Takazudo/zudo-led-block/README.md

# Zudo LED Block

A narrow Eurorack art light that sits beside Kumiko blank panels: a clear cast-PMMA front with engraved, light-carrying letters and replaceable translucent PETG sides lit by eight individually addressable RGB LEDs. This repository holds the **Light Block A5** engineering checkpoint and its documentation site.

Documentation (Japanese): https://zudo-led-block.zudolab.dev/ — **not live yet**; production hosting is configured but disabled until activated (see [hosting](doc/src/content/docs/project/hosting.mdx)).

> [!IMPORTANT]
> **A5 is not released for manufacture.** The controller PCB is placed but **unrouted** (130 unconnected items, courtyard overlaps J3-H1 and J3-C7). Harness routing and installed fit are unresolved, and no physical electrical, optical, thermal, print or load qualification has happened. Passing CI is not an electronics or manufacturing approval.

**Status:** A5 design and BOM imported; all 30 fitted identities are migrated into the component-evidence catalog (`/docs/components/`), with explicit open gaps. The complete 30-type / 81-piece BOM is published on the site's [BOM page](doc/src/content/docs/architecture/bom.mdx) (generated from the A5 ledger and native netlists) and links each row to its catalog record. The reconciliation (30 identities / 71 placements / 81 pieces) is `provenance/a5-catalog/reconciliation.json`, built and checked by `scripts/a5_catalog.py`.

## Repository map

| Path | What it is |
| --- | --- |
| `engineering/a5/` | **Immutable** byte-for-byte import of the A5 checkpoint (786 files): native KiCad 10 projects, firmware + pinned STM32CubeG0 SDK and licenses, CadQuery generators, STEP/STL/3MF, front artwork, procurement ledger and evidence, historical verification records. Start with `engineering/a5/README_JA.md`, `continue-here.md`, `REPRODUCE.md`. |
| `provenance/` | Seed manifest (size + SHA-256 per file), original-archive recovery receipt, handoff evidence, and the five deliberately omitted paths ([provenance/README.md](provenance/README.md)). |
| `scripts/` | New tooling outside the checkpoint: seed verifier, A5 record checks, deterministic site-data generator, public-asset selection, browser checks, Cloudflare output check. |
| `doc/` | Documentation site (zudo-circuit-doc 0.3.0 on zudo-doc 9.1.3 / ZFB 5.2.2), Japanese-first. `doc/cloudflare.config.ts` + `doc/wrangler.config.ts` describe the (disabled) Workers Static Assets deployment. |
| `circuit/`, `circuit.config.ts`, `.claude/skills/` | zudo-circuit-doc project files; `circuit/WORKFLOW.md` is the canonical framework workflow. |
| `.github/workflows/` | Credential-free CI and the default-off production deploy gate. |

Agent instructions: [AGENTS.md](AGENTS.md) / [CLAUDE.md](CLAUDE.md).

## Setup and commands

Requirements: Node.js 24, pnpm 11.5.2 (`corepack enable`), Python ≥ 3.11 (standard library for the checks), GNU Make and a C11 compiler for firmware host tests, `arm-none-eabi-gcc` 13.2.1 for the ARM build.

```sh
pnpm install --frozen-lockfile

# A5 checkpoint integrity and data checks (no network, writes nothing in engineering/a5/)
pnpm a5:check                       # seed identity + record checks + generated-page drift
python3 engineering/a5/build_procurement_rows.py --check

# Firmware
make -C engineering/a5/firmware test test-sanitize timing
make -C engineering/a5/firmware arm  # needs arm-none-eabi-gcc on PATH

# Documentation
pnpm circuit:doctor
pnpm dev                            # local preview
pnpm build && pnpm check && pnpm check:site
pnpm test:browser                   # Playwright, desktop + mobile

# Cloudflare packaging (credential-free)
pnpm cf:build && pnpm cf:check-output && pnpm cf:dry-run
```

After an intentional change to the A5 inputs that feed the site (only by a new checkpoint import), run `pnpm a5:generate` and commit the regenerated pages.

## Reproduction paths beyond CI

| Area | Tooling | Notes |
| --- | --- | --- |
| Native electronics | KiCad 10.0.8 (`kicad-cli`, pcbnew Python) | CI runs the digest-pinned native gate, fresh schematic checks, the actual A7 controller candidate, negative controls and router reproduction. Imported A5 records remain historical. The framework's KiCad 9.0.9 preview renderer does not replace these native checks. |
| CAD | CadQuery 2.7.0, Python ≥ 3.11 (`engineering/a5/requirements.txt`) | `mechanical/build_mechanical.py --variant all` regenerates the four omitted tessellation JSONs before `render_previews.py`. |
| Workbook | `@oai/artifact-tool` + specialized runtime variables | Preserved as source; not a CI dependency. The PDF/XLSX in `engineering/a5/deliverables/` were **not** regenerated by this repository. |
| Full archive rebuild | `engineering/a5/build_package.py` | Requires restoring the five omitted files first. |

## License notes

Third-party material inside `engineering/a5/` keeps its own notices: STM32CubeG0 components (`engineering/a5/firmware/vendor/`, `firmware/dist/licenses/`), GCC runtime exception provenance, and upstream footprint licenses (`engineering/a5/electronics/footprints/upstream/LICENSE.md`).
