Takazudo/zudo-led-block/engineering/a7/README.md

# engineering/a7 — A7 structural redesign (study in progress)

A7 is the structural redesign tracked in [#15](https://github.com/Takazudo/zudo-led-block/issues/15):
right-angle threaded CV jacks with a controller PCB perpendicular to the front, a PCB-side ON / PGM / CV
setting switch instead of the front toggle, and a feasibility study of transparent PET FPC for the LED leaves.

**Status: design study. Not released for manufacture.** Nothing here is part approval, fit approval or an
electrical result. `engineering/a5/` stays the immutable A5 checkpoint; A7 never edits it.

Start with [`docs/continuation/continue-here.md`](docs/continuation/continue-here.md) for the current state,
next actions and blockers, and [`docs/continuation/evidence-index.md`](docs/continuation/evidence-index.md) for every evidence set.

## Ownership

| Path | Owner | Notes |
|---|---|---|
| `evidence/sources.json` | R1 ([#16](https://github.com/Takazudo/zudo-led-block/issues/16)) | every source R1 inspected, with hashes (bundle, study and candidate sources) |
| `.claude/skills/component-a7-pj-324m/`, `component-a7-hx-msk13c02/` (current SW1, #77), `component-a7-pcm13smtr/` (superseded SW1, history) | R1, #77 | owner bundles, registered as `line-a7-*` in the shared catalog outside the A5 reconciliation |
| `study/` | R1 | `parameters.json` (hand-authored inputs); `results.json` and `report.md` are generated by `scripts/a7_dimension_study.py` |
| `pet-fpc.md`, `open-questions.md` | R1 | capability capture and the external evidence still needed |
| `verification/` | R3 ([#18](https://github.com/Takazudo/zudo-led-block/issues/18)) | native verification foundation; R1 does not write there |
| `mechanical/`, `front_panel/` | R2 ([#17](https://github.com/Takazudo/zudo-led-block/issues/17)) | digital mechanical model and front artwork; see `mechanical/README.md` |
| `electronics/`, `verification/schematic/` | R4 ([#19](https://github.com/Takazudo/zudo-led-block/issues/19)) | authoritative routed controller PCB; derived schematic/footprints/exports and verification records; see `verification/source_authority.json` |
| `docs/continuation/` | R5 ([#20](https://github.com/Takazudo/zudo-led-block/issues/20)) | `continue-here.md` (hand-off, next actions, blockers) and `evidence-index.md` (A5 historical / A6 held / A7 digital / physical, kept apart) |

The three A7 lines (PCM13SMTR superseded) sit in the shared catalog beside the 30 A5 identities. `python3 scripts/a5_catalog.py check`
accepts them as later-revision lines and keeps them out of the A5 counts; `pnpm circuit:check` validates
their bundles against the evidence contract.

## Commands

```sh
python3 scripts/a7_dimension_study.py          # regenerate study/results.json and study/report.md
python3 scripts/a7_dimension_study.py --check  # fail if the committed outputs are stale
python3 scripts/a5_catalog.py check            # catalog consistency, including the A7 lines
pnpm circuit:check                             # evidence contract for every bundle
python3 -m unittest scripts/tests/test_a7_r1_study.py
```

## 2026-11-09 の準備作業（未リリース）

E1 は基板→canonical placement→機構コピーの結合を強化。E2 は PCM/ST/TDK/Molex の一次資料を回収し、PJ-324M supplier symbol の端子4/5の不一致を記録しました。回路・銅箔は変更していません。`procurement/` は現行実装台帳、`qualification/` は未実施の評価手順と BLOCKED readiness、`fixture/` は当時は未完成のキャリア検討でした（2026-11-13 現在は 4 枚プレートの設計がデジタル基準 1–4 を満たし、金物はオーナー承認済み、加工業者は未選定、物理の基準 5 は未実施）。発注適格性は未成立です。現在の発注前の段階は `docs/continuation/continue-here.md` の冒頭、部品ごとの日付付きの観測は `procurement/sourcing-projection.json`、日付付きの注文ファイルは `jlc-package/order/2026-11-13/` にあります。詳細は `docs/continuation/order-preparation-checkpoint.md`。

## R1 findings (historical, 2026-11-08)

### Parts

- **All manufacturer documents for both parts are LCSC-hosted mirrors.** The SOFNG drawing and the C&K datasheet
  were obtained only from datasheet.lcsc.com, so they are classed MANUFACTURER_MIRROR. The maker-hosted copies
  were SOURCE UNAVAILABLE on 2026-11-08 (sofng.com: paged lists reset, later HTTP 502; C&K's PDF link redirects
  to Littelfuse, which answered HTTP 403). Every value read from them is kept as UNVERIFIED / UNSOURCED with the
  value retained, and the study labels those inputs MIRROR. Nothing below is primary-source confirmed.
- **Jack: SOFNG PJ-324M, JLCPCB/LCSC C22355739** (`.claude/skills/component-a7-pj-324m/`). The SOFNG drawing (mirror) prints
  M6x0.5, body height 6.0 (headline 6.3), width 11.5 with the axis 5.4 from one edge (so 6.1 from the other, calculated),
  body 14.2 behind a 3.5 barrel, 3.2 untrimmed terminals from the seating plane, and the terminal positions.
  It does **not** dimension the axis height (carried as INFERRED ≈3.0, band 2.6–3.4), give hole sizes, label
  pin functions, or fill in the operating temperature. JLC lists it as a wave-soldered plug-in part; stock 6209
  on 2026-11-08.
- **Pin functions are inferred, not sourced.** Pin 1 = sleeve, 2 = ring, 4 = tip, 3/5 = normals is the
  proposal (symbol convention plus terminal depth). A tip/ring swap would put CV_THRU on the contact that
  touches a TS plug's sleeve, so an incoming-part continuity test with TS and TRS plugs is required.
- **Nut:** no nut is shown or listed with C22355739. Same Sky `3.5mm-nut-e` (Ø8.0 × 1.5) and `MJ-3502-nut`
  (Ø8.0 × 1.8) are M6x0.5 dimension references only. Their fit on the SOFNG barrel is unverified.
- **Side switch: C&K PCM13SMTR, LCSC C221842** (`.claude/skills/component-a7-pcm13smtr/`). The manufacturer table (mirror)
  gives POS.1 = 1-3, POS.2 = 2-3, POS.3 = 3-4 with terminal 3 common. With 3 = GND, 1 = MODE_A, 4 = MODE_B and
  2 open, the positions give ON (0,1), PROGRAM (1,1, physical centre) and CV (1,0), as the A5 firmware expects.
  It is side-actuated (actuator projects 1.5 mm past the body edge, 1.5 mm travel), 1.4 mm high, two Ø0.8 pegs.
  **Sourcing is open:** JLC stock was 0 on 2026-11-08 (checked twice). An alternate search found in-stock
  side-actuated SP3T parts: Alps Alpine SSSS812201 (C160878, stock 1308; same 9.7 × 2.6 × 1.4 envelope; the
  catalogue is manufacturer-hosted), SHOU HAN MSK13C02 (C2681567, stock 28994), Hroparts K3-1310S-E1 (C145851)
  and Nidec CSS-1310TB (C2921714). None prints a per-position terminal table; each shows a one-state slider
  sketch. Under the "printed contact table" rule none is selected, and PCM13SMTR stays the documented choice
  with its zero-stock risk. SSSS812201 is the strongest fallback if that rule is relaxed or a bench continuity
  check is accepted (Q10).
- **Side switch, fitted from 2026-11-12: hanxia HX MSK13C02, LCSC C5149819**
  (`.claude/skills/component-a7-hx-msk13c02/`). The owner directed a switch that works, low price and in stock
  ("this is backside switch, so nothing special is required for this. good if it works.";
  `engineering/a7/procurement/owner-decisions.json`, switch-supply). JLC stock 4561 (Extended) on 2026-11-12.
  The Hanxia drawing served by JLC (mirror, Part No. blank) prints the contact schematic A = 1-3, B = 2-3,
  C = 3-4 with terminal 3 common, so the PCM13SMTR net mapping and mode codes are unchanged. It sits on the
  routed PCM13SMTR land; `scripts/a7_switch_fit.py` compares that land with the Hanxia recommended land on
  nominal values (`engineering/a7/electronics/switch-land-fit.json`). Lower ratings: DC 12 V 0.1 A,
  -25..+70 C (the lowest limit among the parts with a temperature fact), 10,000 cycles. The 2.7 mm body is 0.1 mm deeper, so the
  actuator tip ends 0.05 mm past the board edge (accepted in `mechanical/design-inputs.json`). The contact
  table and land fit stay physical checks (switch-fit).
- **MJ-3502 stays rejected** for 2HP: Same Sky's drawing gives body height 11.30 ± 0.2 and axis 6.90 ± 0.15.

### Dimensions (`study/report.md`)

- **3HP (14.9 mm) is feasible on paper across the width**, checked on its own: every transverse (X) margin stays
  positive at the worst corner with a standard 1.6 mm board and even untrimmed terminals. Thread engagement is a
  separate axial check that does not depend on width; it applies to 3HP exactly as to 2HP (below).
- **2HP (9.8 mm) is unresolved, not infeasible.** At nominal inputs, a jack offset 0.3–0.6 mm toward the body
  side with a ≤ 1.0 mm FR-4 controller and trimmed terminals clears everything. At the worst corner the
  terminal side goes negative. The drivers are the INFERRED axis height, the ASSUMED trim length (Q6) and the
  hole position/float (Q7). Even if the axis height were confirmed at 3.0 ± 0.1, the other assumed tolerances
  keep 2HP unresolved. With trimmed terminals no 2HP row fails at the best corner, so none is infeasible within
  the stated ranges; with untrimmed terminals every 2HP row except the 0.9 mm offset fails even at the best
  corner. A 0.9 mm offset puts the Ø8 nut on the panel edge at nominal.
- **Thread engagement:** a plain mount leaves 1.5 mm nominal and 1.1 mm worst-case exposed thread. That is
  0.85 mm engaged after the lead-in, below the 1.0 mm study criterion, so it is unresolved. Keeping the A5
  0.6 mm collar leaves 0.9 mm nominal; drop it. A front washer makes it worse. A 0.5 mm concealed rear pocket
  in the PMMA at each jack gives ≥ 1.25 mm engaged at the worst corner, so it is the option R2 should evaluate.
  It depends on Q8 and Q9.
- **Depth:** the jack body ends at Z ≤ 14.4 (14.0 in a pocket at its shallowest). That is 3.0 mm in front of the A5 optical skin
  (Z 17.4) and 5.0 mm in front of the A5 leaves (Z 19.4). A frontward controller volume and a separate rear
  optical volume are geometrically compatible at the jack positions; R2 derives the real boundary.
- **Y layout at the A5 jack positions (90 / 104), worst case** (body-edge tolerances, including the 6.1 mm far
  edge, which is calculated rather than printed, plus hole position and float): 1.5 mm between bodies, 5.5 mm
  between nuts, lower body edge at Y 110.7 against the 111.4 rail-body limit (0.7 mm margin).

### Transparent LED board

See `pet-fpc.md`. JLC's PET FPC (0.14 / 0.24 mm, up to 85%, "up to 200 °C", SMT) is captured with hashes.
The open process questions are written there. Rigid-flex is not offered, so the controller-to-film joint is a
connector. The FR-4 leaf stays the reference and fallback.

### Open items

`open-questions.md` lists every missing input (Q0–Q12) and what it decides.
