Takazudo/zudo-led-block/engineering/a7/mechanical/README.md

# engineering/a7/mechanical — A7 R2 digital mechanical model

**Status: provisional digital study.** Nothing here is a measured fit, a part approval or a manufacturing
release. The PJ-324M jack-axis height is INFERRED (≈3.0, band 2.6–3.4); tolerances marked ASSUMED are
unsourced. Tracked in [#17](https://github.com/Takazudo/zudo-led-block/issues/17) (epic #15).

## Files

| File | What it is |
|---|---|
| `design-inputs.json` | R2's own choices (each with a confidence label). Jack, nut, panel, PCB and tolerance inputs come only from `../study/parameters.json` (R1); switch and jack facts from the R1 owner bundles `.claude/skills/component-a7-{pcm13smtr,pj-324m}/facts.json`. |
| `layout.json`, `layout.md` | Generated by `scripts/a7_mechanical_layout.py` (pure Python): width decision, candidate sweep and selection, break-even values, Z/Y stack, per-width X placement, controller outline and keep-outs, load path, cable routes, unresolved inputs. |
| `placement-envelopes.json` | Generated with the layout for R4 routing (#19): controller outline, keep-outs, jack bodies and pin positions, switch body/actuator/pegs and header housings, each in the assembly frame and in a KiCad board frame seen from the component face. No hole or pad sizes. |
| `inputs/r4-board-placement-routed.json`, `r4-placement-check.json` | R4's **routed-board revision 2** export (PR #37 head eb5d833, merged at edf98c2, `authority.py export-placement`, board SHA-256 4453f818…, copied unchanged and byte-identical to main's export. Revision 1 was PR #30, merged at eb8adeb with board ec810aec and checked in #33) and the generated comparison with the envelopes: outline, fixed parts (J1/J2 axis and all five pin pads, J3, J5, SW1) by position, every other part's origin and pad centres against foreign keep-outs, solder-face parts. Courtyards, pad extents, heights and copper are R4's DRC, not checked here. The export is a 1.6 mm board, i.e. the 3HP working candidate; 2HP would need the 0.8 mm board. |
| `build_a7_mechanical.py` | CadQuery 2.7.0 assembly from `layout.json`. |
| `exports/<width>/zudo_led_block_A7_<width>_assembled.step` / `.glb` | Inspectable assembly (STEP for CAD, GLB for a browser viewer). |
| `exports/<width>/view_A7_<width>_{front,transverse,side}.png` | Dimensioned views generated from the solids. |
| `exports/<width>/verification.json` | Pairwise rigid intersections (expected contacts carry a volume limit), cable centreline clearances, envelope checks, optical-obstruction check by origin (A5 / A7), switch tool access, STEP round trip, and the hashes of its inputs. |

## Commands

```sh
python3 scripts/a7_mechanical_layout.py            # regenerate layout.json / layout.md / placement-envelopes.json
python3 scripts/a7_mechanical_layout.py --check    # fail if stale
python3 engineering/a7/front_panel/build_a7_front.py       # artwork (needs CadQuery 2.7.0, ezdxf, matplotlib)
python3 engineering/a7/mechanical/build_a7_mechanical.py   # assembly, views, verification (same)
python3 -m unittest scripts/tests/test_a7_r2_mechanical.py # geometry tests; fails if the CAD export is stale (CI job "A7 mechanical")
```

Run the front build before the mechanical build (the assembly imports the panel). Both read
`engineering/a5` only through imports and JSON reads; they never write there.

## Result: 3HP is the working candidate, 2HP stays open

- **3HP working candidate (default):** centred, 1.6 mm FR-4, untrimmed leads. **FEASIBLE ON PAPER** at the
  worst corner. The front artwork, supports, CAD build and placement envelopes all treat it as the default
  variant; every output is still generated for both widths.
- **Why (project decision, 2026-11-08):** the 2HP worst corner is −0.33 / −0.15 mm, the jack-axis height is
  INFERRED and the lead trim is unconfirmed. 2HP reopens when manufacturer axis-height evidence or confirmed
  trim data makes its worst-case margins positive (see the break-even values below and `layout.md`).
- **2HP open candidate:** jack offset 0.6 mm toward the body side, 0.8 mm FR-4, trimmed leads. Chosen by a
  stated rule over R1's own margin calculation swept at 0.05 mm steps. Every nominal margin is positive
  (lead side +0.70, body side +0.70, nut edge +0.30). At the worst corner it is **UNRESOLVED**, not infeasible:
  lead side −0.33, body side −0.15. No 2HP offset/thickness passes the worst corner.
- **What closes 2HP** (one input at a time, `layout.md`): axis height ≤ 3.07 on the lead side and ≥ 2.75 on the
  body side (R1 Q1), or guaranteed trimmed protrusion ≤ 0.67 (Q6) together with an overall-height tolerance
  ≤ 0.05. The hole position tolerance alone cannot close either margin.
- **The controller outline is common to both widths** (Y 48.5–111.4 × Z 0.2–16.4, 1019 mm² against the
  A5 board's 554 mm²). Only its X position and thickness change, so R4 can start before the width is frozen.

## Architecture

- **Frontward controller volume / rear optical volume.** The A5 optical stack is kept: cap 1.4 + leaf 9.0 +
  skin-to-leaf 2.0 = 12.4 mm, so the optical volume is Z 17.4–29.8 within the 30 mm target. The controller ends
  at Z 16.4, 1.0 mm in front of it. The jacks need Z ≥ 14.0, leaving 2.4 mm slack. No A7 controller or support
  part (including the bottom-cap fork and the M2 hardware) enters either leaf emission corridor. The A7 LED
  harness does, but only at the leaf SH4 plug mouth: it steps down there (R 2.5) into the gap behind the
  adapter and is 2.8 mm from LED D2. A ray-sampled estimate (`optical_shading_estimate` in
  `verification.json`) puts the share of D2's rays meeting the harness at about 2 % (3HP 0.019, 2HP 0.016).
  It is an estimate (no reflection, diffuser scattering or LED angular data), not an optical result. The other corridor items are
  A5 carry-overs (leaf connectors and capacitors, caps, hardware, the leaf link).
- **Jacks:** SOFNG PJ-324M, IN at Y 84.3 and THRU at Y 99.3, 15.0 mm pitch. Every Y clearance uses the body
  tolerance envelope about the axis (near 5.4 ± 0.2 MIRROR, far 6.1 ± 0.4 DERIVED-MIRROR). The A5 pitch was
  14.0; it grows so each label sits between the jack envelopes, because a label printed in front of an opaque
  body or a pocket would not light up. Pin 2 and the 6.1 mm edge face the switch (the 5.4 mm edge is the pin-4/5 side,
  per the #24 review reading); the drawing view's sign is still to be re-checked (R1 fact note), and the pin
  functions are INFERRED (Q2). Both jacks seat in 0.5 mm rear pockets, the only R1 option meeting the 1.0 mm
  thread-engagement criterion (1.25 worst case). The rectangular pocket also keys the body against nut
  torque. The pockets are sized across X for the whole INFERRED axis band and the overall-height tolerance
  (2HP X 1.9–9.6, a 0.2 mm wall to the panel edge). Same Sky 3.5mm-nut-e is the dimension reference, and its
  fit is UNVERIFIED.
- **Load path:** insertion goes through the nut to the PMMA front, withdrawal through the body to the pocket
  floor, and torque into the pocket walls. The controller hangs on the two clamped jacks and a printed spine
  slot (Y 50–72). The solder joints carry no primary load.
- **Setting switch:** hanxia HX MSK13C02 (C5149819; replaced C&K PCM13SMTR on 2026-11-12 by owner direction) at
  the bottom PCB edge, on the routed PCM13SMTR pegs. Its 2.7 mm body is 0.1 mm deeper than the 2.6 mm PCM13SMTR,
  so with the pegs fixed the actuator reaches Y 111.45, 0.05 mm past the board edge (recorded and accepted in
  `design-inputs.json`), and the body clears the lower jack by 1.45 mm worst case. The actuator slides along Z.
  The figures in the next lines are from the PCM13SMTR model and are kept for history:
  It is reached from below with the module out of the rack. The tool corridor (actuator root to the board
  edge and below) is clear of every modelled part in both widths; rails, case and neighbours are not modelled.
  The switch body clears the lower jack envelope by 1.5 mm worst case (1.9 nominal); with the corrected R4
  footprint (signal pads 2.5 from the peg line, retention pads Z 1.35–12.65) the pads clear it by 0.3.
- **Solder-face low-profile zone:** parts up to 0.6 mm (0603 resistors, R4) may sit on the −X face outside the
  spine-slot (Y 48.5–72, the full slot engagement), optical-fork, jack-lead and PicoBlade-tail keep-outs. At that height they never reach past the
  trimmed jack lead tips, so the binding 2HP lead-side margin is unchanged; the zone itself clears the side
  plane by +0.07 (2HP) and +1.14 (3HP) at the worst corner. The CAD build carries it as an envelope solid.
  ON / PGM / CV goes on the controller silkscreen (R4).
- **Power:** the A5 separate power adapter (keyed IDC10) is kept unchanged. A vertical IDC10 header needs 8.9 mm
  of X, but the 2HP component face offers 7.0 mm. A PicoBlade harness runs to a header on the controller
  component face. **The adapter sits 2.0 mm further forward than in A5** (front Z 15.4, rear 17.0), which
  opens a 2.4 mm gap to the leaf front edge for the SH4 harness (R2-C6). A printed 2.0 mm boss (R 2.75) on the top cap
  fills the gap at the Y 20.5 screw, and the post nut sits 2.0 mm lower, so the top-cap screw grows from the A5 M2x16
  to M2x18 to keep the A5 2.2 mm of thread past the nut. Clamp load and boss strength are not analysed. The whole
  adapter group (PCB, C5665 header, reference socket, ribbon scenario, nut, screw) counts as A7 in the checks, with
  the A5 reference-envelope overlaps bounded explicitly. The 30 mm datum is unchanged (the adapter stays in front of the leaf). The A5 IDC ribbon side-exit scenario still extends past the 2HP outline (carried over).
- **Harness routes (bundle model):** the controller-to-leaf SH4 route uses exactly the 50 mm finished length
  with R ≥ 2.5. It runs in the adapter/leaf gap, folds once at Y ≈ 75 and returns to J3, now at Z 12.8 (R4). The
  controller PicoBlade (J5) sits at Z centre 8.69 (R4's routed position) so the fold clears its housing.
  The stowage takes 38–120 mm. **A7 power cable (R2-C5, for #8):** the S-fold stowage takes 51.0–78.1 mm
  across both widths. The digital requirement is a 57 ± 3 mm free span (the ±3 is ASSUMED), so 54–60 mm,
  with 2 mm kept off the shortest fold. These figures are copied from `layout.json` →
  `power_cable_requirement` (a test fails if they drift); the value moves with the J5 position. The A5 50 ± 6 cable does not fit. The cable has not been routed or
  measured. In 2HP the last bend is 0.9 mm
  (below the preferred 2.0), the PicoBlade wires have only 0.9 mm of bend room above the mated plug, and the
  2.3 mm tails must be cut like the jack leads (R2-C1).

## LED leaf: FR-4 stays the default; clear PET is feasible only on a clear carrier

`layout.md` → *LED leaf* and `layout.json` → `leaf_comparison` compare the A5 FR-4 leaf with a clear PET FPC
leaf. `exports/3hp_pet/` is the 3HP assembly built with the PET leaf (`--leaf pet`). FR-4 is not replaced.

- **Stack:** the JLC 1-layer transparent FPC is 0.14 mm (MANUFACTURER_PRIMARY, R1 `pet-fpc.md`). Two films sit on an
  optically clear adhesive (0.1 mm, INFERRED) either side of a clear 0.8 mm PC carrier (INFERRED). The total is
  1.28 mm against FR-4's 1.30, so the stack fits the A5 cap slots. LEDs, connectors, the emission corridors and the
  harness start move only 0.01 mm.
- **Stiffness:** the PET stack is 8–37× less stiff than FR-4. The range runs from fully bonded films to films
  carried by the carrier alone, with typical moduli (INFERRED). Its worst-case buckling load under the SH
  mating push is about 8 N, against about 300 N for FR-4. The film alone buckles at about 0.07 N, so it cannot
  stand without the carrier. The SH mating force itself is UNSOURCED.
- **Re-checks (3HP):** no unexpected intersections, no A7 part in either corridor, and the harness stays 2.8 mm
  from D2. The ray-sampled D2 estimate is 2.0 % (FR-4 1.9 %), and the STEP round trip is clean. The leaf Z range is
  unchanged, so the 0.5 mm jack pockets and the 30 mm depth budget are unaffected. The estimate does not model
  light passing through a clear leaf.
- **Recommendation:** keep FR-4 as the default and fallback. Pursue PET only after three things:
  - JLC answers on reflow/paste, PET-compatible stiffeners and OCA clarity (Q11);
  - a physical SH mating-force and lit-appearance test (#10);
  - R4's electrical PET leaf profile.
- **Open items from the evidence review:**
  - *Unmating pull:* buckling covers only the mating push. Pulling the SH plug loads the pad-to-film bond and the
    film-to-OCA peel, which the carrier does not help. That force is UNSOURCED and joins the physical test in #10.
  - *Carrier lamination:* no supplier or process is identified for laminating the PC carrier with OCA after reflow,
    as factory assembly needs. It is listed beside Q11.
  - *2HP:* the PET variant is built only for 3HP. The X stack differs from FR-4 by 0.02 mm (faces move 0.01 mm),
    the same margin the 3HP checks cleared, so the 2HP picture carries over; 2HP stays parked.

## Not modelled / still physical

PET reflow, adhesive and lit appearance (comparison above), actual cable insulation, bend ratings and labels, nut
torque and PMMA clamp load, pocket appearance and strength, switch actuation force, printed-part shrinkage. See
`layout.md` → *Unresolved inputs* and `../open-questions.md`.
