Takazudo/zudo-led-block/engineering/a7/fixture/README.md

# A7 SWD 治具 — デジタル設計（基準 1–4 をデジタルで充足・加工業者は未選定・未試作）

**BLOCKED / 加工・購入・使用の承認ではありません。** 4 枚の FR-4 プレート、金物の要求仕様、基板・プローブを含む組立 STEP と干渉検査までをデジタルで設計した段階です。STEP と干渉検査が通っても、実物の嵌合・接触・荷重・位置決めを検証したことにはなりません。

**現在の状態（2026-11-13）:** デジタル基準 1–4 と native の新規検証は充足（`digital_criteria_1_to_4_met`・`fresh_native_verified` が true）。提案した金物は 2026-11-12 にオーナーが推奨一式として承認しました（`engineering/a7/procurement/owner-decisions.json` の `accept-all-recommendations`、`assembly:fixture-materials` = approve）。残るオーナーの作業は 4 枚の FR-4 プレートの加工業者の選定で、物理の基準 5（接触・荷重）は治具と基板ができてからです。`manifest.json` の各行に残る `PROPOSED_AWAITING_OWNER_APPROVAL` はオーナー承認より前に生成した値です。このマニフェストは試作ルート承認の識別に含まれるので、文言のためだけには再生成していません。

- `sources.json`: INGUN 一次資料の実取得バイトの SHA-256、11/26_GB、ページ位置。原本は記載のローカルキャッシュ。再取得時はハッシュを比較する。
- `materials.json`: 治具1台分のプレートと金物の要求仕様。モジュール1台分の BOM と別。未選定材料・価格を埋めない。
- `candidate-references.json`: 加工業者の公開指針（JLCCNC、**未選定の参考**）。製造性の物差しとしてのみ使う。
- `manifest.json`: 現行 revision 2 の PCB/placement/geometry identity、全プレートの設計値、計算、完成基準と未解決事項。
- `fixture-assembly.step`: 治具全体（4 プレート、金物の外形、5 組のレセプタクルとプローブ、基板と部品箱）の組立 STEP。
- `assembly-interference.json`: 組立 STEP の干渉検査記録。`manifest.json` が設計ハッシュと STEP のバイトで束縛する。
- `fixture-drawing.svg`: プレートの平面図（寸法要約付き）。加工図面ではない。

## 再生成と検査

```sh
/path/to/cadquery-2.7.0/python scripts/a7_fixture.py --cad
python3 scripts/a7_fixture.py --check
/path/to/cadquery-2.7.0/python scripts/a7_fixture.py --check --cad-check
python3 -m unittest scripts/tests/test_a7_fixture.py scripts/tests/test_a7_fixture_relief.py
```

`--cad` は CadQuery **2.7.0** で全部品を作り、組立 STEP を書き出し、全ソリッド対の共通体積（しきい値 0.001 mm³）、重要な隙間（BRep の厳密距離）、設計上の接触（基板とキャリア、ナイロン接点、プローブ先端、基準ピン）を `assembly-interference.json` に記録する。ねじは呼び径、圧入は線対線でモデル化するため、設計上の接合は接触するが重ならない。`--cad-check` は再構築したモデルと STEP のソリッド数・総体積を照合する。CI は CadQuery なしで `--check` を実行し、記録の入力ハッシュ（設計値、組立モデルのコード、native 記録、CadQuery 版）と STEP バイトが現在のものに一致するかを検査する。どれかが変わると記録が古くなり、基準 4 は未達に戻る。PCB または canonical placement が変わると明示的 identity lock により失敗する。

## Native CI の証拠範囲

2026-11-09 に E1 の pinned native CI [run 42594178172](https://github.com/Takazudo/zudo-led-block/actions/runs/42594178172) が head `4894a6f6f21b30419d039bd6427e89553f8dee55`、同一PCB SHA-256 `4453f818ede1e6d6c56e45ef43aa6faecb90990f3755f82c6d752258cd4d628e` で PASS と確認された。この結果はその E1 head の証拠であり、未コミットの統合変更や治具形状を検証したものではない。artifact download は escalation 後も Forbidden で、raw native facts は未取得。治具が新しい外形データを消費・検査していないため、`fresh_native_verified` は **false** のままとする。

2026-11-11 更新: PR #44 の準備 head `f0b1d8aa37f3967ccc8c9a6bd6ca0e7b7fc7b3a0`（base `af523f9`）の CI [run 42596523199](https://github.com/Takazudo/zudo-led-block/actions/runs/42596523199) も同一PCBで native gate PASS。同 run の `native-infrastructure-evidence` artifact（ID 13663737750、ZIP SHA-256 `33f3d9121164f364b0325540b161e9546ddf73c8b723c9166fdcd8a19867cf0e`）は今回ダウンロードできたが、A7 候補については `a7-gate/summary.json` しか保存されておらず、`board_facts.json` / `board_geometry.json` は含まれない。上の 2026-11-09 の Forbidden は当時の観測として残す。現在の不足はアクセス拒否ではなく artifact の保存範囲であり、`fresh_native_verified` は引き続き **false**。

2026-11-11 追記（PR #46）: native gate が同一PCBから治具用の `fixture_geometry.json`（pad の形状・寸法・銅箔 bbox・回転・有効層・net、footprint の原点・面・courtyard/外形 bbox）を出力し、CI artifact に保存するようになった。[run 43077448786](https://github.com/Takazudo/zudo-led-block/actions/runs/43077448786)（head `01bc3812202c6e72f772d2568148ae5df4915be7`、artifact ZIP SHA-256 `db6d6fe101641a4176d0fad83a7fd453ee4ae09173e7fb36d26dd444284b74c4`）の artifact は VALID_PASS と分類され、`scripts/a7_fixture_geometry.py --from-zip` が `native-geometry.json` に記録した（64 footprints、変換・面・net・位置を canonical placement と照合、未知 extents 0）。`manifest.json` の `native_geometry` はこの記録で TP1–TP5 の5パッド（B面、丸 1 mm、B.Cu/B.Mask、位置、net）を照合した結果である。部品本体高さ・はんだ包絡は native facts に含まれず、キャリア検討は courtyard/外形 bbox をまだ支持・逃げ設計に使っていないため、`fresh_native_verified` と `digital_fixture_complete` は **false** のまま。記録は `python3 scripts/a7_fixture_geometry.py --check`（CI でも実行）で PCB/placement の陳腐化、pad 数、内部不整合を検査する。member hash まで再計算した改変の出所は `--check` では判定できず、`--from-zip` による作成時の検証と差分レビューで担保する。

## 治具のデジタル設計（2026-11-11、W8 で構成変更）

W5 のキャリアは 0.27 mm の壁と幅 0.025–0.25 mm のブリッジを持ち、一般の加工業者では作れなかった。W8 では基板・プローブを変えずに治具の構成を変えた。`scripts/a7_fixture_relief.py` が設計値を、`scripts/a7_fixture_assembly.py` が組立モデルと干渉検査を作る。

- **製造性の物差し**: `candidate-references.json` の JLCCNC 公開指針（未選定）。樹脂の絶対最小壁 1.0 mm、内角 R = H/10 + 0.5 mm、工具径 H/5。全プレートの削り壁・穴まわりの肉・内角をこれで判定する（`candidate_reference_checks`）。
- **構成（下から）**: ベース板 3 mm → M3 雌雌六角スタンドオフ 35 mm → プローブ板 6 mm → M3 雌雌スペーサ 6 mm → 支持キャリア 5 mm → 基板 → 押さえ板 6 mm（剛体、ハードストップ上にねじ止め）。プレートはすべて FR-4、36.6 × 54 mm（押さえ板は 37.2 × 16 mm）。プローブ板と支持キャリアは Ø2 ダウエル 2 本で位置合わせし、M3 ねじは締結のみ。キャリア上面とベース下面の M3 は皿ねじで面一（J1/J2 のジャック本体が基板端から張り出すため）。
- **プローブ板**: レセプタクルを INGUN 資料の穴径 Ø0.99（仕上げ 0.98–1.00）で無垢の FR-4 に保持し、部品逃げはない。穴は J5 リードの窓（R1.1）だけ。プローブ穴間の肉は基板テストパッドのピッチ 1.4 mm で決まり 0.40 mm（ドリル穴）。INGUN グリッド（0.27 mm）は満たすが、削り壁の指針 1.0 mm は満たさないため、加工業者に穴あけ可否の確認が必要（owner の選定事項）。
- **支持キャリア**: 基板 B 面を実体の上に載せ、基準ピン 3 本（X1・X2 が x = 16.2 辺、Y1 が y = 62.9 辺）で位置決めする。プローブ領域と B 面の全部品・全リードの上は個別ポケットではなく貫通窓（7 窓、72 個の矩形の和、うち 28 個は 1.0 mm 未満の壁を取り除くブリッジ、4 個は隣の丸め角に接する直角の角を埋める補助矩形）。露出した角はすべて R1.0。最小の壁と肉はちょうど 1.0 mm。独立検査として、テストが窓の周囲を 0.05 mm 格子で走査し、壁厚 1.0 mm 相当の円または正方形に入らない材料点がないことを確認する（ブリッジや角の補助矩形を外すと薄肉・薄片が検出されることも確認。開口の縁の格子点も検査するため 0.1 mm 程度の薄片も見える）。
- **押さえ（基準 3、2026-11-12 再設計）**: ばねの釣り合いに頼らない変位制御にした。厚さ 6 mm の剛体 FR-4 押さえ板を、キャリア上面の M3 雌雌六角スタンドオフ 6 mm 2 本（ハードストップ、G1 (−5.5, 23.3)、G2 (21.7, 23.3)）に M3 × 8 キャップボルトで 0.3 N·m（PROJECT-CHOICE）まで締める。ストップの y = 23.3 は F1/F2 の皿穴（y ≥ 23.2）を避ける位置。押さえ板に M4 のスプリングプランジャ 2 本（候補 KIPP K0318.04、POM 製スラストピン Ø1.5、ストローク 1.5 mm、L 15、カタログ値 F1 約 5 N・F2 約 16 N）をねじ込む。M4 のねじ穴まわりの肉はドリル径ではなくねじ外径 4.0 mm で 1.0 mm 以上とし、そのため 2 本の間隔を 5.2 mm とり、押さえ板を y 13.5 まで広げた。各プランジャの押し込み量はストップ高さ・基板厚・プランジャの設定で決まり、他方のプランジャの力に依存しない。押し込み量は公称 0.99 mm、積み上げ ±0.31 mm（基板厚 ±0.16 = 1.44–1.76 mm、ストップ長 ±0.05、設定 ±0.1）。最小側からは押さえ板のたわみ 0.009 mm と、プランジャの荷重で最も薄い基板が沈む量 0.046 mm も引き、範囲 0.625–1.30 mm（ストローク端から 0.2 mm 残す）。カタログ値に公差がないため力は直線補間に ±20 % の受入帯（PROJECT-CHOICE）をかけ、1 本 7.67–17.44 N、合計 15.33–34.88 N。必要力は最大ストローク時のプローブ力 5 × 1.27 = 6.35 N の 2 倍の 12.7 N で、すべての最悪値で満たす。受入では 1 本ごとに押し込み 0.625 mm と 1.30 mm の 2 点で力を測り（1 点ではばね定数が決まらない）、ピンの突出 1.5 mm も測る。ピン先端は押さえ板下面から 5.39 ± 0.1 mm にゲージで合わせる。プランジャにはねじ緩み止めがないため、使用ごとに設定を確認する。スリーブ端は F 面から最小 0.2 mm 上に残る。
- **接点と荷重経路**: 2 本の POM ピンが F 面の空き領域（プランジャ本体 Ø4 が F courtyard から 0.3 mm 以上離れる）を押す。基板座標 (14.1, 21.7)（窓の上）と (14.2, 16.5)（キャリア実体の上）。正味荷重（プランジャ合計 − プローブ合計）の作用点は、各プランジャが 7.67 N と 17.44 N のどちらでも、プローブ合計が 4.0 mm 受入ストロークでの最小 4.80 N でも最大 6.35 N でも、全 8 通りでキャリア実体の凸包の 1.22 mm 以上内側（要求 0.5 mm、`statics_cases`）。基板のたわみは、各荷重点を通る支持のない軸平行の弦（キャリア実体のない区間）を幅 5 mm の単純支持帯として、最小厚 1.44 mm（1.6 ± 10 %、PROJECT-CHOICE の発注要求で出典なし）と **ASSUMED** の曲げ弾性率 18 GPa（基板の積層材は未出典）で見積もる。弦が基板端で切れる場合は片持ちとして長さの 16^(1/3) 倍のスパンに換算する（現在の荷重点はすべて両端がキャリア実体）。窓の上のプランジャはスパン 11.24 mm、17.44 N を全く釣り合わない集中荷重として 0.023 mm、プローブの下はスパン最大 17.32 mm、6.35 N で 0.031 mm。上限 0.1 mm（PROJECT-CHOICE）以内。出典のある FR-4 系の値（Isola FR406 21.5 GPa、Vetronite EGS 619 23.0 GPa）は比較用で、基板の積層材を保証しない。B 面の支持は増やせない（窓は B 面部品の逃げの和）ため、スパンは実際の弦で評価した。基板の反り・曲がりは見積もりに含まない。プランジャは 2 本ともストップ線の片側にあるため、押さえ板を浮かせないにはストップ面の端まわりのモーメントから 2 本のねじに合計 88 N の張力が要る。0.3 N·m の締付け（ナット係数 0.2 は ASSUMED）で合計約 1000 N の予張力となり、2 倍の余裕を満たす（`stop_joint`）。押さえ板側のねじのかかりは 2 mm で、板が公称より厚いと短くなる（押し込み量は板の下面から決まるため変わらない）。
- **ストロークと停止**: 基板 B 面がキャリア実体に着座することが機械ストッパで、圧入深さの調整と独立。カタログの KS 組合せ取付高さ 16.0 mm（販売店掲載の INGUN カタログ、MANUFACTURER_MIRROR）から、圧入リングをプローブ板に 0.7 mm 押し込むと自由先端がキャリア上面から 4.3 mm に立つ。受入要求はボード無しで 4.3 ± 0.3 mm。プローブ板の厚さで取付高さ 15.3–21.3 mm まで対応できる。
- **絶縁・配線**: プレートはすべて FR-4、基板に触れる接点は POM のプランジャピン（鋼のスリーブは F 面から 0.2 mm 以上離れ、F courtyard から外れる）、基準ピンは基板端（銅箔から 0.3 mm 以上）にだけ触れる。基板下・横の金属金物とプローブ・レセプタクルの平面上の最小距離 4.22 mm（G2–TP4、設計値）。プランジャのスリーブは基板の反対側（F 面側）にあり、組立モデルでのプローブとの最小距離は 2.11 mm（基板を挟んで縦方向に最小 1.64 mm）。レセプタクル下端からベース板まで 7.6 mm（必要 5.5 mm = 線外径 0.55 mm の 10 倍）。5 本の配線は両端に TP1–TP5 のラベルを付け、ベース板のスロットに結束バンドで固定する。レセプタクルにははんだ付けしない。
- **組立 STEP と干渉検査（基準 4）**: 129 ソリッド（4 プレート、金物 45、レセプタクル・プローブ各 5、基板と F 面部品箱、B 面部品・リード）。スルーホールのリードは座面から下の出典長さ全体（J5 2.8 mm、J1/J2 3.4 mm）で置く。干渉 0、接触または体積 0 の対 156。プレート積層の M3 × 12 止めねじ（スタッド）はベーススタンドオフに 4 mm、スペーサーに 2 mm 入れ、上の M3 × 8 皿ねじの先端と 1 mm 空ける。キャップボルト頭は TR の最大 5.68 mm で置く。プランジャはピン（基板上面から）とスリーブ（L 15）を公称の押し込み量で置く。重要隙間: B 面部品とキャリア 0.31、J5 リード（2.8 mm 上限）とキャリア 0.43、プローブ・レセプタクルとキャリア 0.77、F 面部品と押さえ板 0.50（J5 の切欠きは加工 R1.1 の角でも 0.5 mm 残すよう広げた）、F 面部品とプランジャのピン・スリーブ 0.58、基板とストップ 2.29 mm。部品箱は courtyard × 記録高さの外形で、実形状の嵌合ではない。
- **逆挿し防止・位置決め**: W5 と同じ考え方。面内 180° 回転では B 面の 29 か所が窓ではなく実体の上に来て着座しない。半径予算 0.25 mm の配分（最悪余裕 0.03 mm）は受入測定要求で閉じる。基準ピンへの押し当ては手で行い、0.02 mm のすきまゲージが入らないことを受入確認とする。
- **J5 テール長（2026-11-12）**: `fact-530470310-tail-length`（Molex 530470000-SD rev B、SECTION X-X、ハウジング座面からテール先端まで 2.3 ± 0.5 mm、PRIMARY-SPEC）を使う。B 面からの突出は 1.6 mm 基板・ハウジング密着の計算で 0.7 mm（0.2–1.2 mm）。基板厚の公差は出典がないため、隙間検査は基板厚 0（どの基板厚でも、密着または浮きなら超えない）の上限 2.8 mm で行う。J5 リードは 5 mm キャリアの窓の中で終わり、キャリア下面まで 2.2 mm、プローブ板上面まで 8.2 mm（最悪値 1.2 mm ならそれぞれ 3.8・9.8 mm）。J1/J2（PJ-324M）も同じ扱いで 3.4 mm 上限、キャリア下面まで 1.6 mm（`lead_tails`）。
- **金物の提案（2026-11-12）**: `manifest.json` の `hardware_proposal` に materials.json の全行について出典付き候補を 1 つずつ記録した（プレート材 Vetronite EGS 619 の 3/5/6 mm 板、ETTINGER スタンドオフ 05.03.061/351、TR Fastenings の皿ねじ・キャップボルト・止めねじ、GANTER DIN 6325 ダウエル 2×6/2×16、KIPP K0318.04 スプリングプランジャ、HellermannTyton T18R と FlagTag）。資料は `sources.json` に SHA-256 付きで記録（KIPP は販売店 Marek 掲載のメーカー資料）。押さえの再設計でばね・ガイド・座金・ナイロンねじ/ナットの候補（Lee Spring、Essentra、TR ナイロンナット）は不要になり、資料一覧から外した。記録した時点ではすべて **owner 承認待ちの提案（PROPOSED_AWAITING_OWNER_APPROVAL）** で、その後 2026-11-12 にオーナーが推奨一式として承認した（上の「現在の状態」）。発注ではない。価格・在庫・納期は未取得。`hardware_proposal_complete` は全行が覆われ、資料があり、プランジャ候補が押し込み量・合計力・スリーブ端の検査を満たすときだけ true。

押さえの再設計で、すべての最悪値（プランジャ力の両端、基板厚 1.44/1.76 mm、ストップ・設定の公差、押さえ板と基板のたわみ、ストップねじの予張力）で基準 1 と 3 を満たし、`fresh_native_verified` は **true**、デジタル基準 1–4 の進捗表示 `digital_criteria_1_to_4_met` も **true**（完成フラグでも発注可否でもない）。`digital_fixture_complete` は従来どおり物理の基準 5 を含めて判定し、**false**（試作・実測なし）。プランジャ力の受入測定と使用ごとの設定確認は物理項目（`physical_items`）。業者の選定、プローブ穴間 0.40 mm の加工確認、0.05 mm の位置公差を示す注記付き 2D 図面は owner/調達側の事項（`owner_and_supplier_items`。そこに残る金物の承認はオーナーが済ませた）。

## 現時点の数値と限界

GKS-050 214 050 A 1000 は先端 Ø0.5 mm、推奨ストローク4.3 mmで公称1 N、最大6.35 mm、初期荷重0.44 N。5本では公称5 N、初期2.2 N。公差は資料にないため最大荷重とは呼ばない。実PCBの露出B面丸パッド Ø1 mmとの差から、**公称**半径予算は0.25 mm。基板端→パッド、位置決め、穴位置、接触子の横遊び・同心度の最悪値は資料にないため、上記の配分（最悪余裕 0.03 mm）を受入測定要求として課す。測定前に合格とはしない。

KS-050 E08 V-30 の一次資料は FR-4/CEM1穴 Ø0.98–1.00 mm。検討穴 Ø0.99 mm は加工要求であり、製造実績ではない。樹脂印刷穴へ転用しない。外径は図0.96 mmと表0.95 mmが不一致。資料の互換シリーズはKS-050だが、寸法差・圧入高さ・実ストロークを解決してから選定する。

現行最小ピッチ1.4 mm、メーカー公称グリッド1.27 mm、カラー外径1.04 mmから公称カラー間隔0.36 mm。隣接部品の高さ・工具アクセス・圧入荷重の承認ではない。Z は基板 B 面を 0 とする組立座標で、接触高さは上の「ストロークと停止」で規定する（受入測定要求）。

## SWD 配線の検討（未実施）

| Pad | 信号 | 接続意図 |
|---|---|---|
| TP1 | +3V3 | programmer の VTref **入力**。ターゲット給電出力に接続しない |
| TP2 | GND | 共通GND |
| TP3 | SWDIO | SWDIO |
| TP4 | SWCLK | SWCLK |
| TP5 | NRST | reset |

全レセプタクルは緑線なので両端にTP識別を付ける必要がある。programmer型式・コネクタpin番号・電圧仕様は未選定。外部電源は既存の正規入力経路、極性、電流制限、rail/back-power手順を別途確定する。TP1による逆給電やprogrammerとの二重給電を承認しない。

最終モジュール組立前のコントローラ単体を対象とする案。電源OFFで方向/identity/配線を照合し、支持部へ設置、ストッパまで押し込み、接触確認後に規定の電源投入、認識/書込/照合、電源OFF、解除という手順を**設計してから**実施する。現時点で実施可能な手順ではない。

## 完成に必要な証拠

1. 同一PCBのfresh-native F/B pad・component外形、高さ、はんだ包絡から、局所支持と全逃げを決定。PMMAやジャックはんだ部へ荷重を逃がさない。
2. 非対称な実形状で逆挿しを阻止する位置決めと支持経路を設計し、上記0.25 mm予算内の最悪公差を出典または明示した受入測定要求で閉じる。基板の矩形外形だけでは逆向きを防げない。
3. 実装高さ・ストローク・最大荷重を解決し、調整法と独立した機械ストッパ、ガイド、固定具、絶縁と配線保持を設計。（W8 でデジタルに充足）
4. 完成組立STEP/寸法図を再生成・干渉検査。現ファイルを完成品として流用しない。（W8 でデジタルに充足、物理の嵌合は未検証）
5. owner承認の試作ルートにより、治具/基板unit ID、測定器、raw画像・測定値付きで接触、実荷重、位置決め、ストローク、損傷を試験。観測はすべて NOT_MEASURED。

関連の #8 / #10 の物理受入は未完了（#19 はデジタルの範囲を終えて閉じた）。部品への発注・質問送信は行っていない。
