Takazudo/zudo-led-block/scripts/requirements-router.txt

# scripts/a7_route.py only (CI router reproducibility check). Pinned with the wheel hash: the recorded
# seed-0 route is compared byte for byte, so the numeric library must not drift.
numpy==2.5.3 --hash=sha256:b7e18c623bb5c95acb3b3328861272816ba199fb531921c5d6d0b675f1fde9e3
