Takazudo/zudo-led-block/engineering/a7/mechanical/layout.md

# A7 R2 mechanical layout (generated)

Generated by `scripts/a7_mechanical_layout.py`. Do not edit by hand.

Provisional digital study. Jack-axis height INFERRED; tolerances marked ASSUMED are unsourced. Not a fit approval, part approval or manufacturing release.

## Width decision: 3HP is the working candidate, 2HP stays open

- Working candidate (default variant): **3hp centred, 1.6 mm FR-4, untrimmed leads**, verdict **FEASIBLE ON PAPER**.
- Open candidate: **2hp offset 0.6 mm toward the body side, 0.8 mm FR-4, trimmed leads**, verdict **UNRESOLVED** (worst corner: lead_side -0.33, body_side -0.15, nut_front +0.00).
- Decision (PROJECT-DECISION): Width decision relayed by the project coordinator on 2026-11-08 after the R2 layout (PR #25, issue #17). Not a fit approval. Reasons: selected 2HP arrangement has negative worst-corner lead-side and body-side margins; PJ-324M jack-axis height is INFERRED, not manufacturer-confirmed (R1 Q1); guaranteed trimmed lead protrusion is ASSUMED, not confirmed (R1 Q6).
- 2HP reopens when: manufacturer axis-height evidence (drawing, 3D model or measured part) puts the axis inside the break-even band in layout.md; confirmed lead-trim data meets the break-even protrusion in layout.md; either makes every worst-corner hard margin of a 2HP row >= 0.
- No 2HP row in the sweep passes the worst corner (best worst-corner minimum -0.25 at offset 0.7, 0.8 mm).

3HP is the working candidate and the default for the generated artwork, supports and CAD. 2HP is not declared infeasible: the selected 2HP arrangement clears every nominal transverse margin, but its worst-corner margins stay negative, driven by the INFERRED jack-axis height and the ASSUMED lead trim and hole tolerances. It stays a fully parameterized open candidate and reopens on the evidence in the break-even table. The controller outline in Y-Z is common to both widths.

## What would close 2HP (one input at a time, sensitivity only)

| Margin | Input | Worst margin now | Break-even value |
|---|---|---|---|
| lead_side | jack_axis_height.max (INFERRED, R1 Q1) | -0.33 | 3.07 |
| lead_side | lead_protrusion_trimmed.max (ASSUMED, R1 Q6) | -0.33 | 0.67 |
| lead_side | panel_hole_position_tol (ASSUMED, R1 Q7) | -0.33 | does not close alone |
| body_side | jack_axis_height.min (INFERRED, R1 Q1) | -0.15 | 2.75 |
| body_side | jack_overall_height.tol (ASSUMED tol band) | -0.15 | 0.05 |
| body_side | panel_hole_position_tol (ASSUMED, R1 Q7) | -0.15 | does not close alone |

## Selected rows

| Variant | Offset | PCB | Leads | Lead side (worst / nominal) | Body side (worst / nominal) | Nut edge (worst / nominal) | Verdict |
|---|---|---|---|---|---|---|---|
| 2hp | 0.6 | 0.8 | trimmed | -0.33 / +0.70 | -0.15 / +0.70 | +0.00 / +0.30 | UNRESOLVED |
| 3hp | 0.0 | 1.6 | untrimmed | +0.10 / +0.95 | +3.00 / +3.85 | +3.15 / +3.45 | FEASIBLE ON PAPER |

## 2HP offset sweep (trimmed leads, worst-corner minimum hard margin)

| Offset | 0.8 mm | 1.0 mm | 1.2 mm | 1.6 mm |
|---|---|---|---|---|
| 0.0 | -0.93 | -1.15 | -1.37 | -1.81 |
| 0.05 | -0.88 | -1.10 | -1.32 | -1.76 |
| 0.1 | -0.83 | -1.05 | -1.27 | -1.71 |
| 0.15 | -0.78 | -1.00 | -1.22 | -1.66 |
| 0.2 | -0.73 | -0.95 | -1.17 | -1.61 |
| 0.25 | -0.68 | -0.90 | -1.12 | -1.56 |
| 0.3 | -0.63 | -0.85 | -1.07 | -1.51 |
| 0.35 | -0.58 | -0.80 | -1.02 | -1.46 |
| 0.4 | -0.53 | -0.75 | -0.97 | -1.41 |
| 0.45 | -0.48 | -0.70 | -0.92 | -1.36 |
| 0.5 | -0.43 | -0.65 | -0.87 | -1.31 |
| 0.55 | -0.38 | -0.60 | -0.82 | -1.26 |
| 0.6 | -0.33 | -0.55 | -0.77 | -1.21 |
| 0.65 | -0.28 | -0.50 | -0.72 | -1.16 |
| 0.7 | -0.25 | -0.45 | -0.67 | -1.11 |
| 0.75 | -0.30 | -0.40 | -0.62 | -1.06 |
| 0.8 | -0.35 | -0.35 | -0.57 | -1.01 |
| 0.85 | -0.40 | -0.40 | -0.52 | -0.96 |
| 0.9 | -0.45 | -0.45 | -0.47 | -0.91 |
| 0.95 | -0.50 | -0.50 | -0.50 | -0.86 |
| 1.0 | -0.55 | -0.55 | -0.55 | -0.81 |
| 1.05 | -0.60 | -0.60 | -0.60 | -0.76 |
| 1.1 | -0.65 | -0.65 | -0.65 | -0.71 |
| 1.15 | -0.70 | -0.70 | -0.70 | -0.70 |
| 1.2 | -0.75 | -0.75 | -0.75 | -0.75 |

## Depth stack (Z, from the PMMA rear)

- Axial option **rear-pocket**: jack body Z -0.5..13.7 (max 13.9); thread engagement FEASIBLE ON PAPER (1.25 worst / 1.5 nominal). Alternate plain: UNRESOLVED (0.85 worst).
- Optical stack (A5 retained): cap behind leaf 1.4 + leaf 9.0 + skin-to-leaf 2.0 = **12.4 mm**, so the rear optical volume is Z 17.4..29.8 against the 30.0 mm target.
- Frontward controller volume Z 0..16.4: PCB Z 0.2..16.4, 1.0 mm in front of the optical volume. The jacks need the rear edge at Z >= 14.0 (slack 2.4).
- Front jack terminal (pin 1) is 0.9 mm from the PCB front edge (centre to edge; hole size not sourced, R1 Q3).

## Y layout

- Jacks IN / THRU at Y 84.3 / 99.3 (A5: 90.0 / 104.0), pitch 15.0; body gap 2.9, nut gap 7.0.
- Labels: IN at Y 77.3, THRU at Y 92.3. MODE and ON/PGM/CV are removed from the front.
- Setting switch body Y 107.25..109.95, Z 2.15..11.85; actuator tip Y 111.45, 0.05 mm past the controller bottom edge (accepted overhang 0.05; body centred on the routed peg line), reached from below with the module out of the rack. Gap to the lower jack body 1.45.

## Controller (Y-Z board, common to both widths)

- Outline Y 48.5..111.4 x Z 0.2..16.4 = 1018.98 mm2 (A5 board 553.52 mm2; A5 small-part body area 144.182 mm2). Free component-face area after keep-outs about 401.189 mm2.
- a vertical keyed IDC10 header body is 8.9 mm tall (A5 C5665 maximum envelope); on the perpendicular board it would need 8.9 mm of X but the 2HP component face offers 7.0 mm.

| Keep-out | Faces | Y | Z | Reason |
|---|---|---|---|---|
| spine-slot | +X, -X | 48.5..72.0 | 0.2..4.0 | printed spine slot captures the PCB front edge |
| optical-fork | +X, -X | 104.0..107.0 | 14.6..16.4 | bottom optical cap tongue straddles the rear edge |
| setting-switch | +X | 106.1..111.4 | 1.35..12.65 | setting-switch (HX MSK13C02) body, actuator and its signal/retention pads at the bottom edge |
| switch-access | +X | 109.95..111.4 | 4.35..9.65 | actuator travel plus tool clearance; nothing taller than the switch between actuator and board edge |
| sh4-header | +X | 57.425..63.675 | 9.3..16.4 | SH4 side-entry housing and its mated plug handle |
| picoblade-header | +X | 73.95..77.15 | 5.94..11.44 | PicoBlade vertical header and mated plug |
| picoblade-tails | -X | 73.95..77.15 | 5.94..11.44 | PicoBlade THT tails and fillets on the solder face (cut to the jack trim rule in 2HP) |
| led-cable-lane | +X | 57.425..78.193 | 11.6..16.4 | SH4 header and the returning LED harness lie over the component face |
| jack-in | +X | 78.7..90.8 | 0.2..13.9 | PJ-324M body footprint |
| jack-in-leads | -X | 78.8..90.5 | 0.2..13.5 | terminal fillets only on the solder face (2HP lead-side margin) |
| jack-thru | +X | 93.7..105.8 | 0.2..13.9 | PJ-324M body footprint |
| jack-thru-leads | -X | 93.8..105.5 | 0.2..13.5 | terminal fillets only on the solder face (2HP lead-side margin) |

## Per-variant X placement (nominal)

| Check | 2HP | 3HP |
|---|---|---|
| lead_tip_x_nominal | +1.00 | +1.25 |
| lead_side_nominal_margin | +0.70 | +0.95 |
| body_top_x_nominal | +8.80 | +10.75 |
| body_side_nominal_margin | +0.70 | +3.85 |
| component_face_height_budget | +7.00 | +10.15 |
| component_reserve_height | +2.30 | +2.30 |
| component_reserve_fits | True | True |
| sh4_mated_height | +2.95 | +2.95 |
| sh4_fits | True | True |
| picoblade_mated_height | +5.20 | +5.20 |
| picoblade_wire_bend_room | +1.80 | +4.95 |
| picoblade_untrimmed_tail_margin | -0.10 | +1.85 |
| picoblade_tail_needs_trim | True | False |
| spine_screw_nut_clear_of_pcb | +1.17 | +2.74 |
| spine_screw_nut_clear_of_side | +1.17 | +2.74 |
| solder_side_room_for_fork_wall | +1.35 | +2.50 |
| fork_wall_fits_solder_side | True | True |
| nut_edge_nominal | +0.30 | +3.45 |
| pcb_x_within_inner | True | True |
| solder_face_zone_height | +0.60 | +0.60 |
| solder_face_zone_margin_worst | +0.07 | +1.14 |
| solder_face_zone_margin_nominal | +0.80 | +1.95 |
| solder_face_zone_below_lead_tips | True | True |
| power_route_end_bend_room | +0.90 | +2.00 |
| power_route_min_radius | +0.90 | +2.00 |
| power_route_bend_at_least_preferred | False | True |
| power_route_a5_cable_nominal_reaches | False | False |
| led_route_min_radius | +2.50 | +2.50 |
| rear_pocket_wall_to_panel_edge | +0.20 | +3.35 |
| x_axis | 5.5 | 7.45 |
| jack_seat_x | 2.5 | 4.45 |
| controller_pcb_x | [1.7, 2.5] | [2.85, 4.45] |
| front_screw_x | {'20.5': 4.9, '60.8': 6.025} | {'20.5': 7.45, '60.8': 9.55} |

## Load path

- Plug insertion (+Z, R1 5-10 N): barrel -> front nut -> PMMA front face -> rack screws.
- Plug withdrawal (-Z): body front face -> PMMA pocket floor (rear-pocket) or PMMA rear (plain).
- Nut torque: rectangular body in the rear pocket keys rotation (plain alternate: PCB + spine slot, i.e. through the solder joints).
- Lateral plug load: barrel in the 6.2 mm hole, clamped by the nut; PCB solder joints only see the residual.
- Controller PCB: held by the two clamped jacks at the bottom and the spine slot (Y50-72) at the front edge; Z retention by the jacks.
- Setting switch: actuation force along Z into the SMD body and its two pegs -> PCB; force not sourced.
- Optical stack: top cap -> M2 into the spine post at Y20.5 (A5 topology); bottom cap located by its fork on the controller rear edge; no jack load enters the optics.

## LED leaf: FR-4 (default) versus clear PET FPC on a clear carrier

Digital comparison only; FR-4 stays the default leaf. Values marked INFERRED are typical material figures, not supplier data.

| | FR-4 (A5) | PET film + OCA + PC carrier |
|---|---|---|
| Stack thickness (mm) | 1.3 | 1.28 |
| Outer face from centre (mm) | 0.65 | 0.64 |
| Flexural rigidity per mm, bonded / lower bound (N mm) | 3660 | 463.851 / 99.963 |
| Buckling under the SH push, fixed-free, lower bound (N) | 298.535 | 8.154 |
| Cap slot clearance per side (mm) | 0.15 | 0.16 |

- PET film alone buckles at 0.075 N; minimum static bend radius 0.84 mm (JLC 6x rule).
- LED, connector and harness start move 0.01 mm toward the centre; leaf Z [19.4, 28.4] unchanged; rear pocket: none: the leaf variant changes only the X stack, not the leaf Z range, so the 0.5 mm jack pockets and the 30 mm depth budget are unchanged.

**Recommendation.** Keep FR-4 as the default and fallback. A clear PET leaf is mechanically feasible only as film laminated to a clear carrier: the film alone buckles at about 0.07 N under the SH mating push, so it cannot stand on its own. With a 0.8 mm PC carrier the stack is 1.28 mm (FR-4 1.30 mm), fits the A5 cap slots and keeps every LED, connector, corridor and harness position within 0.01 mm, but it is 8-37x less stiff: its worst-case buckling load under the SH push is about 8 N (FR-4 299 N), and the SH mating force is unsourced. Pursue PET only after JLC answers reflow/paste, PET-compatible stiffeners and OCA clarity (Q11), and after a physical mating-force and lit-appearance test (#10).

## Unresolved inputs

| ID | Item | Decides |
|---|---|---|
| Q1 | PJ-324M axis height (INFERRED 3.0, band 2.6-3.4) | 2HP lead/body margins |
| Q6 | guaranteed trimmed lead protrusion (ASSUMED 0.7/1.0) | 2HP lead margin |
| Q7 | PMMA thickness and hole position tolerance (ASSUMED) | 2HP margins, thread engagement |
| Q3 | PJ-324M hole/slot sizes | pin-1 to PCB front edge distance (0.9 mm centre-to-edge with the rear pocket) |
| Q4 | nut fit on the SOFNG barrel | front retention |
| Q8 | rear pocket depth tolerance, appearance and strength | selected axial option |
| Q9 | PMMA clamp load / nut torque | jack load path |
| Q10 | setting-switch sourcing (PCM13SMTR stock 0; HX MSK13C02 fitted 2026-11-12, JLC stock 4561) | setting switch part |
| R2-C1 | PicoBlade on the perpendicular board in 2HP: wires leave the mated plug along +X with only the end-bend room shown per variant, and the 2.3 mm tails must be cut like the jack leads | power connector choice (R4) and 2HP power route |
| R2-C5 | A7 power cable: digital requirement 57.0 +/- 3.0 mm free span (tolerance ASSUMED) for the S-fold stowage (51.037-78.053 mm across both widths); the A5 50 +/- 6 cable does not fit. No cable has been routed or measured | power harness part and its length (#8) |
| R2-C6 | controller-to-leaf SH4 harness: route B moves the unchanged A5 adapter -2.0 mm in Z so the harness S-steps at the leaf plug mouth into a 2.4 mm gap behind the adapter; ray-sampled shading per LED is in verification.json (optical_shading_estimate). Real bend radius, insulation diameter and the lit appearance are not checked | harness and adapter mounting (#8), optics |
| R2-C2 | finished SH/PicoBlade cable bend radius, insulation, slack storage and label | harness route scenarios (#8) |
| R2-C3 | IDC ribbon side exit beyond the 2HP outline (carried over from A5) | 2HP neighbour clearance |
| R2-C4 | switch actuation force and tool access with real parts | setting switch support |
