Takazudo/zudo-led-block/engineering/a7/study/report.md

# A7 R1 dimension study (generated)

Generated by `scripts/a7_dimension_study.py` from `parameters.json`. Do not edit by hand.

Paper study. Jack-axis height is INFERRED; jack dimensions marked MIRROR come from the LCSC-hosted copy of the SOFNG drawing and are not primary-source confirmed; tolerances marked ASSUMED are unsourced. Not a fit approval or part approval.

Datum: X across the panel (0 = left edge), Z into the rack from the PMMA rear. PCB on the -X side of the jack body; terminals point to -X.

Verdicts: FEASIBLE ON PAPER = every hard margin is non-negative at the worst corner of the stated input ranges; UNRESOLVED = passes at the best corner, fails at the worst; needs stronger evidence for the named inputs; INFEASIBLE WITHIN STATED RANGES = fails even at the best corner of the stated input ranges.

## Transverse (X) summary

| Arrangement | Verdict | Variants that pass at the worst corner | Variants that need evidence | Nut 0.3 mm preferred margin |
|---|---|---|---|---|
| 2hp-centred | UNRESOLVED | - | 0.8 mm trimmed, 1.0 mm trimmed, 1.2 mm trimmed, 1.6 mm trimmed | yes |
| 2hp-offset-0.3 | UNRESOLVED | - | 0.8 mm trimmed, 1.0 mm trimmed, 1.2 mm trimmed, 1.6 mm trimmed | yes |
| 2hp-offset-0.6 | UNRESOLVED | - | 0.8 mm trimmed, 1.0 mm trimmed, 1.2 mm trimmed, 1.6 mm trimmed | no |
| 2hp-offset-0.9 | UNRESOLVED | - | 0.8 mm untrimmed, 0.8 mm trimmed, 1.0 mm untrimmed, 1.0 mm trimmed, 1.2 mm untrimmed, 1.2 mm trimmed, 1.6 mm untrimmed, 1.6 mm trimmed | no |
| 3hp-centred | FEASIBLE ON PAPER | 0.8 mm untrimmed, 0.8 mm trimmed, 1.0 mm untrimmed, 1.0 mm trimmed, 1.2 mm untrimmed, 1.2 mm trimmed, 1.6 mm untrimmed, 1.6 mm trimmed | - | yes |
| 3hp-offset-1.5 | FEASIBLE ON PAPER | 0.8 mm untrimmed, 0.8 mm trimmed, 1.0 mm untrimmed, 1.0 mm trimmed, 1.2 mm untrimmed, 1.2 mm trimmed, 1.6 mm untrimmed, 1.6 mm trimmed | - | yes |

## Transverse (X) detail, worst corner

Margins in mm after the 0.3 mm side clearance (negative = interference). Worst corner takes the adverse end of every range, the best corner the favourable end: axis height 3.4 on the lead side and 2.6 on the body side, PCB +/-10%, terminal +/-0.2, trim protrusion 1.0 / 0.5, hole position + float 0.2, panel width tolerance halved per edge (worst / best). The hole web is the PMMA between the panel hole and the panel edge.

| Arrangement | PCB | Leads | Lead side | Body side | Nut edge | Hole web | Best-corner lead side | Verdict |
|---|---|---|---|---|---|---|---|---|
| 2hp-centred | 0.8 | untrimmed | -2.45 | +0.45 | +0.60 | +1.65 | -0.75 | INFEASIBLE WITHIN STATED RANGES |
| 2hp-centred | 0.8 | trimmed | -0.93 | +0.45 | +0.60 | +1.65 | +1.03 | UNRESOLVED |
| 2hp-centred | 1.0 | untrimmed | -2.45 | +0.45 | +0.60 | +1.65 | -0.75 | INFEASIBLE WITHIN STATED RANGES |
| 2hp-centred | 1.0 | trimmed | -1.15 | +0.45 | +0.60 | +1.65 | +0.85 | UNRESOLVED |
| 2hp-centred | 1.2 | untrimmed | -2.45 | +0.45 | +0.60 | +1.65 | -0.75 | INFEASIBLE WITHIN STATED RANGES |
| 2hp-centred | 1.2 | trimmed | -1.37 | +0.45 | +0.60 | +1.65 | +0.67 | UNRESOLVED |
| 2hp-centred | 1.6 | untrimmed | -2.45 | +0.45 | +0.60 | +1.65 | -0.75 | INFEASIBLE WITHIN STATED RANGES |
| 2hp-centred | 1.6 | trimmed | -1.81 | +0.45 | +0.60 | +1.65 | +0.31 | UNRESOLVED |
| 2hp-offset-0.3 | 0.8 | untrimmed | -2.15 | +0.15 | +0.30 | +1.35 | -0.45 | INFEASIBLE WITHIN STATED RANGES |
| 2hp-offset-0.3 | 0.8 | trimmed | -0.63 | +0.15 | +0.30 | +1.35 | +1.33 | UNRESOLVED |
| 2hp-offset-0.3 | 1.0 | untrimmed | -2.15 | +0.15 | +0.30 | +1.35 | -0.45 | INFEASIBLE WITHIN STATED RANGES |
| 2hp-offset-0.3 | 1.0 | trimmed | -0.85 | +0.15 | +0.30 | +1.35 | +1.15 | UNRESOLVED |
| 2hp-offset-0.3 | 1.2 | untrimmed | -2.15 | +0.15 | +0.30 | +1.35 | -0.45 | INFEASIBLE WITHIN STATED RANGES |
| 2hp-offset-0.3 | 1.2 | trimmed | -1.07 | +0.15 | +0.30 | +1.35 | +0.97 | UNRESOLVED |
| 2hp-offset-0.3 | 1.6 | untrimmed | -2.15 | +0.15 | +0.30 | +1.35 | -0.45 | INFEASIBLE WITHIN STATED RANGES |
| 2hp-offset-0.3 | 1.6 | trimmed | -1.51 | +0.15 | +0.30 | +1.35 | +0.61 | UNRESOLVED |
| 2hp-offset-0.6 | 0.8 | untrimmed | -1.85 | -0.15 | +0.00 | +1.05 | -0.15 | INFEASIBLE WITHIN STATED RANGES |
| 2hp-offset-0.6 | 0.8 | trimmed | -0.33 | -0.15 | +0.00 | +1.05 | +1.63 | UNRESOLVED |
| 2hp-offset-0.6 | 1.0 | untrimmed | -1.85 | -0.15 | +0.00 | +1.05 | -0.15 | INFEASIBLE WITHIN STATED RANGES |
| 2hp-offset-0.6 | 1.0 | trimmed | -0.55 | -0.15 | +0.00 | +1.05 | +1.45 | UNRESOLVED |
| 2hp-offset-0.6 | 1.2 | untrimmed | -1.85 | -0.15 | +0.00 | +1.05 | -0.15 | INFEASIBLE WITHIN STATED RANGES |
| 2hp-offset-0.6 | 1.2 | trimmed | -0.77 | -0.15 | +0.00 | +1.05 | +1.27 | UNRESOLVED |
| 2hp-offset-0.6 | 1.6 | untrimmed | -1.85 | -0.15 | +0.00 | +1.05 | -0.15 | INFEASIBLE WITHIN STATED RANGES |
| 2hp-offset-0.6 | 1.6 | trimmed | -1.21 | -0.15 | +0.00 | +1.05 | +0.91 | UNRESOLVED |
| 2hp-offset-0.9 | 0.8 | untrimmed | -1.55 | -0.45 | -0.30 | +0.75 | +0.15 | UNRESOLVED |
| 2hp-offset-0.9 | 0.8 | trimmed | -0.03 | -0.45 | -0.30 | +0.75 | +1.93 | UNRESOLVED |
| 2hp-offset-0.9 | 1.0 | untrimmed | -1.55 | -0.45 | -0.30 | +0.75 | +0.15 | UNRESOLVED |
| 2hp-offset-0.9 | 1.0 | trimmed | -0.25 | -0.45 | -0.30 | +0.75 | +1.75 | UNRESOLVED |
| 2hp-offset-0.9 | 1.2 | untrimmed | -1.55 | -0.45 | -0.30 | +0.75 | +0.15 | UNRESOLVED |
| 2hp-offset-0.9 | 1.2 | trimmed | -0.47 | -0.45 | -0.30 | +0.75 | +1.57 | UNRESOLVED |
| 2hp-offset-0.9 | 1.6 | untrimmed | -1.55 | -0.45 | -0.30 | +0.75 | +0.15 | UNRESOLVED |
| 2hp-offset-0.9 | 1.6 | trimmed | -0.91 | -0.45 | -0.30 | +0.75 | +1.21 | UNRESOLVED |
| 3hp-centred | 0.8 | untrimmed | +0.10 | +3.00 | +3.15 | +4.20 | +1.80 | FEASIBLE ON PAPER |
| 3hp-centred | 0.8 | trimmed | +1.62 | +3.00 | +3.15 | +4.20 | +3.58 | FEASIBLE ON PAPER |
| 3hp-centred | 1.0 | untrimmed | +0.10 | +3.00 | +3.15 | +4.20 | +1.80 | FEASIBLE ON PAPER |
| 3hp-centred | 1.0 | trimmed | +1.40 | +3.00 | +3.15 | +4.20 | +3.40 | FEASIBLE ON PAPER |
| 3hp-centred | 1.2 | untrimmed | +0.10 | +3.00 | +3.15 | +4.20 | +1.80 | FEASIBLE ON PAPER |
| 3hp-centred | 1.2 | trimmed | +1.18 | +3.00 | +3.15 | +4.20 | +3.22 | FEASIBLE ON PAPER |
| 3hp-centred | 1.6 | untrimmed | +0.10 | +3.00 | +3.15 | +4.20 | +1.80 | FEASIBLE ON PAPER |
| 3hp-centred | 1.6 | trimmed | +0.74 | +3.00 | +3.15 | +4.20 | +2.86 | FEASIBLE ON PAPER |
| 3hp-offset-1.5 | 0.8 | untrimmed | +1.60 | +1.50 | +1.65 | +2.70 | +3.30 | FEASIBLE ON PAPER |
| 3hp-offset-1.5 | 0.8 | trimmed | +3.12 | +1.50 | +1.65 | +2.70 | +5.08 | FEASIBLE ON PAPER |
| 3hp-offset-1.5 | 1.0 | untrimmed | +1.60 | +1.50 | +1.65 | +2.70 | +3.30 | FEASIBLE ON PAPER |
| 3hp-offset-1.5 | 1.0 | trimmed | +2.90 | +1.50 | +1.65 | +2.70 | +4.90 | FEASIBLE ON PAPER |
| 3hp-offset-1.5 | 1.2 | untrimmed | +1.60 | +1.50 | +1.65 | +2.70 | +3.30 | FEASIBLE ON PAPER |
| 3hp-offset-1.5 | 1.2 | trimmed | +2.68 | +1.50 | +1.65 | +2.70 | +4.72 | FEASIBLE ON PAPER |
| 3hp-offset-1.5 | 1.6 | untrimmed | +1.60 | +1.50 | +1.65 | +2.70 | +3.30 | FEASIBLE ON PAPER |
| 3hp-offset-1.5 | 1.6 | trimmed | +2.24 | +1.50 | +1.65 | +2.70 | +4.36 | FEASIBLE ON PAPER |

## Transverse (X) nominal corner, trimmed leads

Nominal inputs (axis height 3.0 INFERRED, no tolerances). A positive row is plausible, not proven.

| Arrangement | PCB | Lead side | Body side | Nut edge |
|---|---|---|---|---|
| 2hp-centred | 0.8 | +0.10 | +1.30 | +0.90 |
| 2hp-centred | 1.0 | -0.10 | +1.30 | +0.90 |
| 2hp-centred | 1.2 | -0.30 | +1.30 | +0.90 |
| 2hp-centred | 1.6 | -0.70 | +1.30 | +0.90 |
| 2hp-offset-0.3 | 0.8 | +0.40 | +1.00 | +0.60 |
| 2hp-offset-0.3 | 1.0 | +0.20 | +1.00 | +0.60 |
| 2hp-offset-0.3 | 1.2 | +0.00 | +1.00 | +0.60 |
| 2hp-offset-0.3 | 1.6 | -0.40 | +1.00 | +0.60 |
| 2hp-offset-0.6 | 0.8 | +0.70 | +0.70 | +0.30 |
| 2hp-offset-0.6 | 1.0 | +0.50 | +0.70 | +0.30 |
| 2hp-offset-0.6 | 1.2 | +0.30 | +0.70 | +0.30 |
| 2hp-offset-0.6 | 1.6 | -0.10 | +0.70 | +0.30 |
| 2hp-offset-0.9 | 0.8 | +1.00 | +0.40 | +0.00 |
| 2hp-offset-0.9 | 1.0 | +0.80 | +0.40 | +0.00 |
| 2hp-offset-0.9 | 1.2 | +0.60 | +0.40 | +0.00 |
| 2hp-offset-0.9 | 1.6 | +0.20 | +0.40 | +0.00 |
| 3hp-centred | 0.8 | +2.65 | +3.85 | +3.45 |
| 3hp-centred | 1.0 | +2.45 | +3.85 | +3.45 |
| 3hp-centred | 1.2 | +2.25 | +3.85 | +3.45 |
| 3hp-centred | 1.6 | +1.85 | +3.85 | +3.45 |
| 3hp-offset-1.5 | 0.8 | +4.15 | +2.35 | +1.95 |
| 3hp-offset-1.5 | 1.0 | +3.95 | +2.35 | +1.95 |
| 3hp-offset-1.5 | 1.2 | +3.75 | +2.35 | +1.95 |
| 3hp-offset-1.5 | 1.6 | +3.35 | +2.35 | +1.95 |

## What the missing axis-height dimension decides (sensitivity, not a result)

2HP rows with trimmed leads, re-run as if the axis height were confirmed at 3.0 +/- 0.1 mm. All other tolerances unchanged.

| Arrangement | PCB | Lead side | Body side | Nut edge | Verdict under that assumption |
|---|---|---|---|---|---|
| 2hp-centred | 0.8 | -0.63 | +0.75 | +0.60 | UNRESOLVED |
| 2hp-centred | 1.0 | -0.85 | +0.75 | +0.60 | UNRESOLVED |
| 2hp-centred | 1.2 | -1.07 | +0.75 | +0.60 | UNRESOLVED |
| 2hp-centred | 1.6 | -1.51 | +0.75 | +0.60 | UNRESOLVED |
| 2hp-offset-0.3 | 0.8 | -0.33 | +0.45 | +0.30 | UNRESOLVED |
| 2hp-offset-0.3 | 1.0 | -0.55 | +0.45 | +0.30 | UNRESOLVED |
| 2hp-offset-0.3 | 1.2 | -0.77 | +0.45 | +0.30 | UNRESOLVED |
| 2hp-offset-0.3 | 1.6 | -1.21 | +0.45 | +0.30 | UNRESOLVED |
| 2hp-offset-0.6 | 0.8 | -0.03 | +0.15 | +0.00 | UNRESOLVED |
| 2hp-offset-0.6 | 1.0 | -0.25 | +0.15 | +0.00 | UNRESOLVED |
| 2hp-offset-0.6 | 1.2 | -0.47 | +0.15 | +0.00 | UNRESOLVED |
| 2hp-offset-0.6 | 1.6 | -0.91 | +0.15 | +0.00 | UNRESOLVED |
| 2hp-offset-0.9 | 0.8 | +0.27 | -0.15 | -0.30 | UNRESOLVED |
| 2hp-offset-0.9 | 1.0 | +0.05 | -0.15 | -0.30 | UNRESOLVED |
| 2hp-offset-0.9 | 1.2 | -0.17 | -0.15 | -0.30 | UNRESOLVED |
| 2hp-offset-0.9 | 1.6 | -0.61 | -0.15 | -0.30 | UNRESOLVED |

## Axial (Z) thread engagement

Usable thread = barrel projection - clamped PMMA - spacer - washer - 0.25 lead-in; engaged = min(usable thread, nut thickness). Requirement: at least 1.0 mm engaged at the worst corner (short barrel, thick PMMA, shallow pocket, thin nut). This check does not depend on the panel width, so it applies to 2HP and 3HP alike.

| Option | Nut | Worst exposed | Worst engaged | Nominal engaged | Full nut at worst | Verdict |
|---|---|---|---|---|---|---|
| plain | same-sky-3.5mm-nut-e | +1.10 | +0.85 | +1.25 | no | UNRESOLVED |
| plain | same-sky-mj-3502-nut | +1.10 | +0.85 | +1.25 | no | UNRESOLVED |
| front-washer | same-sky-3.5mm-nut-e | +0.80 | +0.55 | +0.95 | no | UNRESOLVED |
| front-washer | same-sky-mj-3502-nut | +0.80 | +0.55 | +0.95 | no | UNRESOLVED |
| a5-collar | same-sky-3.5mm-nut-e | +0.50 | +0.25 | +0.65 | no | UNRESOLVED |
| a5-collar | same-sky-mj-3502-nut | +0.50 | +0.25 | +0.65 | no | UNRESOLVED |
| rear-pocket | same-sky-3.5mm-nut-e | +1.50 | +1.25 | +1.50 | no | FEASIBLE ON PAPER |
| rear-pocket | same-sky-mj-3502-nut | +1.50 | +1.25 | +1.75 | no | FEASIBLE ON PAPER |
| rear-pocket-washer | same-sky-3.5mm-nut-e | +1.20 | +0.95 | +1.45 | no | UNRESOLVED |
| rear-pocket-washer | same-sky-mj-3502-nut | +1.20 | +0.95 | +1.45 | no | UNRESOLVED |

## Depth and Y layout

| Jack seating | Body rear Z (max) | Margin to A5 optical skin front (17.4) | Margin to A5 leaf front (19.4) |
|---|---|---|---|
| seated-on-pmma-rear | +14.40 | +3.00 | +5.00 |
| seated-in-rear-pocket | +14.00 | +3.40 | +5.40 |
| on-a5-collar | +15.00 | +2.40 | +4.40 |

At the A5 jack positions (Y 90.0 / 104.0), worst case with body-edge tolerances and hole position + float: body gap 1.5 mm, nut gap 5.5 mm, lower body edge Y 110.7 (rail-body limit 111.4, margin 0.7).

## Inputs

| Parameter | Nominal | Range or tol | Confidence | Source |
|---|---|---|---|---|
| panel_width_2hp | 9.8 | +/-0.1 (ASSUMED) | SOURCED | src-a7-a5-front-panel-geometry variants.2hp.width; laser-cut width tolerance not sourced |
| panel_width_3hp | 14.9 | +/-0.1 (ASSUMED) | SOURCED | src-a7-a5-front-panel-geometry variants.3hp.width; tolerance not sourced |
| panel_thickness | 2.0 | +/-0.2 (ASSUMED) | SOURCED | src-a7-a5-front-panel-geometry panel.thickness 2.0; cast-PMMA sheet tolerance not sourced ('confirm with fabricator') |
| panel_hole_radial_float | 0.1 | - | PROJECT-CHOICE | radial clearance of the panel hole around the thread major diameter: 6.2 mm hole for a 6.0 mm thread major diameter, as A5 used for its 6.0 mm barrel |
| panel_hole_position_tol | 0.1 | - | ASSUMED | laser-cut hole position; not sourced |
| jack_axis_height | 3.0 | 2.6..3.4 | INFERRED | fact-a7-pj-324m-axis-height: scaled 2.9-3.0 from the SOFNG front view; not dimensioned. Band +/-0.4 covers scaling error. Not a confirmed dimension. |
| jack_overall_height | 6.3 | +/-0.2 (ASSUMED) | MIRROR | fact-a7-pj-324m-overall-height (title H6.30); tolerance taken from the .X +/-0.20 block |
| jack_body_height | 6.0 | +/-0.2 (ASSUMED) | MIRROR | fact-a7-pj-324m-body-height |
| jack_terminal_projection | 3.2 | +/-0.2 (MIRROR) | MIRROR | fact-a7-pj-324m-terminal-projection; measured from the body seating plane, not added to the PCB thickness |
| jack_barrel_projection | 3.5 | +/-0.2 (MIRROR) | MIRROR | fact-a7-pj-324m-barrel-projection; .X +/-0.20 |
| jack_body_depth | 14.2 | +/-0.2 (MIRROR) | MIRROR | fact-a7-pj-324m-body-depth; .X +/-0.20 |
| jack_rear_terminal_from_front | 13.0 | - | MIRROR | fact-a7-pj-324m-footprint-positions pin_4_along |
| jack_body_width | 11.5 | - | MIRROR | fact-a7-pj-324m-body-width |
| jack_axis_to_edge_near | 5.4 | +/-0.2 (MIRROR) | MIRROR | fact-a7-pj-324m-axis-to-edge; .X +/-0.20 |
| jack_axis_to_edge_far | 6.1 | +/-0.4 (DERIVED-MIRROR) | DERIVED-MIRROR | fact-a7-pj-324m-axis-to-far-edge: calculated 11.5 - 5.4, not printed; tolerance is the sum of the two .X +/-0.20 values |
| thread_pitch | 0.5 | - | MIRROR | fact-a7-pj-324m-thread M6x0.5 |
| thread_major_diameter | 6.0 | - | MIRROR | fact-a7-pj-324m-thread M6x0.5 (nominal major diameter of an M6 thread) |
| thread_lead_in_loss | 0.25 | - | ASSUMED | half a pitch lost to the thread start/chamfer at the barrel tip; not sourced |
| front_body_gap | 0.0 | - | PROJECT-CHOICE | jack body front face seated on the PMMA rear (or on a rear spacer, modelled as a separate option) |
| pcb_thickness_options | 0.8 / 1.0 / 1.2 / 1.6 | +/-10% | ASSUMED | common rigid FR-4 thicknesses; +/-10% thickness tolerance assumed, supplier tolerance not retained |
| lead_protrusion_trimmed | 0.7 | 0.5..1.0 | ASSUMED | lead length beyond the solder side after factory trimming (min used at the best corner, max at the worst); the assembler's trim capability is not sourced (Q6) |
| side_clearance_required | 0.3 | - | PROJECT-CHOICE | minimum gap from any behind-panel part to the panel-outline plane (adjacent module, insulation) |
| nut_edge_margin_required | 0.0 | - | PROJECT-CHOICE | nut must stay inside the panel outline on the front face; 0.3 preferred so it does not reach a neighbouring module |
| min_engagement_required | 1.0 | - | PROJECT-CHOICE | at least two full M6x0.5 pitches engaged in the worst case; full nut-thickness engagement preferred |
| rear_pocket_depth | 0.5 | +/-0.1 (ASSUMED) | PROJECT-CHOICE | optional local rear pocket in the PMMA at each jack (concealed hardware seat); depth tolerance assumed |
| front_washer_thickness | 0.3 | - | ASSUMED | thin flat washer option; no exact washer selected |
| old_collar_thickness | 0.6 | - | SOURCED | src-a7-a5-mechanical-geometry jack.front_seat_z 0.6 (A5 backed collar) |
| a5_optical_skin_front_z | 17.4 | - | SOURCED | src-a7-a5-mechanical-geometry optical.skin_z[0]; A5 reference only, R2 may change it |
| a5_leaf_front_z | 19.4 | - | SOURCED | src-a7-a5-mechanical-geometry leaf.z[0] |
| a5_jack_y | 90.0 / 104.0 | - | SOURCED | src-a7-a5-front-panel-geometry controls.jack_y (A5 positions; A7 may move them) |
| rail_body_y | 17.1 / 111.4 | - | SOURCED | src-a7-a5-mechanical-geometry rail_body_y |
