Takazudo/zudo-led-block/doc/src/content/docs/architecture/mechanical.mdx

---
title: "機構 (2HP / 3HP)"
description: "背面 CAD、印刷部品、奥行きの余裕、不採用のケーブル経路と未解決の適合条件。"
sidebar_position: 5
---

:::caution[装着適合は未確認]
固定部品同士の干渉は解消していますが、全長の電線モデルには交差と側板への接触が残っています。
現在の組立 STEP は干渉確認用の **検討モデル** で、保存済みの電線経路は **最終配線として不採用** です。
:::

編集元は `engineering/a5/mechanical/` の CadQuery ソース (`build_mechanical.py`、`cad_kernel.py`、`geometry.json`) です。
座標は mm、X がパネル幅、Y が下向き、Z がラック奥向きで、**2 mm アクリルの裏面を Z = 0** とします。

## 2HP (優先)

2HP 組立検討モデル

2HP 分解表示

## 3HP (同じ電子回路)

3HP 組立検討モデル

3HP 分解表示

## 構成と寸法

| 項目 | 内容 |
|---|---|
| 前面 | 2 mm PMMA、幅 9.8 / 14.9 mm、高さ 128.5 mm |
| 制御基板 | 8.8 × 62.9 × 1.6 mm、Y 48.5〜111.4、前面 Z 12.6 |
| 電源変換基板 | 8.8 × 30 × 1.6 mm、前面 Z 17.4 |
| LED 基板 ×2 | 82.5 × 9 × 0.6 mm、Z 19.4〜28.4、背中合わせに接着 (片側は上下反転) |
| 印刷部品 | 各幅 7 個: 前面クレードル、上下の制御基板クランプ、上下のキャップ、左右の光学側板 |
| モデル | 各幅 **129 個の有効な固体**、**7 個の連結した印刷部品** |
| 後端 | 固定構造の解析上の後端は **Z 29.8 mm**。30 mm 目標に対して公称 **0.2 mm** の余裕しかなく、公差予算や装着適合の承認ではありません |

奥行きはアクリル裏面 Z = 0 から測り、相手コネクタ・ピン・ケーブルの曲げを含みます。

## ケーブル: 不採用の経路と未解決の条件

各幅に **16 件の条件付き所見** が残っています。

| 種類 | 件数 |
|---|---:|
| 電線同士の交差 | 12 |
| 電線と光学側板 (ディフューザー) の接触 | 3 |
| 参照用 IDC とリボンの交差 | 1 |

- LED 基板間の線の局所曲率半径は約 0.20〜0.28 mm で、モデルの電線半径より小さく、**実現可能なケーブルの証拠ではありません**。
- IDC リボンはソケットの短辺から横向きに出ます。R3 シナリオ (リボン厚 0.8 mm、幅 12.7 mm、参照ソケット Würth 61201023021) では、**2HP でパネル幅を 2.0 mm はみ出し**、**3HP では端まで 0.55 mm** です。これは隣接モジュールとの必要クリアランスの見積りで、2HP の不可能性も 3HP の装着も証明しません。
- Molex 151340300 の自由長 50 ± 6 mm (電線出口間) と、12.7 × 35.5 mm の旗ラベルの収め方は未確定です (ラベルはモデル化していません)。
- 実際の IDC ソケット・ストレインリリーフ・リボン厚・許容曲げ半径・余長は、実物で確認する必要があります。

## 印刷 (PETG)

同梱の 3MF は **Bambu H2D 0.6 mm の保存済み PLA 設定のまま** の、スライスしていない形状確認用プロジェクトです。
PETG のプロファイル、スライス、造形の適合、光学・温度性能、強度はいずれも **未検証** です。3MF はサイトでは公開せず、リポジトリにだけ置いています。

## 次の機構ゲート

1. 制御基板の配線と、ネイティブの電気的確認を終える。
2. 電線の収納干渉を解消する。
3. 実物の IDC 嵌合・ストレインリリーフの包絡と隣接クリアランスを確定し、ケーブルラベルを収める。
4. ピン・端子のトリムとはんだのクリアランスを組立業者と確認する。
5. アクリルと印刷部品の嵌め合い・締付けトルクを見直し、PETG でスライスして造形確認する。

ダウンロードできる STEP は [ダウンロード](/docs/project/downloads/) にあります。STEP のビューアーはありません。
