Takazudo/zudo-led-block/engineering/a7/docs/continuation/evidence-index.md

# A7 evidence index

Every evidence set the A7 work relies on, sorted by what kind of evidence it is. The four classes are kept
apart on purpose: an A5 historical record is not an A7 result, held A6 work is not A7 progress, and no
digital result stands in for physical qualification.

Last synchronised with `main` at `f4c0627` plus the sourcing and documentation reconciliation (#80, #20), 2026-11-13 UTC.
Every A7 engineering PR named here is merged; the current pre-order state is summarised at the top of
[`continue-here.md`](continue-here.md). Check the open PRs before starting new work.

## 1. A5 historical evidence (immutable)

Recorded when the A5 checkpoint was made (2026-11-06 JST). This repository checks the input hashes; it does not
re-run KiCad or CadQuery for these records.

| Evidence | Path | What it is | Check |
|---|---|---|---|
| Seed manifest | `provenance/seed-manifest.json` | 786 files, SHA-256 per file | `python3 scripts/verify_seed.py --manifest provenance/seed-manifest.json --repo .` |
| A5 status | `engineering/a5/integration/a5_status.json` | per-discipline status; controller unrouted (130 unconnected) | `pnpm a5:check` |
| Native schematics / netlists | `engineering/a5/integration/native_schematic/` | KiCad 10.0.8 netlists, the A7 reference netlist | `check_schematic_interfaces.py --output <outside repo>` |
| Harness contract | `engineering/a5/integration/harness_contract_A5.md` | connector pinouts and cables | read-only |
| Mechanical model | `engineering/a5/mechanical/geometry.json` | A5 2HP / 3HP CAD inputs, Z datum = PMMA rear | read-only |
| Front artwork | `engineering/a5/front_panel/` | A4 frosted / clear-lettering design, mirrored rear engraving | read-only |
| Firmware | `engineering/a5/firmware/` | STM32G031 source, host tests, release records | CI firmware jobs (copy before `make_release.py`) |
| BOM | `engineering/a5/procurement_*.json` | 30 types / 81 pieces, prices dated 2026-11-06 | `python3 engineering/a5/build_procurement_rows.py --check` |
| Component catalog | `.claude/skills/component-*/` (30 A5 bundles), `provenance/a5-catalog/` | A5 identities reconciled 30 / 71 / 81 (PR #21); pin maps are historical netlist projections, placements `NEEDS BENCH` | `python3 scripts/a5_catalog.py check`, `pnpm circuit:check` |

## 2. A6 held work (not integrated)

| Evidence | Where | Status |
|---|---|---|
| A6 controller board, gate and routing attempts | branch `claude/project-thread-391rx3` @ `7e96380`, draft PR #14, issue #7 | Held. Placed, unrouted, 125 unconnected; `a6-native` gate fails by design. Routing records `engineering/a6/verification/routing_attempts.json` and `routing_status.md` exist **only on that branch** |
| Verification helpers ported from A6 | `scripts/native_gate/PROVENANCE.md` | merged with R3 (PR #22) with provenance; the A6 scaffold itself was not merged |

## 3. New A7 evidence (digital, on `main`)

| Evidence | Path | Owner | Class of result |
|---|---|---|---|
| Source inventory with hashes | `engineering/a7/evidence/sources.json` | R1 #16 | every inspected source; SOFNG / C&K documents are `MANUFACTURER_MIRROR` (LCSC-hosted) |
| PJ-324M owner bundle | `.claude/skills/component-a7-pj-324m/` | R1, W2 | since 2026-11-11 identity, body/barrel/thread/bore and contact rating are primary PASS from the SOFNG-hosted drawing; board-layout/force/soldering facts stay `UNVERIFIED` / `UNSOURCED` (mirror only); axis height `INFERRED`; pin functions inferred |
| PCM13SMTR owner bundle | `.claude/skills/component-a7-pcm13smtr/` | R1 | per-position table from mirror; JLC stock 0 (2026-11-08); superseded as SW1 on 2026-11-12 |
| HX MSK13C02 owner bundle (SW1 from 2026-11-12) | `.claude/skills/component-a7-hx-msk13c02/`, `engineering/a7/electronics/switch-land-fit.json` (`scripts/a7_switch_fit.py`) | #77 | Hanxia drawing served by JLC (MANUFACTURER_MIRROR, Part No. blank): contact schematic 1-3 / 2-3 / 3-4, DC 12 V 0.1 A, -25..+70 C, 10,000 cycles, recommended land; JLC stock 4561 (2026-11-12). Chosen under the owner's direction (owner-decisions.json switch-supply) |
| Catalog lines | `line-a7-pj-324m`, `line-a7-hx-msk13c02` (current SW1), `line-a7-pcm13smtr` (superseded, history) | R1, #77 | outside the A5 reconciliation; published under `/docs/components/records/` |
| Dimension study | `engineering/a7/study/parameters.json` (authored), `results.json`, `report.md` (generated) | R1 | paper study: 3HP feasible on paper across X; 2HP unresolved, not infeasible; thread engagement unresolved without a rear pocket. `python3 scripts/a7_dimension_study.py --check` |
| PET FPC capture | `engineering/a7/pet-fpc.md` | R1 | JLC public capability statements only; questions 1–9 drafted, not sent (8 and 9 are Q11e / Q11f). The old supply-drop estimate is marked superseded by the PR #42 upper bound |
| Open questions | `engineering/a7/open-questions.md` | R1 | Q0–Q12 |
| Controller schematic | `engineering/a7/electronics/` (derived by `scripts/a7_electronics.py generate`; `--check` keeps it current) | R4 #19 (PR #24) | `SCHEMATIC_REVIEWED`: J1 / J2 PJ-324M and SW1 replaced, nothing else changed. SW1 was PCM13SMTR in PR #24; its MPN / LCSC fields are HX MSK13C02 / C5149819 since #77 on the same land. PJ-324M pin functions INFERRED, terminal positions MIRROR, hole sizes ASSUMED; PCM13SMTR land pattern MIRROR, body centring ASSUMED (`footprints/footprint_sources.json`) |
| Schematic verification | `engineering/a7/verification/schematic/` (`scripts/a7_schematic_check.py`) | R4 | fresh KiCad 10.0.8: ERC 0, schematic-to-PCB parity 0 against an unrouted staging board outside the repo, 51 behavioural assertions pass, delta 12 observed / 12 authorised. Staging-board DRC is not a board result |
| Mechanical layout | `engineering/a7/mechanical/design-inputs.json` (authored); `layout.json`, `layout.md`, `placement-envelopes.json` (generated by `scripts/a7_mechanical_layout.py`, `--check`) | R2 #17 (PR #25, #27) | provisional digital study: 3HP FEASIBLE ON PAPER (default), 2HP UNRESOLVED (−0.33 / −0.15 mm worst corner); break-even values for Q1 / Q6; power cable 57.0 ± 3.0 mm requirement (54–60 mm, ±3 ASSUMED; cite `layout.json` → `power_cable_requirement`, not a fixed number) |
| Mechanical CAD | `engineering/a7/mechanical/build_a7_mechanical.py`, `exports/<width>/` (STEP, GLB, views, `verification.json`) | R2 | CadQuery 2.7.0 solids: pairwise intersections, cable clearances, optical-obstruction check, switch tool access. The ~2 % LED D2 shading figure is a ray-sampled estimate, not an optical result. `python3 -m unittest scripts/tests/test_a7_r2_mechanical.py` |
| Front artwork | `engineering/a7/front_panel/` (`build_a7_front.py`, `geometry.json`, `exports/`) | R2 | switch aperture, MODE and ON / PGM / CV legends removed, IN / THRU added, rear frost mask mirrored, 0.5 mm jack pockets. Not an order file; pocket appearance and strength open (Q8) |
| LED leaf comparison (FR-4 vs clear PET) | `engineering/a7/mechanical/layout.json` → `leaf_comparison`, `layout.md` → *LED leaf*, `exports/3hp_pet/` (STEP, GLB, `verification.json`) | R2 (PR #35, `1b9d02d`) | FR-4 stays default and fallback; PET feasible on paper only on a clear 0.8 mm PC carrier (1.28 mm stack, 8–37× less stiff, worst buckling about 8 N vs FR-4 about 300 N). Carrier and OCA values INFERRED; SH mating force UNSOURCED |
| PET leaf electrical profile and check | `engineering/a7/verification/pet_leaf/` (`profile.json`, `README.md`), `scripts/a7_pet_leaf_check.py` | R4 (PR #42, `355999a`) | runs in every native CI job on a copy of the A5 leaf board. PASS: interface, mechanical, SMD-only, 2-layer track / clearance / via / copper-to-edge. NOT_MET (PET variant only): 1-layer copper (Q11d), coverlay bridges (Q11f); plated vias on 2-layer clear PET unstated (Q11e). Voltage drop is an upper bound, not a layout result. Not a PET approval |
| Native gate profile | `engineering/a7/verification/native_gate.json`, `.lock.json` | R3 #18, R4 #19 | `candidate: a7_controller`; fresh run on the committed board: PASS (ERC 0, parity 0, DRC 0, unconnected 0, refill identical, regeneration preserves the board, every negative control detected). CI runs 42499745759 (`e2a2219`) and 42500103564 (`main`) for revision 1; 42503602665 (`ae5aa3c`) for revision 2 (`4453f818…`), then 42503992506 (`edf98c2`) and 42504705390 (`8bd064b`) on `main`; 43294571723 (`8e71317`) for the current board `89310d53…e727` (SW1 part fields; board-gate step PASS, the run failed later in the JLC export step). The stricter-only custom rule `a7_pth_to_track` (0.35 mm, `controller.kicad_dru`) is proved each run by `control_pth_to_track`. Courtyards are compared at 1 nm (`placement`). Digital only |
| Design-rule delta evidence | `engineering/a7/verification/fab/jlcpcb_capabilities.json`, `native_gate.json` → `design_rule_delta` | R4 | vias 0.5/0.2 mm (was 0.6/0.3) and minimum through-hole diameter 0.2 mm (was 0.3), for the U1 / U5 fan-out; plus the stricter-only PTH-to-track 0.35 mm (`custom_rules`, JLCPCB recommended value). JLCPCB capability page URL, retrieval SHA-256 and quoted rows. Order-time pricing and quote conditions are not checked |
| Independent board review | PR #30 reviews [5818547003](https://github.com/Takazudo/zudo-led-block/pull/30#pullrequestreview-5818547003) (changes requested) and [5818654886](https://github.com/Takazudo/zudo-led-block/pull/30#pullrequestreview-5818654886) (approved), dispositions in `engineering/a7/verification/interface_review.md` | R4 | revision 1 digital board approved with four non-blocking polish items. Revision 2: PR #37 reviews [5818789798](https://github.com/Takazudo/zudo-led-block/pull/37#pullrequestreview-5818789798) (changes requested on `eb5d833`, no gate run on that head) and [5818812844](https://github.com/Takazudo/zudo-led-block/pull/37#pullrequestreview-5818812844) (no blocking findings on `ae5aa3c`). The minor CV_ADC / CV_THRU couplings for the bench are in the `eb5d833` review. Not a physical, fit or manufacturing approval |
| Controller board | `engineering/a7/electronics/controller/controller.kicad_pcb` (authoritative, revision 2 with SW1 = HX MSK13C02 fields, SHA-256 `89310d53…e727` since #77; revision 2 as merged was `4453f818…628e`, revision 1 `ec810aec…74f2`, both history), `placement.json`, `board_placement.json` (derived), `engineering/a7/verification/routing/` (router record) | R4 #19 (PR #30 `eb8adeb`, PR #37 `edf98c2`) | 16.2 × 62.9 mm, 4 layers, 1.6 mm (3HP), In1 solid GND, GND pours on F / In2 / B; seeded by `scripts/a7_board.py` + `scripts/a7_route.py` in empty staging outside the repo. PJ-324M slots still ASSUMED; SW1 land fit for HX MSK13C02 in `switch-land-fit.json`, physical fit open. Not released for manufacture |
| Mechanical fit check of the routed board | `engineering/a7/mechanical/inputs/r4-board-placement-routed.json` (copied export), `r4-placement-check.json` (generated) | R2 (PR #33, PR #38 `2a76cae`) | revision 1 (PR #33) and revision 2 (PR #38): outline matches, fixed parts in position, no pad centre or origin in a foreign keep-out, solder face resistors / test pads only. Courtyards, pad extents, heights and copper not checked there |
| Router reproducibility | `scripts/a7_route_check.py`, `engineering/a7/verification/routing/README.md`, `scripts/requirements-router.txt` | R4 (PR #39, `8bd064b`; first main run 42504705390; hardened in PR #40, `4b00448`) | each native CI run: fresh seed-0 route equals `route_proposal_seed0.json` byte for byte, and the board's tracks and vias equal it at 1 nm; failed nets or empty copper on either side fail. The `a7-controller-review-aid-NOT-A-RELEASE` artifact (Gerber, drill, positions) is a review aid, not a release output |
| Gate fixtures | `scripts/tests/fixtures/native/` | R3 | routed fixtures prove the gate detects faults (`INFRASTRUCTURE_PASS` at best); not an A7 board result |
| Interface roles | `engineering/a7/verification/interface_roles/` | R3, filled by R4 | A5 reference roles; A7 jack / switch roles reviewed for the schematic phase |
| Authorized delta | `engineering/a7/verification/authorized_delta.json` | R3, filled by R4 | reviewed `component_replaced` entries for J1 / J2 / SW1; lists the open physical gates |

## Pre-order preparation, current (2026-11-13; not a release)

- `procurement/sourcing-projection.json` (generated by `scripts/a7_procurement.py`, #80): dated 2026-11-12 JLC observations for all 30 fitted identities from `jlc-package/sources.json` (rendered page receipts, SHA-256 only) and `procurement/price-audit/2026-11-12.json` (parts-API audit, rows re-serialised). Separate reads; field meanings, currency and buy quantities INFERRED; lead time, quote, reservation and assembly acceptance not obtained. PCM13SMTR is listed as retired.
- `jlc-package/` (generated reference set), `jlc-package/panels/` (repo panels, owner decision `panel-route`) and `jlc-package/order/2026-11-13/` (dated Gerber zips, BOM, CPL, `SHA256SUMS`, export from `db0ca95`; `panel-build-summary.json` PASS). Only the dated copy is uploaded, by the owner, for the prototype route; none is a manufacturing release.
- `qualification/records.json` → `owner_prototype_route` and `qualification/approvals/2026-11-13-owner-prototype-route-sourcing-manifest.md`. Bound to `assembly-manifest.json` `557d5e48…502c` after #80; the owner re-approved on 2026-11-13. Earlier records: `2026-11-12-owner-prototype-route.md` and `2026-11-13-owner-prototype-route-hx-switch.md` (PR #79, bound to `c12c964a…e865`).
- `procurement/owner-decisions.json`: order quantity 2, repo panels, switch supply (HX), finished cables, `accept-all-recommendations` (fixture hardware approved; fabricator open) and `jack-tip-test-waiver` (PJ-324M continuity becomes a first-article check; not a pin-map confirmation).
- `patches/@takazudo__zudo-circuit-doc@0.3.0.patch` (PR #67): bounded Chrome page-target wait for the browser smoke; see `ZUDO_DEPS_PINS.md`.

## 2026-11-09 preparation (not a release; on main via PR #44)

- `procurement/assembly-manifest.json`: generated current controller plus two FR-4 leaves and adapter; external hardware/cables/fixture candidates. Engineering only, not supplier upload.
- `fixture/`: exact INGUN receipts and current B-side pad map; generated four-plate fixture design (`manifest.json`), assembly STEP with the board, probes and hardware envelopes (`fixture-assembly.step`), its interference record (`assembly-interference.json`, bound by hash) and plan drawing (`fixture-drawing.svg`). Physical fit, contact and tolerance qualification BLOCKED.
- `qualification/`: blank Workflow F procedures, unsent supplier questions, revision-bound BLOCKED readiness. Report validation is separate from order/release eligibility.
- Native CI evidence retention (2026-11-11): `native-infrastructure-evidence` also keeps the A7 candidate `a7-gate/plan.json`, `evidence/a7_controller/board_facts.json` and `board_geometry.json`. `scripts/a7_native_artifact.py` classifies the staged set in CI (`native-receipt/a7-candidate-evidence.json`) and a downloaded ZIP as VALID_PASS / VALID_FAILURE_EVIDENCE / INCOMPLETE / REJECTED against the summary hashes, the authoritative PCB, the pinned image and the expected revision/run/attempt. Artifacts before this change (e.g. run 42596523199) are INCOMPLETE. A valid record is digital evidence only; it does not set `fresh_native_verified` or complete the fixture.
- Native fixture geometry (2026-11-11, PR #46): the A7 native gate also exports `evidence/a7_controller/fixture_geometry.json` (pad shape/size/copper bbox/rotation/enabled layers/net; footprint origin/side/courtyard and outline boxes; units, axes and back-side conventions). `fixture/native-geometry.json` records it from the VALID_PASS artifact of run 43077448786 (ZIP SHA-256 `db6d6fe1…74c4`) after checking it against the canonical placement; `scripts/a7_fixture_geometry.py --check` runs in CI. The fixture manifest uses it to confirm the five probe pads and, since W5 (2026-11-11), to derive the fixture design. Since W8 (2026-11-11) that is a separate solid probe plate and a support carrier with merged rounded windows (1.0 mm walls, internal radius H/10 + 0.5 from the captured JLCCNC guidance, not a selection), a screw-down spring pressure plate whose nylon contacts sit over the probe field, a base plate, and an assembly STEP with a pairwise interference check. Body heights and solder envelopes are not native facts; the through windows remove the carrier's dependence on them. README criteria 2, 3 and 4 are met digitally; `fresh_native_verified` stays false on the unsourced J5 tail (criterion 1); `digital_fixture_complete` keeps all five criteria, including the physical criterion 5, and stays false. `digital_criteria_1_to_4_met` is a separate progress field (currently false), not the completion flag and not order eligibility.
- `docs/continuation/order-preparation-checkpoint.md`: working state, access/verification blockers and proposed child tracking. No physical results.
- Component owner bundles: acquired PCM/ST/TDK/Molex primary documents and PJ-324M supplier CAD discrepancy. Original R1 table below/above remains a dated history, not current acquisition status.
- Temperature and pass-criteria evidence (2026-11-11, W7): operating and storage temperature facts added to the TPS2552, SN74LVC2T45, OPA197, TLV9001, TLV755P, AP63205, three Samsung X5R MLCC, WS2812B-2020, SPM4020T, STM32G031, SM04B and PJ-324M bundles, plus a storage fact for BAS70 (its junction-temperature fact already existed). The lowest sourced operating upper limit is +85 C, shared by WS2812B-2020 (Topt), AP63205 and SN74LVC2T45 (TA), STM32G031 (code 6), PCM13SMTR, SM04B and the X5R characteristic span; PJ-324M prints only storage -25..+75 C with operating blank. Since 2026-11-12 SW1 is HX MSK13C02 with operating -25..+70 C (mirror), which is now the lowest upper limit among the parts with a temperature fact (530470310 and C5665 have none); the thermal-optical procedure judges SW1 at +70 C and keeps the owner's 75 C limit for the other parts. No temperature fact: 530470310, BOOMELE C5665 and PJ-3582-B; 1MS3T1B1M2QES-5 has only an UNSOURCED mirror fact (-40..85 C). TI served new bytes for tlv755p.pdf (43ff53fb..., same SBVS320D revision), recorded as a second observation; INGUN now serves different GKS-050 probe sheet bytes (6534467c..., PDF CreationDate 2026-11-09, same 11/26_GB values); `fixture/sources.json` (fixture thread, PR #53) records this as a re-download observation and keeps the 2026-11-09 hash as the identity.
- CV_BUF bound survey (2026-11-11, W7): OPA197 output can approach each rail to 25 mV (no load, 25 C, `fact-opa197idbvr-output-swing`); that is not a guarantee it never exceeds a rail, so CV_BUF bounded by +12V_PROT / -12V_PROT is an engineering inference. The rail upper limit comes from the rack; Doepfer's A-100 technical page (https://doepfer.de/a100_man/a100t_e.htm, HTML SHA-256 fe61a443b436ea7181c48d502a6f03e41b7cf1b3d2b59a2f1bb9732fcb4b1ea7, Last-Modified 2019-07-01, ecosystem reference, not a limit) gives only nominal +12 V / -12 V with no tolerance or maximum. The D3/U7 current split is in neither datasheet (BAS70 VF 410 mV max at 1 mA, 25 C only; TLV9001 only requires inputs more than 0.5 V beyond a rail to be limited to 10 mA); it does not matter while the total R7 current is below 10 mA. The +/-20 V figure is a design assumption, not a sourced rail limit.
- Molex 530470310 J5 tail (2026-11-12): the owner downloaded the sales drawing (SHA-256 76d2a581..., identical to the 2026-11-09 record); SECTION X-X gives the tail 2.3 +/-0.5 mm below the housing seating face (`fact-530470310-tail-length`). Protrusion below the A7 controller B face is a calculation, not a sourced value: 2.3 - 1.6 = 0.7 mm nominal (0.2 to 1.2 mm with the tail tolerance), assuming flush seating and an exactly 1.6 mm board, whose thickness tolerance is not sourced. `fixture/manifest.json` and `scripts/a7_fixture_relief.py` still mark the J5 tail UNKNOWN (so `fresh_native_verified` stays false) until the fixture thread consumes this fact in its own PR.
- Fixture J5 follow-up (2026-11-12): the fixture consumes `fact-530470310-tail-length`. Through-hole leads are checked at their full sourced length below the seating plane (J5 2.8 mm, J1/J2 3.4 mm), a bound for any board thickness, and all end inside the 5 mm carrier windows. The guide standoffs became 20 mm so a stock spring fits (Lee Spring LCM065E07M, 6.44-9.90 N per spring at worst case over 12.54-13.26 mm). The hold-down is now checked at its worst cases and does not meet them: with each spring independently in 6.35-10 N, the strong-G1/weak-G2 pair moves the resultant 0.10 mm outside the contact triangle (C2 reaction -0.32 N, board net load point off the land), and the board deflects 0.133 mm (limit 0.1) at the minimum 1.44 mm thickness (PROJECT-CHOICE 1.6 +/-10 % order requirement) with the ASSUMED 18 GPa; the sourced FR-4 class moduli are comparisons, not a bound. Criteria 1 and 3 are not met, so `fresh_native_verified` and `digital_criteria_1_to_4_met` are false; the hold-down needs a redesign. `manifest.json#hardware_proposal` records one sourced candidate per materials line (`hardware_proposal_complete` true), each a proposal awaiting owner approval, not a selection.
- Fixture hold-down redesign (2026-11-12): the hold-down is displacement-controlled and does not rely on spring balance. A rigid 6 mm FR-4 pressure plate is tightened to 0.3 N m onto two 6 mm M3 hex standoffs (hard stops) at y 23.3; two KIPP K0318.04 spring plungers with POM thrust pins (`sources.json#kipp-k0318`, catalogue F1 approx. 5 N, F2 approx. 16 N, taken +/-20 % as an acceptance band measured at both compression ends) press the free F face at (14.1, 21.7) and (14.2, 16.5). The M4 tapped-hole webs are measured at the 4.0 mm thread (pitch 5.2 mm; plate widened to y 13.5). Compression 0.625-1.30 mm over board 1.44-1.76 mm, stop length +/-0.05, setting +/-0.1, plate deflection and board sag; total force 15.33-34.88 N (required 12.7 N); the board net load point stays 1.22 mm inside the land hull in all 8 force-extreme cases; deflection at 1.44 mm and the ASSUMED 18 GPa is 0.023 mm under the plunger over the window and 0.031 mm under the probes (limit 0.1); chords ending at a board edge are treated as cantilevers. The stop screws need 88 N total to hold the plate against the plunger moment; 0.3 N m gives about 1000 N (nut factor 0.2 ASSUMED). Criteria 1-4 are met digitally, so `fresh_native_verified` and `digital_criteria_1_to_4_met` are true; `digital_fixture_complete` stays false on physical criterion 5. The spring, washer and nylon-screw candidates (Lee Spring, Essentra, TR nylon nut, ETTINGER 05.03.201) were dropped from `sources.json`; materials lines `stop-standoffs`, `stop-screws` and `hold-down-plungers` replace the guide, spring and contact lines.
- Not reachable from the cloud VM on 2026-11-11 and no desktop browser connected: Nexperia SOD323F packing document (HTTP 403), so the PMEG ,115 packing identity stays UNSOURCED; the SOFNG board-layout page was not retried.
- WS2812B maker statement on #13 (2026-11-12, W13): the owner forwarded `ws2812b-2020-v6-1.0.pdf`; it and a fresh cloud download are byte-identical to the recorded V1.4 (b09737fa...), so no printed value changes. A comment signed "Yin from Worldsemi" (account `YinHuaPing`, author_association NONE, identity unverified) says compatibility is judged by T0H (about 325 ns, upper limit 380 ns) and the bit period (about 1250 ns), not by T0L/T1L. This is in no Worldsemi document; it is recorded as an unverified maker statement in `docs/continuation/ws2812b-maker-statement.md` (comment body SHA-256 e2ce2695...) and offered as an option in the T1L owner decision. The current A5 firmware meets the stated T0H by calculation; nothing was measured.
- Effective-capacitance review (2026-11-12, W14): capacitor requirements recorded from TLV755P Table 4-1 footnote (effective > 0.47 µF at IN and OUT), TPS2552 Recommended Operating Conditions (IN de-coupling >= 0.1 µF; no output minimum) and AP63205 Table 3 / Sections 11-12 (C1 10 µF, C2 2 x 22 µF; 'sufficient for most applications'; no effective minimum stated). Estimates from the typical Samsung DC-bias points times tolerance -10 % and X5R -15 % (not guaranteed values; ageing excluded): +3V3 5.0 µF, +5V 26.48 µF, VLED 3.8 µF, +12V_PROT (C1) 1.41 µF (1.84 µF typical). U3 and U4 minimums have large margin and the U2 output is inside the 22-68 µF range (Eq. 10 transient not evaluated); the U2 input is far below the 10 µF table value if that value is read as effective (the datasheet does not say whether it is nominal or effective; 100 nF X7R parts are excluded as conservative), so `criterion:effective-capacitance` is now an owner decision (recommended: measure C1 at 12 V and the U2 input ripple on the bench). No PCB change.
- Owner download batch (2026-11-12, W19): ten files checked by SHA-256. Five are byte-identical to sources already recorded and change no value: Nexperia PMEG4010CEJ v.3 (378861b9..., no packing information, so ,115 stays UNSOURCED), JST eSH.pdf (ea3071ca..., No. 1 end only), Littelfuse C&K PCM datasheet VL 03/14/25 (6a758d15..., body and peg dimensions carry no tolerance; only the tape is toleranced), and the LCSC copies of the XKB PJ-3582-B drawing (64b258ff...) and the Dailywell 1M catalog (2cf95e7f...). The PJ-324M image (1d47fd48..., not byte-identical; compared visually) shows the same SOFNG page already recorded as `src-a7-pj-324m-sofng-site`: no recommended hole layout, axis height or nut. The two `DS_stm32g031f8*.pdf.txt` files (identical, bda82404...) are a text extraction of DS12992 Rev 4, not the PDF; Table 19 reads IINJ(PIN) -5 mA / NA on FT_xx and total 25 mA, Table 18 VIN on FT_xx -0.3 to VDD + 4.0 V (note 3: 4 V when an FT_a pin is used by an analog peripheral such as the ADC), but no fact was added because the text cannot be tied to the recorded PDF bytes (0e25cbbf...). New: Molex 510211110-PS rev A (31fe5251..., covers 53047**10) gives 125 V, a rated current (max.) of 1.0 A with AWG 26-30 wire, -40 to +85 C ambient and 30 mating cycles (`fact-530470310-ratings`, `-operating-temperature`, `-durability`); 510211010-PS rev B (1b2a2884...) is an older revision with the same values. The 30-cycle figure is a reference row in `service-envelope`. No gate changed class.
- Owner downloads, second batch (2026-11-12, W19): Nexperia SOD323F_115 Rev. 3.0 (2ed9548b...) gives the ,115 ending as the SOD323F 7-inch reel (180 x 8 mm, SPQ 3000), so `fact-pmeg4010cej-115-orderable` is now sourced. The STM32 datasheet arrived as text a third time (same bda82404...); per the coordinator's decision it is recorded as `src-stm32g031g8u6tr-ds-text-p45/-p46`, an owner download of DS12992 Rev 4 delivered as a text conversion, with that stated in the provenance and the hash identifying the text, not ST's PDF. Facts: VDD abs max -0.3 to 4.0 V, FT_xx VIN -0.3 to VDD + 4.0 V (FT_a used by the ADC 4 V), IINJ(PIN) -5 mA (positive NA), total 25 mA, operating VDD 1.7-3.6 V. `partial-rails` now traces these instead of the UNRESOLVED `limits` row and moves from ACCESS_EVIDENCE_HOLD to OWNER_DECISION (adopt the part absolute maxima as the pass/fail line). The `exact-part-evidence` text in `assembly-manifest.json` still names PMEG: regenerating it changes the manifest hash that the owner's prototype-route record is bound to, so that edit waits for a decision. The same stale sentence is copied into `procurement/ledger.md`, `qualification/readiness.json` and `qualification/procedures.md`, which are generated from the manifest; the order-package work regenerates them when it re-binds the route record.

## 4. Outstanding physical qualification

Nothing below has a result. Each needs a physical part, a prototype or a supplier answer.

| Item | Tracked in |
|---|---|
| Harness routing, IDC / strain-relief dimensions, tolerances, PETG fit, measured 30 mm installed depth; the A7 power cable (57 ± 3 mm requirement), adapter boss and M2x18 clamp load | #8 |
| Power, CV, firmware, optical, thermal and load qualification; manufacturing files | #10 |
| WS2812B-2020-V6 T1L timing against datasheet V1.4 (unverified maker statement recorded; written confirmation or lot waveform measurement still needed) | #13 |
| PJ-324M pin functions (TS / TRS continuity; pre-order test waived 2026-11-12, now a first-article check), axis height, nut fit, lead trim | Q1, Q2, Q4, Q6 |
| PMMA thickness / hole tolerance, rear pocket appearance and strength, clamp load | Q7, Q8, Q9 |
| Transparent PET FPC reflow, continuous temperature, stiffener, clarity after assembly | Q11 |
| PC carrier lamination with OCA after reflow (supplier and process) | Q11a |
| SH plug unmating pull, pad-to-film and film-to-OCA peel strength | Q11b, #10 |
| PET leaf in the 2HP variant | Q11c |
| PET leaf: 1-layer copper, 2-layer clear PET plated vias, coverlay bridges (PET variant only) | Q11d, Q11e, Q11f |
