Takazudo/zudo-led-block/doc/src/content/docs/decisions/index.mdx

---
title: "判断と経緯"
description: "A3 から A7 までの主な設計判断と、その理由。過去版の値は履歴で、新しい版を上書きしない。"
sidebar_position: 1
---

A5 で有効な判断と、A7 構造変更での判断をまとめます。A7 の判断はページ末尾の「A7 の判断 (2026-11-08)」にあります。過去版の資料 (`engineering/a5/history_A4/`、`history_A4_1/`、前面の `reference_A3/`) は履歴として残しています。
旧価格・旧 ADC 式・当時の実装状況は A5 の値を上書きしません。古い調査 (`research_jlc_electronics`、`io_service_audit`、`harness_supply_followup`) も日付付きの調査記録です。

## 主な判断

| 判断 | 内容 | 理由 |
|---|---|---|
| 幅 | 2HP を優先、3HP を同じ電子回路で代替 | Kumiko の横に置く細いモジュールにしたい。2HP で収まらない場合の逃げ道を残す |
| 前面 | A4 の全面フロスト・透明文字の意匠を維持 | 独立監査済みの 29 ファイルを変更しない |
| LED 配線 | 制御 J3 の 1 本の SH4 で左右 2 本のデータを送り、左 LED 基板で入替えて右へ渡す。J4 を削除 | 制御 J4 とスイッチ端子の干渉を解消し、2 本の既製 1:1 ケーブルで独立した 2 列を保つ |
| CV 入力 | U7 TLV9001 と R24 / R25 の分圧を追加。C13 を R7 の上流へ | ADC 入力のバッファと、電源断時に C13 の電荷が U7 へ流れる経路の制限 |
| ファームウェア | A5 の ADC 式専用。A4.1 とは非互換 | アナログ回路の変更に合わせて変換式を変更 |
| 故障時 | 自動再試行なし。保持記録があれば消灯を維持 | TPS2552-1 のラッチが EN で解除され得るため、FAULT の解除を再有効化の許可とみなさない |
| 試作 | 光学専用 PCB を先行発注しない。統合試作で評価 | 回路・機構・FW がそろった状態でしか意味のある評価にならない |
| 数量 | A5 時点では未合意。1 / 10 / 100 台は比較条件。A7 の最初の製作は 2 台 (2026-11-12 オーナー決定) | 発注判断の前に見積りが必要 |
| 調達の観測 | 2026-11-06 JST の価格・在庫を日付付きで保持 | 在庫予約ではなく、比較のための観測値 |

## 版の流れ

| 版 | 位置づけ |
|---|---|
| A3 | 初期の前面と穴位置 (`front_panel/reference_A3/`、比較用) |
| A4 | 現在も使う前面意匠 (全面フロスト + 透明文字) |
| A4.1 | 回路・調達の前版。247 アーカイブ項目を復元照合。旧 ADC 回路 |
| A5 | ネイティブ KiCad、実ビルドのファームウェア、背面機構。最後に取り込んだ完全なチェックポイント (`engineering/a5/`、不変) |
| A6 | 幅 8.8 mm 固定の制御基板の配線を試みた版。未配線のまま **保留** (PR #14 はドラフト、`main` には未反映) |
| A7 | 直角ジャック・垂直な制御基板・基板側の設定スイッチへの構造変更。**設計検討中** (`engineering/a7/`) |

## このリポジトリでの判断 (2026-11-07)

| 判断 | 内容 |
|---|---|
| 取込み | A5 シードの 786 ファイルを `engineering/a5/` にバイト単位で取込み、不変とする。巨大な派生テッセレーション JSON 4 件と A3 の入れ子アーカイブは除外し、理由を `provenance/` に記録 |
| ドキュメント | `create-zudo-circuit-doc@0.2.0` / `@takazudo/zudo-circuit-doc@0.3.0` を使い、日本語を主言語にする。BOM と状態表は A5 の JSON から生成 |
| 部品証跡カタログ | 0 件から始め、移行は別作業。証跡を推測で作らない |
| ホスティング | Cloudflare Workers Static Assets。リポジトリ変数 `CLOUDFLARE_DEPLOY_ENABLED` が `true` になるまで本番公開しない |

## A7 の判断 (2026-11-08)

「決定者」はその判断をした人や作業です。「暫定」は後の作業で変わり得る判断です。

| 判断 | 内容 | 決定者 | 状態 |
|---|---|---|---|
| 構造変更 | 前面は光る文字と CV ジャック 2 個だけにし、制御基板を前面に垂直に置く | オーナー | 採用 |
| A6 の扱い | A6 は保留。A7 は A6 の配線を完了させない。PR #14 はドラフトのまま残し、検証の部品だけを出典付きで R3 に移植 | コーディネーター (#7 のコメント) | 決定 |
| ジャック | SOFNG PJ-324M (C22355739) をモノラル CV に使う。TRS 対応でもステレオ機能は追加しない | オーナー | 採用。資料は 2026-11-11 に SOFNG サイトの図面を取得 (2 ページ目はミラーのみ) |
| モード切替 | 前面トグルをやめ、基板側の側面スライドスイッチにする。ON / PROGRAM / CV の符号は A5 のファームウェアと同じ。部品は C&K PCM13SMTR で選定したが JLC 在庫 0 のため、2026-11-12 にオーナーの方針 (動けばよい・安く・在庫あり) で hanxia HX MSK13C02 (C5149819) に変更 | オーナー (方針と変更)、R1 (部品) | HX MSK13C02 に決定。ランドは PCM13SMTR 用のまま、実物での適合は未確認 |
| 幅 | 2HP を優先、3HP を代替。R2 では 3HP を作業候補とし、2HP の 0.6 mm ずらしをパラメータとして残す | オーナー (方針)、コーディネーター (作業候補、R2 の結果を受けて) | 暫定。3HP を作業候補として機構モデル・アートワークの標準にした (PR #25)。オーナーの方針は 2HP 優先のまま。2HP は最悪条件 −0.33 / −0.15 mm で未確定、不成立とは判断していない。軸高さ (Q1) か端子カット長 (Q6) の証拠で再検討 |
| LCSC がホストする資料 | SOFNG / C&K の資料は MANUFACTURER_MIRROR として扱い、値は残して判定は UNVERIFIED / UNSOURCED | コーディネーター (Q12) | 決定 |
| 不採用のジャック | Same Sky MJ-3502 は本体高さ 11.30 で 2HP に入らない | R1 | 決定 |
| ねじのかかり | A5 の 0.6 mm カラーは残さない。PMMA 裏の 0.5 mm ポケットに両ジャックを座らせる (最悪でも 1.25 mm かかる) | R1 (提案)、R2 (機構モデルに採用) | 暫定。深さ公差・見え方・強度 (Q8) と締め付け荷重 (Q9) は未確認 |
| 透明 LED 基板 | 透明 PET FPC は LED 部分だけで検討。制御・電源・荷重は FR-4。A5 の FR-4 LED 基板を基準・予備に残す | オーナー | 採用。PET の工程は未確認 |
| A7 の検証 | A7 の基板と、それを `candidate` にするゲートは同じ PR で入れる。それまでゲートは `NO_CANDIDATE` で止まる | R3 | 決定 |
| 回路図の差分 | A5 の制御基板の回路から J1・J2 (PJ-324M) と SW1 (PCM13SMTR) だけを差し替え、ほかの接続は変えない。PJ-324M のピン機能は推定のまま | R4、独立した電気レビュー (PR #24) | 決定 (回路図フェーズ)。基板・物理ゲートの承認ではない |
| 設計ルールの差分 | A7 の制御基板だけ、ビアを 0.6 / 0.3 mm から 0.5 / 0.2 mm にし、最小スルーホール径も 0.3 mm から 0.2 mm に下げる (U1 と U5 の引き出しのため)。ほかの規則は A5 のまま | R4、独立レビュー (PR #30) | 決定 (デジタル)。根拠は JLCPCB の公開能力 (`engineering/a7/verification/fab/jlcpcb_capabilities.json`)。発注時の見積り条件は未確認 |
| 配線済み基板の扱い | 独立レビューの 2 回目で承認した基板 (`ec810aec…`) を権威基板とし、4 件の非ブロッキングの改善は後回し | R4、独立レビュー (PR #30) | 決定 (デジタル)。リビジョン 2 で置き換え。物理・適合・製造の承認ではない |
| PTH–配線の規則 | 厳しくする方向だけのカスタム規則 `a7_pth_to_track` で、スルーホールの穴から他ネットの配線まで 0.35 mm 以上 (JLCPCB の推奨値)。負の対照で毎回検出を確かめる | R4、独立レビュー (PR #37) | 決定 (デジタル) |
| 基板リビジョン 2 | 改善 4 項目を反映した基板 (`4453f818…`) を権威基板にする | R4、独立レビュー (PR #37) | 決定 (デジタル)。物理・適合・製造の承認ではない |
| SW1 を HX MSK13C02 に変更 | SW1 を C&K PCM13SMTR (C221842、JLC 在庫 0) から hanxia HX MSK13C02 (C5149819) に変え、部品欄だけを更新した基板 (`89310d53…e727`) を現在の権威基板にする。銅パターン・配置は同じ | オーナーの方針 (2026-11-12、`owner-decisions.json` の switch-supply)、#77、PR #78 | 決定 (デジタル)。実物での接点表と適合は初品で確認 |
| 試作ルートと注文ファイル | 2 台分を自前の面付けで試作し、日付付きの注文ファイル (`jlc-package/order/2026-11-13/`) をオーナーがアップロードする。PJ-324M の発注前の導通試験は免除し、初品で確認 | オーナー (2026-11-12 承認、HX 版は 2026-11-13 に再承認、PR #79、#80 の台帳更新後の版も同日に再承認) | 承認済み。承認は識別に結び付き、現在の識別 (調達台帳 `557d5e48…`) と一致。発注・製造リリースではない |
| LED リーフの材料 | FR-4 を標準・予備のまま。透明 PET は 0.8 mm の透明 PC 支持板に貼る場合だけ機構上は机上で成立するが、電気の確認で 1 層の銅箔とカバーレイのブリッジが未達 (Q11d、Q11f)。JLC の回答と実物試験がそろうまで進めない | R2 の比較 (PR #35)、R4 の電気の確認 (PR #42) | 推奨 (デジタル)。PET の採否はまだ決めていない |
| 部品カタログ | A7 の部品は `line-a7-` の行と `component-a7-` のバンドルにし、A5 の 30 / 71 / 81 の集計に含めない | R1 | 決定 |
| 電源アダプタの位置 | A5 の電源アダプタ (基板・C5665 ヘッダ) は形を変えずに 2.0 mm 前へ移し、LED 基板との間に 2.4 mm のすき間を作って SH4 ハーネスを通す。上キャップに 2.0 mm の印刷ボスを足し、ポストのナットも 2.0 mm 下げる。上キャップのねじは M2x16 から M2x18 にする。30 mm の奥行きは変わらない | R2、コーディネーター | 暫定 (デジタル検討)。締め付け荷重とボスの強度は未評価 |
| A7 の電源ケーブル長 | アダプタから制御基板までの PicoBlade ケーブルは、デジタル上の要求として自由長 57 ± 3 mm (54–60 mm、`layout.json` の `power_cable_requirement` から。J5 の位置で変わる)。**±3 mm の公差は仮定 (ASSUMED)**。A5 の 50 ± 6 mm のケーブルは入らない | R2 | 暫定。ケーブルは配線も実測もしていない (#8) |
