Takazudo/zudo-led-block/doc/src/content/docs/project/index.mdx

---
title: "プロジェクト概要"
description: "Zudo LED Block の目的・設計条件・現在の状態。A5 チェックポイントと A7 構造変更。"
sidebar_position: 1
---

:::danger[A5 も A7 も製造リリースではありません]
A5 の制御基板は **未配線** です。A7 は設計検討の段階で、回路図と配線済みの制御基板はデジタル検証とレビューまで、機構モデルは暫定のデジタル検討で、物理評価はまだありません。ハーネス配線と装着適合は未解決で、電気・光学・温度・造形・荷重の物理評価はまだ行っていません。
このサイトのビルドや CI が通っても、電子回路や製造の承認にはなりません。
:::

Zudo LED Block は、Kumiko のブランクパネルの横に置く細い Eurorack 用の「光るブロック」です。
透明アクリルの前面に彫った文字が光り、左右の半透明 PETG 側板から隣の Kumiko へ光を当てます。
このリポジトリは、エンジニアリング・チェックポイント **Light Block A5** (2026-11-06 JST) をそのまま取り込み、
その内容をこのサイトで説明しています。
現在は、その A5 を基準にした構造変更 **A7** を進めています ([A7 の現状](/docs/project/a7/))。

**現在の状態: A5 の設計と部品表 (BOM) を取り込み済み。30 型番すべてを部品証跡カタログ (component-evidence catalog) に移行しました。**
30 型番・81 点の部品表は [部品表 (A5 BOM)](/docs/architecture/bom/) にすべて掲載し、各行から [Components](/docs/components/) の記録ページへリンクしています。
カタログに載っていることは「製造に使える」という意味ではありません。各記録には、メーカー一次資料で確認した事実と、未確認のまま残る項目 (`OPEN`・`UNSOURCED`・`NEEDS BENCH`・`SOURCE UNAVAILABLE`) がそのまま表示されます。
照合の方法と限界は [部品証跡カタログの照合](/docs/verification/component-catalog/) を参照してください。

## 設計条件 (A5)

| 項目 | 内容 |
|---|---|
| 幅 | **2HP を優先** (前面 9.8 mm)、3HP (14.9 mm) を同じ電子回路で代替 |
| 前面 | 透明キャスト PMMA、高さ 128.5 mm、厚さ 2 mm |
| 前面の加工 | 見える裏面は全面フロスト、文字線とモード記号だけ透明。O / P / D の内側もフロスト。正面は平滑。締結部の小さな座面だけ透明。裏面彫刻データは **鏡像化済み** |
| 側面の光 | 交換できる半透明 PETG 側板。左右 4 個ずつ、計 8 個の個別制御 RGB LED。左右は独立した 2 本のデータ列 |
| 操作 | ON / PROGRAM / CV の保持型スイッチ。**中央の物理 OFF 接点は PROGRAM** を意味し、電源 OFF ではない |
| CV | IN→OUT は受動 THRU (回路図で指定、制御基板の物理配線は未完)。公称 ±5 V を 20 MΩ の検出枝で読む |
| 奥行き | アクリル裏面 z=0 から、相手コネクタ・ピン・ケーブルの曲げを含めて 30 mm を目標 |
| 組立 | 工場実装と完成ケーブルを使い、差込み・ねじ組立で完成させる構成を目標 (工場対応条件は未確定) |
| 試作方針 | 光学だけの PCB を先行発注しない。レイアウト・適合・リリースの各ゲートを通ってから統合試作 |
| 数量 | A5 時点では未合意で、1 / 10 / 100 台は費用比較の条件。A7 の最初の製作は 2 台 (2026-11-12 オーナー決定。[発注前にオーナーが行うこと](/docs/project/order-checklist/)) |

## A7 で変えるもの

A7 ([#15](https://github.com/Takazudo/zudo-led-block/issues/15)) では次の点を変えます。それ以外の条件 (奥行き 30 mm、左右独立の LED 2 列、受動 THRU、MCU のピン割り当て、電源・起動の動作) は A5 を維持します。

| 項目 | A5 | A7 |
|---|---|---|
| 前面 | 文字と CV ジャック 2 個、モードのトグルと ON / PGM / CV の表示 | 光る文字と CV ジャック 2 個 (IN / THRU) だけ。スイッチの穴と表示を外す |
| モード切替 | 前面の ON–OFF–ON トグル | 基板側の側面スライドスイッチ (取り付け前に設定) |
| ジャック | PJ-3582-B | 直角のねじ付き SOFNG PJ-324M |
| 制御基板 | 幅 8.8 mm、前面と平行 | 前面に垂直。奥行きを配線の場所に使う |
| 幅 | 2HP 優先 / 3HP 代替 | 同じ。R2 では 3HP を作業候補、2HP は未確定のまま検討 |
| LED 基板 | 0.6 mm FR-4 | FR-4 が標準・予備。透明 PET FPC は透明な支持板に貼る場合だけ機構上は机上で成立 (PR #35)。電気の確認で未達の項目あり (PR #42) |

## 構成の要点

- **4 枚の物理基板 / 3 種類のネイティブ設計**: 制御基板 (59 点)、同一設計の LED 基板 ×2 (各 10 点)、電源変換基板 (2 点)。合計 **30 型番・81 点 / 台**。
  ユニーク配置数 71 は設計上の数え方で、実装点数 81 とは異なります。
- MCU は STM32G031G8U6TR。ファームウェアは A5 の CV 回路専用で、旧 A4.1 の回路には使えません。
- 詳しくは [システム構成](/docs/architecture/overview/)、[電子回路とインターフェース](/docs/architecture/electronics/)、[機構](/docs/architecture/mechanical/)、[ファームウェア](/docs/architecture/firmware/)、[前面アートワーク](/docs/architecture/front-panel/) を参照してください。

## 現在の設計状態

| 項目 | 状態 |
|---|---|
| 設計リビジョン | A5 (2026-11-06 JST)。`engineering/a5/` に不変のまま保存 |
| 回路図 | 3 種類のネイティブ KiCad 10.0.8 回路。記録上 ERC 0 エラー / 0 警告 |
| PCB | LED 基板・電源変換基板は配線済み (記録上 DRC 0 / 未接続 0)。**制御基板は配置のみ・未配線** (未接続 130、コートヤード重なり 2 件) |
| ファームウェア | ARM ビルド済み・ホスト試験済み (記録)。**書込み・実機試験なし** |
| 機構 | 2HP / 3HP の CAD と印刷形状。全長ケーブルの交差・接触が残り、装着適合は未確認 |
| 物理試作 | なし |
| 製造リリース | **なし** |

A7 の状態は次のとおりです (2026-11-13)。

| 項目 | 状態 |
|---|---|
| 部品と寸法の検討 (R1) | `main` に反映。3HP は幅方向で机上成立、2HP は未確定 (不成立ではない) |
| ネイティブ検証の基盤 (R3) | `main` に反映。A7 基板が入るまで A7 のゲートは `NO_CANDIDATE` で止まり、PR #30 からは権威基板で実行 |
| 回路図 (R4) | `main` に反映 (PR #24)。独立した電気レビュー済み。J1・J2・SW1 だけを差し替え |
| 機構モデル・アートワーク (R2) | `main` に反映 (PR #25、#27)。暫定のデジタル検討。3HP を作業候補、2HP は未確定 |
| 配置・配線 (R4) | `main` に反映 (リビジョン 1 は PR #30、リビジョン 2 は PR #37、SW1 を HX MSK13C02 にした現在の基板 `89310d53…e727` は #77)。A7 のゲートは `PASS`、独立したレイアウト・電気レビューでブロッキングの指摘なし (デジタル検証のみ、物理評価・製造リリースではない) |
| A6 | 保留 (PR #14 はドラフト、制御基板は未配線) |
| 試作の準備 | 2 台分の面付けした注文ファイルを準備済み (`engineering/a7/jlc-package/order/2026-11-13/`)。試作ルートはオーナーが承認し、調達台帳の更新 (#80) の後に現在の識別で再承認した。注文画面での確認と発注は未実施。製造リリースではない |
| 物理評価 | なし |

分野別の詳細は [A5 の現状](/docs/project/status/) (自動生成)、次にやることは [次の作業](/docs/project/next-actions/) にあります。

## このサイトの読み方

- [A7 の現状](/docs/project/a7/) は A7 の進み具合・部品の変更案・未解決事項を、手で書いた記録としてまとめています。
- [A5 の現状](/docs/project/status/) と [部品表](/docs/architecture/bom/) は `engineering/a5/` の JSON から自動生成しています。
- [検証と再現](/docs/verification/) は、A5 作成時に記録された **履歴上の結果** と、このリポジトリの CI が **新たに実行する確認** を分けて示します。
- [ダウンロード](/docs/project/downloads/) には公開用に選んだ資料・STEP・アートワークだけを置いています。
- [判断と経緯](/docs/decisions/) は A3 → A4 → A4.1 → A5 の主な判断と、A6 の保留・A7 の判断をまとめています。
- [CI とホスティング](/docs/project/hosting/) は、まだ有効化していない本番公開の手順です。
