Takazudo/zudo-led-block/doc/src/content/docs/project/next-actions.mdx

---
title: "次の作業"
description: "A7 構造変更で次にやること、A5 から引き継ぐ作業、未解決の問い、完了条件。"
sidebar_position: 4
---

このページは作業を続けるための入口です。A7 の出典は `engineering/a7/docs/continuation/continue-here.md`、A5 の出典は `engineering/a5/continue-here.md` と `integration/a5_status.json` です。

## 現在のスナップショット

| 項目 | 内容 |
|---|---|
| 日付 | 2026-11-13 UTC (`main` の `f4c0627` に、調達観測と文書の整合 ([#80](https://github.com/Takazudo/zudo-led-block/issues/80)、[#20](https://github.com/Takazudo/zudo-led-block/issues/20)) を加えた状態)。A5 チェックポイントは 2026-11-06 JST |
| 進めている版 | **A7** 構造変更 ([#15](https://github.com/Takazudo/zudo-led-block/issues/15))。A7 r2・3HP・FR-4 リーフ。最初の試作は 2 台 (制御基板 2、LED リーフ 4、電源アダプタ 2)。製造リリースではない |
| `main` に入った A7 の成果 | R1 部品と寸法の検討 (PR #23)、R3 ネイティブ検証の基盤 (PR #22)、R4 回路図 (PR #24) と配線済みの制御基板 (リビジョン 1 は PR #30、リビジョン 2 は PR #37。ゲート `PASS`、独立レビューでブロッキングの指摘なし。現在の基板は SW1 の部品欄を HX MSK13C02 にした #77 の `89310d53…e727`)、R2 機構モデルと前面アートワーク (PR #25、#27、暫定のデジタル検討)、配線済み基板との照合 (PR #33、#38)、配線の再現性の CI 確認 (PR #39、#40)、PET と FR-4 のリーフの比較 (PR #35)、PET リーフの電気の確認 (PR #42) |
| 保留 | A6 (PR #14、ドラフトのまま。制御基板は未配線) |
| 部品証跡カタログ | A5 の **30 型番を移行済み** (PR #21)。配置・ピンマップは A5 の履歴ネットリストからの投影で、実機未確認。A7 の部品は `line-a7-` の行として別に登録 (現在の SW1 は HX MSK13C02 / C5149819。PCM13SMTR の行は履歴) |
| 最も大きな未解決事項 | 物理的な評価が一つも無いこと。ジャックのピン機能・穴径・軸高さ、SW1 の実物での適合は試作品が届いてからの確認 |

状態の詳細は [A7 の現状](/docs/project/a7/) を参照してください。

## A7 で次にやること (順番)

2026-11-09 に始めた発注準備は PR #44 で main に統合し、その後オーナーの判断 (PR #74)、HX スイッチへの変更と価格点検 (PR #78)、HX 版の試作ルート承認 (PR #79)、日付付きの注文ファイル (`f4c0627`)、調達の観測の整合 (PR #81) と、その版の試作ルート再承認が入りました。readiness は BLOCKED のままで、これは製造リリースまでの全条件を数えているためです。最初の試作基板を手に入れるのに、製造リリースの全試験が先に要るわけではありません。基板を変える場合は、ゲートの再実行・独立レビュー・R2 の照合をやり直します。

### 試作から製造リリースまでの段階

| 段階 | 現在の状態 | 根拠 |
|---|---|---|
| 1. デジタルの実装 | 完了。回路図、配線済み制御基板 (`89310d53…e727`、ゲート `PASS`)、機構モデル、治具のデジタル基準 1〜4 と native の新規検証。#17・#19 は完了として閉じた | `engineering/a7/docs/continuation/continue-here.md` |
| 2. 試験用試作ルートの承認 | オーナーが 2026-11-12 に承認し、HX 版を 2026-11-13 に再承認 (PR #79)。承認は `qualification/records.json` の identities (基板・回路図・機構・治具・調達台帳などの SHA-256) に結び付く。調達台帳 `assembly-manifest.json` はこの整合で `c12c964a…` から `557d5e48…` に変わったので (変わったのは調達の欄だけ: order_plan の行の項目とロス分の文、行ごとの観測への参照、供給の未解決事項の文、入力ハッシュ 3 件の追加)、前の承認はこの版に効かなくなった。オーナーが 2026-11-13 に新しい識別を再び承認し (返信「approve」、`approvals/2026-11-13-owner-prototype-route-sourcing-manifest.md`)、`records.json` は `557d5e48…` に結び付いた。readiness は `owner_prototype_route` を出していない。前の 2 つの承認記録は履歴として残す | `engineering/a7/qualification/approvals/`、`readiness.json` |
| 3. 面付けした注文ファイル | 準備済み。自前の面付け (オーナーの判断) で、`engineering/a7/jlc-package/order/2026-11-13/` に基板ごとの Gerber zip・BOM・CPL と `SHA256SUMS`。`a7_panel.py build` と単基板 export の照合は PASS。ファイル名の `DRYRUN` はツールの名前のまま | `order/2026-11-13/README.md` |
| 4. 注文画面での確認 | 未実施。配置プレビューで制御基板 J1・J2・J5・SW1 と電源アダプタ J1・J2 の中心と回転、PCBA 数量がシート数 (2) で数えられるか、自前パネルの組立を JLC が受けるか (オーナーの受入は JLC の確認ではない)、電源アダプタの基材 (FR-4 と仮定)、表面処理、実際の組立条件 | `order/2026-11-13/README.md`、`jlc-order-package` |
| 5. 発注 | 未発注。発注・アップロード・支払いはオーナーが行う。リポジトリには発注記録がない | `readiness.json` の `order_submitted: NOT_ESTABLISHED` |
| 6. 初品確認と製造リリース | 未実施。PJ-324M の端子 4/5 (発注前の導通試験はオーナーが免除。初品で確認)、SW1 の接点と適合、治具の基準 5 (接触・荷重)、電源・CV・FW・光学・温度の評価を経て、製造リリースは別のオーナー承認 | `qualification/plan.json`、#8・#10・#13 |

アップロードの扱い: `engineering/a7/jlc-package/` 直下と `panels/` のファイルは生成器の基準セットで、そこからはアップロードしません。オーナーが試作ルートで使うのは日付付きの `order/2026-11-13/` の写しです。どちらも製造リリースではありません。

発注の前にオーナーにしかできない作業と、それぞれが解除するゲートは [発注前にオーナーが行うこと](/docs/project/order-checklist/) にまとめています (自動生成)。19 の物理手順には、準備物・手順・記録項目と、出典と照合した受入値があります。
JLCPCB の注文画面に基板ごとに何を入れるかは [JLCPCB 発注パッケージ](/docs/project/jlc-order-package/) にあります (自動生成)。部品ごとの日付付きの在庫・価格の観測は `engineering/a7/procurement/sourcing-projection.json` と `ledger.md` にあります。30 型番すべてに 2026-11-12 の観測がありますが、現在の在庫・見積・在庫確保・実装受入ではなく、納期はどの型番も未取得です。

| 順 | 作業 | 完了条件 |
|---:|---|---|
| 1 | **物理ゲートとオーナーの判断**。PJ-324M のピン機能 (TS / TRS プラグでの導通確認、Q2。発注前の試験はオーナーが 2026-11-12 に免除し、組立後の初品で確認。免除はピン対応の確認ではない)、穴径 (Q3)、軸高さ (Q1)、SW1 (HX MSK13C02) の接点表と適合 (Q10)、治具の FR-4 板の加工業者の選定 (提案した金物はオーナーが承認済み)。2HP と透明 PET は別の任意検討で、FR-4 試作の発注を止めない | 部品・実測・オーナーの回答の記録。デジタルの作業では完了にできない |
| 2 | **外部の証跡** (`engineering/a7/open-questions.md` の Q0〜Q11 と Q11a〜Q11f。Q12 は決定済み)。SOFNG の一次資料と supplier symbol の端子4/5不一致、ナット、端子カット、PMMA の公差とポケット、JLC の PET の回答、PC 支持板の貼り合わせの供給元 (Q11a)、2 層の透明 PET のめっきビア (Q11e)、カバーレイのブリッジ (Q11f)。Q11d〜Q11f は PET 案だけを止め、FR-4 には影響しない | 事実を 1 件ずつ更新。JLC への PET の質問 (`engineering/a7/pet-fpc.md` の 1〜9。8 と 9 が Q11e と Q11f) は下書き済みで、**未送信**。ほかの未送信質問は `engineering/a7/qualification/supplier-questions.md` に準備しました。供給元への送信は現在の作業範囲外 |
| 3 | **物理評価** ([#8](https://github.com/Takazudo/zudo-led-block/issues/8)、[#10](https://github.com/Takazudo/zudo-led-block/issues/10)、[#13](https://github.com/Takazudo/zudo-led-block/issues/13))。ハーネス、57 ± 3 mm の電源ケーブル (±3 は仮定)、PETG の造形、電源・CV・FW・光学・温度・荷重、CV ノイズ (DATA_L との結合)、PET を進める場合は SH の挿抜力 (Q11b) と点灯時の見え方 | 測定記録 |
| 4 | **製造リリースの判断**。試作用の注文ファイルは準備済み (上の段階 3)。製造リリース用のファイル一式と承認は物理評価の後 | オーナーの判断。製造リリース・発注は現在の作業範囲外 |

完了済み (デジタル):

- **配線の再現性を CI で確認** (PR #39、強化は PR #40 `4b00448`)。CI で毎回、seed 0 の配線を新しく作って記録と一致すること、権威基板がその配線を持つことを確かめる。CI のレビュー補助 (Gerber など) はリリース出力ではない。
- **SW1 を HX MSK13C02 に変更** (#77、PR #78)。部品欄だけを変え、銅パターンと配置は同じ。現在の基板 `89310d53…e727`、CI run 43294571723 の基板ゲートの手順は `PASS` (その実行は後の JLC 出力の手順で失敗)。
- **R4 基板リビジョン 2** (PR #37 `edf98c2`)。当時の基板 `4453f818…628e` (履歴)。レビューの改善 4 項目を反映し、厳しくする方向だけの PTH–配線 0.35 mm の規則 (`a7_pth_to_track`) と、その負の対照を追加。ゲート `PASS`、独立した再レビューでブロッキングの指摘なし。
- **PET と FR-4 のリーフの比較** (PR #35 `1b9d02d`)。FR-4 が標準のまま。透明 PET は 0.8 mm の透明 PC 支持板に貼る場合だけ机上で成立。新しい未解決事項は Q11a〜Q11c。
- **PET リーフの電気の確認** (PR #42 `355999a`)。CI で毎回実行。インターフェース・機構・2 層フィルムのルールは PASS。1 層フィルムでは A5 の銅箔を通せない (Q11d) こと、カバーレイのブリッジが JLC の最小に足りない (Q11f) ことは NOT_MET。2 層のめっきビアは JLC の資料に無い (Q11e)。PET の採用ではない。
- **R4 配置・配線、リビジョン 1** (PR #30 `eb8adeb`、2026-11-08)。基板 `ec810aec…` で A7 のゲートが `PASS` (ERC 0、パリティ 0、DRC 0、未接続 0、負の対照すべて検出)。設計ルールの差分はビア 0.5 / 0.2 mm と最小スルーホール径 0.2 mm で、JLCPCB の公開能力を根拠に記録。独立レビューは 1 回目で降圧とアナログ部の修正を求め、2 回目で承認。#19 はデジタルの範囲を終えて閉じました。物理の確認は #8・#10・#13 で続けます。
- **R2 機構モデル** (PR #25、#27、暫定) と配線済み基板との照合 (リビジョン 1 は PR #33、リビジョン 2 は PR #38)。3HP を作業候補として机上で成立、2HP (0.6 mm ずらし) は最悪条件 −0.33 / −0.15 mm で未確定 (任意の別検討)。#17 はデジタルの範囲を終えて閉じました。
- **R4 回路図** (PR #24)。J1・J2・SW1 だけを差し替え、ERC 0、パリティ 0、振る舞いアサーション 51 件合格。

## A5 の作業がどう引き継がれるか

A5 の「次の作業」は次のように扱います。A5 のファイルは変更しません。

| A5 の作業 | A7 での扱い |
|---|---|
| 制御基板の配置・配線を終える | A5 / A6 の 8.8 mm 基板ではなく、A7 の垂直な制御基板で完了 (R4、PR #30、デジタル検証のみ) |
| 電源ケーブルの実装を決める | 引き続き必要 ([#8](https://github.com/Takazudo/zudo-led-block/issues/8))。A7 の機構モデルでは、アダプタを 2.0 mm 前へ移し、PicoBlade の自由長 57 ± 3 mm (±3 は仮定) を要求。実物での確認が必要 |
| 機構の公差と造形 | A7 の機構モデルでは、ジャックの襟とトグルの回り止めをなくし、PMMA 裏の 0.5 mm ポケットで座りと回り止めを取る。基板は 2 個のジャックと印刷のスパインで支える (R2)。PETG での造形・保持力の確認は引き続き必要 |
| 完成回路で保護を再確認 | 引き続き必要 ([#10](https://github.com/Takazudo/zudo-led-block/issues/10))。電源・CV・起動の動作は A5 を維持 |
| 統合試作のリリース準備 | A7 の回路・基板・機構はデジタルでそろった。物理ゲートの解消が先。製造リリースと発注は現在の作業範囲外 |
| 実機の評価 | 引き続き必要 ([#10](https://github.com/Takazudo/zudo-led-block/issues/10)、[#13](https://github.com/Takazudo/zudo-led-block/issues/13)) |

部品証跡カタログでは、メーカー一次資料が取得できなかった項目や、販売店がホストする写し (MANUFACTURER_MIRROR) しか無い項目が `OPEN` のまま残っています。2026-11-09 に PCM/ST/TDK/Molex の一次資料を回収し、確認できた事実だけ更新しました。PCM の在庫は同日の観測でも 0 でした (履歴。SW1 は 2026-11-12 に HX MSK13C02 へ変更)。PJ-324M supplier CAD の検査は物理適合やピン機能の承認ではありません。残りの資料が入手できたら `circuit/WORKFLOW.md` の Workflow C に従い、事実を 1 件ずつ更新します。一括での格上げはしません。

## CI のブラウザ確認 (Chrome の起動待ち)

以前、ドキュメントのジョブの「Framework check-browser」の手順が、開始から約 0.4 秒で `Error: Chrome page target was not available` と出て失敗することがありました。原因は `@takazudo/zudo-circuit-doc@0.3.0` の `lib/browser-smoke/chrome.js` が Chrome のページターゲットを 1 回しか読まないことでした。PR #67 で pnpm の patch (`patches/@takazudo__zudo-circuit-doc@0.3.0.patch`、`pnpm-workspace.yaml` の `patchedDependencies`) を入れ、`/json/list` を最大 10 秒まで待ち、Chrome が終了したらすぐ失敗するようにしました。失敗の無視や再実行の仕組みではありません。この patch は 0.3.0 専用で、上流が同じ修正を出したら外します (`ZUDO_DEPS_PINS.md`)。依存を更新するときは patch がまだ当たるかを確認してください。

## GitHub で追跡している作業

- A7 構造変更: [#15](https://github.com/Takazudo/zudo-led-block/issues/15) (R1 #16・R2 #17・R3 #18・R4 #19 は完了して閉じた。R5 [#20](https://github.com/Takazudo/zudo-led-block/issues/20) と調達観測の整合 [#80](https://github.com/Takazudo/zudo-led-block/issues/80) はこの整合で扱う)
- ハーネス経路、IDC / ストレインリリーフの寸法、公差、PETG の適合 ([#8](https://github.com/Takazudo/zudo-led-block/issues/8))
- 部品証跡カタログの残りの `OPEN` 項目 ([#9](https://github.com/Takazudo/zudo-led-block/issues/9))
- 電源 / CV / FW / 光学 / 温度 / 負荷の統合評価と製造ファイルの準備 ([#10](https://github.com/Takazudo/zudo-led-block/issues/10))
- WS2812B の T1L タイミング ([#13](https://github.com/Takazudo/zudo-led-block/issues/13))
- エージェント向けページを公開するかの判断 ([#12](https://github.com/Takazudo/zudo-led-block/issues/12))
- ホスティングの有効化 ([#11](https://github.com/Takazudo/zudo-led-block/issues/11)。ユーザーがリポジトリ設定を行った後に実ドメインで確認)

[GitHub の Issue 一覧](https://github.com/Takazudo/zudo-led-block/issues) を参照してください。
