Takazudo/zudo-led-block/doc/src/content/docs/project/downloads.mdx

---
# GENERATED by scripts/a5_site.py from engineering/a5/ — do not edit; run `pnpm a5:generate`
title: "ダウンロード"
description: "A5 の公開用に選んだ資料・CAD・アートワーク。SHA-256 は provenance/seed-manifest.json と一致。"
sidebar_position: 5
---

:::caution[製造用データではありません]
STEP は干渉確認用の検討モデル、3MF (非公開) は PLA 設定の未スライス形状確認用です。いずれも製造・造形の適合を保証しません。
:::

サイトに載せるのは `scripts/a5_public_selection.json` で選んだファイルだけで、`engineering/a5/` からバイト単位でコピーされます。KiCad プロジェクト・ファームウェア・SDK・調達証跡などの全ソースは [GitHub リポジトリ](https://github.com/Takazudo/zudo-led-block/tree/main/engineering/a5) を参照してください。元の完全アーカイブ・巨大なテッセレーション JSON・SDK・ツールチェーンは公開しません。

## 資料

| ファイル | サイズ | SHA-256 (先頭) | 注意 | リポジトリ |
| --- | ---: | --- | --- | --- |
| [A5 技術更新レポート (PDF)](/a5/deliverables/light_block_A5_engineering_update.pdf) | 1.58 MiB | `3dadfd52573ceb8f…` | A5 チェックポイント時点の実装・検証範囲・制約。製造リリース文書ではありません。 | [`ソース`](https://github.com/Takazudo/zudo-led-block/blob/main/engineering/a5/deliverables/light_block_A5_engineering_update.pdf) |
| [A5 部品表ワークブック (XLSX)](/a5/deliverables/light_block_A5_parts.xlsx) | 0.04 MiB | `f87d6aa74b3d6baa…` | 2026-11-06 観測の価格帯・在庫で計算した比較表。在庫予約ではありません。 | [`ソース`](https://github.com/Takazudo/zudo-led-block/blob/main/engineering/a5/deliverables/light_block_A5_parts.xlsx) |

## 機構

| ファイル | サイズ | SHA-256 (先頭) | 注意 | リポジトリ |
| --- | ---: | --- | --- | --- |
| [2HP 組立検討モデル (STEP)](/a5/mechanical/exports/2hp/light_block_A5_2hp_assembled.step) | 8.45 MiB | `b42a172a85e8ca3a…` | 干渉確認用の検討モデル。保存済みの配線経路は最終配線として不採用。装着適合は未確認。 | [`ソース`](https://github.com/Takazudo/zudo-led-block/blob/main/engineering/a5/mechanical/exports/2hp/light_block_A5_2hp_assembled.step) |
| [3HP 組立検討モデル (STEP)](/a5/mechanical/exports/3hp/light_block_A5_3hp_assembled.step) | 8.56 MiB | `15026f389acca0d2…` | 2HP と同じ電子回路。装着適合・配線は未確定。 | [`ソース`](https://github.com/Takazudo/zudo-led-block/blob/main/engineering/a5/mechanical/exports/3hp/light_block_A5_3hp_assembled.step) |

## 前面

| ファイル | サイズ | SHA-256 (先頭) | 注意 | リポジトリ |
| --- | ---: | --- | --- | --- |
| [前面 2HP 2 mm PMMA (STEP)](/a5/front_panel/exports/front_A4_2hp_2mm.step) | 0.08 MiB | `7e2c16d553be253e…` | A4 の前面意匠を A5 でも維持。 | [`ソース`](https://github.com/Takazudo/zudo-led-block/blob/main/engineering/a5/front_panel/exports/front_A4_2hp_2mm.step) |
| [前面 3HP 2 mm PMMA (STEP)](/a5/front_panel/exports/front_A4_3hp_2mm.step) | 0.08 MiB | `efd08a40e91b2d9b…` | A4 の前面意匠を A5 でも維持。 | [`ソース`](https://github.com/Takazudo/zudo-led-block/blob/main/engineering/a5/front_panel/exports/front_A4_3hp_2mm.step) |
| [前面 2HP 外形・穴 (DXF)](/a5/front_panel/exports/front_A4_2hp_CUT.dxf) | 0.02 MiB | `5ed6525039028e59…` | 切断データ。 | [`ソース`](https://github.com/Takazudo/zudo-led-block/blob/main/engineering/a5/front_panel/exports/front_A4_2hp_CUT.dxf) |
| [前面 3HP 外形・穴 (DXF)](/a5/front_panel/exports/front_A4_3hp_CUT.dxf) | 0.02 MiB | `e97af8885ff7f83d…` | 切断データ。 | [`ソース`](https://github.com/Takazudo/zudo-led-block/blob/main/engineering/a5/front_panel/exports/front_A4_3hp_CUT.dxf) |
| [裏面彫刻 2HP (DXF, 鏡像済み)](/a5/front_panel/exports/rear_A4_2hp_REAR_FULL_FROST_CLEAR_LETTERS.dxf) | 0.09 MiB | `c8313be31781020b…` | 既に鏡像化済み。再ミラーしないこと。 | [`ソース`](https://github.com/Takazudo/zudo-led-block/blob/main/engineering/a5/front_panel/exports/rear_A4_2hp_REAR_FULL_FROST_CLEAR_LETTERS.dxf) |
| [裏面彫刻 3HP (DXF, 鏡像済み)](/a5/front_panel/exports/rear_A4_3hp_REAR_FULL_FROST_CLEAR_LETTERS.dxf) | 0.09 MiB | `3c88250d36c86e65…` | 既に鏡像化済み。再ミラーしないこと。 | [`ソース`](https://github.com/Takazudo/zudo-led-block/blob/main/engineering/a5/front_panel/exports/rear_A4_3hp_REAR_FULL_FROST_CLEAR_LETTERS.dxf) |
| [裏面彫刻 2HP (SVG, 鏡像済み)](/a5/front_panel/exports/rear_A4_2hp_REAR_FULL_FROST_CLEAR_LETTERS.svg) | 0.04 MiB | `cac28e07934e0f7c…` | 既に鏡像化済み。 | [`ソース`](https://github.com/Takazudo/zudo-led-block/blob/main/engineering/a5/front_panel/exports/rear_A4_2hp_REAR_FULL_FROST_CLEAR_LETTERS.svg) |
| [裏面彫刻 3HP (SVG, 鏡像済み)](/a5/front_panel/exports/rear_A4_3hp_REAR_FULL_FROST_CLEAR_LETTERS.svg) | 0.04 MiB | `1011c8bebda09fa2…` | 既に鏡像化済み。 | [`ソース`](https://github.com/Takazudo/zudo-led-block/blob/main/engineering/a5/front_panel/exports/rear_A4_3hp_REAR_FULL_FROST_CLEAR_LETTERS.svg) |

## 画像

| 画像 | サイズ | SHA-256 (先頭) |
| --- | ---: | --- |
| [2HP 組立検討モデル](/a5/mechanical/exports/2hp/light_block_A5_2hp_assembled.png) | 240 KiB | `19640c4347b1aa08…` |
| [2HP 分解表示](/a5/mechanical/exports/2hp/light_block_A5_2hp_exploded.png) | 271 KiB | `e7f0f7806c9d0a34…` |
| [3HP 組立検討モデル](/a5/mechanical/exports/3hp/light_block_A5_3hp_assembled.png) | 247 KiB | `7002a206881af580…` |
| [3HP 分解表示](/a5/mechanical/exports/3hp/light_block_A5_3hp_exploded.png) | 273 KiB | `07669566d651b6e7…` |
| [制御基板 (未配線) レビュー画像](/a5/electronics/reports/controller_pcb_review.png) | 79 KiB | `d802dd5f99c4cad6…` |
| [LED 基板レビュー画像](/a5/electronics/reports/led_leaf_pcb_review.png) | 33 KiB | `5893af58e59bc86e…` |
| [電源変換基板レビュー画像](/a5/electronics/reports/power_adapter_pcb_review.png) | 29 KiB | `871f2ac72ba8fbbf…` |
| [前面アートワーク (A4 意匠) プレビュー](/a5/deliverables/light_block_A4_front_preview.png) | 625 KiB | `0cd0287f21505f5d…` |
| [2HP 前面の見え方](/a5/front_panel/exports/appearance_A4_front_2hp.png) | 131 KiB | `5bb516587bf1da0c…` |
| [3HP 前面の見え方](/a5/front_panel/exports/appearance_A4_front_3hp.png) | 147 KiB | `d9ad35943e918bea…` |
| [2HP 裏面 (彫刻領域)](/a5/front_panel/exports/appearance_A4_rear_2hp.png) | 130 KiB | `2b4e56b4650576d6…` |
| [3HP 裏面 (彫刻領域)](/a5/front_panel/exports/appearance_A4_rear_3hp.png) | 145 KiB | `dbc9ca48ef24ffa0…` |

完全な SHA-256 は [`provenance/seed-manifest.json`](https://github.com/Takazudo/zudo-led-block/blob/main/provenance/seed-manifest.json) にあります。
