Takazudo/zudo-led-block/engineering/a7/procurement/price-audit/README.md

# A7 部品価格の点検（2026-11-12、2 台分）

JLC の部品 API と料金ページを 2026-11-12 に読んだ時点の値です。見積・在庫確保・発注ではありません。データは `2026-11-12.json`。

## 合計: 部品代 $31.96 → $23.08、部品の段取り料金 $53.57 のまま

| 項目 | 変更前 (PCM13SMTR) | 変更後 (HX MSK13C02) |
|---|---:|---:|
| 部品代（2 台分、購入数 × 段階価格） | $31.96 | $23.08 |
| うち SW1 | $9.10（JLC 在庫 0、予約注文の最小 3 個 × $3.0325） | $0.21（JLC 在庫 4561、2 個 × $0.1069） |
| 部品の段取り料金（Feeder Loading、基板の注文ごと） | $53.57 | $53.57 |
| 計 | $85.53 | $76.65 |

## 段取り料金は部品の種類数で決まり、Basic に替えても減らない

JLC の料金ページ（2026-10-22 更新）では、Standard PCBA は Basic と Extended のどちらも 1 種類 $1.53、Economic PCBA は Extended だけ 1 種類 $3.07 です。コントローラーと LED リーフは両面実装などで Standard、電源アダプタは Economic です（`jlc-package/package.json`）。

| 基板 | 区分 | 種類 | うち Extended | 料金 |
|---|---|---:|---:|---:|
| controller | STANDARD | 28 | 14 | $42.84 |
| led_leaf | STANDARD | 3 | 2 | $4.59 |
| power_adapter | ECONOMIC | 2 | 2 | $6.14 |

コントローラーとリーフでは Extended を Basic に替えても料金は同じで、減らせるのは種類を減らすときだけです。アダプタの 2 種類（Molex 530470310 と 2×5 ヘッダー）はコネクタで、コーディネーターの判断で変えません。セットアップ、ステンシル、はんだ点数、手はんだ、PCB 製造、送料と税は含みません。スルーホール部品が段取り料金に数えられるかは料金ページに書かれていません。

## 部品ごとの値（変更後）

| LCSC | 型番 | 区分 | JLC 在庫 | 購入数 | 単価 | 小計 |
|---|---|---|---:|---:|---:|---:|
| C122442 | 530470310 | EXTENDED | 21090 | 6 | $0.1314 | $0.79 |
| C12891 | CL31A226KAHNNNE | BASIC | 2504817 | 8 | $0.1028 | $0.82 |
| C134375 | BAS70-04-7-F | EXTENDED | 247 | 7 | $0.0723 | $0.51 |
| C140331 | TPS2552DBVR-1 | EXTENDED | 2218 | 2 | $0.8964 | $1.79 |
| C14663 | CC0603KRX7R9BB104 | BASIC | 36497856 | 47 | $0.0060 | $0.28 |
| C15741 | SN74LVC2T45DCUR | EXTENDED | 85126 | 5 | $0.2079 | $1.04 |
| C15850 | CL21A106KAYNNNE | BASIC | 8590360 | 20 | $0.0315 | $0.63 |
| C160404 | SM04B-SRSS-TB(LF)(SN) | EXTENDED | 7443 | 10 | $0.2146 | $2.15 |
| C19666 | CL10A475KO8NNNC | BASIC | 3674763 | 20 | $0.0150 | $0.30 |
| C20526 | MMBT3904(RANGE:100-300) | BASIC | 4184311 | 10 | $0.0103 | $0.10 |
| C2071056 | AP63205WU-7 | EXTENDED | 39789 | 2 | $0.4629 | $0.93 |
| C21190 | 0603WAF1001T5E | BASIC | 28789506 | 20 | $0.0017 | $0.03 |
| C221351 | OPA197IDBVR | EXTENDED | 76583 | 2 | $0.8424 | $1.68 |
| C22355739 | PJ-324M | EXTENDED | 4454 | 4 | $0.2495 | $1.00 |
| C23138 | 0603WAF3300T5E | BASIC | 2413677 | 20 | $0.0020 | $0.04 |
| C23162 | 0603WAF4701T5E | BASIC | 14582556 | 20 | $0.0028 | $0.06 |
| C23231 | 0603WAF6802T5E | BASIC | 786565 | 20 | $0.0016 | $0.03 |
| C23254 | 0603WAF8202T5E | BASIC | 934045 | 20 | $0.0027 | $0.05 |
| C25803 | 0603WAF1003T5E | BASIC | 15162637 | 22 | $0.0029 | $0.06 |
| C25804 | 0603WAF1002T5E | BASIC | 42847861 | 20 | $0.0022 | $0.04 |
| C398363 | TLV9001IDBVR | EXTENDED | 47025 | 5 | $0.0792 | $0.40 |
| C404027 | TLV75533PDBVR | EXTENDED | 75351 | 5 | $0.1216 | $0.61 |
| C50704 | PMEG4010CEJ,115 | EXTENDED | 12689 | 6 | $0.3537 | $2.12 |
| C5149819 | HX MSK13C02 | EXTENDED | 4561 | 2 | $0.1069 | $0.21 |
| C5270180 | STM32G031G8U6TR | EXTENDED | 4507 | 2 | $1.7453 | $3.49 |
| C52917434 | WS2812B-2020-V6 | EXTENDED | 876136 | 18 | $0.0859 | $1.55 |
| C5665 | 2.54-2*5P | EXTENDED | 130239 | 2 | $0.1041 | $0.21 |
| C57112 | 0603B103K500NT | BASIC | 5396447 | 20 | $0.0103 | $0.21 |
| C694586 | SPM4020T-4R7M-LR | EXTENDED | 686 | 5 | $0.3798 | $1.90 |
| C7250 | 0603WAF1005T5E | BASIC | 1022909 | 20 | $0.0022 | $0.04 |

## 次の版で検討する代替候補（未検証、今回は変えない）

| 置き換える部品 | 候補 | LCSC | JLC 在庫 | 単価 (1 個〜) |
|---|---|---|---:|---:|
| BAS70-04-7-F (C134375, D3) | Nexperia BAS70-04,215 | C389351 | 13318 | $0.0732 |
| BAS70-04-7-F (C134375, D3) | onsemi BAS70-04LT1G | C150242 | 12556 | $0.0611 |
| SPM4020T-4R7M-LR (inductor L1) | CENKER CKCSA4020-4.7uH/M | C354583 | 14879 | $0.0462 |

D3 の BAS70-04-7-F は JLC 在庫 247 と少ないので、同じ BAS70-04 の別メーカー品が候補です。L1 の候補は定格と寸法の比較・レビューをしていません。どれも部品根拠の束（owner bundle）はなく、採用には根拠とレビューが要ります。
