Takazudo/zudo-led-block/engineering/a5/electronics/reports/controller_pcb_review.png

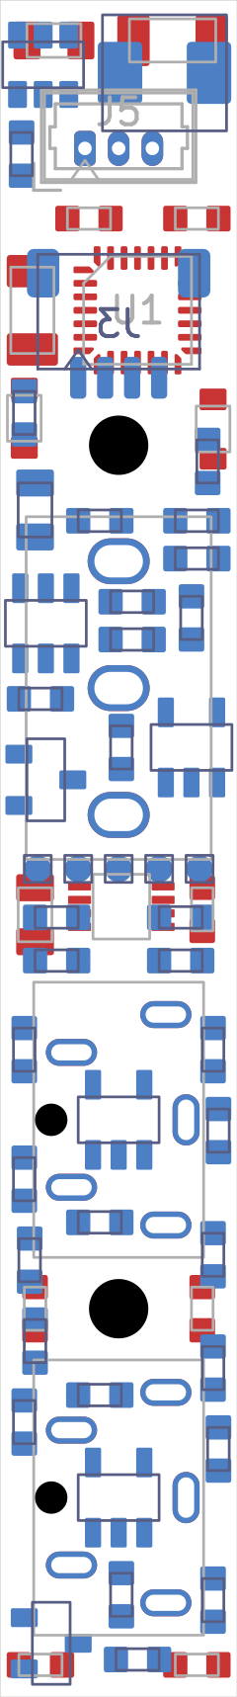
engineering/a5/electronics/reports/controller_pcb_review.png
