Takazudo/zudo-led-block/engineering/a5/electronics/reports/led_leaf_pcb_review.png

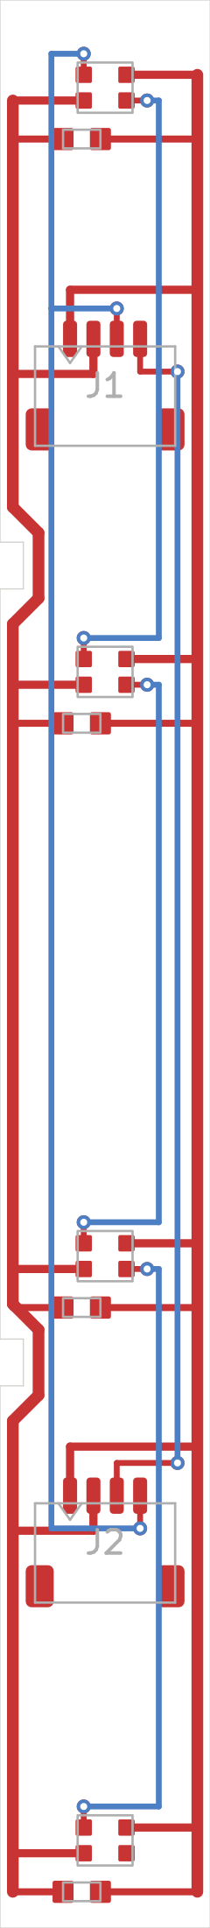
engineering/a5/electronics/reports/led_leaf_pcb_review.png
