Takazudo/zudo-led-block/engineering/a5/electronics/reports/power_adapter_pcb_review.png

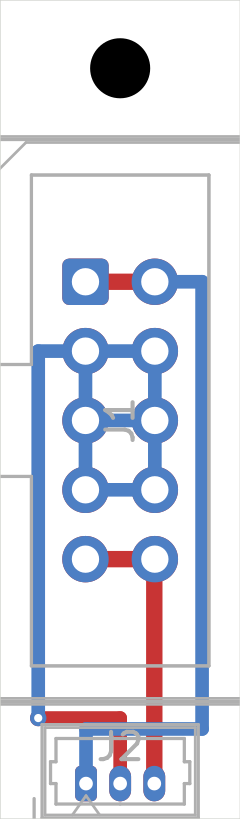
engineering/a5/electronics/reports/power_adapter_pcb_review.png
