Takazudo/zudo-led-block/engineering/a5/front_panel/comparison_A3_holes/exports/appearance_A4_front_2hp.png

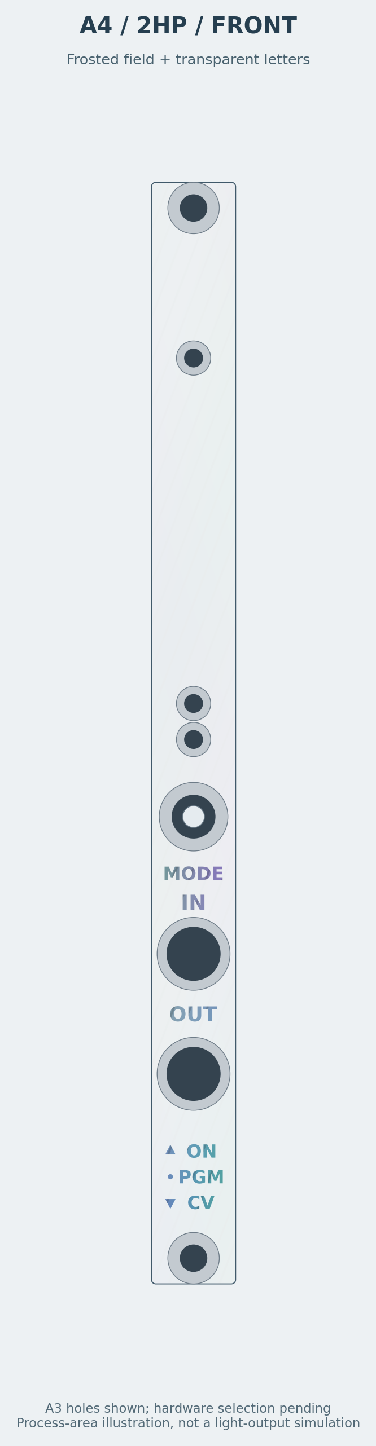
engineering/a5/front_panel/comparison_A3_holes/exports/appearance_A4_front_2hp.png
