Takazudo/zudo-led-block/engineering/a5/front_panel/comparison_A3_holes/exports/appearance_A4_rear_3hp.png

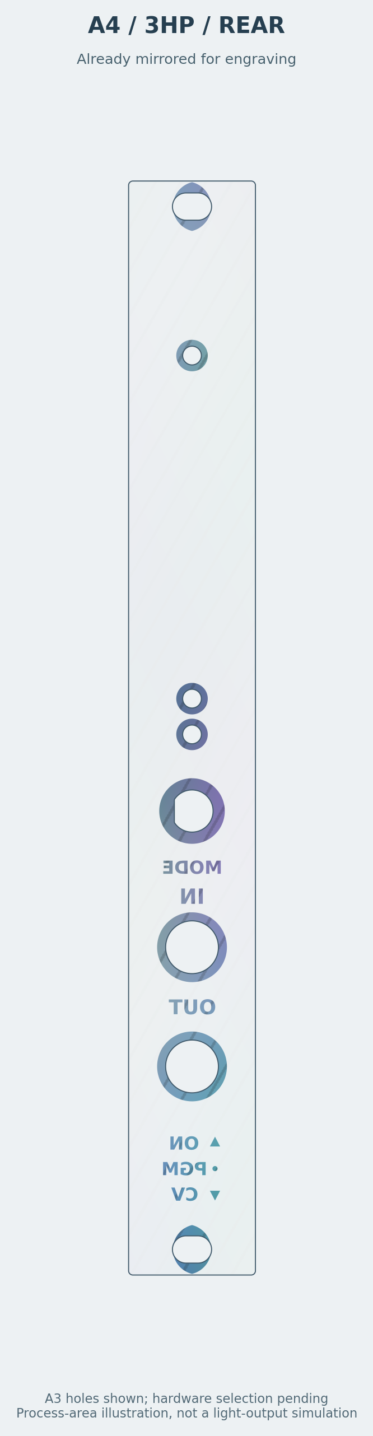
engineering/a5/front_panel/comparison_A3_holes/exports/appearance_A4_rear_3hp.png
