Takazudo/zudo-led-block/engineering/a5/integration/native_schematic/controller/schematic.png

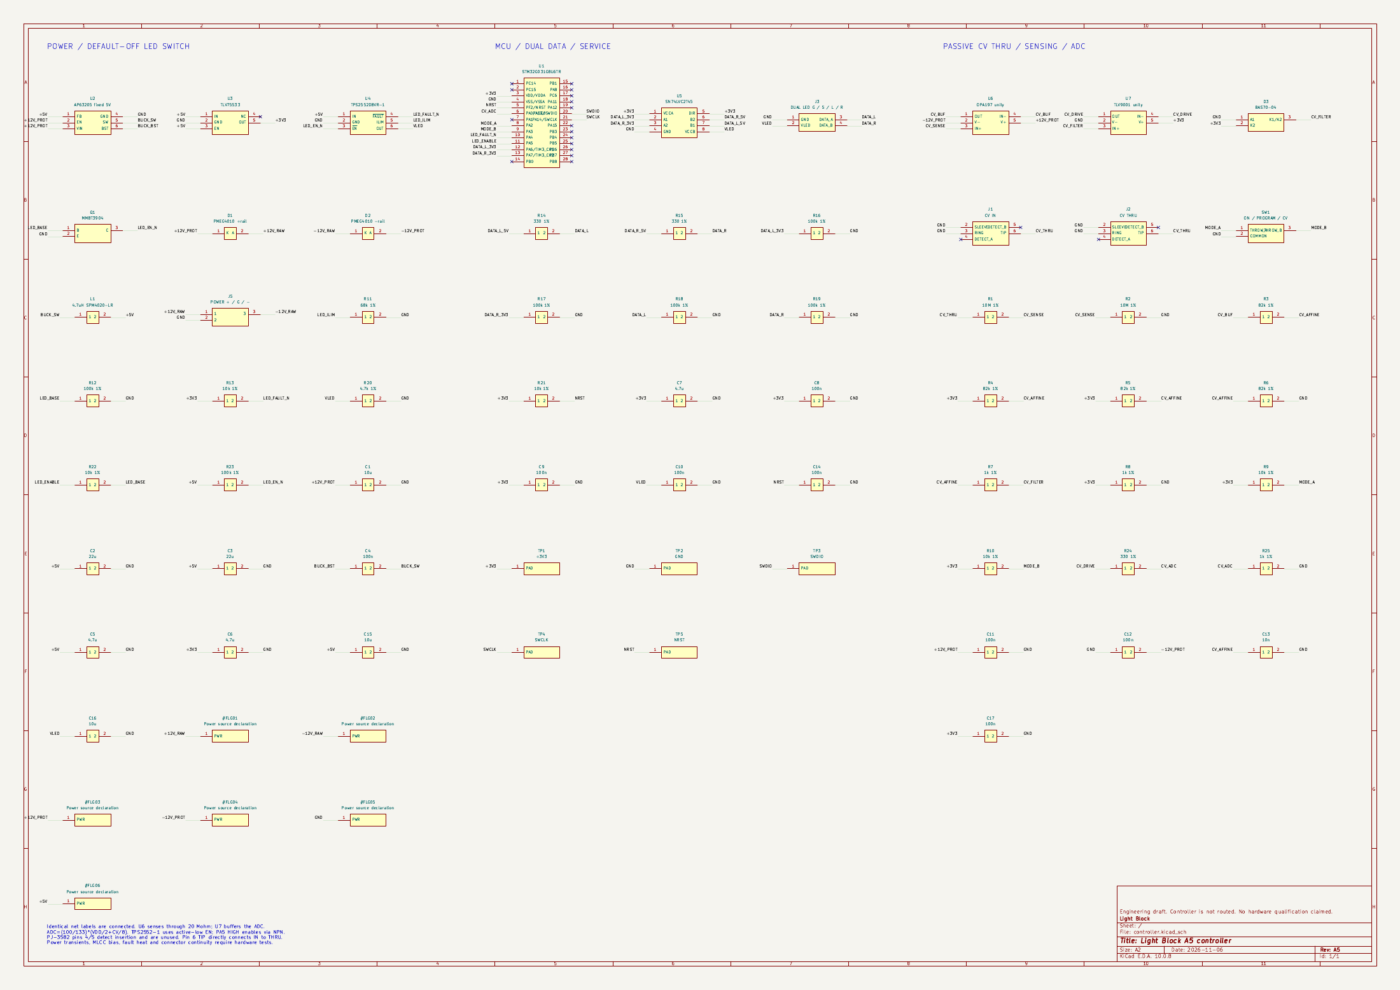
engineering/a5/integration/native_schematic/controller/schematic.png
