Takazudo/zudo-led-block/engineering/a5/integration/native_schematic/led_leaf/schematic.png

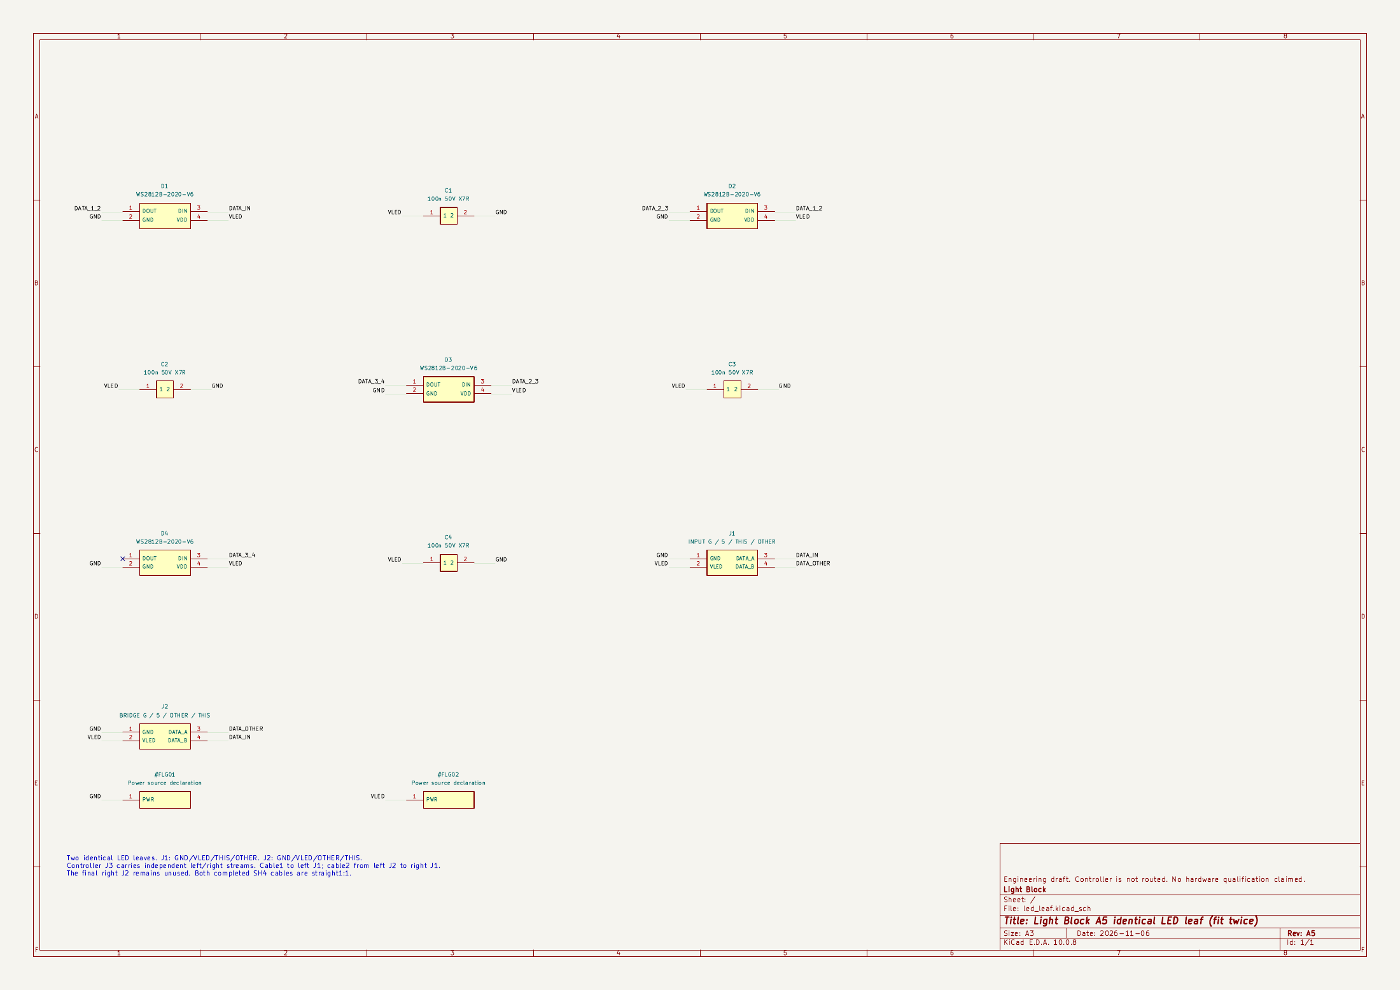
engineering/a5/integration/native_schematic/led_leaf/schematic.png
