Takazudo/zudo-led-block/engineering/a5/integration/native_schematic/power_adapter/schematic.png

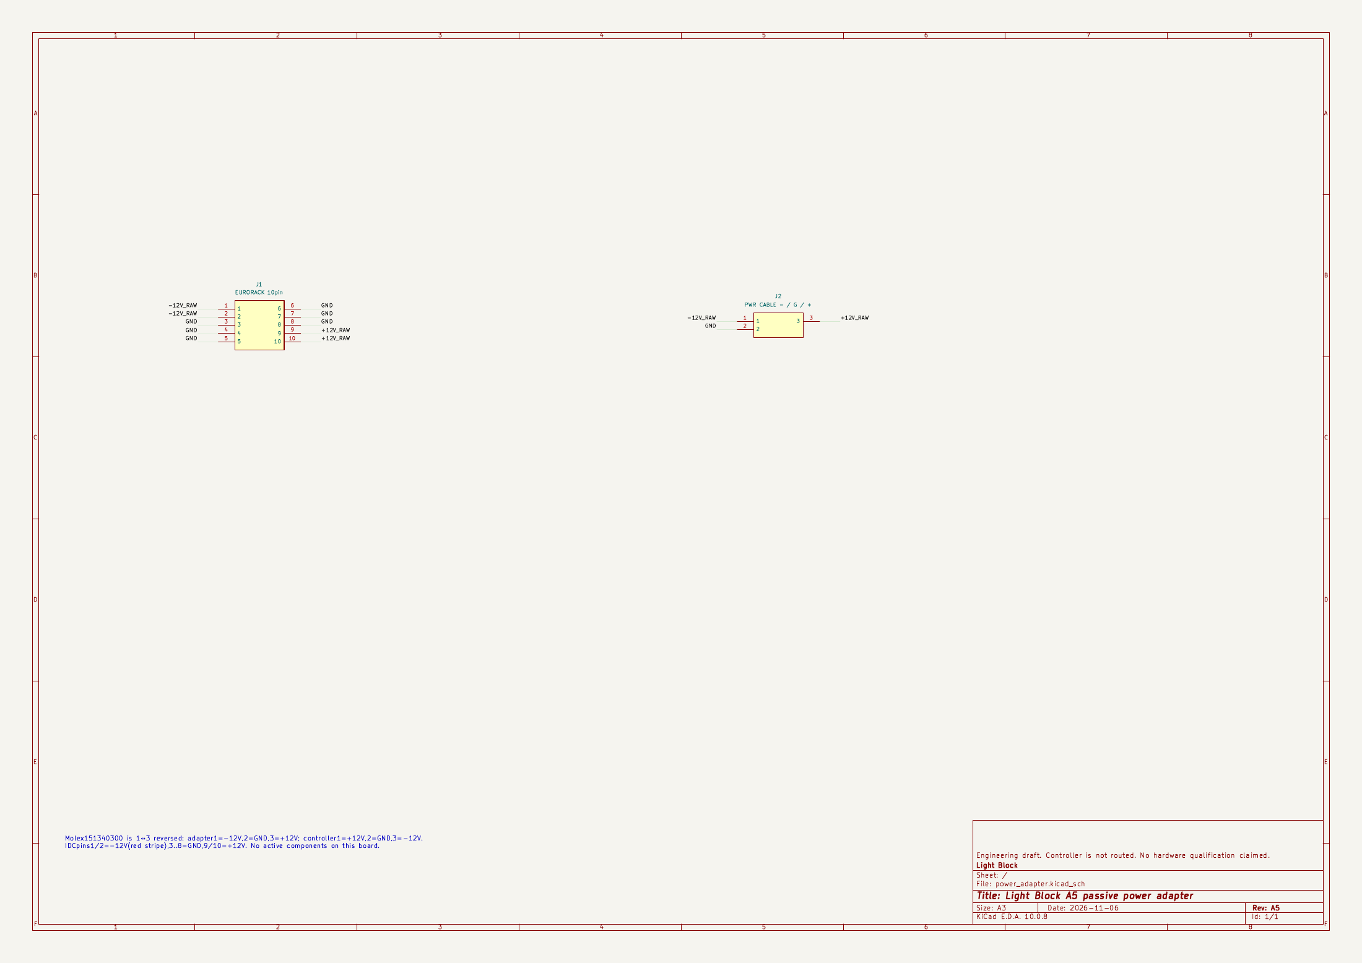
engineering/a5/integration/native_schematic/power_adapter/schematic.png
