Takazudo/zudo-led-block/engineering/a5/mechanical/exports/2hp/light_block_A5_2hp_exploded.png

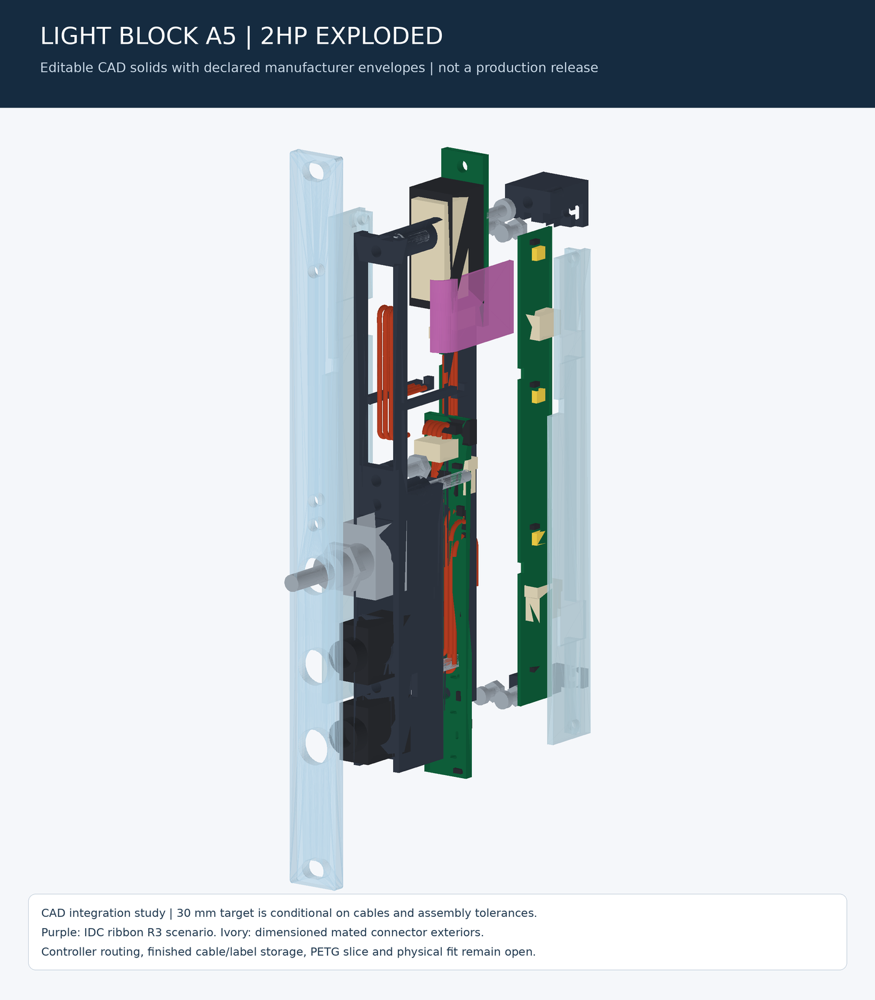
engineering/a5/mechanical/exports/2hp/light_block_A5_2hp_exploded.png
