Takazudo/zudo-led-block/engineering/a7/front_panel/exports/appearance_A7_front_3hp.png

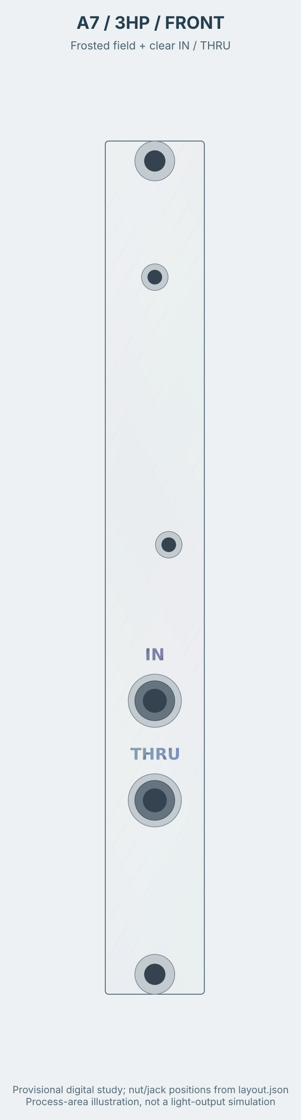
engineering/a7/front_panel/exports/appearance_A7_front_3hp.png
