Takazudo/zudo-led-block/engineering/a7/front_panel/exports/appearance_A7_rear_2hp.png

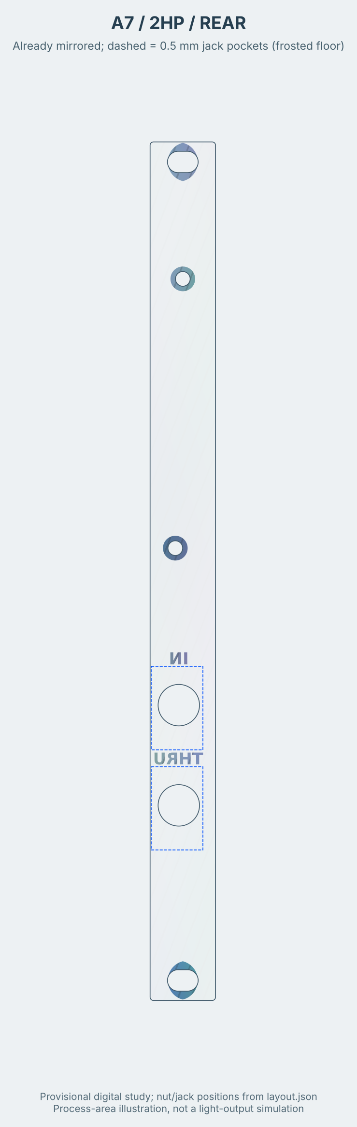
engineering/a7/front_panel/exports/appearance_A7_rear_2hp.png
