Takazudo/zudo-led-block/engineering/a7/mechanical/exports/2hp/view_A7_2hp_front.png

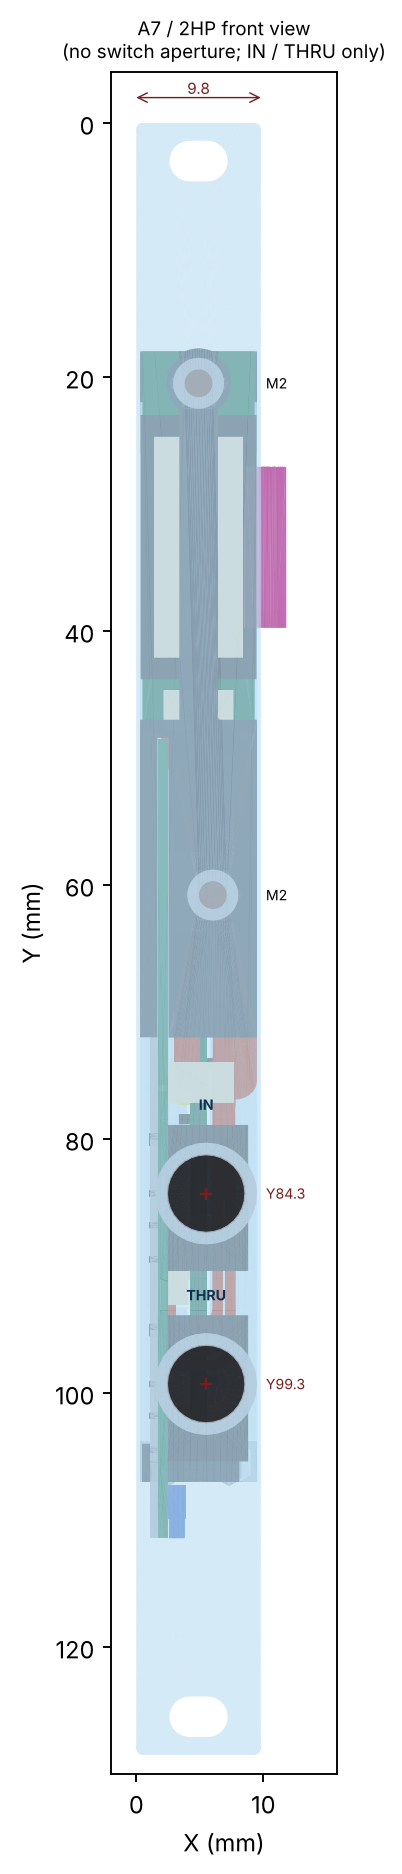
engineering/a7/mechanical/exports/2hp/view_A7_2hp_front.png
