Takazudo/zudo-led-block/engineering/a7/mechanical/exports/2hp/view_A7_2hp_side.png

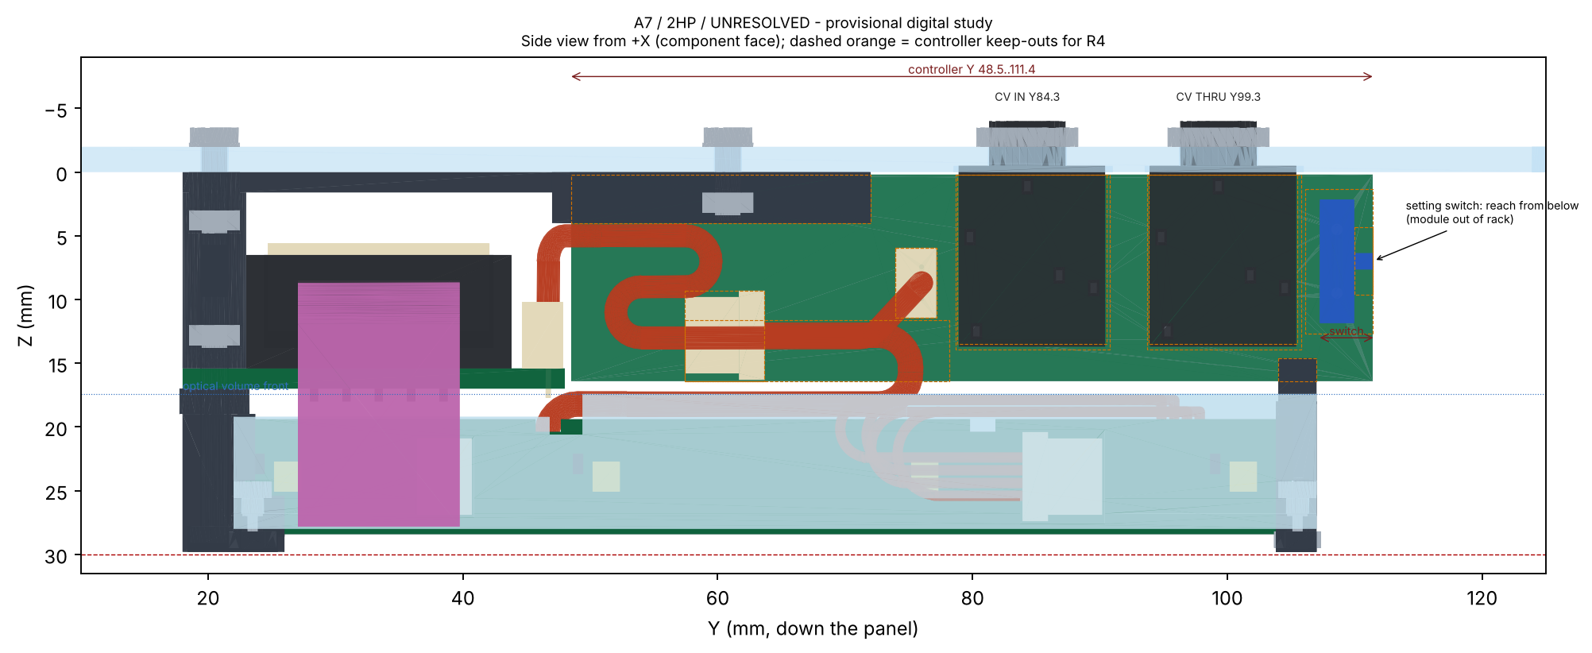
engineering/a7/mechanical/exports/2hp/view_A7_2hp_side.png
