Takazudo/zudo-led-block/engineering/a7/mechanical/exports/3hp/view_A7_3hp_transverse.png

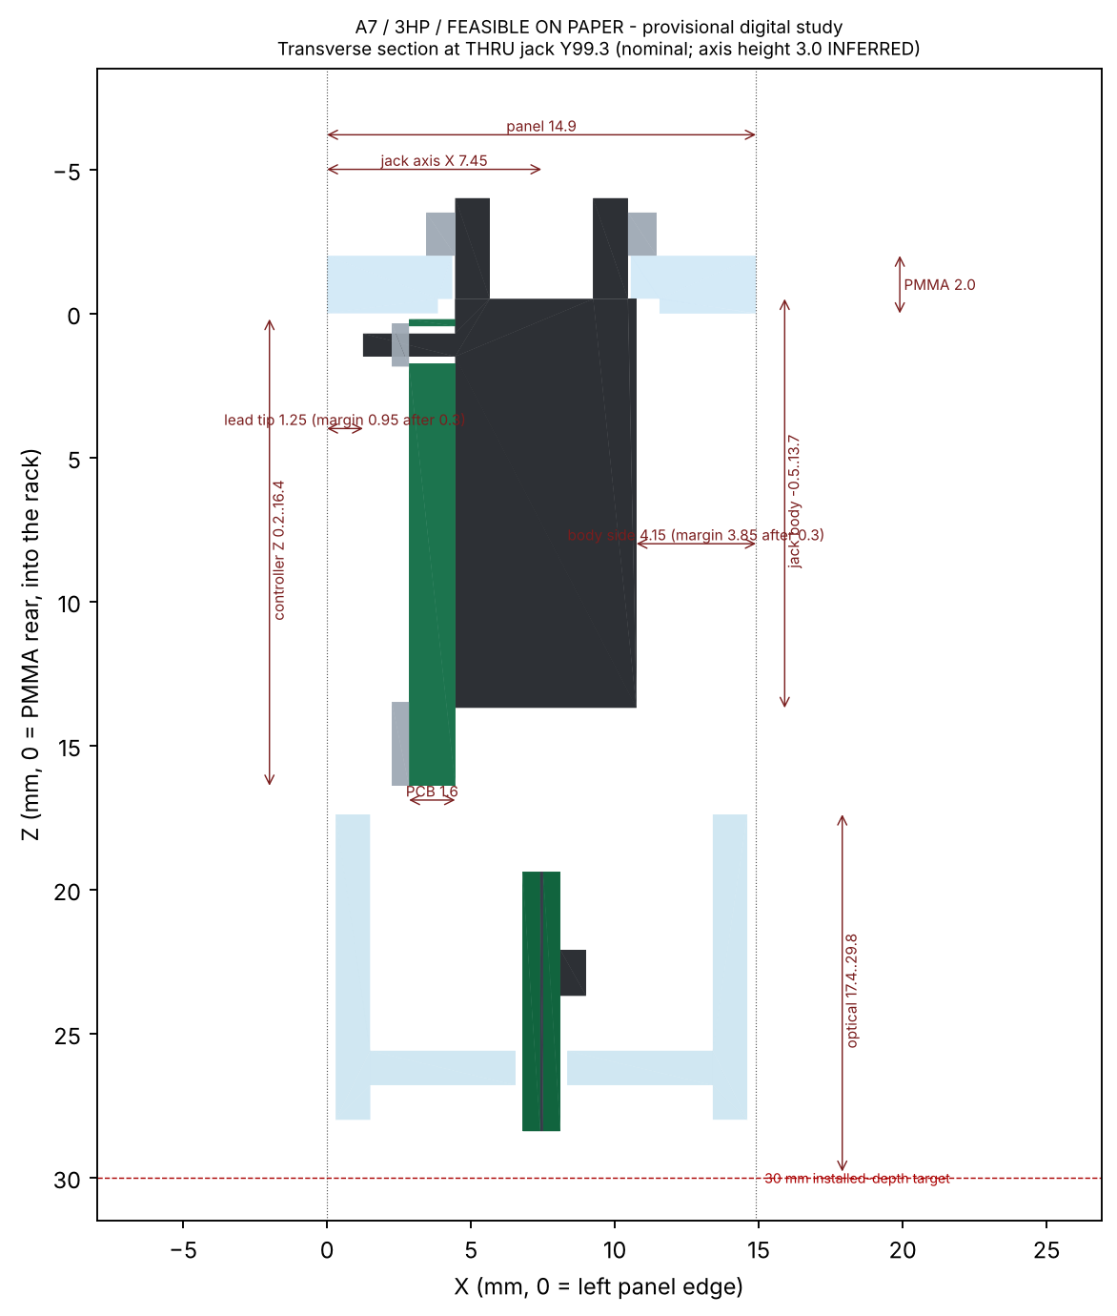
engineering/a7/mechanical/exports/3hp/view_A7_3hp_transverse.png
