Takazudo/zudo-led-block/doc/src/content/docs/project/jlc-order-package.mdx

---
# GENERATED by scripts/a7_jlc_package.py — do not edit; run `python3 scripts/a7_jlc_package.py`
title: "JLCPCB 発注パッケージ（試作用・製造リリースではない）"
description: "最初の 2 台分を JLCPCB に発注するとき、基板ごとに何を入力し何をアップロードするか。試験用試作のためで、製造リリースではありません。"
sidebar_position: 4.6
---

:::danger[製造リリースではありません]
発注ゲートは **BLOCKED** です（製造リリースまでの全条件を数えています）。このページと `engineering/a7/jlc-package/` 直下・`panels/` のファイルは生成器の基準セットで、ここから直接アップロードしません。オーナーが試験用試作ルートでアップロードするのは日付付きの写し（`engineering/a7/jlc-package/order/2026-11-13/`）で、その README にある注文画面での確認（配置プレビューの中心・回転、PCBA 数量の単位、自前パネルの受入、基材・表面処理）の後です。試作ルートのオーナー承認は現在の識別に結び付いています（`engineering/a7/qualification/records.json`）。発注・支払いはオーナーが行い、リポジトリに発注記録はありません。
:::

数量はオーナーの判断で **2 台**です。JLC の PCBA 最小は 2 pcs です（2026-11-12 取得の JLC 公開能力表: Economic 2–50 pcs、Standard 2–80000 pcs。面付けした場合に pcs が単品か面付けシートかは未確認）。

## 止めている項目

- `order-gate-blocked`: readiness の発注ゲートが BLOCKED（製造リリースまでの全条件を数えている）。この基準セットからは直接アップロードしない。オーナーが試作ルートでアップロードするのは `engineering/a7/jlc-package/order/` の日付付きの写しで、その README の注文画面の確認の後。どれも製造リリースではない。
- `controller-repo-panel-acceptance`（コントローラー）: オーナーはリポジトリ面付けを選んだ（`assembly:panel-route`）。1 枚入りの面付け（70 × 76.9 mm）を PCBA 数量 2 で注文し、必要な 2 枚に対し 2 枚。JLC がこの面付けを実装するかはオーナーの知識による判断で、JLC の確認ではない（オーナーは JLC に聞かずに O12 を閉じた。2026-11-12、jlc-questions）。面付けデータは `engineering/a7/jlc-package/panels/` に準備済み（未リリース）。
- `controller-finish-not-specified`（コントローラー）: 表面処理が基板ファイルに記録されていない。注文画面で選ぶ。
- `controller-centroid-offsets`（コントローラー）: J1, J2, J5, SW1 はフットプリント原点がパッド中心から 0.05 mm 以上離れている。JLC は部品中心で置くので、JLC の配置プレビューで 1 点ずつ確かめる。
- `controller-rotation-unverified`（コントローラー）: 回転角は KiCad のフットプリント角度のまま。JLC ライブラリとの向きの差は JLC の配置プレビューで未確認（B 面の部品を含む）。
- `led_leaf-repo-panel-acceptance`（LED リーフ）: オーナーはリポジトリ面付けを選んだ（`assembly:panel-route`）。2 枚入りの面付け（70 × 96.5 mm）を PCBA 数量 2 で注文し、必要な 4 枚に対し 4 枚。JLC がこの面付けを実装するかはオーナーの知識による判断で、JLC の確認ではない（オーナーは JLC に聞かずに O12 を閉じた。2026-11-12、jlc-questions）。面付けデータは `engineering/a7/jlc-package/panels/` に準備済み（未リリース）。
- `led_leaf-finish-not-specified`（LED リーフ）: 表面処理が基板ファイルに記録されていない。注文画面で選ぶ。
- `led_leaf-rotation-unverified`（LED リーフ）: 回転角は KiCad のフットプリント角度のまま。JLC ライブラリとの向きの差は JLC の配置プレビューで未確認。
- `power_adapter-repo-panel-acceptance`（電源アダプタ）: オーナーはリポジトリ面付けを選んだ（`assembly:panel-route`）。1 枚入りの面付け（22.8 × 44 mm）を PCBA 数量 2 で注文し、必要な 2 枚に対し 2 枚。JLC がこの面付けを実装するかはオーナーの知識による判断で、JLC の確認ではない（オーナーは JLC に聞かずに O12 を閉じた。2026-11-12、jlc-questions）。面付けデータは `engineering/a7/jlc-package/panels/` に準備済み（未リリース）。
- `power_adapter-finish-not-specified`（電源アダプタ）: 表面処理が基板ファイルに記録されていない。注文画面で選ぶ（Economic の 1.6 mm 緑は HASL か ENIG）。
- `power_adapter-centroid-offsets`（電源アダプタ）: J1, J2 はフットプリント原点がパッド中心から 0.05 mm 以上離れている。JLC は部品中心で置くので、JLC の配置プレビューで 1 点ずつ確かめる。
- `power_adapter-rotation-unverified`（電源アダプタ）: 回転角は KiCad のフットプリント角度のまま。JLC ライブラリとの向きの差は JLC の配置プレビューで未確認。
- `pcba-quantity-unit-with-panel-not-sourced`: JLC 能力表の PCBA 最小は「2 pcs」。Panel by JLCPCB では PCB の数量は面付けシートの枚数（JLC の説明: 10 pcs 注文で 10 シート）。PCBA の数量もシート数か、2 枚以上載った 1 シートで最小 2 pcs を満たすかは未取得。JLC の注文画面かサポートで確かめる質問: "With Panel by JLCPCB, does the PCBA Qty count panels or single boards, and does one panel holding 2 or more boards meet the 2-pcs PCBA minimum, or must 2 panels be assembled?"。オーナーは JLC に聞かずに、Gerber ごとに PCBA 数量 2 以上で注文すると述べた（jlc-questions）。オーナーの知識による判断で、JLC の確認ではない。
- `pcb-fabrication-quantity-not-sourced`: JLC が 1 設計あたり製造する基板の最小枚数は未取得。PCBA の数量（コントローラー 2・リーフ 4・電源アダプタ 2）とは別に入力する。
- `physical-jack-switch-qualification`（コントローラー）: PJ-324M の端子 4/5 の機能は未確認。オーナーは発注前の導通試験を見送り、リスクを受け入れた（2026-11-12、jack-tip-test-waiver）。端子 5 が tip なら両方のジャックが働かず、制御基板の改版が要る。確認は組み立て済み基板の初品検査として残る。

## コントローラー（`controller`）

PCB 注文画面に入れる値（材料以外は基板ファイル `engineering/a7/electronics/controller/controller.kicad_pcb` から読んだもの）:

| 項目 | 値 |
|---|---|
| Base Material | FR-4（`engineering/a7/mechanical/layout.json decision.working_candidate`。基板ファイルには材料の記録なし） |
| Layers | 4 |
| Dimensions | 16.2 × 62.9 mm |
| PCB Thickness | 1.6 mm（JLC 公差 ±10%） |
| Surface Finish | 基板ファイルに指定なし（注文時に選ぶ） |
| 最小穴径 | 0.2 mm |
| PCB Assembly | オン。必要な完成品は単品 2 枚（1 枚/台 × 2 台）。面付け時に PCBA Qty をシート数で入れるかは未確認（`pcba-quantity-unit-with-panel-not-sourced`） |
| PCBA Type | Standard（理由: 両面に部品がある（Economic は片面のみ）） |
| Assembly Side | Top と Bottom（両面） |
| Panel By JLCPCB | No（オーナーの判断でリポジトリ面付け。面付けは Gerber 側） |
| 実装点 | SMD 56・THT 3（J1, J2, J5） |

Economic で単品実装できるか（2026-11-12 の JLC 能力表と部品ページで判定）:

| 条件 | この基板 | 判定 |
|---|---|---|
| 全部品が JLC 部品ページで Economic 可 | all "Economic and Standard" | 満たす |
| 片面実装 | Bottom + Top | **満たさない** |
| 板厚 0.8–1.6 mm | 1.6 mm | 満たす |
| 銅層 2・4・6 | 4 | 満たす |
| 0402 より小さい部品なし（フットプリント名） | none | 満たす |
| パッド中心間隔 0.4 mm 以上（4 パッド以上の SMD） | 0.5 mm min | 満たす |
| 数量 2–50 | 2 | 満たす |
| 単品 10 × 10 mm 以上 | 16.2 × 62.9 mm | 満たす |

結論: 単品では受けてもらえません。Standard PCBA で、面付けの経路を 2 つ比べました（PCBA 数量がシート数で最小 2 シートと仮定。未確認）。

| | JLC が面付け（Panel by JLCPCB） | リポジトリで面付け（準備済み・未リリース） |
|---|---|---|
| 1 シート | 5 列 × 2 行 = 10 枚（レールなしで 81 × 125.8 mm。JLC は既定で 5 mm の縁を足す） | 1 枚、70 × 76.9 mm（5 mm レール込み、最小 70 × 70 mm） |
| 2 シートで実装される枚数（必要 2） | 20 | 2 |
| 分割 | V-cut かマウスバイト | マウスバイト、タブ幅 5 mm 以上 |
| フィデューシャル | Edge Rails をオンにすると JLC がレールに付ける | レールに 1 mm（縁から 3.85 mm）と 2 mm の治具穴（JLC の SMT 指針） |
| 未確認・注意 | 部品のコートヤードが基板外形から 2 mm の基板間隔より大きくはみ出す（J2 4.45 mm, J1 4.45 mm）。JLC の面付けでその逃げを確保できるかは注文画面では指定できない。 | J2, J3, SW1, J1 のはみ出しに 1 mm（提案値）を足して枠を逃がす。タブは 2 か所以上置ける限りその部品から離し、置けない場合はパッドからだけ離す（面付けの注記を参照）。JLC が 1 枚だけの面付けを受けるかは注文時に確認。 |

推奨: **リポジトリで面付け**（余る実装基板が最も少ない）。**オーナーの判断: リポジトリ面付け**（2026-11-12、`assembly:panel-route`、記録 `engineering/a7/procurement/owner-decisions.json`）。種類ごとに 1 つの Gerber を PCBA 数量 2 で注文します。JLC がこの面付けを実装するかはオーナーの知識による判断で、JLC の確認ではない（オーナーは JLC に聞かずに O12 を閉じた。jlc-questions）。リポジトリ面付けのデータは準備済みですが、リリースではありません（下の「リポジトリ面付けでアップロードするもの」）。

アップロードするもの（使わない経路: JLC 面付け。参考に残す）:

1. Gerber と drill の zip: `python3 scripts/a7_jlc_package.py export --out <リポジトリ外の空ディレクトリ>` で作る `controller-gerbers-DRYRUN.zip`（Gerber 原点: absolute (page) coordinates）
2. BOM: `engineering/a7/jlc-package/controller_BOM_DRYRUN.csv`（28 行、列 Comment / Designator / Footprint / JLCPCB Part #）
3. CPL: `engineering/a7/jlc-package/controller_CPL_DRYRUN.csv`（59 行、列 Designator / Mid X / Mid Y / Rotation / Layer、mm）

リポジトリ面付けでアップロードするもの（オーナーが選んだ経路。基準セットで、アップロードは日付付きの写しから。製造リリースではない）:

1. Gerber と drill の zip: `python3 scripts/a7_panel.py build --out <リポジトリ外の空ディレクトリ>` で作る `controller-panel-gerbers-DRYRUN.zip`（70 × 76.9 mm、1 枚載せ。注文画面の Dimensions はこのシート寸法、Panel By JLCPCB は No）
2. BOM: `engineering/a7/jlc-package/panels/controller-panel_BOM_DRYRUN.csv`（2 枚目以降の designator は `_2` などの接尾辞）
3. CPL: `engineering/a7/jlc-package/panels/controller-panel_CPL_DRYRUN.csv`（シート左上の外形角が原点、mm）

シートの作り: 5 mm のレール、基板まわり 2 mm 以上の切り溝、5 mm のマウスバイトタブ（1 枚目 4 か所、穴 0.6 mm・間隔 0.25 mm）、1 mm フィデューシャル 3 個（両面）、2 mm 治具穴 3 個。フィデューシャルの横位置（シート幅の 30 %・70 %）とタブの位置・数は提案で、JLC の規則ではありません。`a7_panel.py build`（CI の native ジョブで毎回実行）が、保存した面付け基板を読み直して次を確かめます: 各基板の部品・パッド（各層の寸法・形・マスク/ペースト余白）・配線・ビア・ゾーン（塗りつぶし形状）・図形・文字が凍結ファイルと移動量を除いて一致すること、面付けの Edge.Cuts から求めた各基板の外形が凍結ファイルの外形と一致すること、穴（長穴を含む）が凍結ファイルの穴＋マウスバイト穴＋治具穴と一致すること、フィデューシャルが計画どおりの位置にあること、面付け DRC の違反数が元の基板の違反数（×枚数）と種類ごとに一致すること（記録した例外は件数も固定）、CPL が KiCad の位置出力と一致すること。Gerber どうしの比較はしていません。マウスバイト穴は基板の縁の外に置くので、分割後は各タブの位置に最大約 0.3 mm の突起が残り、実物の外形は凍結ファイルの外形より少し出ます。

JLC の配置プレビューで中心を確かめる部品（フットプリント原点がパッド中心から離れているもの）:

| Ref | LCSC | 原点からパッド中心まで |
|---|---|---:|
| J1 | C22355739 | 7.358 mm |
| J2 | C22355739 | 7.358 mm |
| J5 | C122442 | 1.25 mm |
| SW1 | C5149819 | 0.568 mm |

## LED リーフ（`led_leaf`）

PCB 注文画面に入れる値（材料以外は基板ファイル `engineering/a5/electronics/native/led_leaf/led_leaf.kicad_pcb` から読んだもの）:

| 項目 | 値 |
|---|---|
| Base Material | FR-4（`engineering/a7/mechanical/layout.json leaf_comparison.default`。基板ファイルには材料の記録なし） |
| Layers | 2 |
| Dimensions | 9 × 82.5 mm |
| PCB Thickness | 0.6 mm（JLC 公差 ±0.1 mm。A5 の寸法を引き継いだ凍結値で、1.6 mm ではない。0.6 mm は JLC の FR-4 の選択肢にある） |
| Surface Finish | 基板ファイルに指定なし（注文時に選ぶ） |
| 最小穴径 | 0.3 mm |
| PCB Assembly | オン。必要な完成品は単品 4 枚（2 枚/台 × 2 台）。面付け時に PCBA Qty をシート数で入れるかは未確認（`pcba-quantity-unit-with-panel-not-sourced`） |
| PCBA Type | Standard（理由: C52917434 は 2026-11-12 の JLC 部品ページで Standard のみ、板厚 0.6 mm（Economic は 0.8–1.6 mm）） |
| Assembly Side | Top |
| Panel By JLCPCB | No（オーナーの判断でリポジトリ面付け。面付けは Gerber 側） |
| 実装点 | SMD 10・THT 0 |

Economic で単品実装できるか（2026-11-12 の JLC 能力表と部品ページで判定）:

| 条件 | この基板 | 判定 |
|---|---|---|
| 全部品が JLC 部品ページで Economic 可 | "Standard Only": C52917434 | **満たさない** |
| 片面実装 | Top | 満たす |
| 板厚 0.8–1.6 mm | 0.6 mm | **満たさない** |
| 銅層 2・4・6 | 2 | 満たす |
| 0402 より小さい部品なし（フットプリント名） | none | 満たす |
| パッド中心間隔 0.4 mm 以上（4 パッド以上の SMD） | 1 mm min | 満たす |
| 数量 2–50 | 4 | 満たす |
| 単品 10 × 10 mm 以上 | 9 × 82.5 mm | **満たさない** |

結論: 単品では受けてもらえません。Standard PCBA で、面付けの経路を 2 つ比べました（PCBA 数量がシート数で最小 2 シートと仮定。未確認）。

| | JLC が面付け（Panel by JLCPCB） | リポジトリで面付け（準備済み・未リリース） |
|---|---|---|
| 1 シート | 8 列 × 1 行 = 8 枚（レールなしで 72 × 82.5 mm。JLC は既定で 5 mm の縁を足す） | 2 枚、70 × 96.5 mm（5 mm レール込み、最小 70 × 70 mm） |
| 2 シートで実装される枚数（必要 4） | 16 | 4 |
| 分割 | V-cut かマウスバイト。辺が 15 mm 未満なので V-cut は追加料金 | マウスバイト、タブ幅 5 mm 以上 |
| フィデューシャル | Edge Rails をオンにすると JLC がレールに付ける | レールに 1 mm（縁から 3.85 mm）と 2 mm の治具穴（JLC の SMT 指針） |
| 未確認・注意 | 外形が単純な長方形ではない（Edge.Cuts 12 本）。JLC は Panel by JLCPCB には単純な外形を求め、複雑な外形は自分で面付けするよう書いている。この外形で Panel by JLCPCB を受けてもらえるか。 | 板厚 0.6 mm: JLC は 0.4・0.6 mm の基板に印刷・実装・リフローでキャリアを使う。捨て基板の部分は抜かずに FR-4 のまま残す。JLC がこの面付けを受けるかは注文時に確認。 |

推奨: **リポジトリで面付け**（余る実装基板が最も少ない）。**オーナーの判断: リポジトリ面付け**（2026-11-12、`assembly:panel-route`、記録 `engineering/a7/procurement/owner-decisions.json`）。種類ごとに 1 つの Gerber を PCBA 数量 2 で注文します。JLC がこの面付けを実装するかはオーナーの知識による判断で、JLC の確認ではない（オーナーは JLC に聞かずに O12 を閉じた。jlc-questions）。リポジトリ面付けのデータは準備済みですが、リリースではありません（下の「リポジトリ面付けでアップロードするもの」）。

アップロードするもの（使わない経路: JLC 面付け。参考に残す）:

1. Gerber と drill の zip: `python3 scripts/a7_jlc_package.py export --out <リポジトリ外の空ディレクトリ>` で作る `led_leaf-gerbers-DRYRUN.zip`（Gerber 原点: absolute (page) coordinates）
2. BOM: `engineering/a7/jlc-package/led_leaf_BOM_DRYRUN.csv`（3 行、列 Comment / Designator / Footprint / JLCPCB Part #）
3. CPL: `engineering/a7/jlc-package/led_leaf_CPL_DRYRUN.csv`（10 行、列 Designator / Mid X / Mid Y / Rotation / Layer、mm）

リポジトリ面付けでアップロードするもの（オーナーが選んだ経路。基準セットで、アップロードは日付付きの写しから。製造リリースではない）:

1. Gerber と drill の zip: `python3 scripts/a7_panel.py build --out <リポジトリ外の空ディレクトリ>` で作る `led_leaf-panel-gerbers-DRYRUN.zip`（70 × 96.5 mm、2 枚載せ。注文画面の Dimensions はこのシート寸法、Panel By JLCPCB は No）
2. BOM: `engineering/a7/jlc-package/panels/led_leaf-panel_BOM_DRYRUN.csv`（2 枚目以降の designator は `_2` などの接尾辞）
3. CPL: `engineering/a7/jlc-package/panels/led_leaf-panel_CPL_DRYRUN.csv`（シート左上の外形角が原点、mm）

シートの作り: 5 mm のレール、基板まわり 2 mm 以上の切り溝、5 mm のマウスバイトタブ（1 枚目 3 か所・2 枚目 3 か所、穴 0.6 mm・間隔 0.25 mm）、1 mm フィデューシャル 3 個（表面）、2 mm 治具穴 3 個。フィデューシャルの横位置（シート幅の 30 %・70 %）とタブの位置・数は提案で、JLC の規則ではありません。`a7_panel.py build`（CI の native ジョブで毎回実行）が、保存した面付け基板を読み直して次を確かめます: 各基板の部品・パッド（各層の寸法・形・マスク/ペースト余白）・配線・ビア・ゾーン（塗りつぶし形状）・図形・文字が凍結ファイルと移動量を除いて一致すること、面付けの Edge.Cuts から求めた各基板の外形が凍結ファイルの外形と一致すること、穴（長穴を含む）が凍結ファイルの穴＋マウスバイト穴＋治具穴と一致すること、フィデューシャルが計画どおりの位置にあること、面付け DRC の違反数が元の基板の違反数（×枚数）と種類ごとに一致すること（記録した例外は件数も固定）、CPL が KiCad の位置出力と一致すること。Gerber どうしの比較はしていません。マウスバイト穴は基板の縁の外に置くので、分割後は各タブの位置に最大約 0.3 mm の突起が残り、実物の外形は凍結ファイルの外形より少し出ます。

## 電源アダプタ（`power_adapter`）

PCB 注文画面に入れる値（材料以外は基板ファイル `engineering/a5/electronics/native/power_adapter/power_adapter.kicad_pcb` から読んだもの）:

| 項目 | 値 |
|---|---|
| Base Material | 基板ファイルにもレイアウト記録にも材料の記録なし（注文画面で選ぶ） |
| Layers | 2 |
| Dimensions | 8.8 × 30 mm |
| PCB Thickness | 1.6 mm（JLC 公差 ±10%） |
| Surface Finish | 基板ファイルに指定なし（注文時に選ぶ） |
| 最小穴径 | 0.3 mm |
| PCB Assembly | オン。必要な完成品は単品 2 枚（1 枚/台 × 2 台）。面付け時に PCBA Qty をシート数で入れるかは未確認（`pcba-quantity-unit-with-panel-not-sourced`） |
| PCBA Type | Economic |
| Assembly Side | Top |
| Panel By JLCPCB | No（オーナーの判断でリポジトリ面付け。面付けは Gerber 側） |
| 実装点 | SMD 0・THT 2（J1, J2） |

Economic で単品実装できるか（2026-11-12 の JLC 能力表と部品ページで判定）:

| 条件 | この基板 | 判定 |
|---|---|---|
| 全部品が JLC 部品ページで Economic 可 | all "Economic and Standard" | 満たす |
| 片面実装 | Top | 満たす |
| 板厚 0.8–1.6 mm | 1.6 mm | 満たす |
| 銅層 2・4・6 | 2 | 満たす |
| 0402 より小さい部品なし（フットプリント名） | none | 満たす |
| パッド中心間隔 0.4 mm 以上（4 パッド以上の SMD） | no SMD footprint with 4+ pads | 満たす |
| 数量 2–50 | 2 | 満たす |
| 単品 10 × 10 mm 以上 | 8.8 × 30 mm | **満たさない** |

結論: 単品では受けてもらえません。Economic PCBA で、面付けの経路を 2 つ比べました（PCBA 数量がシート数で最小 2 シートと仮定。未確認）。

| | JLC が面付け（Panel by JLCPCB） | リポジトリで面付け（準備済み・未リリース） |
|---|---|---|
| 1 シート | 2 列 × 1 行 = 2 枚（レールなしで 17.6 × 30 mm。JLC は既定で 5 mm の縁を足す） | 1 枚、22.8 × 44 mm（5 mm レール込み、最小 10 × 10 mm） |
| 2 シートで実装される枚数（必要 2） | 4 | 2 |
| 分割 | マウスバイト（Economic では V-cut 不可） | マウスバイト、タブ幅 5 mm 以上 |
| フィデューシャル | 不要（Economic） | レールに 1 mm（縁から 3.85 mm）と 2 mm の治具穴（JLC の SMT 指針） |
| 未確認・注意 | JLC は Panel by JLCPCB を V-cut で説明しており、V-cut は Economic 実装では使えない。Economic のまま Panel by JLCPCB をマウスバイトで作れるか。できなければ Standard で 70 × 70 mm の面付け（レールなしで 8 × 3 = 24 枚）になる。 | J2, J1 のはみ出しに 1 mm（提案値）を足して枠を逃がす。タブは 2 か所以上置ける限りその部品から離し、置けない場合はパッドからだけ離す（面付けの注記を参照）。JLC が 1 枚だけの面付けを受けるかは注文時に確認。 |

推奨: **リポジトリで面付け**（余る実装基板が最も少ない）。**オーナーの判断: リポジトリ面付け**（2026-11-12、`assembly:panel-route`、記録 `engineering/a7/procurement/owner-decisions.json`）。種類ごとに 1 つの Gerber を PCBA 数量 2 で注文します。JLC がこの面付けを実装するかはオーナーの知識による判断で、JLC の確認ではない（オーナーは JLC に聞かずに O12 を閉じた。jlc-questions）。リポジトリ面付けのデータは準備済みですが、リリースではありません（下の「リポジトリ面付けでアップロードするもの」）。

アップロードするもの（使わない経路: JLC 面付け。参考に残す）:

1. Gerber と drill の zip: `python3 scripts/a7_jlc_package.py export --out <リポジトリ外の空ディレクトリ>` で作る `power_adapter-gerbers-DRYRUN.zip`（Gerber 原点: absolute (page) coordinates）
2. BOM: `engineering/a7/jlc-package/power_adapter_BOM_DRYRUN.csv`（2 行、列 Comment / Designator / Footprint / JLCPCB Part #）
3. CPL: `engineering/a7/jlc-package/power_adapter_CPL_DRYRUN.csv`（2 行、列 Designator / Mid X / Mid Y / Rotation / Layer、mm）

リポジトリ面付けでアップロードするもの（オーナーが選んだ経路。基準セットで、アップロードは日付付きの写しから。製造リリースではない）:

1. Gerber と drill の zip: `python3 scripts/a7_panel.py build --out <リポジトリ外の空ディレクトリ>` で作る `power_adapter-panel-gerbers-DRYRUN.zip`（22.8 × 44 mm、1 枚載せ。注文画面の Dimensions はこのシート寸法、Panel By JLCPCB は No）
2. BOM: `engineering/a7/jlc-package/panels/power_adapter-panel_BOM_DRYRUN.csv`（2 枚目以降の designator は `_2` などの接尾辞）
3. CPL: `engineering/a7/jlc-package/panels/power_adapter-panel_CPL_DRYRUN.csv`（シート左上の外形角が原点、mm）

シートの作り: 5 mm のレール、基板まわり 2 mm 以上の切り溝、5 mm のマウスバイトタブ（1 枚目 5 か所、穴 0.6 mm・間隔 0.25 mm）、1 mm フィデューシャル 3 個（表面）、2 mm 治具穴 3 個。フィデューシャルの横位置（シート幅の 30 %・70 %）とタブの位置・数は提案で、JLC の規則ではありません。`a7_panel.py build`（CI の native ジョブで毎回実行）が、保存した面付け基板を読み直して次を確かめます: 各基板の部品・パッド（各層の寸法・形・マスク/ペースト余白）・配線・ビア・ゾーン（塗りつぶし形状）・図形・文字が凍結ファイルと移動量を除いて一致すること、面付けの Edge.Cuts から求めた各基板の外形が凍結ファイルの外形と一致すること、穴（長穴を含む）が凍結ファイルの穴＋マウスバイト穴＋治具穴と一致すること、フィデューシャルが計画どおりの位置にあること、面付け DRC の違反数が元の基板の違反数（×枚数）と種類ごとに一致すること（記録した例外は件数も固定）、CPL が KiCad の位置出力と一致すること。Gerber どうしの比較はしていません。マウスバイト穴は基板の縁の外に置くので、分割後は各タブの位置に最大約 0.3 mm の突起が残り、実物の外形は凍結ファイルの外形より少し出ます。
面付け DRC の例外: `npth_inside_courtyard`（コートヤードの外に 2 か所のタブを置けないので、タブをはみ出した部品の下に置いた。基板の外にあるマウスバイト穴がその部品の外形枠の内側に入る。件数は `build-receipt.json` に固定）。

JLC の配置プレビューで中心を確かめる部品（フットプリント原点がパッド中心から離れているもの）:

| Ref | LCSC | 原点からパッド中心まで |
|---|---|---:|
| J1 | C5665 | 5.236 mm |
| J2 | C122442 | 1.25 mm |

## 面付けの経路と部品数（2 台分を最小の余りで）

JLC が面付けすると 1 シートに何枚も載り、最小 2 シートを実装すると必要数を大きく超えます（PCBA 数量はシート数で、最小 2 シートと仮定。未確認（`pcba-quantity-unit-with-panel-not-sourced`））。リポジトリで必要枚数だけを載せた面付けを作ると、2 シートでちょうど 2 台分です。

| 基板 | 必要 | JLC 面付け 2 シート | リポジトリ面付け 2 シート | 推奨 |
|---|---:|---:|---:|---|
| コントローラー | 2 | 20 | 2 | リポジトリ面付け |
| LED リーフ | 4 | 16 | 4 | リポジトリ面付け |
| 電源アダプタ | 2 | 4 | 2 | リポジトリ面付け |

部品ごとの数（JLC 在庫は 2026-11-12 の観測値）:

| LCSC | 型番 | 2 台分 | JLC 面付け | リポジトリ面付け | JLC 在庫 | 予約可能数 |
|---|---|---:|---:|---:|---:|---:|
| C122442 | 530470310 | 4 | 24 | 4 | 21090 | 20494 |
| C12891 | CL31A226KAHNNNE | 4 | 40 | 4 | 2515861 | 2105398 |
| C134375 | BAS70-04-7-F | 2 | 20 | 2 | 247 | 124 |
| C140331 | TPS2552DBVR-1 | 2 | 20 | 2 | 2228 | 2219 |
| C14663 | CC0603KRX7R9BB104 | 32 | 224 | 32 | 36130749 | 18269416 |
| C15741 | SN74LVC2T45DCUR | 2 | 20 | 2 | 85166 | 84012 |
| C15850 | CL21A106KAYNNNE | 6 | 60 | 6 | 8516270 | 6708284 |
| C160404 | SM04B-SRSS-TB(LF)(SN) | 10 | 52 | 10 | 9798 | 4021 |
| C19666 | CL10A475KO8NNNC | 6 | 60 | 6 | 3568082 | 2787013 |
| C20526 | MMBT3904(RANGE:100-300) | 2 | 20 | 2 | 4183780 | 4065649 |
| C2071056 | AP63205WU-7 | 2 | 20 | 2 | 39904 | 37005 |
| C21190 | 0603WAF1001T5E | 6 | 60 | 6 | 28882373 | 22227859 |
| C221351 | OPA197IDBVR | 2 | 20 | 2 | 76873 | 76582 |
| C22355739 | PJ-324M | 4 | 40 | 4 | 5954 | 5802 |
| C23138 | 0603WAF3300T5E | 6 | 60 | 6 | 2416605 | 1796477 |
| C23162 | 0603WAF4701T5E | 2 | 20 | 2 | 14660825 | 11419063 |
| C23231 | 0603WAF6802T5E | 2 | 20 | 2 | 787855 | 687058 |
| C23254 | 0603WAF8202T5E | 8 | 80 | 8 | 933289 | 868318 |
| C25803 | 0603WAF1003T5E | 12 | 120 | 12 | 15062647 | 12699495 |
| C25804 | 0603WAF1002T5E | 10 | 100 | 10 | 42898836 | 32419078 |
| C398363 | TLV9001IDBVR | 2 | 20 | 2 | 47115 | 45780 |
| C404027 | TLV75533PDBVR | 2 | 20 | 2 | 75642 | 74564 |
| C50704 | PMEG4010CEJ,115 | 4 | 40 | 4 | 12701 | 12534 |
| C5149819 | HX MSK13C02 | 2 | 20 | 2 | 4561 | 4552 |
| C5270180 | STM32G031G8U6TR | 2 | 20 | 2 | 4507 | 3777 |
| C52917434 | WS2812B-2020-V6 | 16 | 64 | 16 | 879804 | 857883 |
| C5665 | 2.54-2*5P | 2 | 4 | 2 | 131245 | 124613 |
| C57112 | 0603B103K500NT | 2 | 20 | 2 | 5337711 | 3755418 |
| C694586 | SPM4020T-4R7M-LR | 2 | 20 | 2 | 686 | 678 |
| C7250 | 0603WAF1005T5E | 4 | 40 | 4 | 795181 | 674710 |

JLC の部品照合で Do Not Place を選んだ designator は実装されません（JLC の部品照合ガイド）。ただし JLC 面付けで余る基板だけを未実装にできるかは取得していないので、上の表は全数実装で数えています。JLC の FAQ では、フィデューシャルは JLC が SMT 用に付けるので自分で付けなくてよいとされています。

太字は JLC 在庫を超える数です。

## 部品の区分（2026-11-12 の JLC 部品ページ）

Basic 14 種・Extended 16 種。必要数は 2 台分です。在庫数は観測時点の値で、確保ではありません。

| LCSC | 型番 | 区分 | 必要数 | JLC 在庫 | 予約可能数 | 経路 |
|---|---|---|---:|---:|---:|---|
| C122442 | 530470310 | Extended | 4 | 21090 | 20494 | JLC 在庫 |
| C12891 | CL31A226KAHNNNE | Basic | 4 | 2515861 | 2105398 | JLC 在庫 |
| C134375 | BAS70-04-7-F | Extended | 2 | 247 | 124 | JLC 在庫 |
| C140331 | TPS2552DBVR-1 | Extended | 2 | 2228 | 2219 | JLC 在庫 |
| C14663 | CC0603KRX7R9BB104 | Basic | 32 | 36130749 | 18269416 | JLC 在庫 |
| C15741 | SN74LVC2T45DCUR | Extended | 2 | 85166 | 84012 | JLC 在庫 |
| C15850 | CL21A106KAYNNNE | Basic | 6 | 8516270 | 6708284 | JLC 在庫 |
| C160404 | SM04B-SRSS-TB(LF)(SN) | Extended | 10 | 9798 | 4021 | JLC 在庫 |
| C19666 | CL10A475KO8NNNC | Basic | 6 | 3568082 | 2787013 | JLC 在庫 |
| C20526 | MMBT3904(RANGE:100-300) | Basic | 2 | 4183780 | 4065649 | JLC 在庫 |
| C2071056 | AP63205WU-7 | Extended | 2 | 39904 | 37005 | JLC 在庫 |
| C21190 | 0603WAF1001T5E | Basic | 6 | 28882373 | 22227859 | JLC 在庫 |
| C221351 | OPA197IDBVR | Extended | 2 | 76873 | 76582 | JLC 在庫 |
| C22355739 | PJ-324M | Extended | 4 | 5954 | 5802 | JLC 在庫 |
| C23138 | 0603WAF3300T5E | Basic | 6 | 2416605 | 1796477 | JLC 在庫 |
| C23162 | 0603WAF4701T5E | Basic | 2 | 14660825 | 11419063 | JLC 在庫 |
| C23231 | 0603WAF6802T5E | Basic | 2 | 787855 | 687058 | JLC 在庫 |
| C23254 | 0603WAF8202T5E | Basic | 8 | 933289 | 868318 | JLC 在庫 |
| C25803 | 0603WAF1003T5E | Basic | 12 | 15062647 | 12699495 | JLC 在庫 |
| C25804 | 0603WAF1002T5E | Basic | 10 | 42898836 | 32419078 | JLC 在庫 |
| C398363 | TLV9001IDBVR | Extended | 2 | 47115 | 45780 | JLC 在庫 |
| C404027 | TLV75533PDBVR | Extended | 2 | 75642 | 74564 | JLC 在庫 |
| C50704 | PMEG4010CEJ,115 | Extended | 4 | 12701 | 12534 | JLC 在庫 |
| C5149819 | HX MSK13C02 | Extended | 2 | 4561 | 4552 | JLC 在庫 |
| C5270180 | STM32G031G8U6TR | Extended | 2 | 4507 | 3777 | JLC 在庫 |
| C52917434 | WS2812B-2020-V6 | Extended | 16 | 879804 | 857883 | JLC 在庫 |
| C5665 | 2.54-2*5P | Extended | 2 | 131245 | 124613 | JLC 在庫 |
| C57112 | 0603B103K500NT | Basic | 2 | 5337711 | 3755418 | JLC 在庫 |
| C694586 | SPM4020T-4R7M-LR | Extended | 2 | 686 | 678 | JLC 在庫 |
| C7250 | 0603WAF1005T5E | Basic | 4 | 795181 | 674710 | JLC 在庫 |

区分と在庫は `engineering/a7/jlc-package/sources.json` の日付付き記録です（項目の意味はこちらの解釈で、JLC の定義ではありません）。
