Takazudo/zudo-led-block/doc/src/content/docs/project/order-checklist.mdx

---
# GENERATED by scripts/a7_readiness.py from engineering/a7/qualification/ — do not edit; run `python3 scripts/a7_readiness.py`
title: "発注前にオーナーが行うこと"
description: "A7 (3HP / 1.6 mm / FR-4) の発注準備で、オーナーにしかできない作業と、それぞれが解除する readiness のゲート。"
sidebar_position: 4.5
---

:::danger[発注・製造リリースではありません]
発注ゲートは **BLOCKED** です。このページは準備の一覧で、発注・供給元への連絡・製造承認・通電を許可するものではありません。
:::

readiness（`engineering/a7/qualification/readiness.json`）は不足を 41 個のゲートに分け、何で解除できるかで分類しています。
ゲート名は readiness のものと同じです。

| 区分 | ゲート数 |
|---|---:|
| クラウドで進められるデジタル作業 | 0 |
| オーナーの判断 | 7 |
| 外部の証跡・アクセス待ち | 13 |
| 実機が必要 | 21 |

## 残っているオーナーの作業（この順に）

上から順に進めると、後の作業の前提がそろいます。各作業の内容と、解除するゲートの状態は下の表にあります。

1. **O0** 組み立て済み基板が届いたら、最初に PJ-324M の端子 4/5 を確かめる（初品検査）
2. **O3** 供給元への質問を送るか決め、送る
3. **O7** 残りの合否基準を採否する（提案値）
4. **O8** LED タイミング (#13) を Worldsemi の公式窓口に書面で確認する
5. **O5** 完成ケーブルを業者に注文仕様で頼み、長さ公差の回答をもらう
6. **O6** 使うケースの型番を知らせる
7. **O11** 治具の加工先を選ぶ
8. **O1** 限定試作ルートを承認する
9. **O9** 物理手順を実施して記録する
10. **O10** 製造リリースと発注を明示的に承認する

## まとめて答えられる判断（0 件）

オーナーの判断ゲートを、PCB 発注を先に止めるものから順に並べています。推奨は出典に基づく提案で、オーナーの回答ではありません。回答は記録（承認ファイルやレビュー記録）にしてから反映し、それまでゲートは閉じたままです。

## オーナーが方針を受け入れた判断（7 件、ゲートは開いたまま）

オーナーは推奨をまとめて受け入れました（原文「5 accept all」、記録 `engineering/a7/procurement/owner-decisions.json`）。方針は決まりましたが、その方針の作業が残っているのでゲートは閉じていません。

- **使うケースのレールとねじは何ですか。** → 手持ちのケースの型番を伝える（`assembly:rack-hardware`）。残り: 使うケースの型番をオーナーが知らせる。型番が分かるまで、レール・ねじ規格と締結部品は決まらない。

- **安定後の部品表面温度の上限を何度にしますか。** → 提案値を 75 °C に改めて採る（PJ-324M の保存温度の上限）（`criterion:thermal-optical`）。残り: 上限 75 °C は受入値に反映済み。PETG/PMMA の温度限界（製造元の資料が未取得）と見え方の合否（試験時にオーナーが判断）が残るので、基準ゲートは開いたまま。

- **LED の T1L（1 ビットの Low 時間）の合否を何にしますか。データシートは 580–1000 ns、現行 FW は計算上 約 340–361 ns（FW の設計範囲 220–420 ns）です。** → メーカーの判定基準（T0H と周期）を書面で確認して採る（`criterion:firmware-waveforms`）。残り: Worldsemi の公式窓口から、T0H と周期で判定し T1L を合否に使わないことと、周期の許容幅を書面でもらう（オーナー）。届くまで基準ゲートは開いたまま。購入ロットの波形測定も必要。

- **AP63205 の入力コンデンサ C1（10 µF、0805）は 12 V で実効 約 1.8 µF（典型）になり、推奨表の 10 µF を大きく下回ります（表の値が公称か実効かは資料に記載がない。公称なら C1 は表の値どおり）。どう扱いますか。** → 実機で入力リップルと動作を測って判断する（`criterion:effective-capacitance`）。残り: 基板は変えない。U2 入力リップルと出力の安定の合否値を、測定の前にレビューで決めて記録する。その後に実機で測る。

- **治具の FR-4 板 4 枚の加工先と、提案された金物（スプリングプランジャ・スタンドオフ・ねじ・ピン等）を承認しますか。** → 提案どおり承認し、加工先を選ぶ（`assembly:fixture-materials`）。残り: 提案された治具の金物は承認済み。治具の FR-4 板の加工先がまだ選ばれていない（プローブ板の穴間 0.40 mm の可否も加工先に確認する）。

- **製造パッケージのレビューとリリースの承認を、いつ行いますか。** → 物理手順がすべて終わった後に行う（`assembly:prototype-and-release`）。残り: 製造リリースは実機試験の結果を見てから判断する。試作の発注と組立は承認済みの試作ルートの範囲だけ。

- **版に結び付いた製造リリースと発注を承認しますか。** → すべての手順と書類がそろった後に承認する（`manufacturing_release`）。残り: 製造リリースと量産の発注は、試作基板の実機試験の結果を見てからオーナーが改めて承認する。

## 回答済みの判断（9 件）

オーナーが自分の言葉で答えたもの。記録ファイルに原文があり、ゲートは閉じています。

- **最初の発注数量をいくつにしますか。** → 2 台分（オーナー報告の JLC PCBA 最小、未確認）（オーナーの回答、`assembly:order-quantity`）。原文「JLCPCB accept at least 2 PCBA, so we will make 2 units first」、記録 `engineering/a7/procurement/owner-decisions.json`

- **PCM13SMTR（C221842）の JLC 在庫切れにどう対応しますか。** → 代替品を認める（オーナーの回答、`assembly:switch-supply`）。原文「seems possible but a bit high price? might be consider another switch if there's something good? consider basicallly choose JLC basic parts or have qty items. it's better this is backside switch, so nothing special is required for this. good if it works. also, on this project https://github.com/Takazudo/zudo-osc-hole-field AI chose high price components for most parts, but those were all replaced. check compoents price for all items, and choose low price one on JLC parts. have man qty + low price is the best forthose」、記録 `engineering/a7/procurement/owner-decisions.json`

- **JLC で 2 台分を実装するとき、基板の面付けをどうしますか。** → リポジトリで必要枚数だけの面付けを作る（オーナーの回答、`assembly:panel-route`）。原文「you can combine 2 or 3 board in one gerber, but anyhow we need to order at least 2 qty. this is prototype phase still, so maybe just simply make multiple gerbers will be better for AI, I guess. separated PCBs looks better for AI recognization. Chose "Yes, our own panels" on the decision card asking "Use our own panels, one Gerber per board type, quantity 2 each?"」、記録 `engineering/a7/procurement/owner-decisions.json`

- **完成ケーブル（電源 57 mm、SH4、IDC リボン）をどう用意しますか。** → ケーブル製作業者に仕様どおり注文する（オーナーの回答、`assembly:finished-cables`）。原文「5 accept all」、記録 `engineering/a7/procurement/owner-decisions.json`

- **電源ケーブルの注文範囲 54–60 mm と、最小曲げ半径 2.0 mm を合否基準にしますか。** → 提案どおり採る（オーナーの回答、`criterion:harness-depth`）。原文「5 accept all」、記録 `engineering/a7/procurement/owner-decisions.json`

- **R7 を流れる電流の上限 0.313 mA（推定を含む計算）を合否基準にしますか。** → 採る（オーナーの回答、`criterion:u7-stress`）。原文「5 accept all」、記録 `engineering/a7/procurement/owner-decisions.json`

- **ジャックの挿抜試験の回数を何回にし、保持力 10.0 N を合否基準にしますか。** → 100 回 + 10.0 N（オーナーの回答、`criterion:service-envelope`）。原文「5 accept all」、記録 `engineering/a7/procurement/owner-decisions.json`

- **LDO（TLV75533）の逆電流試験で、+5 V を切った状態の +3V3 への外部印加を許しますか。** → 外部印加はしない（外から逆電流を流さない）（オーナーの回答、`criterion:ldo-reverse`）。原文「5 accept all」、記録 `engineering/a7/procurement/owner-decisions.json`

- **部分電源・無電源 CV の試験（片側の電源だけ、CV をかけたまま電源断）の合否を、部品の絶対最大（STM32 の注入電流 −5 mA/ピン・合計 25 mA、FT 入力 VDD + 4.0 V（ADC に使う CV 入力 PA0 は 4 V）、OPA197・TLV9001 の入力は電源の 0.5 V 外まで（OPA197 は入力電流 10 mA まで）、SN74LVC2T45 6.5 V、WS2812B VDD + 0.7 V）をどのピンでも超えないこと、としますか。** → 部品の絶対最大を合否の線にする（オーナーの回答、`criterion:partial-rails`）。原文「Chose "Yes, maker's maximum is the line" on the decision card asking "Fail the partial-power test if any chip goes past its maker's maximum?"」、記録 `engineering/a7/procurement/owner-decisions.json`

## 資料・回答待ちのゲート（13 件）

ブラウザで保存してほしい資料は 2 件です。保存したファイルをそのまま渡してもらえれば、こちらで出典として記録します。それ以外は、クラウドで取得できるもの、供給元の回答、2 台分の日付付き供給観測、実物の測定です。

| ゲート | 入手の方法 | 何を | 必要な値 | URL | 代替 URL | 補足 |
|---|---|---|---|---|---|---|
| `assembly:exact-part-evidence` | 供給元・加工先の回答、実物の測定、オーナーがブラウザで保存 | JST SH コネクタのカタログ（SM04B-SRSS-TB） | No. 1 以外の回路番号の位置 | [開く](https://www.jst-mfg.com/product/pdf/eng/eSH.pdf) | [開く](https://www.jst-mfg.com/product/detail_e.php?series=231) | クラウドから 403。2026-11-12 にオーナーが送った eSH.pdf は記録済みと同じバイト列で、No. 1 の位置しか示さない。カタログ以外の資料（SM04B-SRSS-TB 単品の図面）か、購入品の目視で決める |
| `assembly:exact-part-evidence` | 供給元・加工先の回答、実物の測定、オーナーがブラウザで保存 | SOFNG PJ-324M の製品ページの図面 | 推奨穴・スロット寸法、軸の高さ、ナット付属の有無 | [開く](https://www.sofng.com/Earphonesocket/2023/0325/1752.html) | [開く](https://www.lcsc.com/product-detail/C22355739.html) | 図面画像は記録済み（2026-11-12 にオーナーが送った画像も同じ内容）。推奨穴寸法・軸の高さ・ナットの有無は画像に無いので、供給元への質問 Q1/Q3/Q4 か購入品の実測で決める |
| `criterion:jack-dimensions` | オーナーがブラウザで保存、供給元・加工先の回答、実物の測定 | SOFNG PJ-324M の公差付き図面と推奨基板寸法 | 各寸法の公差、推奨穴、適合ナット | [開く](https://www.sofng.com/Earphonesocket/2023/0325/1752.html) | [開く](https://www.lcsc.com/product-detail/C22355739.html) | 見つからなければ供給元への質問 Q1/Q3/Q4、または購入ロットの実測で決める |
| `criterion:switch-fit` | 供給元・加工先の回答、実物の測定 | Hanxia HX MSK13C02 の図面（JLC 配布、取得済み） | 本体とペグの基準寸法の公差と、ランド上の端子番号の向き | [開く](https://jlcpcb.com/partdetail/hanxia-HXMSK13C02/C5149819) | [開く](https://www.lcsc.com/product-detail/C5149819.html) | 2026-11-12 に取得した図面（sha256 0acc4953…）には寸法の公差も、ランド上の端子番号もない。購入品の実測で決める。接触抵抗（3.3 V / 10 kΩ 負荷）も実部品の測定 |
| `assembly:supply-observations` | 日付付きの供給観測 | 2 台分の、部品ごとの JLC 在庫・価格・最小購入数・納期 | 各行が JLC 在庫で 2 台分（必要数は assembly-manifest.json の order_plan.lines）入手できるか（日付付き）。JLC のロス分（attrition）の規則も | [開く](https://jlcpcb.com/partdetail/SOFNG-PJ324M/C22355739) | — | JLC の部品ページを日付付きで保存する（URL は例）。JLC 在庫になければ予約注文または Global Sourcing、それ以外は例外として記録 |
| `assembly:mechanical-materials` | 供給元・加工先の回答 | PMMA 板・PETG 加工先の公差と、ねじの注文型番 | 板厚・ポケット深さの公差、PETG の造形条件、M2×18 / M1.6×4 の型番 | — | — | supplier-questions.md の「PMMA・PETG・組立」を加工先に送って回答を保存する |
| `criterion:pmma-supports` | 供給元・加工先の回答 | PMMA/PETG 加工先の加工公差と許容締付トルク | 締付トルクと保持荷重の合否値 | — | — | 上と同じ質問の回答 |
| `criterion:fixture-contact` | 実物の測定 | 完成治具の位置ずれの実測 | 許容位置ずれ・ストローク・荷重 | — | — | INGUN のプローブとレセプタクルの資料は取得済み。残りは完成治具の測定 |
| `material:jack` | 日付付きの供給観測 | PJ-324M（C22355739）の JLC 在庫と価格 | 基板用 2 台分（4 個）が JLC 在庫にあるか（日付付き） | [開く](https://jlcpcb.com/partdetail/SOFNG-PJ324M/C22355739) | [開く](https://www.lcsc.com/product-detail/C22355739.html) | 基板用は JLC 在庫を優先。オーナーは発注前の端子確認を見送った（2026-11-12）ので、単品を手元に取り寄せる必要はない |
| `material:switch` | 日付付きの供給観測 | HX MSK13C02（C5149819）の JLC 在庫 | 2 台分（2 個）が発注時に JLC 在庫にあるか（日付付き）。2026-11-12T19:35:14Z の観測は在庫 4561（Extended、確保ではない） | [開く](https://jlcpcb.com/partdetail/hanxia-HXMSK13C02/C5149819) | [開く](https://www.lcsc.com/product-detail/C5149819.html) | 発注直前に JLC 在庫を確認する。2026-11-12 の観測は supply-observations.json（jlc-c5149819-2026-11-12） |
| `material:finished_cables` | 供給元・加工先の回答、日付付きの供給観測 | 完成ケーブルの見積もり | 長さ公差の保証、数量、納期 | — | — | supplier-questions.md の「完成ケーブル」を製作業者に送る |
| `material:pmma_petg_hardware` | 供給元・加工先の回答、日付付きの供給観測 | PMMA・PETG・金物の見積もり | 数量・納期・価格 | — | — | 加工先への質問の回答と一緒に保存する |
| `material:fixture` | 日付付きの供給観測 | INGUN GKS-050 214 050 A 1000 / KS-050 E08 V-30 と FR-4 加工の見積もり | 在庫・数量・納期 | — | — | 治具の加工先と金物の承認（オーナーの判断）の後 |
| `material:assembly_service` | 日付付きの供給観測 | 基板実装サービスの見積もり（両面 SMD + THT） | 受入可否、最小数量、納期、価格 | — | — | 2 台分（コントローラー 2・リーフ 4・電源アダプタ 2 枚）の製造ファイルで JLC の見積もりを取る（発注はしない）。PCBA 最小 2 枚が JLC の条件どおりかもここで確かめる |
| `material:assembly_service` | 日付付きの供給観測 | JLC のリフロー条件と SW1（HX MSK13C02）の耐熱 | JLC のリフローのピーク温度と時間が Hanxia の図面の上限 250 °C 以内か | — | — | 見積もりのときに JLC に確認する（Hanxia の図面は 250 °C だけで、ピークの保持時間の記載はない） |

## 採否を待つ提案値

エージェントが出典から用意した提案です（2 件）。採るまでは該当する基準ゲートを解除しません。理由と計算は procedures.md にあります。

| 手順 | ID | 基準 | 提案値 | 単位 |
|---|---|---|---|---|
| firmware-waveforms | t1l-min | T1L の下限 | `580` | ns |
| firmware-waveforms | t1l-max | T1L の上限 | `1000` | ns |

## 採用済みの合否基準

採用者を区別して示します。採用は基準の確定で、測定や合格ではありません。

- jack-continuity: プロジェクトのコーディネーター（オーナーが委ねた作業方針による）（記録 `engineering/a7/qualification/reviews/2026-11-11-coordinator-criteria-acceptance.md`）
- harness-depth: オーナー本人（記録 `engineering/a7/qualification/reviews/2026-11-12-owner-criteria-acceptance.md`）
- power-current: プロジェクトのコーディネーター（オーナーが委ねた作業方針による）（記録 `engineering/a7/qualification/reviews/2026-11-11-coordinator-criteria-acceptance.md`）
- cv-thru-calibration: プロジェクトのコーディネーター（オーナーが委ねた作業方針による）（記録 `engineering/a7/qualification/reviews/2026-11-11-coordinator-criteria-acceptance.md`）
- startup-reset: プロジェクトのコーディネーター（オーナーが委ねた作業方針による）（記録 `engineering/a7/qualification/reviews/2026-11-11-coordinator-criteria-acceptance.md`）
- rail-collapse: プロジェクトのコーディネーター（オーナーが委ねた作業方針による）（記録 `engineering/a7/qualification/reviews/2026-11-11-coordinator-criteria-acceptance.md`）
- partial-rails: オーナー本人（記録 `engineering/a7/qualification/reviews/2026-11-12-owner-partial-rails-acceptance.md`）
- u7-stress: オーナー本人（記録 `engineering/a7/qualification/reviews/2026-11-12-owner-criteria-acceptance.md`）
- ldo-reverse: オーナー本人（記録 `engineering/a7/qualification/reviews/2026-11-12-owner-criteria-acceptance.md`）
- load-short: プロジェクトのコーディネーター（オーナーが委ねた作業方針による）（記録 `engineering/a7/qualification/reviews/2026-11-11-coordinator-criteria-acceptance.md`）
- cv-noise: プロジェクトのコーディネーター（オーナーが委ねた作業方針による）（記録 `engineering/a7/qualification/reviews/2026-11-11-coordinator-criteria-acceptance.md`）
- service-envelope: オーナー本人（記録 `engineering/a7/qualification/reviews/2026-11-12-owner-criteria-acceptance.md`）

## 各作業の詳細

| # | 内容 | 解除するゲート（現在の状態） |
|---|---|---|
| O0 | 供給元の symbol は端子 5 を tip としており、基板の推定対応（端子 4 = tip）と矛盾する。オーナーは発注前の導通試験を見送り、ジャックはこのまま使えるものとして進めると決めた（2026-11-12「4 skip it. handle it is usable」、記録 `engineering/a7/procurement/owner-decisions.json` の jack-tip-test-waiver）。これはリスクを受け入れた判断で、端子 4 = tip の確認ではない。端子 5 が tip なら、プラグを挿すと基板への接続が開き、CV IN と CV THRU の両方が働かず、制御基板の改版が要る。組み立て済み基板の最初の 1 枚で jack-continuity を実施し、ジャックを使う他の試験より前に判定する。 | `run:jack-continuity`（BLOCKED）、`criterion:jack-continuity`（解除済み）、`assembly:jack-switch-qualification`（BLOCKED） |
| O3 | `engineering/a7/qualification/supplier-questions.md` は未送信の下書き。送信と回答の保存（取得日・送信先・raw・ハッシュ）はオーナーだけが行える。 | `assembly:supply-observations`（BLOCKED）、`assembly:mechanical-materials`（BLOCKED）、`criterion:jack-dimensions`（BLOCKED）、`criterion:switch-fit`（BLOCKED）、`criterion:pmma-supports`（BLOCKED）、`criterion:ldo-reverse`（解除済み）、`criterion:effective-capacitance`（BLOCKED）、`material:jack`（BLOCKED）、`material:switch`（BLOCKED）、`material:finished_cables`（BLOCKED）、`material:pmma_petg_hardware`（BLOCKED）、`material:fixture`（BLOCKED）、`material:assembly_service`（BLOCKED） |
| O7 | harness-depth、u7-stress、service-envelope、ldo-reverse はオーナーが採用した（2026-11-12）。thermal-optical は上限 75 °C を採ったが、材料の温度限界と見え方が残る。部分電源試験（partial-rails）は「accept all」の後に別に尋ね、オーナーが部品の絶対最大を合否の線に採った（2026-11-12）。その他の PROPOSED の提案値は、採るまでゲートを解除しない。 | `criterion:thermal-optical`（BLOCKED）、`criterion:service-envelope`（解除済み）、`criterion:load-short`（解除済み）、`criterion:cv-noise`（解除済み）、`criterion:rail-collapse`（解除済み）、`criterion:jack-continuity`（解除済み）、`criterion:cv-thru-calibration`（解除済み）、`criterion:power-current`（解除済み）、`criterion:startup-reset`（解除済み）、`criterion:u7-stress`（解除済み）、`criterion:partial-rails`（解除済み） |
| O8 | オーナーは推奨（メーカーの判定基準を書面で確認して採る）を受け入れた（2026-11-12「5 accept all」）。データシート V1.4 の T1L は 580–1000 ns、現行 FW の T1L は計算上 約 340–361 ns。Worldsemi の公式窓口から、T0H ≤ 380 ns とビット周期で判定し T1L を合否に使わないことと、周期の許容幅を書面でもらう。届くまで提案値（t1l-min / t1l-max）は採らず、基準ゲートは開いたまま。書面確認が得られなければ購入ロットの実測に戻る。 | `criterion:firmware-waveforms`（BLOCKED） |
| O5 | オーナーは完成ケーブルを業者に頼むこと（2026-11-12「5 accept all」）と、電源ケーブルの注文範囲 54–60 mm（57 ± 3 mm、±3 は仮定）と最小曲げ半径 2.0 mm を合否基準にすることを決めた。業者が保証できる公差の回答をもらう。SH4 と IDC リボンも同じ。 | `material:finished_cables`（BLOCKED）、`criterion:harness-depth`（解除済み） |
| O6 | オーナーはケースの型番を知らせる案を採った（2026-11-12「5 accept all」）。型番からレール・ねじ規格と締結部品を決める。 | `assembly:rack-hardware`（BLOCKED） |
| O11 | `engineering/a7/fixture/manifest.json` の hardware_proposal はオーナーが承認した（2026-11-12「5 accept all」）。治具の FR-4 板 4 枚の加工先は未選定（JLCCNC の指針は参考のみ）。プローブ板の穴間 0.40 mm は加工先に穴あけ可否の確認が要る。 | `assembly:fixture-materials`（BLOCKED） |
| O1 | 対象版（A7 r2 / 3HP / FR-4）、数量、入手する部品・基板・治具、許す工程、実施者、試験前の安全条件を決め、承認ファイルを残して `records.json` の owner_prototype_route に記録する。製造リリースとは別の承認。 | `owner_prototype_route`（解除済み）、`assembly:prototype-and-release`（BLOCKED） |
| O9 | 19 手順はすべて実機が必要。`run-templates/` の雛形をコピーし、raw ファイルとハッシュを付けて `records.json` に追加する。 | `run:*`（19 手順が未実施） |
| O10 | レビュー済み製造ファイル、数量、版に結び付いた承認。オーナーは実機試験の結果を見てから判断する方針を受け入れた（2026-11-12「5 accept all」）。これは製造リリースではない。 | `manufacturing_release`（BLOCKED）、`assembly:prototype-and-release`（BLOCKED） |

## オーナーの作業を待たずに進められるもの

クラウドで進められるデジタル作業として分類したゲートです。

## 物理手順

19 手順の準備物・計器・手順・記録項目・受入値は [procedures.md](https://github.com/Takazudo/zudo-led-block/blob/main/engineering/a7/qualification/procedures.md) にあります。受入値はすべて出典（部品資料の fact、設計記録、仮定の記録）と照合しています。仮定の値（例: 電源ケーブル公差 ±3 mm）と推定の値（例: ジャック軸高さ）は区別して表示します。実施後の記録は `run-templates/` の雛形を使います。すべて NOT_MEASURED のままです。
