Takazudo/zudo-led-block/doc/src/content/docs/architecture/bom.mdx

---
# GENERATED by scripts/a5_site.py from engineering/a5/ — do not edit; run `pnpm a5:generate`
title: "部品表 (A5 BOM)"
description: "A5 の 30 型番・81 点の部品表。procurement_rows.json とネイティブ KiCad ネットリストから自動生成。"
sidebar_position: 3
---

:::caution[製造リリースではありません]
A5 は開発チェックポイントです。制御基板は未配線で、価格・在庫は 2026-11-06 JST の観測値です。在庫予約・発注数量の合意ではありません。
:::

この表は [`procurement_rows.json`](https://github.com/Takazudo/zudo-led-block/blob/main/engineering/a5/procurement_rows.json)（[`procurement_inputs_A5.json`](https://github.com/Takazudo/zudo-led-block/blob/main/engineering/a5/procurement_inputs_A5.json) から `build_procurement_rows.py` で再計算された共通ソース）と、3 種類のネイティブ回路の XML ネットリスト (`integration/native_schematic/*/netlist.xml`) から `scripts/a5_site.py` が生成します。手で編集しないでください。

## 数量の内訳

| 項目 | 値 |
| --- | --- |
| 型番 (JLC C コード) の種類 | **30** |
| 1 台あたりの実装部品数 | **81** |
| 制御基板 (1 枚) | 59 点 |
| LED 基板 (同一設計 ×2 枚) | 10 点 × 2 = 20 点 |
| 電源変換基板 (1 枚) | 2 点 |
| ネイティブ設計の種類 / 物理基板の枚数 | 3 種類 / 4 枚 |
| 設計上のユニーク配置数 (LED 基板を 1 回だけ数える) | 71 (これは実装点数 81 ではありません) |

部品番号のない参照 (テストパッド・取付穴など) は実装部品に数えません: 制御基板: TP1, TP2, TP3, TP4, TP5。

## 費用の比較 (1 台あたり, USD)

| 比較台数 | 実装部品 | LED 線 2 本 | 電源線 1 本 | ここまでの小計 |
| ---: | ---: | ---: | ---: | ---: |
| 1 台 | $9.9396 | $1.9000 | $3.5100 | **$15.3496** |
| 10 台 | $8.7205 | $1.9000 | $2.9850 | **$13.6055** |
| 100 台 | $6.6386 | $1.9000 | $2.5365 | **$11.0751** |

1/10/100 台は費用比較の条件で、合意済みの発注数量ではありません。含まれないもの: Attrition, pre-purchase minimums, board-job splitting, PCBs, assembly, fixtures, X-ray, programming, other cables, mechanical parts, shipping and taxes. (PMMA・PETG・金具・Eurorack リボン・書込みも含みません)。

観測時刻: JLC baseline: 2026-11-06 11:30-11:37 JST; U7:14:37 JST / IDC10:14:39 JST; external cables:11:37 JST. Individual timestamps retained.

## 部品一覧 (30 型番)

### IC・LED・電源

| 役割 | 型番 | メーカー | JLC | パッケージ | 数/台 | 配置 (ネットリスト) | 単価 (最小帯) | 在庫 (観測) | 観測 (JST) | 部品証跡 |
| --- | --- | --- | --- | --- | ---: | --- | ---: | ---: | --- | --- |
| MCU / U1 | `STM32G031G8U6TR` | STMicroelectronics | [C5270180](https://jlcpcb.com/partdetail/STMicroelectronics-STM32G031G8U6TR/C5270180) | UFQFPN-28(4x4) | 1 | 制御基板: U1 | $1.7468 | 4,522 | 2026-11-06 11:30 | [記録](/docs/components/records/stm32g031g8u6tr/) |
| RGB LED / LED1〜8 | `WS2812B-2020-V6` | Worldsemi | [C52917434](https://jlcpcb.com/partdetail/Worldsemi-LED/C52917434) | SMD2020-4P | 8 | LED 基板 (同一 ×2): D1, D2, D3, D4 | $0.0916 | 768,169 | 2026-11-06 11:30 | [記録](/docs/components/records/ws2812b-2020-v6/) |
| 5 V降圧 / U2 | `AP63205WU-7` | Diodes Incorporated | [C2071056](https://jlcpcb.com/partdetail/AP63205WU-7/C2071056) | TSOT-23-6 | 1 | 制御基板: U2 | $0.4617 | 20,569 | 2026-11-06 11:30 | [記録](/docs/components/records/ap63205wu-7/) |
| 3.3 V LDO / U3 | `TLV75533PDBVR` | Texas Instruments | [C404027](https://jlcpcb.com/partdetail/TexasInstruments-TLV75533PDBVR/C404027) | SOT-23-5 | 1 | 制御基板: U3 | $0.1217 | 95,119 | 2026-11-06 11:30 | [記録](/docs/components/records/tlv75533pdbvr/) |
| LED電源ラッチ / U4 | `TPS2552DBVR-1` | Texas Instruments | [C140331](https://jlcpcb.com/partdetail/TexasInstruments-TPS2552DBVR1/C140331) | SOT-23-6 | 1 | 制御基板: U4 | $0.5747 | 2,336 | 2026-11-06 11:31 | [記録](/docs/components/records/tps2552dbvr-1/) |
| EN反転NPN / Q1 | `MMBT3904(RANGE:100-300)` | Jiangsu Changjing Electronics Technology Co., Ltd. | [C20526](https://jlcpcb.com/partdetail/21237-MMBT3904/C20526) | SOT-23 | 1 | 制御基板: Q1 | $0.0117 | 2,739,252 | 2026-11-06 11:31 | [記録](/docs/components/records/mmbt3904-range-100-300/) |
| LED用2chレベル変換 / U5 | `SN74LVC2T45DCUR` | Texas Instruments | [C15741](https://jlcpcb.com/partdetail/TexasInstruments-SN74LVC2T45DCUR/C15741) | VSSOP-8 | 1 | 制御基板: U5 | $0.2081 | 91,268 | 2026-11-06 11:31 | [記録](/docs/components/records/sn74lvc2t45dcur/) |
| CVバッファ / U6 | `OPA197IDBVR` | Texas Instruments | [C221351](https://jlcpcb.com/partdetail/TexasInstruments-OPA197IDBVR/C221351) | SOT-23-5 | 1 | 制御基板: U6 | $0.8431 | 80,652 | 2026-11-06 11:31 | [記録](/docs/components/records/opa197idbvr/) |
| ADC保護用3V3バッファ / U7 | `TLV9001IDBVR` | Texas Instruments | [C398363](https://jlcpcb.com/partdetail/C398363) | SOT-23-5 | 1 | 制御基板: U7 | $0.0832 | 49,852 | 2026-11-06 14:37 | [記録](/docs/components/records/tlv9001idbvr/) |
| ±12 V逆接保護用 / D1,D2 | `PMEG4010CEJ,115` | Nexperia | [C50704](https://jlcpcb.com/partdetail/PMEG4010CEJ%2C115/C50704) | SOD-323F | 2 | 制御基板: D1, D2 | $0.3682 | 14,151 | 2026-11-06 11:31 | [記録](/docs/components/records/pmeg4010cej-115/) |
| ADCクランプ候補 / D3 | `BAS70-04-7-F` | Diodes Incorporated | [C134375](https://jlcpcb.com/partdetail/DiodesIncorporated-BAS70_04_7F/C134375) | SOT-23 | 1 | 制御基板: D3 | $0.0724 | 6,783 | 2026-11-06 11:31 | [記録](/docs/components/records/bas70-04-7-f/) |
| 降圧インダクタ4.7 µH / L1 | `SPM4020T-4R7M-LR` | TDK | [C694586](https://jlcpcb.com/partdetail/C694586) | SMD,4.4x4.1mm nominal; 4.6x4.3x2.0mm maximum envelope | 1 | 制御基板: L1 | $0.3802 | 726 | 2026-11-06 11:37 | [記録](/docs/components/records/spm4020t-4r7m-lr/) |

### I/O・コネクタ

| 役割 | 型番 | メーカー | JLC | パッケージ | 数/台 | 配置 (ネットリスト) | 単価 (最小帯) | 在庫 (観測) | 観測 (JST) | 部品証跡 |
| --- | --- | --- | --- | --- | ---: | --- | ---: | ---: | --- | --- |
| CV IN・THRUジャック / J1,J2 | `PJ-3582-B` | XKB Connection | [C500090](https://jlcpcb.com/partdetail/XKBConnection-PJ_3582B/C500090) | Plugin | 2 | 制御基板: J1, J2 | $0.2662 | 2,891 | 2026-11-06 11:31 | [記録](/docs/components/records/pj-3582-b/) |
| ON–OFF–ONトグル / SW1 | `1MS3T1B1M2QES-5` | Dailywell | [C908270](https://jlcpcb.com/partdetail/Dailywell-1MS3T1B1M2QES5/C908270) | Plugin | 1 | 制御基板: SW1 | $1.4161 | 1,134 | 2026-11-06 11:30 | [記録](/docs/components/records/dailywell-1ms3t1b1m2qes-5/) |
| LED用SH4ヘッダ / 制御1＋LED4 | `SM04B-SRSS-TB(LF)(SN)` | JST | [C160404](https://jlcpcb.com/partdetail/Jst-SM04B_SRSS_TB_LF_SN/C160404) | SMD,P=1mm,Surface Mount，Right Angle | 5 | 制御基板: J3; LED 基板 (同一 ×2): J1, J2 | $0.2148 | 57,403 | 2026-11-06 11:31 | [記録](/docs/components/records/sm04b-srss-tb-lf-sn/) |
| 電源用3pinヘッダ / 制御1＋変換1 | `530470310` | MOLEX | [C122442](https://jlcpcb.com/partdetail/MOLEX-530470310/C122442) | Plugin,P=1.25mm | 2 | 制御基板: J5; 電源変換基板: J2 | $0.1315 | 22,487 | 2026-11-06 11:31 | [記録](/docs/components/records/molex-530470310/) |
| Eurorack IDC10 / 変換基板1 | `2.54-2\*5P2.54 mm pitch 2×5 pin IDC box header` | BOOMELE(Boom Precision Elec) | [C5665](https://jlcpcb.com/partdetail/BOOMELE_Boom_Precision_Elec-2_54_2_5P/C5665) | Plugin,P=2.54mm | 1 | 電源変換基板: J1 | $0.1042 | 142,910 | 2026-11-06 14:39 | [記録](/docs/components/records/boomele-2-54-2x5p/) |

### 抵抗

| 役割 | 型番 | メーカー | JLC | パッケージ | 数/台 | 配置 (ネットリスト) | 単価 (最小帯) | 在庫 (観測) | 観測 (JST) | 部品証跡 |
| --- | --- | --- | --- | --- | ---: | --- | ---: | ---: | --- | --- |
| 10 MΩ 1% / R1,R2 | `0603WAF1005T5E` | UNI-ROYAL(Uniroyal Elec) | [C7250](https://jlcpcb.com/partdetail/C7250) | 0603 | 2 | 制御基板: R1, R2 | $0.0024 | 843,422 | 2026-11-06 11:31 | [記録](/docs/components/records/uniroyal-0603waf1005t5e/) |
| 82 kΩ 1% / R3〜R6 | `0603WAF8202T5E` | UNI-ROYAL(Uniroyal Elec) | [C23254](https://jlcpcb.com/partdetail/C23254) | 0603 | 4 | 制御基板: R3, R4, R5, R6 | $0.0027 | 1,037,430 | 2026-11-06 11:31 | [記録](/docs/components/records/uniroyal-0603waf8202t5e/) |
| 1 kΩ 1% / R7,R8,R25 | `0603WAF1001T5E` | UNI-ROYAL(Uniroyal Elec) | [C21190](https://jlcpcb.com/partdetail/C21190) | 0603 | 3 | 制御基板: R7, R8, R25 | $0.0017 | 27,741,384 | 2026-11-06 11:32 | [記録](/docs/components/records/uniroyal-0603waf1001t5e/) |
| 10 kΩ 1% / R9,R10,R13,R21,R22 | `0603WAF1002T5E` | UNI-ROYAL(Uniroyal Elec) | [C25804](https://jlcpcb.com/partdetail/C25804) | 0603 | 5 | 制御基板: R9, R10, R13, R21, R22 | $0.0024 | 43,335,083 | 2026-11-06 11:32 | [記録](/docs/components/records/uniroyal-0603waf1002t5e/) |
| 68 kΩ 1% / R11 | `0603WAF6802T5E` | UNI-ROYAL(Uniroyal Elec) | [C23231](https://jlcpcb.com/partdetail/C23231) | 0603 | 1 | 制御基板: R11 | $0.0016 | 907,020 | 2026-11-06 11:32 | [記録](/docs/components/records/uniroyal-0603waf6802t5e/) |
| 100 kΩ 1% / R12,R16〜R19,R23 | `0603WAF1003T5E` | UNI-ROYAL(Uniroyal Elec) | [C25803](https://jlcpcb.com/partdetail/C25803) | 0603 | 6 | 制御基板: R12, R16, R17, R18, R19, R23 | $0.0029 | 16,339,561 | 2026-11-06 11:33 | [記録](/docs/components/records/uniroyal-0603waf1003t5e/) |
| 330 Ω 1% / R14,R15,R24 | `0603WAF3300T5E` | UNI-ROYAL(Uniroyal Elec) | [C23138](https://jlcpcb.com/partdetail/C23138) | 0603 | 3 | 制御基板: R14, R15, R24 | $0.0020 | 2,930,596 | 2026-11-06 11:33 | [記録](/docs/components/records/uniroyal-0603waf3300t5e/) |
| 4.7 kΩ 1% / R20 | `0603WAF4701T5E` | UNI-ROYAL(Uniroyal Elec) | [C23162](https://jlcpcb.com/partdetail/C23162) | 0603 | 1 | 制御基板: R20 | $0.0028 | 16,257,259 | 2026-11-06 11:33 | [記録](/docs/components/records/uniroyal-0603waf4701t5e/) |

### コンデンサ

| 役割 | 型番 | メーカー | JLC | パッケージ | 数/台 | 配置 (ネットリスト) | 単価 (最小帯) | 在庫 (観測) | 観測 (JST) | 部品証跡 |
| --- | --- | --- | --- | --- | ---: | --- | ---: | ---: | --- | --- |
| 100 nF 50 V X7R / 制御8＋LED8 | `CC0603KRX7R9BB104` | YAGEO | [C14663](https://jlcpcb.com/partdetail/C14663) | 0603 | 16 | 制御基板: C4, C8, C9, C10, C11, C12, C14, C17; LED 基板 (同一 ×2): C1, C2, C3, C4 | $0.0067 | 35,680,175 | 2026-11-06 11:33 | [記録](/docs/components/records/cc0603krx7r9bb104/) |
| 10 nF 50 V X7R / C13 | `0603B103K500NT` | FH (Guangdong Fenghua Advanced Tech) | [C57112](https://jlcpcb.com/partdetail/C57112) | 0603 | 1 | 制御基板: C13 | $0.0097 | 5,106,962 | 2026-11-06 11:33 | [記録](/docs/components/records/fh-0603b103k500nt/) |
| 10 µF 25 V X5R / C1,C15,C16 | `CL21A106KAYNNNE` | Samsung Electro-Mechanics | [C15850](https://jlcpcb.com/partdetail/C15850) | 0805 | 3 | 制御基板: C1, C15, C16 | $0.0397 | 7,369,336 | 2026-11-06 11:33 | [記録](/docs/components/records/cl21a106kaynnne/) |
| 22 µF 25 V X5R / C2,C3 | `CL31A226KAHNNNE` | Samsung Electro-Mechanics | [C12891](https://jlcpcb.com/partdetail/C12891) | 1206 | 2 | 制御基板: C2, C3 | $0.1178 | 1,606,302 | 2026-11-06 11:33 | [記録](/docs/components/records/cl31a226kahnnne/) |
| 4.7 µF 16 V X5R / C5,C6,C7 | `CL10A475KO8NNNC` | Samsung Electro-Mechanics | [C19666](https://jlcpcb.com/partdetail/C19666) | 0603 | 3 | 制御基板: C5, C6, C7 | $0.0150 | 4,032,683 | 2026-11-06 11:33 | [記録](/docs/components/records/cl10a475ko8nnnc/) |

「部品証跡」列は [部品証跡カタログ](/docs/components/catalog/) の記録ページへのリンクです。対応は `provenance/a5-catalog/reconciliation.json` (`scripts/a5_catalog.py reconcile`) で照合しています。型番列は A5 の調達表のままで、`2.54-2\*5P2.54 mm pitch 2×5 pin IDC box header` は正準型番 `2.54-2\*5P` (C5665) として `provenance/a5-catalog/identity-crosswalk.json` で対応付けています。

## 外部ケーブル (別枠)

| ID | 役割 | 型番 | 数/台 | 単価 (最小帯) | 出典 | メモ |
| --- | --- | --- | ---: | ---: | --- | --- |
| EXT-01 | LED基板用4線ケーブル×2 | `Adafruit 4399 / Kaweei CBH-100-04-050-A` | 2 | $0.9500 | [出典](https://www.digikey.com/en/products/detail/adafruit-industries-llc/4399/10824268) | DigiKey1528-4399-ND。50±5 mm、SH4両端、1:1結線。直販Adafruitは100+で$0.76と安いが数量非公開。主価格は数値在庫のあるDigiKey$0.95を使用。 |
| EXT-02 | 電源3線ケーブル×1 | `Molex 151340300` | 1 | $3.5100 | [出典](https://www.digikey.com/en/products/detail/molex/0151340300/6198142) | DigiKey WM15252-ND、表記0151340300はMolex151340300と同一。50±6 mm、1 A/接点。A1→B3/A2→B2/A3→B1。JLC在庫ではなく外部購入。 |
| EXT-03 | Eurorack電源リボン×1 | `既製16→10 pin IDC、長さ未確定` | 1 | 未見積り | — | 切断・家庭ではんだ付けしない。リモート変換基板と曲げを30 mmケース制約に含める。 |
| EXT-04 | 透明キャストPMMA前面×1 | `Elecrow、2 mm、2HPまたは3HP、文字抜き全面裏彫刻` | 1 | 未見積り | [出典](https://www.elecrow.com/acrylic-cutting.html) | 透明材000系を希望。透明文字を残すため既製マット材を選ばない。切断許容差と彫刻仕上げは工場確認。 |
| EXT-05 | PETG拡散板・支持体一式 | `自宅プリント用、後部設計改版中` | 1 | 未見積り | — | ジャック受け、スイッチ回り止め、ケーブル逃げが必要。A3支持体をそのまま使用できる確認はない。 |
| EXT-06 | 締結部品・接着層一式 | `M2/M3等、完成機構で確定` | 1 | 未見積り | — | 前面2 mmPMMA、LED背中合わせの0.1 mm接着層を想定。推奨締付トルクは未確定。 |

価格のない項目は費用比較に含まれていません (未見積り)。

## A5 での変更点

A4.1 から実装部品 5 点、新しい型番 1 種類を追加しました。

| 基板 | 参照 | JLC | 数/台 |
| --- | --- | --- | ---: |
| controller | U7 | C398363 | 1 |
| controller | R24 | C23138 | 1 |
| controller | R25 | C21190 | 1 |
| controller | C17 | C14663 | 1 |
| each\_led\_leaf | J2 | C160404 | 2 |

- **adc_formula**: VADC=(100/133)\*(VDD/2+CV/8); CV=10.64\*VADC-4\*VDD
- **input_filter_change**: C13 moved to CV\_AFFINE upstream of existing R7; stored charge reaches U7/D3 through R7. DC gain and fitted count unchanged; nominal pole approximately 776Hz.
- **harness_revision**: \{"controller": "J3 pins1GND/2VLED/3DATA\_L/4DATA\_R; J4 removed", "leaf": "J1 pins3/4=DATA\_THIS/DATA\_OTHER; J2 pins3/4=DATA\_OTHER/DATA\_THIS", "cables": "Two existing 1:1 harnesses: controller J3 -&gt; left J1; left J2 -&gt; right J1", "extra\_fitted\_header\_net": 1\}
- **removed_parts**: [\{"board": "controller", "ref": "J4", "c\_code": "C160404", "quantity\_per\_module": 1\}]

A4 / A4.1 の価格・数量・ADC 式は `history_A4/`・`history_A4_1/` に履歴として残っていますが、A5 の値を上書きしません。
