Takazudo/zudo-led-block/doc/src/content/docs/components/records/index.mdx

---
# GENERATED by @takazudo/zudo-circuit-doc — do not edit; run `zudo-circuit-doc generate`
title: "Records"
description: "Per-record evidence pages: facts, sources, coverage domains, pin maps and interactions."
sidebar_position: 3
---

Generated from the component evidence records — edit the records, not this page.

One page per published component record, each carrying that record's facts, sources, coverage domains, pin maps and interactions. They are ordered as the bill of materials orders them, with each subordinate record directly after the part it belongs to.

To compare records against each other, start from the [catalog](/docs/components/catalog/).

## Records

- [530470310](/docs/components/records/molex-530470310/) — `rec-molex-530470310` three-pin power cable header
- [CL31A226KAHNNNE](/docs/components/records/cl31a226kahnnne/) — `rec-cl31a226kahnnne` 22 uf 25 v x5r 1206 capacitor
- [BAS70-04-7-F](/docs/components/records/bas70-04-7-f/) — `rec-bas70-04-7-f` adc clamp dual schottky diode
- [TPS2552DBVR-1](/docs/components/records/tps2552dbvr-1/) — `rec-tps2552dbvr-1` led supply current-limit latch switch
- [CC0603KRX7R9BB104](/docs/components/records/cc0603krx7r9bb104/) — `rec-cc0603krx7r9bb104` 100 nf 50 v x7r 0603 capacitor
- [SN74LVC2T45DCUR](/docs/components/records/sn74lvc2t45dcur/) — `rec-sn74lvc2t45dcur` two-channel led data level translator
- [CL21A106KAYNNNE](/docs/components/records/cl21a106kaynnne/) — `rec-cl21a106kaynnne` 10 uf 25 v x5r 0805 capacitor
- [SM04B-SRSS-TB(LF)(SN)](/docs/components/records/sm04b-srss-tb-lf-sn/) — `rec-sm04b-srss-tb-lf-sn` four-pin led harness header
- [CL10A475KO8NNNC](/docs/components/records/cl10a475ko8nnnc/) — `rec-cl10a475ko8nnnc` 4.7 uf 16 v x5r 0603 capacitor
- [MMBT3904(RANGE:100-300)](/docs/components/records/mmbt3904-range-100-300/) — `rec-mmbt3904-range-100-300` enable inverter npn transistor
- [AP63205WU-7](/docs/components/records/ap63205wu-7/) — `rec-ap63205wu-7` fixed 5 v buck converter
- [0603WAF1001T5E](/docs/components/records/uniroyal-0603waf1001t5e/) — `rec-uniroyal-0603waf1001t5e` 1 kilohm 0603 resistor
- [OPA197IDBVR](/docs/components/records/opa197idbvr/) — `rec-opa197idbvr` cv input buffer amplifier
- [0603WAF3300T5E](/docs/components/records/uniroyal-0603waf3300t5e/) — `rec-uniroyal-0603waf3300t5e` 330 ohm 0603 resistor
- [0603WAF4701T5E](/docs/components/records/uniroyal-0603waf4701t5e/) — `rec-uniroyal-0603waf4701t5e` 4.7 kilohm 0603 resistor
- [0603WAF6802T5E](/docs/components/records/uniroyal-0603waf6802t5e/) — `rec-uniroyal-0603waf6802t5e` 68 kilohm 0603 resistor
- [0603WAF8202T5E](/docs/components/records/uniroyal-0603waf8202t5e/) — `rec-uniroyal-0603waf8202t5e` 82 kilohm 0603 resistor
- [0603WAF1003T5E](/docs/components/records/uniroyal-0603waf1003t5e/) — `rec-uniroyal-0603waf1003t5e` 100 kilohm 0603 resistor
- [0603WAF1002T5E](/docs/components/records/uniroyal-0603waf1002t5e/) — `rec-uniroyal-0603waf1002t5e` 10 kilohm 0603 resistor
- [TLV9001IDBVR](/docs/components/records/tlv9001idbvr/) — `rec-tlv9001idbvr` adc protection buffer amplifier
- [TLV75533PDBVR](/docs/components/records/tlv75533pdbvr/) — `rec-tlv75533pdbvr` 3.3 v ldo regulator
- [PJ-3582-B](/docs/components/records/pj-3582-b/) — `rec-pj-3582-b` cv input and thru jack
- [PMEG4010CEJ,115](/docs/components/records/pmeg4010cej-115/) — `rec-pmeg4010cej-115` eurorack rail reverse-polarity schottky diode
- [STM32G031G8U6TR](/docs/components/records/stm32g031g8u6tr/) — `rec-stm32g031g8u6tr` main microcontroller
- [WS2812B-2020-V6](/docs/components/records/ws2812b-2020-v6/) — `rec-ws2812b-2020-v6` addressable rgb led
- [2.54-2\*5P](/docs/components/records/boomele-2-54-2x5p/) — `rec-boomele-2-54-2x5p` eurorack ten-pin power box header
- [0603B103K500NT](/docs/components/records/fh-0603b103k500nt/) — `rec-fh-0603b103k500nt` 10 nf 50 v x7r 0603 capacitor
- [SPM4020T-4R7M-LR](/docs/components/records/spm4020t-4r7m-lr/) — `rec-spm4020t-4r7m-lr` buck converter power inductor
- [0603WAF1005T5E](/docs/components/records/uniroyal-0603waf1005t5e/) — `rec-uniroyal-0603waf1005t5e` 10 megohm 0603 resistor
- [1MS3T1B1M2QES-5](/docs/components/records/dailywell-1ms3t1b1m2qes-5/) — `rec-dailywell-1ms3t1b1m2qes-5` on off on mode toggle switch
- [PJ-324M](/docs/components/records/a7-pj-324m/) — `rec-a7-pj-324m` A7 right-angle threaded CV jack
- [PCM13SMTR](/docs/components/records/a7-pcm13smtr/) — `rec-a7-pcm13smtr` A7 side mode setting switch (superseded on SW1 by line-a7-hx-msk13c02, 2026-11-12; no placement)
- [HX MSK13C02](/docs/components/records/a7-hx-msk13c02/) — `rec-a7-hx-msk13c02` A7 side mode setting switch
