Takazudo/zudo-led-block/doc/src/content/docs/components/integration/index.mdx

---
# GENERATED by @takazudo/zudo-circuit-doc — do not edit; run `zudo-circuit-doc generate`
title: "Integration"
description: "Cross-component rules. None is currently published."
sidebar_position: 4
---

Generated from the component evidence records — edit the records, not this page.

A component record answers questions about one part. These rules answer the ones that span several — whether a divider built from two resistors keeps a third part inside its own limit, whether a clamp event stays under everything downstream of it. Each rule is projected whole from stored evidence: its conditions, the exact facts it rests on, any conditioned arithmetic, and the exact wording of what it refuses to conclude.

## How to read these rules

- **The refusal is the rule.** — Every rule states, in its own words, what may NOT be concluded from the evidence above it. That sentence is the rule's real output; the verdict is shorthand for it.
- **A verdict belongs to the rule, not to a part.** — A rule's verdict says how far the cross-component question has been settled. It is never a judgement about any of the parts the rule names, and the verdicts are never combined into one.
- **Calculations are conditioned, and the conditions are the point.** — Each calculation publishes its expression, its inputs and the exact results that were recorded, together with the conditions under which the answer means anything. A result read without them is arithmetic mistaken for a measurement.
- **Numbers here were carried, not computed.** — The expressions are published so a reader can redo the arithmetic. This page does not evaluate them — the results shown are the ones the evidence recorded.
- **An evidence chain does not flow downhill.** — A stage being settled says nothing about any stage after it. A document confirming a limit is not a measurement of the assembled board.

## Rules at a glance

<EvidenceAnchor id="integration-index" />

No cross-component integration rule is declared.

## Legend

What the recorded terms on this page mean, in ordinary words. The exact terms above are the ones that count; these descriptions explain them and never replace them.

## Raw agent resource

These rules are generated from a stored evidence bundle and do not restate it. The bundle is the source of truth: where the two ever disagree, the bundle is right and this page is stale.

No owning bundle is identified in the published model, so no reciprocal link can be given.
