Takazudo/zudo-led-block/doc/src/content/docs/components/records/a7-hx-msk13c02/index.mdx

---
# GENERATED by @takazudo/zudo-circuit-doc — do not edit; run `zudo-circuit-doc generate`
title: "HX MSK13C02"
description: "A7 side mode setting switch — hanxia — C5149819 — a7-controller SW1 — rec-a7-hx-msk13c02"
sidebar_position: 34
---

<EvidenceAnchor id="rec-a7-hx-msk13c02" />

Generated from the component evidence records — edit the records, not this page.

Everything below is projected from this project's stored component evidence. Values keep the exact wording, conditions, units and verdicts they were recorded with — nothing here is re-typed, corrected, or combined into an overall judgement about the part.

This record in the catalog: [HX MSK13C02](/docs/components/catalog/#rec-a7-hx-msk13c02)

## Identity

| Field | Recorded value |
| --- | --- |
| Record ID | `rec-a7-hx-msk13c02` |
| Record kind | standalone |
| Manufacturer part number | `HX MSK13C02` |
| Manufacturer | hanxia |
| Function | A7 side mode setting switch |
| LCSC ID | `C5149819` |
| Package | `SMD` |
| Inventory line | `line-a7-hx-msk13c02` |
| Also known as | `MSK13C02`, `Shenzhen Hanxia Electronic` |
| Owner skill | `component-a7-hx-msk13c02` |

**Fit:** Fitted

**Identity state:** UNRESOLVED

**Source state:** AVAILABLE

**Coverage:** 6 open of 6 published

## Documents and package

<EvidenceAnchor id="component-references-heading" />

<EvidenceAnchor id="component-references" />

**Selected document:** Document unavailable

**Reason:** No manufacturer-primary document for this exact orderable is retained in the evidence. Reviewed: Shenzhen Hanxia Electronic Co., Ltd slide switch SPECIFICATION FOR APPROVAL (承认书), served by JLCPCB for C5149819 (MANUFACTURER\_MIRROR, AVAILABLE); JLCPCB parts search API response (selectSmtComponentList) for C5149819 (DISTRIBUTOR\_IDENTITY, AVAILABLE); EasyEDA/LCSC supplier CAD record for C5149819 (footprint SW-SMD\_MSK13C02-BB) (DISTRIBUTOR\_IDENTITY, AVAILABLE). Distributor listings establish order identity only, and a distributor-hosted mirror is lower authority, so neither is published as a manufacturer document.

No footprint or 3D model is published for this record: CAD is not enabled for this project.

## Placements

Every position this exact line occupies in the as-built design. One line may be placed many times and across more than one board.

| Board | Reference designator |
| --- | --- |
| a7-controller | `SW1` |

## Coverage

Coverage is stated one domain at a time and is never rolled up. A domain marked open is a question that has not been answered; it is not a finding that the part is unsuitable. A record with no open domains has not thereby been declared safe.

### identity

<EvidenceAnchor id="cov-a7-hx-msk13c02-identity" />

**Coverage ID:** `cov-a7-hx-msk13c02-identity` · **Status:** OPEN

**Reason:** distributor identity is confirmed; the only datasheet is a distributor-served Hanxia document whose Part No. field is blank, so the manufacturer binding is unverified

**Facts in this domain:**

- [`fact-a7-hx-msk13c02-manufacturer`](#fact-a7-hx-msk13c02-manufacturer)
- [`fact-a7-hx-msk13c02-distributor-identity`](#fact-a7-hx-msk13c02-distributor-identity)
- [`fact-a7-hx-msk13c02-document-binding`](#fact-a7-hx-msk13c02-document-binding)

**Blocked by:** these facts must be resolved before the domain can close. Each is listed in full under Facts.

- [`fact-a7-hx-msk13c02-manufacturer`](#fact-a7-hx-msk13c02-manufacturer)
- [`fact-a7-hx-msk13c02-document-binding`](#fact-a7-hx-msk13c02-document-binding)

### pinout

<EvidenceAnchor id="cov-a7-hx-msk13c02-pinout" />

**Coverage ID:** `cov-a7-hx-msk13c02-pinout` · **Status:** OPEN

**Reason:** contact table A 1-3, B 2-3, C 3-4 is read from a mirror drawing and the per-position truth table on received units is NOT\_MEASURED

**Facts in this domain:**

- [`fact-a7-hx-msk13c02-function`](#fact-a7-hx-msk13c02-function)
- [`fact-a7-hx-msk13c02-physical-function`](#fact-a7-hx-msk13c02-physical-function)

**Blocked by:** these facts must be resolved before the domain can close. Each is listed in full under Facts.

- [`fact-a7-hx-msk13c02-function`](#fact-a7-hx-msk13c02-function)
- [`fact-a7-hx-msk13c02-physical-function`](#fact-a7-hx-msk13c02-physical-function)

### electrical-ratings

<EvidenceAnchor id="cov-a7-hx-msk13c02-electrical-ratings" />

**Coverage ID:** `cov-a7-hx-msk13c02-electrical-ratings` · **Status:** OPEN

**Reason:** ratings come only from the mirror document; reliable contact at 0.33 mA is NOT\_MEASURED

**Facts in this domain:**

- [`fact-a7-hx-msk13c02-contact-rating`](#fact-a7-hx-msk13c02-contact-rating)
- [`fact-a7-hx-msk13c02-contact-resistance`](#fact-a7-hx-msk13c02-contact-resistance)
- [`fact-a7-hx-msk13c02-insulation`](#fact-a7-hx-msk13c02-insulation)
- [`fact-a7-hx-msk13c02-life`](#fact-a7-hx-msk13c02-life)
- [`fact-a7-hx-msk13c02-operating-temperature`](#fact-a7-hx-msk13c02-operating-temperature)
- [`fact-a7-hx-msk13c02-solder`](#fact-a7-hx-msk13c02-solder)
- [`fact-a7-hx-msk13c02-operation`](#fact-a7-hx-msk13c02-operation)
- [`fact-a7-hx-msk13c02-physical-contact`](#fact-a7-hx-msk13c02-physical-contact)

**Blocked by:** these facts must be resolved before the domain can close. Each is listed in full under Facts.

- [`fact-a7-hx-msk13c02-contact-rating`](#fact-a7-hx-msk13c02-contact-rating)
- [`fact-a7-hx-msk13c02-contact-resistance`](#fact-a7-hx-msk13c02-contact-resistance)
- [`fact-a7-hx-msk13c02-insulation`](#fact-a7-hx-msk13c02-insulation)
- [`fact-a7-hx-msk13c02-life`](#fact-a7-hx-msk13c02-life)
- [`fact-a7-hx-msk13c02-operating-temperature`](#fact-a7-hx-msk13c02-operating-temperature)
- [`fact-a7-hx-msk13c02-solder`](#fact-a7-hx-msk13c02-solder)
- [`fact-a7-hx-msk13c02-operation`](#fact-a7-hx-msk13c02-operation)
- [`fact-a7-hx-msk13c02-physical-contact`](#fact-a7-hx-msk13c02-physical-contact)

### mechanical

<EvidenceAnchor id="cov-a7-hx-msk13c02-mechanical" />

**Coverage ID:** `cov-a7-hx-msk13c02-mechanical` · **Status:** OPEN

**Reason:** outline and recommended land come from the mirror drawing; land fit is a digital comparison and the 0.05 mm actuator overhang and physical fit need the first-article check

**Facts in this domain:**

- [`fact-a7-hx-msk13c02-outline`](#fact-a7-hx-msk13c02-outline)
- [`fact-a7-hx-msk13c02-recommended-land`](#fact-a7-hx-msk13c02-recommended-land)
- [`fact-a7-hx-msk13c02-land-fit`](#fact-a7-hx-msk13c02-land-fit)
- [`fact-a7-hx-msk13c02-edge-overhang`](#fact-a7-hx-msk13c02-edge-overhang)
- [`fact-a7-hx-msk13c02-physical-fit`](#fact-a7-hx-msk13c02-physical-fit)

**Blocked by:** these facts must be resolved before the domain can close. Each is listed in full under Facts.

- [`fact-a7-hx-msk13c02-outline`](#fact-a7-hx-msk13c02-outline)
- [`fact-a7-hx-msk13c02-recommended-land`](#fact-a7-hx-msk13c02-recommended-land)
- [`fact-a7-hx-msk13c02-land-fit`](#fact-a7-hx-msk13c02-land-fit)
- [`fact-a7-hx-msk13c02-edge-overhang`](#fact-a7-hx-msk13c02-edge-overhang)
- [`fact-a7-hx-msk13c02-physical-fit`](#fact-a7-hx-msk13c02-physical-fit)

### sourcing

<EvidenceAnchor id="cov-a7-hx-msk13c02-sourcing" />

**Coverage ID:** `cov-a7-hx-msk13c02-sourcing` · **Status:** OPEN

**Reason:** JLC stock 4561 on 2026-11-12 is an unreserved observation; no order or assembly acceptance

**Facts in this domain:**

- [`fact-a7-hx-msk13c02-sourcing`](#fact-a7-hx-msk13c02-sourcing)

**Blocked by:** these facts must be resolved before the domain can close. Each is listed in full under Facts.

- [`fact-a7-hx-msk13c02-sourcing`](#fact-a7-hx-msk13c02-sourcing)

### placement

<EvidenceAnchor id="cov-a7-hx-msk13c02-placement" />

**Coverage ID:** `cov-a7-hx-msk13c02-placement` · **Status:** OPEN

**Reason:** SW1 on the A7 controller is project state; physical placement is not verified

**Facts in this domain:**

- [`fact-a7-hx-msk13c02-a7-placements`](#fact-a7-hx-msk13c02-a7-placements)

**Blocked by:** these facts must be resolved before the domain can close. Each is listed in full under Facts.

- [`fact-a7-hx-msk13c02-a7-placements`](#fact-a7-hx-msk13c02-a7-placements)

## Facts

Each fact keeps its value, its unit, the conditions it holds under, where it came from and how far it has been confirmed as separate fields, because they are separate claims. A value without its conditions is not the same fact, and a verdict is about the evidence for the value, not about the part.

### ABSOLUTE\_MAXIMUM

A never-exceed limit. Reaching it may damage the part; it is not an operating target and there is no margin implied by it.

<EvidenceFact>
  <EvidenceAnchor id="fact-a7-hx-msk13c02-solder" />

  **Fact:** `fact-a7-hx-msk13c02-solder`

  **Value:** reflow 250 C max; iron 350 C 2 s max or 270 C 4 s max · **Unit:** `NONE`

  **Conditions:** time at peak not stated; to be compared with the assembler's reflow profile; read from the distributor-served Hanxia document (MANUFACTURER\_MIRROR, Part No. blank); no manufacturer-primary copy

  **Verdict:** UNSOURCED · **Provenance:** UNVERIFIED

  **Evidence:** [src-a7-hx-msk13c02-hanxia-spec: page index 2 section 4.5; page index 3 spec table '250'](#src-a7-hx-msk13c02-hanxia-spec)
</EvidenceFact>

### RECOMMENDED\_OPERATION

The range the manufacturer intends the part to be used in. Always narrower than the absolute maximum.

<EvidenceFact>
  <EvidenceAnchor id="fact-a7-hx-msk13c02-contact-rating" />

  **Fact:** `fact-a7-hx-msk13c02-contact-rating`

  **Value:** DC 12 V 0.1 A · **Unit:** `NONE`

  **Conditions:** rated load; A7 load is a 10 kOhm pull-up to 3.3 V (0.33 mA); read from the distributor-served Hanxia document (MANUFACTURER\_MIRROR, Part No. blank); no manufacturer-primary copy

  **Verdict:** UNSOURCED · **Provenance:** UNVERIFIED

  **Evidence:** [src-a7-hx-msk13c02-hanxia-spec: page index 1 section 1.1 RATING; page index 3 spec table row 1](#src-a7-hx-msk13c02-hanxia-spec)
</EvidenceFact>

<EvidenceFact>
  <EvidenceAnchor id="fact-a7-hx-msk13c02-life" />

  **Fact:** `fact-a7-hx-msk13c02-life`

  **Value:** 10000 · **Unit:** `cycles`

  **Conditions:** no-load life at 30 cycles per minute; read from the distributor-served Hanxia document (MANUFACTURER\_MIRROR, Part No. blank); no manufacturer-primary copy

  **Verdict:** UNSOURCED · **Provenance:** UNVERIFIED

  **Evidence:** [src-a7-hx-msk13c02-hanxia-spec: page index 2 section 4.1; page index 3 spec table](#src-a7-hx-msk13c02-hanxia-spec)
</EvidenceFact>

<EvidenceFact>
  <EvidenceAnchor id="fact-a7-hx-msk13c02-operating-temperature" />

  **Fact:** `fact-a7-hx-msk13c02-operating-temperature`

  **Value:** -25 to +70 · **Unit:** `C`

  **Conditions:** operating (practical) temperature range; lower than the PCM13SMTR -40..+85 C and the lowest operating upper limit among the A7 fitted parts with temperature facts; read from the distributor-served Hanxia document (MANUFACTURER\_MIRROR, Part No. blank); no manufacturer-primary copy

  **Verdict:** UNSOURCED · **Provenance:** UNVERIFIED

  **Evidence:** [src-a7-hx-msk13c02-hanxia-spec: page index 1 sections 1.1 and 1.2; page index 3 spec table](#src-a7-hx-msk13c02-hanxia-spec)
</EvidenceFact>

<EvidenceFact>
  <EvidenceAnchor id="fact-a7-hx-msk13c02-operation" />

  **Fact:** `fact-a7-hx-msk13c02-operation`

  **Value:** `operation_force_gf`=190 +/-30; `travel_mm`=1.5 +/-0.2 · **Unit:** `NONE`

  **Conditions:** lateral push on the actuator; read from the distributor-served Hanxia document (MANUFACTURER\_MIRROR, Part No. blank); no manufacturer-primary copy

  **Verdict:** UNSOURCED · **Provenance:** UNVERIFIED

  **Evidence:** [src-a7-hx-msk13c02-hanxia-spec: page index 1 sections 3.1 and 3.2](#src-a7-hx-msk13c02-hanxia-spec)
</EvidenceFact>

### GUARANTEED\_ELECTRICAL

A parameter the manufacturer guarantees over the stated conditions, usually with minimum, typical and maximum values.

<EvidenceFact>
  <EvidenceAnchor id="fact-a7-hx-msk13c02-contact-resistance" />

  **Fact:** `fact-a7-hx-msk13c02-contact-resistance`

  **Value:** 50 · **Unit:** `mOhm`

  **Conditions:** maximum, measured at 1 kHz small current (100 mA or less), initial and after the 10,000-cycle life test; read from the distributor-served Hanxia document (MANUFACTURER\_MIRROR, Part No. blank); no manufacturer-primary copy

  **Verdict:** UNSOURCED · **Provenance:** UNVERIFIED

  **Evidence:** [src-a7-hx-msk13c02-hanxia-spec: page index 1 section 2.1; page index 2 section 4.1](#src-a7-hx-msk13c02-hanxia-spec)
</EvidenceFact>

<EvidenceFact>
  <EvidenceAnchor id="fact-a7-hx-msk13c02-insulation" />

  **Fact:** `fact-a7-hx-msk13c02-insulation`

  **Value:** 100 · **Unit:** `MOhm`

  **Conditions:** minimum at 500 VDC for 1 min, between terminals and between body and terminals; read from the distributor-served Hanxia document (MANUFACTURER\_MIRROR, Part No. blank); no manufacturer-primary copy

  **Verdict:** UNSOURCED · **Provenance:** UNVERIFIED

  **Evidence:** [src-a7-hx-msk13c02-hanxia-spec: page index 1 section 2.2](#src-a7-hx-msk13c02-hanxia-spec)
</EvidenceFact>

### PROJECT\_STATE

A value this project recorded about how the part is used here — a chosen operating point, a net assignment, or a derived figure. Not a manufacturer specification.

<EvidenceFact>
  <EvidenceAnchor id="fact-a7-hx-msk13c02-distributor-identity" />

  **Fact:** `fact-a7-hx-msk13c02-distributor-identity`

  **Value:** `lcsc`=C5149819; `manufacturer`=hanxia; `mpn`=HX MSK13C02; `variant`=SMD · **Unit:** `NONE`

  **Conditions:** order-code identity only

  **Verdict:** CONFIRMED - distributor identity only · **Provenance:** DISTRIBUTOR-IDENTITY

  **Evidence:** [`src-a7-hx-msk13c02-jlc-api-2026-11-12`](#src-a7-hx-msk13c02-jlc-api-2026-11-12) — API row C5149819: componentCode, componentModelEn, componentBrandEn
</EvidenceFact>

<EvidenceFact>
  <EvidenceAnchor id="fact-a7-hx-msk13c02-manufacturer" />

  **Fact:** `fact-a7-hx-msk13c02-manufacturer`

  **Value:** hanxia · **Unit:** `NONE`

  **Conditions:** Shenzhen Hanxia Electronic Co., Ltd (brand hanxia) named on the document cover and drawing title block; read from the distributor-served Hanxia document (MANUFACTURER\_MIRROR, Part No. blank); no manufacturer-primary copy

  **Verdict:** UNSOURCED · **Provenance:** UNVERIFIED

  **Evidence:** [src-a7-hx-msk13c02-hanxia-spec: page index 0 cover letterhead; page index 3 title block](#src-a7-hx-msk13c02-hanxia-spec)
</EvidenceFact>

<EvidenceFact>
  <EvidenceAnchor id="fact-a7-hx-msk13c02-document-binding" />

  **Fact:** `fact-a7-hx-msk13c02-document-binding`

  **Value:** The Hanxia specification is bound to HX MSK13C02 / C5149819 only because the distributor serves it for that order code; its Part No. field is blank and its PDF metadata title names LY-SK-23. · **Unit:** `NONE`

  **Conditions:** read from the distributor-served Hanxia document (MANUFACTURER\_MIRROR, Part No. blank); no manufacturer-primary copy

  **Verdict:** UNSOURCED · **Provenance:** UNVERIFIED

  **Evidence:** [src-a7-hx-msk13c02-hanxia-spec: page index 0 cover table row Part No. (blank); PDF Info Title entry](#src-a7-hx-msk13c02-hanxia-spec)
</EvidenceFact>

<EvidenceFact>
  <EvidenceAnchor id="fact-a7-hx-msk13c02-function" />

  **Fact:** `fact-a7-hx-msk13c02-function`

  **Value:** `A`=1-3; `B`=2-3; `C`=3-4; `common`=3 · **Unit:** `NONE`

  **Conditions:** contact schematic on the drawing; with terminal 2 left unconnected this is electrically ON-OFF-ON for terminals 1 and 4, the same table as PCM13SMTR; read from the distributor-served Hanxia document (MANUFACTURER\_MIRROR, Part No. blank); no manufacturer-primary copy

  **Verdict:** UNSOURCED · **Provenance:** UNVERIFIED

  **Evidence:** [src-a7-hx-msk13c02-hanxia-spec: page index 3 figure contact schematic (terminals 1-4, arrows A, B, C)](#src-a7-hx-msk13c02-hanxia-spec)
</EvidenceFact>

<EvidenceFact>
  <EvidenceAnchor id="fact-a7-hx-msk13c02-outline" />

  **Fact:** `fact-a7-hx-msk13c02-outline`

  **Value:** `actuator_projection_beyond_body`=1.5; `actuator_thickness`=1.1; `actuator_width`=1.3; `body_depth`=2.7; `body_length`=9.7; `height_above_pcb`=1.4; `peg_diameter`=0.73; `peg_length`=0.5; `peg_line_to_body_edges`=1.35; `peg_pitch`=5; `terminal_protrusion_beyond_body`=1; `terminal_width`=0.4; `travel_per_position`=1.5 · **Unit:** `mm`

  **Conditions:** untoleranced nominal drawing values; actuator slides parallel to the PCB along the long body edge opposite the terminals (side actuation); pegs centred on the body depth; read from the distributor-served Hanxia document (MANUFACTURER\_MIRROR, Part No. blank); no manufacturer-primary copy

  **Verdict:** UNSOURCED · **Provenance:** UNVERIFIED

  **Evidence:** [src-a7-hx-msk13c02-hanxia-spec: page index 3 figure side, end and top views](#src-a7-hx-msk13c02-hanxia-spec)
</EvidenceFact>

<EvidenceFact>
  <EvidenceAnchor id="fact-a7-hx-msk13c02-recommended-land" />

  **Fact:** `fact-a7-hx-msk13c02-recommended-land`

  **Value:** `hole_diameter`=0.9; `hole_pitch`=5; `retention_pad_centre_x`=5.15; `retention_pad_centre_y`=1.15; `retention_pad_gap_y`=1.4; `retention_pad_height_y`=0.9; `retention_pad_inner_span_x`=9.3; `retention_pad_width_x`=1; `signal_pad_1_x`=-3; `signal_pad_2_x`=-1.5; `signal_pad_3_x`=1.5; `signal_pad_4_x`=3; `signal_pad_far_edge_from_peg_line`=2.65; `signal_pad_length`=1.6; `signal_pad_near_edge_from_peg_line`=1.05; `signal_pad_width`=0.7 · **Unit:** `mm`

  **Conditions:** recommended PCB land read from the drawing (dimension chain 0.7 / 1.5 / 3 / 1.5, 2.65 and 1.05 from the hole line, 0.9 / 1.4 / 0.9, 1 / 9.3 / 1, 2-dia 0.9 at 5); the supplier CAD (src-a7-hx-msk13c02-easyeda-2026-11-12) has the same pad set; read from the distributor-served Hanxia document (MANUFACTURER\_MIRROR, Part No. blank); no manufacturer-primary copy; the drawing numbers terminals 1-4 only in the abstract contact schematic, not on the land or the views, and the land is left-right symmetric, so which end is terminal 1 is not stated there: the signal\_pad\_N\_x numbering (pad 1 at x -3.0 with the actuator on the far side) is inferred from the EasyEDA supplier CAD (src-a7-hx-msk13c02-easyeda-2026-11-12) only

  **Verdict:** UNSOURCED · **Provenance:** UNVERIFIED

  **Evidence:** [src-a7-hx-msk13c02-hanxia-spec: page index 3 figure recommended land view](#src-a7-hx-msk13c02-hanxia-spec)
</EvidenceFact>

<EvidenceFact>
  <EvidenceAnchor id="fact-a7-hx-msk13c02-land-fit" />

  **Fact:** `fact-a7-hx-msk13c02-land-fit`

  **Value:** The A7 controller keeps the existing LightBlockA7:PCM13SMTR land. engineering/a7/electronics/switch-land-fit.json compares it with the Hanxia recommended land: holes identical; every Hanxia pad centre lies inside the matching A7 pad; the A7 pads cover 90.6% of each Hanxia signal pad and 73.9% of each retention pad; the 0.4 mm terminals (1.35 to 2.35 off the peg line) sit wholly on the A7 signal pads with 0.15 mm toe and 0.35 mm heel. · **Unit:** `NONE`

  **Conditions:** digital comparison of nominal drawing values only; solder joint quality and seating need the first-article check

  **Verdict:** NEEDS BENCH · **Provenance:** UNVERIFIED

  **Evidence:** [`src-a7-hx-msk13c02-hanxia-spec`](#src-a7-hx-msk13c02-hanxia-spec) — engineering/a7/electronics/switch-land-fit.json row checks (scripts/a7\_switch\_fit.py)
</EvidenceFact>

<EvidenceFact>
  <EvidenceAnchor id="fact-a7-hx-msk13c02-edge-overhang" />

  **Fact:** `fact-a7-hx-msk13c02-edge-overhang`

  **Value:** With the routed SW1 position unchanged, the 2.7 mm body centred on the pegs puts the actuator tip 0.05 mm past the controller bottom edge (assembly Y 111.45 against the inherited A5 rail-body allowance Y 111.4); the PCM13SMTR (2.6 mm) was flush. · **Unit:** `NONE`

  **Conditions:** nominal, untoleranced drawing values; rails, case and neighbouring modules are not modelled

  **Verdict:** NEEDS BENCH · **Provenance:** UNVERIFIED

  **Evidence:** [`src-a7-hx-msk13c02-hanxia-spec`](#src-a7-hx-msk13c02-hanxia-spec) — engineering/a7/mechanical/layout.json row setting\_switch; engineering/a7/mechanical/exports/\*/verification.json
</EvidenceFact>

<EvidenceFact>
  <EvidenceAnchor id="fact-a7-hx-msk13c02-sourcing" />

  **Fact:** `fact-a7-hx-msk13c02-sourcing`

  **Value:** JLC Extended part, stock 4561, presale 4552, minimum purchase 1, tier 1-49 unit price 0.1069 at 2026-11-12T19:35:14Z · **Unit:** `NONE`

  **Conditions:** dated unreserved observation; no reservation, quote or assembly acceptance

  **Verdict:** UNSOURCED · **Provenance:** UNVERIFIED

  **Evidence:** [src-a7-hx-msk13c02-jlc-api-2026-11-12: exact C5149819 row stockCount, canPresaleNumber, minPurchaseNum, componentPrices](#src-a7-hx-msk13c02-jlc-api-2026-11-12)
</EvidenceFact>

<EvidenceFact>
  <EvidenceAnchor id="fact-a7-hx-msk13c02-a7-placements" />

  **Fact:** `fact-a7-hx-msk13c02-a7-placements`

  **Value:** controller/SW1 x1 (A7 controller schematic and routed board, replacing PCM13SMTR on the same land) · **Unit:** `NONE`

  **Conditions:** project state; owner direction 2026-11-12 (any switch that works, low price, in stock)

  **Verdict:** NEEDS BENCH · **Provenance:** PROJECT-CHOICE

  **Evidence:** [`src-a7-hx-msk13c02-hanxia-spec`](#src-a7-hx-msk13c02-hanxia-spec) — engineering/a7/electronics/controller/controller.kicad\_sch row SW1; engineering/a7/procurement/owner-decisions.json row switch-supply
</EvidenceFact>

<EvidenceFact>
  <EvidenceAnchor id="fact-a7-hx-msk13c02-physical-function" />

  **Fact:** `fact-a7-hx-msk13c02-physical-function`

  **Value:** Physical per-position truth table and reliable contacts on exact received HX MSK13C02 units remain NOT\_MEASURED. · **Unit:** `NONE`

  **Conditions:** unexecuted qualification requirement (switch-fit); no bench record exists

  **Verdict:** NEEDS BENCH · **Provenance:** UNVERIFIED

  **Evidence:** [src-a7-hx-msk13c02-hanxia-spec: page index 3 figure contact schematic; physical observations absent](#src-a7-hx-msk13c02-hanxia-spec)
</EvidenceFact>

<EvidenceFact>
  <EvidenceAnchor id="fact-a7-hx-msk13c02-physical-contact" />

  **Fact:** `fact-a7-hx-msk13c02-physical-contact`

  **Value:** Reliable contact at the actual 3.3 V / 10 kOhm pull-up load remains NOT\_MEASURED; the printed 0.1 A rating does not establish a minimum reliable switching load. · **Unit:** `NONE`

  **Conditions:** unexecuted qualification requirement; no bench record exists

  **Verdict:** NEEDS BENCH · **Provenance:** UNVERIFIED

  **Evidence:** [src-a7-hx-msk13c02-hanxia-spec: page index 1 section 1.1; physical observations absent](#src-a7-hx-msk13c02-hanxia-spec)
</EvidenceFact>

<EvidenceFact>
  <EvidenceAnchor id="fact-a7-hx-msk13c02-physical-fit" />

  **Fact:** `fact-a7-hx-msk13c02-physical-fit`

  **Value:** Actual land and peg fit on the PCM13SMTR-derived land, reflow survival and installed setup access remain NOT\_MEASURED. · **Unit:** `NONE`

  **Conditions:** unexecuted qualification requirement; no bench record exists

  **Verdict:** NEEDS BENCH · **Provenance:** UNVERIFIED

  **Evidence:** [src-a7-hx-msk13c02-hanxia-spec: page index 3 figure drawing; physical observations absent](#src-a7-hx-msk13c02-hanxia-spec)
</EvidenceFact>

## Pin maps

The mapping between schematic pins and PCB pads, or physical terminals for an external part, as recorded. A record may carry more than one map when the same part is documented in more than one context.

### pinmap-a7-hx-msk13c02

<EvidenceAnchor id="pinmap-a7-hx-msk13c02" />

- **Symbol:** `LightBlock:SW_PCM13 (A7 controller library; pin numbers 1-4 are the switch terminals, same contact table)`
- **Footprint:** `LightBlockA7:PCM13SMTR (C&K-derived land kept; fit compared in engineering/a7/electronics/switch-land-fit.json)`
- **Pins:** 4

<EvidenceDetails label="pin-assignments">
  <EvidenceTable label="pin-assignments">
    | Symbol pin | Name      | Footprint pad | Function                                                                        |
    | ---------- | --------- | ------------- | ------------------------------------------------------------------------------- |
    | `1`        | `THROW_1` | `1`           | A7 net MODE\_A (A connects 1-3: MODE\_A=0, MODE\_B=1 -> ON)                     |
    | `2`        | `THROW_2` | `2`           | unconnected (B connects 2-3: both inputs pulled up -> PROGRAM, physical centre) |
    | `3`        | `COMMON`  | `3`           | A7 net GND                                                                      |
    | `4`        | `THROW_4` | `4`           | A7 net MODE\_B (C connects 3-4: MODE\_A=1, MODE\_B=0 -> CV)                     |
  </EvidenceTable>
</EvidenceDetails>

## Interactions

Behaviour that is not a property of this part alone. Each interaction names the records it spans, the conditions it holds under, and how far it has been confirmed. An interaction that spans several parts appears on every one of their pages, under the same identifier, because it is equally a fact about each.

No interaction is published for this record.

## Cross-component rules

Rules that span several parts at once and are published in full on the integration page. Each rule's verdict below is that rule's own — it is a statement about the cross-component question, not about this part — and the exact wording of what the rule refuses to conclude is published with the rule itself.

No cross-component rule names this record.

## Sources

Every document cited above, with its identification, when it was retrieved, and what kind of authority it carries. Sources that could not be retrieved are listed too, with their unavailability stated, so a gap in the evidence is visible rather than absent.

### Shenzhen Hanxia Electronic Co., Ltd slide switch SPECIFICATION FOR APPROVAL (承认书), served by JLCPCB for C5149819

<EvidenceAnchor id="src-a7-hx-msk13c02-hanxia-spec" />

**Source ID:** `src-a7-hx-msk13c02-hanxia-spec` · **Authority:** MANUFACTURER\_MIRROR

| Field | Recorded value |
| --- | --- |
| Document number | none printed (Part No. field blank) |
| Revision | drawing title block 2020.9.10 |
| Document date | 2020-09-10 |
| Retrieved | 2026-11-12 |
| Printed page | none printed (drawing sheet) |

**Locator:** page index 0: Hanxia cover, Part No. blank; page index 1: 1.1 RATING, 1.2 temperature, 2.1-2.3 electrical, 3.1-3.2 operation force and travel; page index 2: 4.1 life test, 4.2-4.4 environment, 4.5 soldering conditions; page index 3: drawing (contact schematic A/B/C, side and top views, recommended land, spec table)

**Availability:** AVAILABLE

**Document URL:** no link is published for this source

### JLCPCB parts search API response (selectSmtComponentList) for C5149819

<EvidenceAnchor id="src-a7-hx-msk13c02-jlc-api-2026-11-12" />

**Source ID:** `src-a7-hx-msk13c02-jlc-api-2026-11-12` · **Authority:** DISTRIBUTOR\_IDENTITY

| Field | Recorded value |
| --- | --- |
| Document number | C5149819 API response |
| Revision | live API 2026-11-12 |
| Document date | 2026-11-12 |
| Retrieved | 2026-11-12 |
| Printed page | n/a (JSON) |

**Locator:** row componentCode C5149819: componentModelEn, componentBrandEn, componentLibraryType, stockCount, canPresaleNumber, minPurchaseNum, componentPrices, describe, dataManualUrl

**Availability:** AVAILABLE

**Document URL:** no link is published for this source

### EasyEDA/LCSC supplier CAD record for C5149819 (footprint SW-SMD\_MSK13C02-BB)

<EvidenceAnchor id="src-a7-hx-msk13c02-easyeda-2026-11-12" />

**Source ID:** `src-a7-hx-msk13c02-easyeda-2026-11-12` · **Authority:** DISTRIBUTOR\_IDENTITY

| Field | Recorded value |
| --- | --- |
| Document number | C5149819 EasyEDA component  |
| Revision | updated 2025-02-27 02:25:06 |
| Document date | 2025-02-27 |
| Retrieved | 2026-11-12 |
| Printed page | n/a (JSON) |

**Locator:** result.packageDetail.dataStr.shape PAD and HOLE rows (EasyEDA units 10 mil = 0.254 mm)

**Availability:** AVAILABLE

**Document URL:** no link is published for this source

## Legend

What the recorded terms on this page mean, in ordinary words. The exact terms above are the ones that count; these descriptions explain them and never replace them.

### Verdict

| Recorded term | What it means |
| --- | --- |
| `CONFIRMED - distributor identity only` | A distributor listing confirms which part this is, and nothing more. It carries no electrical, thermal or lifetime authority. |
| `NEEDS BENCH` | Cannot be settled from documents. It needs measurement on real hardware before it can be relied on. |
| `UNSOURCED` | No accepted source backs this value yet. Treat it as a claim, not a fact. |

### Provenance

| Recorded term | What it means |
| --- | --- |
| `DISTRIBUTOR-IDENTITY` | Taken from a distributor listing. Identity information only. |
| `PROJECT-CHOICE` | A decision made by this project. No vendor asserts it. |
| `UNVERIFIED` | Recorded, but not yet backed by an accepted source. |

### Fact class

| Recorded term | What it means |
| --- | --- |
| `ABSOLUTE_MAXIMUM` | A never-exceed limit. Reaching it may damage the part; it is not an operating target and there is no margin implied by it. |
| `GUARANTEED_ELECTRICAL` | A parameter the manufacturer guarantees over the stated conditions, usually with minimum, typical and maximum values. |
| `PROJECT_STATE` | A value this project recorded about how the part is used here — a chosen operating point, a net assignment, or a derived figure. Not a manufacturer specification. |
| `RECOMMENDED_OPERATION` | The range the manufacturer intends the part to be used in. Always narrower than the absolute maximum. |

### Coverage status

| Recorded term | What it means |
| --- | --- |
| `OPEN` | Unresolved. Open means the question has not been answered, not that the part is unsafe — the reason states what is missing. |

### Source availability

| Recorded term | What it means |
| --- | --- |
| `AVAILABLE` | The document was retrieved and is on record. |

### Source authority

| Recorded term | What it means |
| --- | --- |
| `DISTRIBUTOR_IDENTITY` | A distributor listing. Establishes which part this is, nothing more. |
| `MANUFACTURER_MIRROR`  | A copy of a manufacturer document hosted elsewhere. Usable, but weaker than the manufacturer's own copy. |

### Identity state

| Recorded term | What it means |
| --- | --- |
| `UNRESOLVED`  | The exact orderable part is not yet confirmed. Substituting a same-name part from another vendor is not permitted on that basis. |

### Source state

| Recorded term | What it means |
| --- | --- |
| `AVAILABLE` | At least one document backing this line was retrieved. |

### Unit

| Recorded term | What it means |
| --- | --- |
| `NONE` | The value is not a physical quantity, so it carries no unit. Recorded as \`NONE\`. |

## Raw agent resource

This page is generated from a stored evidence bundle and does not restate it. The bundle is the source of truth: where the two ever disagree, the bundle is right and this page is stale.

[Open the owning bundle](/docs/claude-skills/component-a7-hx-msk13c02/) `component-a7-hx-msk13c02`
