Takazudo/zudo-led-block/doc/src/content/docs/components/records/a7-pcm13smtr/index.mdx

---
# GENERATED by @takazudo/zudo-circuit-doc — do not edit; run `zudo-circuit-doc generate`
title: "PCM13SMTR"
description: "A7 side mode setting switch (superseded on SW1 by line-a7-hx-msk13c02, 2026-11-12; no placement) — C&K — C221842 — no placement published — rec-a7-pcm13smtr"
sidebar_position: 33
---

<EvidenceAnchor id="rec-a7-pcm13smtr" />

Generated from the component evidence records — edit the records, not this page.

Everything below is projected from this project's stored component evidence. Values keep the exact wording, conditions, units and verdicts they were recorded with — nothing here is re-typed, corrected, or combined into an overall judgement about the part.

This record in the catalog: [PCM13SMTR](/docs/components/catalog/#rec-a7-pcm13smtr)

## Identity

| Field | Recorded value |
| --- | --- |
| Record ID | `rec-a7-pcm13smtr` |
| Record kind | standalone |
| Manufacturer part number | `PCM13SMTR` |
| Manufacturer | C\&K |
| Function | A7 side mode setting switch (superseded on SW1 by line-a7-hx-msk13c02, 2026-11-12; no placement) |
| LCSC ID | `C221842` |
| Package | `SMD` |
| Inventory line | `line-a7-pcm13smtr` |
| Also known as | `A7 side mode setting switch` |
| Owner skill | `component-a7-pcm13smtr` |

**Fit:** Fitted

**Identity state:** VERIFIED

**Source state:** AVAILABLE

**Coverage:** 5 open of 6 published

## Documents and package

<EvidenceAnchor id="component-references-heading" />

<EvidenceAnchor id="component-references" />

[Datasheet PDF](https://www.littelfuse.com/assetdocs/littelfuse-ck-slide-pcm-series-datasheet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) — C\&K PCM Series Ultraminiature Surface Mount Slide Switches

**Selected source ID:** `src-a7-pcm13smtr-ck-site`

**Authority:** MANUFACTURER\_PRIMARY

**Availability:** AVAILABLE

No footprint or 3D model is published for this record: CAD is not enabled for this project.

## Placements

No board placement is published for this record.

## Coverage

Coverage is stated one domain at a time and is never rolled up. A domain marked open is a question that has not been answered; it is not a finding that the part is unsuitable. A record with no open domains has not thereby been declared safe.

### identity

<EvidenceAnchor id="cov-a7-pcm13smtr-identity" />

**Coverage ID:** `cov-a7-pcm13smtr-identity` · **Status:** COVERED

**Reason:** Exact manufacturer identity/order scheme inspected in primary document; stock and assembly qualification remain separate.

**Facts in this domain:**

- [`fact-a7-pcm13smtr-manufacturer`](#fact-a7-pcm13smtr-manufacturer)
- [`fact-a7-pcm13smtr-distributor-identity`](#fact-a7-pcm13smtr-distributor-identity)

### pinout

<EvidenceAnchor id="cov-a7-pcm13smtr-function" />

**Coverage ID:** `cov-a7-pcm13smtr-function` · **Status:** OPEN

**Reason:** Physical per-position truth table and reliable contacts on exact received PCM13SMTR units remain NOT\_MEASURED.

**Facts in this domain:**

- [`fact-a7-pcm13smtr-function`](#fact-a7-pcm13smtr-function)
- [`fact-a7-pcm13smtr-physical-function`](#fact-a7-pcm13smtr-physical-function)

**Blocked by:** these facts must be resolved before the domain can close. Each is listed in full under Facts.

- [`fact-a7-pcm13smtr-physical-function`](#fact-a7-pcm13smtr-physical-function)

### electrical-ratings

<EvidenceAnchor id="cov-a7-pcm13smtr-ratings" />

**Coverage ID:** `cov-a7-pcm13smtr-ratings` · **Status:** OPEN

**Reason:** Reliable contact at the actual 3.3 V / 10 kOhm pull-up load remains NOT\_MEASURED; the printed 0.3 A rating does not establish a minimum reliable switching load.

**Facts in this domain:**

- [`fact-a7-pcm13smtr-contact-rating`](#fact-a7-pcm13smtr-contact-rating)
- [`fact-a7-pcm13smtr-life`](#fact-a7-pcm13smtr-life)
- [`fact-a7-pcm13smtr-operating-temperature`](#fact-a7-pcm13smtr-operating-temperature)
- [`fact-a7-pcm13smtr-solder`](#fact-a7-pcm13smtr-solder)
- [`fact-a7-pcm13smtr-physical-contact`](#fact-a7-pcm13smtr-physical-contact)

**Blocked by:** these facts must be resolved before the domain can close. Each is listed in full under Facts.

- [`fact-a7-pcm13smtr-physical-contact`](#fact-a7-pcm13smtr-physical-contact)

### mechanical

<EvidenceAnchor id="cov-a7-pcm13smtr-mechanical" />

**Coverage ID:** `cov-a7-pcm13smtr-mechanical` · **Status:** OPEN

**Reason:** Actual land/peg fit, assumed body-to-peg centering and installed setup access remain NOT\_MEASURED.

**Facts in this domain:**

- [`fact-a7-pcm13smtr-outline`](#fact-a7-pcm13smtr-outline)
- [`fact-a7-pcm13smtr-orientation-discrepancy`](#fact-a7-pcm13smtr-orientation-discrepancy)
- [`fact-a7-pcm13smtr-physical-fit`](#fact-a7-pcm13smtr-physical-fit)

**Blocked by:** these facts must be resolved before the domain can close. Each is listed in full under Facts.

- [`fact-a7-pcm13smtr-physical-fit`](#fact-a7-pcm13smtr-physical-fit)

### sourcing

<EvidenceAnchor id="cov-a7-pcm13smtr-sourcing" />

**Coverage ID:** `cov-a7-pcm13smtr-sourcing` · **Status:** OPEN

**Reason:** JLC stock and presale both 0 on 2026-11-09; assembly supply remains unresolved.

**Facts in this domain:**

- [`fact-a7-pcm13smtr-sourcing`](#fact-a7-pcm13smtr-sourcing)

**Blocked by:** these facts must be resolved before the domain can close. Each is listed in full under Facts.

- [`fact-a7-pcm13smtr-sourcing`](#fact-a7-pcm13smtr-sourcing)

### placement

<EvidenceAnchor id="cov-a7-pcm13smtr-placement" />

**Coverage ID:** `cov-a7-pcm13smtr-placement` · **Status:** OPEN

**Reason:** no A7 schematic or board yet

**Facts in this domain:**

- [`fact-a7-pcm13smtr-a7-placements`](#fact-a7-pcm13smtr-a7-placements)

**Blocked by:** these facts must be resolved before the domain can close. Each is listed in full under Facts.

- [`fact-a7-pcm13smtr-a7-placements`](#fact-a7-pcm13smtr-a7-placements)

## Facts

Each fact keeps its value, its unit, the conditions it holds under, where it came from and how far it has been confirmed as separate fields, because they are separate claims. A value without its conditions is not the same fact, and a verdict is about the evidence for the value, not about the part.

### ABSOLUTE\_MAXIMUM

A never-exceed limit. Reaching it may damage the part; it is not an operating target and there is no margin implied by it.

<EvidenceFact>
  <EvidenceAnchor id="fact-a7-pcm13smtr-solder" />

  **Fact:** `fact-a7-pcm13smtr-solder`

  **Value:** 255 C max solder temperature · **Unit:** `NONE`

  **Conditions:** solderability limit; standard lead-free reflow peaks usually 245-250 C, to be confirmed against the assembler profile; manufacturer-primary VL 03/14/25 inspected; physical fit/contact qualification remains open.

  **Verdict:** PASS - primary-source confirmed · **Provenance:** PRIMARY-SPEC

  **Evidence:** [src-a7-pcm13smtr-ck-site: figure/row page index 0 Specifications](#src-a7-pcm13smtr-ck-site)
</EvidenceFact>

### RECOMMENDED\_OPERATION

The range the manufacturer intends the part to be used in. Always narrower than the absolute maximum.

<EvidenceFact>
  <EvidenceAnchor id="fact-a7-pcm13smtr-contact-rating" />

  **Fact:** `fact-a7-pcm13smtr-contact-rating`

  **Value:** 0.3 A @ 6 VDC · **Unit:** `NONE`

  **Conditions:** contact rating; A7 load is a 10 kOhm pull-up to 3.3 V (0.33 mA); manufacturer-primary VL 03/14/25 inspected; physical fit/contact qualification remains open.

  **Verdict:** PASS - primary-source confirmed · **Provenance:** PRIMARY-SPEC

  **Evidence:** [src-a7-pcm13smtr-ck-site: figure/row page index 0 Specifications](#src-a7-pcm13smtr-ck-site)
</EvidenceFact>

<EvidenceFact>
  <EvidenceAnchor id="fact-a7-pcm13smtr-life" />

  **Fact:** `fact-a7-pcm13smtr-life`

  **Value:** 10000 · **Unit:** `cycles`

  **Conditions:** electrical life; manufacturer-primary VL 03/14/25 inspected; physical fit/contact qualification remains open.

  **Verdict:** PASS - primary-source confirmed · **Provenance:** PRIMARY-SPEC

  **Evidence:** [src-a7-pcm13smtr-ck-site: figure/row page index 0 Specifications](#src-a7-pcm13smtr-ck-site)
</EvidenceFact>

<EvidenceFact>
  <EvidenceAnchor id="fact-a7-pcm13smtr-operating-temperature" />

  **Fact:** `fact-a7-pcm13smtr-operating-temperature`

  **Value:** -40 to +85 · **Unit:** `C`

  **Conditions:** 2025 manufacturer primary revision; historical 2022 mirror -10..85 C and JLC -20..85 C differ. Not physical qualification.

  **Verdict:** PASS - primary-source confirmed · **Provenance:** PRIMARY-SPEC

  **Evidence:** [src-a7-pcm13smtr-ck-site: figure/row page index 0 Specifications](#src-a7-pcm13smtr-ck-site)
</EvidenceFact>

### PROJECT\_STATE

A value this project recorded about how the part is used here — a chosen operating point, a net assignment, or a derived figure. Not a manufacturer specification.

<EvidenceFact>
  <EvidenceAnchor id="fact-a7-pcm13smtr-distributor-identity" />

  **Fact:** `fact-a7-pcm13smtr-distributor-identity`

  **Value:** `lcsc`=C221842; `manufacturer`=C\&K; `mpn`=PCM13SMTR; `variant`=SMD · **Unit:** `NONE`

  **Conditions:** order-code identity only

  **Verdict:** CONFIRMED - distributor identity only · **Provenance:** DISTRIBUTOR-IDENTITY

  **Evidence:** [`src-a7-jlc-parts-api-2026-11-08`](#src-a7-jlc-parts-api-2026-11-08) — API row C221842: componentCode, componentModelEn, componentBrandEn
</EvidenceFact>

<EvidenceFact>
  <EvidenceAnchor id="fact-a7-pcm13smtr-manufacturer" />

  **Fact:** `fact-a7-pcm13smtr-manufacturer`

  **Value:** C\&K · **Unit:** `NONE`

  **Conditions:** C\&K PCM Series; How To Order: 13 = SP3T, SMT termination, R = tape & reel, no contact suffix = silver; manufacturer-primary VL 03/14/25 inspected; physical fit/contact qualification remains open.

  **Verdict:** PASS - primary-source confirmed · **Provenance:** PRIMARY-SPEC

  **Evidence:** [src-a7-pcm13smtr-ck-site: figure/row page index 0 How To Order](#src-a7-pcm13smtr-ck-site)
</EvidenceFact>

<EvidenceFact>
  <EvidenceAnchor id="fact-a7-pcm13smtr-function" />

  **Fact:** `fact-a7-pcm13smtr-function`

  **Value:** `POS.1`=1-3; `POS.2`=2-3; `POS.3`=3-4; `common`=3 · **Unit:** `NONE`

  **Conditions:** switch function table; with terminal 2 left unconnected this is electrically ON-OFF-ON for terminals 1 and 4; manufacturer-primary VL 03/14/25 inspected; physical fit/contact qualification remains open.

  **Verdict:** PASS - primary-source confirmed · **Provenance:** PRIMARY-SPEC

  **Evidence:** [src-a7-pcm13smtr-ck-site: page index 2 SWITCH FUNCTION table](#src-a7-pcm13smtr-ck-site)
</EvidenceFact>

<EvidenceFact>
  <EvidenceAnchor id="fact-a7-pcm13smtr-outline" />

  **Fact:** `fact-a7-pcm13smtr-outline`

  **Value:** `actuator_projection_beyond_body`=1.5; `actuator_width`=1.3; `body_depth`=2.6; `body_length`=9.7; `height_above_pcb`=1.4; `land_hole_diameter_typ`=0.9; `peg_diameter`=0.8; `peg_length`=0.5; `peg_pitch`=5; `travel_per_position`=1.5 · **Unit:** `mm`

  **Conditions:** outline read from the dimensioned drawing (inch primary, mm in brackets); actuator moves parallel to the PCB along the body edge (side actuation); manufacturer-primary VL 03/14/25 inspected; physical fit/contact qualification remains open.

  **Verdict:** PASS - primary-source confirmed · **Provenance:** PRIMARY-SPEC

  **Evidence:** [src-a7-pcm13smtr-ck-site: figure/row page index 2 outline and PC MOUNTING](#src-a7-pcm13smtr-ck-site)
</EvidenceFact>

<EvidenceFact>
  <EvidenceAnchor id="fact-a7-pcm13smtr-orientation-discrepancy" />

  **Fact:** `fact-a7-pcm13smtr-orientation-discrepancy`

  **Value:** actuator projects from the long body edge and slides parallel to the PCB (side actuation) · **Unit:** `NONE`

  **Conditions:** the JLC listing describes the part as 'Surface Mount, Vertical'; the manufacturer outline governs and R2 must place the actuator at a PCB edge; manufacturer-primary VL 03/14/25 inspected; physical fit/contact qualification remains open.

  **Verdict:** PASS - primary-source confirmed · **Provenance:** PRIMARY-SPEC

  **Evidence:** [src-a7-pcm13smtr-ck-site: page index 2 figure outline, actuator](#src-a7-pcm13smtr-ck-site)
</EvidenceFact>

<EvidenceFact>
  <EvidenceAnchor id="fact-a7-pcm13smtr-sourcing" />

  **Fact:** `fact-a7-pcm13smtr-sourcing`

  **Value:** JLC stock 0, presale 0 at 2026-11-09T09:18:55Z · **Unit:** `NONE`

  **Conditions:** Dated unreserved observation; no lead time or assembly acceptance obtained; procurement remains blocked.

  **Verdict:** UNSOURCED · **Provenance:** UNVERIFIED

  **Evidence:** [figure/row src-a7-pcm13smtr-jlc-stock-2026-11-09: exact C221842 stock row](#src-a7-pcm13smtr-jlc-stock-2026-11-09)
</EvidenceFact>

<EvidenceFact>
  <EvidenceAnchor id="fact-a7-pcm13smtr-a7-placements" />

  **Fact:** `fact-a7-pcm13smtr-a7-placements`

  **Value:** none since 2026-11-12: controller/SW1 is fitted with hanxia HX MSK13C02 (C5149819, #77); was controller/SW1 x1 · **Unit:** `NONE`

  **Conditions:** A7 plan from the accepted brief

  **Verdict:** NEEDS BENCH · **Provenance:** PROJECT-CHOICE

  **Evidence:** [`src-a7-pcm13smtr-ck-datasheet`](#src-a7-pcm13smtr-ck-datasheet) — A7 owner brief section 2 (accepted product direction), issue #15 body
</EvidenceFact>

<EvidenceFact>
  <EvidenceAnchor id="fact-a7-pcm13smtr-physical-function" />

  **Fact:** `fact-a7-pcm13smtr-physical-function`

  **Value:** Physical per-position truth table and reliable contacts on exact received PCM13SMTR units remain NOT\_MEASURED. · **Unit:** `NONE`

  **Conditions:** Unexecuted qualification requirement; primary document confirms specifications only, not unit observations. No bench record exists.

  **Verdict:** NEEDS BENCH · **Provenance:** UNVERIFIED

  **Evidence:** [src-a7-pcm13smtr-ck-site: printed page 1 Specifications; page 3 PCM13SMTR figure/table; physical observations absent](#src-a7-pcm13smtr-ck-site)
</EvidenceFact>

<EvidenceFact>
  <EvidenceAnchor id="fact-a7-pcm13smtr-physical-contact" />

  **Fact:** `fact-a7-pcm13smtr-physical-contact`

  **Value:** Reliable contact at the actual 3.3 V / 10 kOhm pull-up load remains NOT\_MEASURED; the printed 0.3 A rating does not establish a minimum reliable switching load. · **Unit:** `NONE`

  **Conditions:** Unexecuted qualification requirement; primary document confirms specifications only, not unit observations. No bench record exists.

  **Verdict:** NEEDS BENCH · **Provenance:** UNVERIFIED

  **Evidence:** [src-a7-pcm13smtr-ck-site: printed page 1 Specifications; page 3 PCM13SMTR figure/table; physical observations absent](#src-a7-pcm13smtr-ck-site)
</EvidenceFact>

<EvidenceFact>
  <EvidenceAnchor id="fact-a7-pcm13smtr-physical-fit" />

  **Fact:** `fact-a7-pcm13smtr-physical-fit`

  **Value:** Actual land/peg fit, assumed body-to-peg centering and installed setup access remain NOT\_MEASURED. · **Unit:** `NONE`

  **Conditions:** Unexecuted qualification requirement; primary document confirms specifications only, not unit observations. No bench record exists.

  **Verdict:** NEEDS BENCH · **Provenance:** UNVERIFIED

  **Evidence:** [src-a7-pcm13smtr-ck-site: printed page 1 Specifications; page 3 PCM13SMTR figure/table; physical observations absent](#src-a7-pcm13smtr-ck-site)
</EvidenceFact>

## Pin maps

The mapping between schematic pins and PCB pads, or physical terminals for an external part, as recorded. A record may carry more than one map when the same part is documented in more than one context.

### pinmap-a7-pcm13smtr

<EvidenceAnchor id="pinmap-a7-pcm13smtr" />

- **Symbol:** `not yet drawn (R4)`
- **Footprint:** `not yet drawn (R4)`
- **Pins:** 4

<EvidenceDetails label="pin-assignments">
  <EvidenceTable label="pin-assignments">
    | Symbol pin | Name      | Footprint pad | Function                                                                                     |
    | ---------- | --------- | ------------- | -------------------------------------------------------------------------------------------- |
    | `1`        | `THROW_1` | `1`           | proposed A7 net MODE\_A (POS.1 connects 1-3: MODE\_A=0, MODE\_B=1 -> ON)                     |
    | `2`        | `THROW_2` | `2`           | proposed unconnected (POS.2 connects 2-3: both inputs pulled up -> PROGRAM, physical centre) |
    | `3`        | `COMMON`  | `3`           | proposed A7 net GND                                                                          |
    | `4`        | `THROW_3` | `4`           | proposed A7 net MODE\_B (POS.3 connects 3-4: MODE\_A=1, MODE\_B=0 -> CV)                     |
  </EvidenceTable>
</EvidenceDetails>

## Interactions

Behaviour that is not a property of this part alone. Each interaction names the records it spans, the conditions it holds under, and how far it has been confirmed. An interaction that spans several parts appears on every one of their pages, under the same identifier, because it is equally a fact about each.

No interaction is published for this record.

## Cross-component rules

Rules that span several parts at once and are published in full on the integration page. Each rule's verdict below is that rule's own — it is a statement about the cross-component question, not about this part — and the exact wording of what the rule refuses to conclude is published with the rule itself.

No cross-component rule names this record.

## Sources

Every document cited above, with its identification, when it was retrieved, and what kind of authority it carries. Sources that could not be retrieved are listed too, with their unavailability stated, so a gap in the evidence is visible rather than absent.

### C\&K PCM Series Ultraminiature Surface Mount Slide Switches (PCM12SMTR / PCM13SMTR), pages I-46..I-48

<EvidenceAnchor id="src-a7-pcm13smtr-ck-datasheet" />

**Source ID:** `src-a7-pcm13smtr-ck-datasheet` · **Authority:** MANUFACTURER\_MIRROR

| Field | Recorded value |
| --- | --- |
| Document number | PCM Series |
| Revision | 16 Mar 22 |
| Document date | 2022-03-16 |
| Retrieved | 2026-11-08 |
| Printed page | I-48 |

**Locator:** page index 0 (I-46): Specifications; page index 2 (I-48): PCM13SMTR switch-function table, schematic, outline, PC MOUNTING land pattern

**Availability:** AVAILABLE

**Document URL:** no link is published for this source

### C\&K PCM Series Ultraminiature Surface Mount Slide Switches

<EvidenceAnchor id="src-a7-pcm13smtr-ck-site" />

**Source ID:** `src-a7-pcm13smtr-ck-site` · **Authority:** MANUFACTURER\_PRIMARY

| Field | Recorded value |
| --- | --- |
| Document number | PCM Series |
| Revision | VL 03/14/25 |
| Document date | 2025-03-14 |
| Retrieved | 2026-11-09 |
| Printed page | 1 |

**Locator:** printed 1: specifications/order scheme; printed 3 (index 2): PCM13SMTR contact table and drawing

**Availability:** AVAILABLE

**Document URL:** [https://www.littelfuse.com/assetdocs/littelfuse-ck-slide-pcm-series-datasheet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](https://www.littelfuse.com/assetdocs/littelfuse-ck-slide-pcm-series-datasheet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)

### LCSC product page C221842 (HTML)

<EvidenceAnchor id="src-a7-pcm13smtr-lcsc-listing" />

**Source ID:** `src-a7-pcm13smtr-lcsc-listing` · **Authority:** DISTRIBUTOR\_IDENTITY

| Field | Recorded value |
| --- | --- |
| Document number | C221842 |
| Revision | live page |
| Document date | 2026-11-08 |
| Retrieved | 2026-11-08 |
| Printed page | n/a (HTML) |

**Locator:** HTML \<title> element row: product name, category, brand

**Availability:** AVAILABLE

**Document URL:** no link is published for this source

### JLCPCB parts search API responses (selectSmtComponentList) for C22355739, C221842, C2921714

<EvidenceAnchor id="src-a7-jlc-parts-api-2026-11-08" />

**Source ID:** `src-a7-jlc-parts-api-2026-11-08` · **Authority:** DISTRIBUTOR\_IDENTITY

| Field | Recorded value |
| --- | --- |
| Document number | C221842 API response |
| Revision | live API |
| Document date | 2026-11-08 |
| Retrieved | 2026-11-08 |
| Printed page | n/a (JSON) |

**Locator:** result row data.componentPageInfo.list\[0], fields componentCode, componentModelEn, componentBrandEn, componentLibraryType, stockCount, describe, dataManualUrl

**Availability:** AVAILABLE

**Document URL:** no link is published for this source

### JLC exact C221842 stock observation

<EvidenceAnchor id="src-a7-pcm13smtr-jlc-stock-2026-11-09" />

**Source ID:** `src-a7-pcm13smtr-jlc-stock-2026-11-09` · **Authority:** DISTRIBUTOR\_IDENTITY

| Field | Recorded value |
| --- | --- |
| Document number | C221842 API response |
| Revision | live API 2026-11-09  |
| Document date | 2026-11-09 |
| Retrieved | 2026-11-09 |
| Printed page | n/a (JSON) |

**Locator:** figure/row componentCode C221842 row; stockCount,canPresaleNumber,minPurchaseNum,encapsulationNumber,estimateDate

**Availability:** AVAILABLE

**Document URL:** no link is published for this source

## Legend

What the recorded terms on this page mean, in ordinary words. The exact terms above are the ones that count; these descriptions explain them and never replace them.

### Verdict

| Recorded term | What it means |
| --- | --- |
| `CONFIRMED - distributor identity only` | A distributor listing confirms which part this is, and nothing more. It carries no electrical, thermal or lifetime authority. |
| `NEEDS BENCH` | Cannot be settled from documents. It needs measurement on real hardware before it can be relied on. |
| `PASS - primary-source confirmed` | Confirmed against the manufacturer's own document for this exact part. |
| `UNSOURCED` | No accepted source backs this value yet. Treat it as a claim, not a fact. |

### Provenance

| Recorded term | What it means |
| --- | --- |
| `DISTRIBUTOR-IDENTITY` | Taken from a distributor listing. Identity information only. |
| `PRIMARY-SPEC` | Taken from the manufacturer's own specification document. |
| `PROJECT-CHOICE` | A decision made by this project. No vendor asserts it. |
| `UNVERIFIED` | Recorded, but not yet backed by an accepted source. |

### Fact class

| Recorded term | What it means |
| --- | --- |
| `ABSOLUTE_MAXIMUM` | A never-exceed limit. Reaching it may damage the part; it is not an operating target and there is no margin implied by it. |
| `PROJECT_STATE` | A value this project recorded about how the part is used here — a chosen operating point, a net assignment, or a derived figure. Not a manufacturer specification. |
| `RECOMMENDED_OPERATION` | The range the manufacturer intends the part to be used in. Always narrower than the absolute maximum. |

### Coverage status

| Recorded term | What it means |
| --- | --- |
| `COVERED` | Every question this domain asks is answered by the facts listed against it. |
| `OPEN` | Unresolved. Open means the question has not been answered, not that the part is unsafe — the reason states what is missing. |

### Source availability

| Recorded term | What it means |
| --- | --- |
| `AVAILABLE` | The document was retrieved and is on record. |

### Source authority

| Recorded term | What it means |
| --- | --- |
| `DISTRIBUTOR_IDENTITY` | A distributor listing. Establishes which part this is, nothing more. |
| `MANUFACTURER_MIRROR`  | A copy of a manufacturer document hosted elsewhere. Usable, but weaker than the manufacturer's own copy. |
| `MANUFACTURER_PRIMARY` | The manufacturer's own document for this exact part. |

### Identity state

| Recorded term | What it means |
| --- | --- |
| `VERIFIED` | The exact orderable part has been confirmed against a source. |

### Source state

| Recorded term | What it means |
| --- | --- |
| `AVAILABLE` | At least one document backing this line was retrieved. |

### Unit

| Recorded term | What it means |
| --- | --- |
| `NONE` | The value is not a physical quantity, so it carries no unit. Recorded as \`NONE\`. |

## Raw agent resource

This page is generated from a stored evidence bundle and does not restate it. The bundle is the source of truth: where the two ever disagree, the bundle is right and this page is stale.

[Open the owning bundle](/docs/claude-skills/component-a7-pcm13smtr/) `component-a7-pcm13smtr`
