Takazudo/zudo-led-block/doc/src/content/docs/components/records/molex-530470310/index.mdx

---
# GENERATED by @takazudo/zudo-circuit-doc — do not edit; run `zudo-circuit-doc generate`
title: "530470310"
description: "three-pin power cable header — MOLEX — C122442 — controller J5; power_adapter J2 — rec-molex-530470310"
sidebar_position: 2
---

<EvidenceAnchor id="rec-molex-530470310" />

Generated from the component evidence records — edit the records, not this page.

Everything below is projected from this project's stored component evidence. Values keep the exact wording, conditions, units and verdicts they were recorded with — nothing here is re-typed, corrected, or combined into an overall judgement about the part.

This record in the catalog: [530470310](/docs/components/catalog/#rec-molex-530470310)

## Identity

| Field | Recorded value |
| --- | --- |
| Record ID | `rec-molex-530470310` |
| Record kind | standalone |
| Manufacturer part number | `530470310` |
| Manufacturer | MOLEX |
| Function | three-pin power cable header |
| LCSC ID | `C122442` |
| Package | `Plugin,P=1.25mm` |
| Inventory line | `line-530470310` |
| Owner skill | `component-530470310` |

**Fit:** Fitted

**Identity state:** VERIFIED

**Source state:** AVAILABLE

**Coverage:** 3 open of 6 published

## Documents and package

<EvidenceAnchor id="component-references-heading" />

<EvidenceAnchor id="component-references" />

[Mechanical drawing PDF](https://www.molex.com/content/dam/molex/molex-dot-com/products/automated/en-us/salesdrawingpdf/530/53047/530470310_sd.pdf) — Molex PicoBlade 1.25 header sales drawing

**Selected source ID:** `src-530470310-sd`

**Authority:** MANUFACTURER\_PRIMARY

**Availability:** AVAILABLE

No footprint or 3D model is published for this record: CAD is not enabled for this project.

## Placements

Every position this exact line occupies in the as-built design. One line may be placed many times and across more than one board.

| Board | Reference designator |
| --- | --- |
| controller | `J5` |
| power\_adapter | `J2` |

## Coverage

Coverage is stated one domain at a time and is never rolled up. A domain marked open is a question that has not been answered; it is not a finding that the part is unsuitable. A record with no open domains has not thereby been declared safe.

### identity

<EvidenceAnchor id="cov-530470310-identity" />

**Coverage ID:** `cov-530470310-identity` · **Status:** COVERED

**Reason:** Exact manufacturer identity/order scheme inspected in primary document; stock and assembly qualification remain separate.

**Facts in this domain:**

- [`fact-530470310-manufacturer`](#fact-530470310-manufacturer)
- [`fact-530470310-distributor-identity`](#fact-530470310-distributor-identity)

### mechanical

<EvidenceAnchor id="cov-530470310-mechanical" />

**Coverage ID:** `cov-530470310-mechanical` · **Status:** COVERED

**Reason:** terminal tail length below the housing seating plane is primary-source confirmed from the Molex sales drawing; fit, solder fillet and fixture clearance are not qualified

**Facts in this domain:**

- [`fact-530470310-tail-length`](#fact-530470310-tail-length)

### pinout

<EvidenceAnchor id="cov-530470310-pinout" />

**Coverage ID:** `cov-530470310-pinout` · **Status:** OPEN

**Reason:** Primary document acquired on 2026-11-09. This domain remains OPEN: per-criterion electrical/mechanical/pin-map review and applicable physical qualification incomplete

**Facts in this domain:**

- [`fact-530470310-pinout`](#fact-530470310-pinout)

**Blocked by:** these facts must be resolved before the domain can close. Each is listed in full under Facts.

- [`fact-530470310-pinout`](#fact-530470310-pinout)

### electrical-ratings

<EvidenceAnchor id="cov-530470310-ratings" />

**Coverage ID:** `cov-530470310-ratings` · **Status:** COVERED

**Reason:** voltage, rated current by wire gauge, ambient temperature and mating durability are primary-source confirmed from Molex 510211110-PS rev A; finished-cable and installed temperature rise are not qualified

**Facts in this domain:**

- [`fact-530470310-ratings`](#fact-530470310-ratings)
- [`fact-530470310-operating-temperature`](#fact-530470310-operating-temperature)
- [`fact-530470310-durability`](#fact-530470310-durability)

### placement

<EvidenceAnchor id="cov-530470310-placement" />

**Coverage ID:** `cov-530470310-placement` · **Status:** OPEN

**Reason:** fact-530470310-a5-placements NEEDS BENCH: placements are declared from the historical A5 netlist only; the manual provider performs no schematic binding and no as-built check exists

**Facts in this domain:**

- [`fact-530470310-a5-placements`](#fact-530470310-a5-placements)

**Blocked by:** these facts must be resolved before the domain can close. Each is listed in full under Facts.

- [`fact-530470310-a5-placements`](#fact-530470310-a5-placements)

### cad-assets

<EvidenceAnchor id="cov-530470310-cad" />

**Coverage ID:** `cov-530470310-cad` · **Status:** OPEN

**Reason:** fact-530470310-cad-state remains UNSOURCED: catalog CAD is disabled, so no symbol, footprint or model was reviewed or validated

**Facts in this domain:**

- [`fact-530470310-cad-state`](#fact-530470310-cad-state)

**Blocked by:** these facts must be resolved before the domain can close. Each is listed in full under Facts.

- [`fact-530470310-cad-state`](#fact-530470310-cad-state)

## Facts

Each fact keeps its value, its unit, the conditions it holds under, where it came from and how far it has been confirmed as separate fields, because they are separate claims. A value without its conditions is not the same fact, and a verdict is about the evidence for the value, not about the part.

### RECOMMENDED\_OPERATION

The range the manufacturer intends the part to be used in. Always narrower than the absolute maximum.

<EvidenceFact>
  <EvidenceAnchor id="fact-530470310-ratings" />

  **Fact:** `fact-530470310-ratings`

  **Value:** 125 V AC rms / DC; rated current (max.) 1.0 A with AWG 26-30 wire, 0.8 A with AWG 32 · **Unit:** `NONE`

  **Conditions:** Molex 510211110-PS rev A (covers 53047\*\*10). The table states the rated current by wire size only; reading it as a per-circuit (per-terminal) value is the usual interpretation, not printed text. The rated current depends on the crimped wire gauge of the mating receptacle; the derating table (reference only, 30 C rise, all circuits powered) has no 3-circuit column. Ratings of the connector system, not of the finished cable, the board or the installed temperature rise.

  **Verdict:** PASS - primary-source confirmed · **Provenance:** PRIMARY-SPEC

  **Evidence:** [src-530470310-ps-p3: sections 4.1 VOLTAGE and 4.2 RATED CURRENT AND APPLICABLE WIRES](#src-530470310-ps-p3)
</EvidenceFact>

<EvidenceFact>
  <EvidenceAnchor id="fact-530470310-operating-temperature" />

  **Fact:** `fact-530470310-operating-temperature`

  **Value:** -40 to +85 · **Unit:** `C`

  **Conditions:** ambient temperature range including terminal temperature rise; the mating wires must also meet it; Molex 510211110-PS rev A. Not physical qualification.

  **Verdict:** PASS - primary-source confirmed · **Provenance:** PRIMARY-SPEC

  **Evidence:** [src-530470310-ps-p4: section 4.4 TEMPERATURE](#src-530470310-ps-p4)
</EvidenceFact>

<EvidenceFact>
  <EvidenceAnchor id="fact-530470310-durability" />

  **Fact:** `fact-530470310-durability`

  **Value:** 30 · **Unit:** `cycles`

  **Conditions:** mating durability for tin plating; Molex 510211110-PS rev A. Not a measured lot result.

  **Verdict:** PASS - primary-source confirmed · **Provenance:** PRIMARY-SPEC

  **Evidence:** [src-530470310-ps-p4: section 4.5 DURABILITY](#src-530470310-ps-p4)
</EvidenceFact>

### PROJECT\_STATE

A value this project recorded about how the part is used here — a chosen operating point, a net assignment, or a derived figure. Not a manufacturer specification.

<EvidenceFact>
  <EvidenceAnchor id="fact-530470310-manufacturer" />

  **Fact:** `fact-530470310-manufacturer`

  **Value:** MOLEX · **Unit:** `NONE`

  **Conditions:** Exact part applicability inspected in acquired primary document; no stock, assembly or hardware qualification.

  **Verdict:** PASS - primary-source confirmed · **Provenance:** PRIMARY-SPEC

  **Evidence:** [src-530470310-sd: sheet 1 exact530470310 row, circuit1 indicator; sheet2 mating products/specifications](#src-530470310-sd)
</EvidenceFact>

<EvidenceFact>
  <EvidenceAnchor id="fact-530470310-distributor-identity" />

  **Fact:** `fact-530470310-distributor-identity`

  **Value:** `lcsc`=C122442; `manufacturer`=MOLEX; `mpn`=530470310; `variant`=Plugin,P=1.25mm · **Unit:** `NONE`

  **Conditions:** order-code identity only; not performance evidence

  **Verdict:** CONFIRMED - distributor identity only · **Provenance:** DISTRIBUTOR-IDENTITY

  **Evidence:** [src-530470310-a5-jlcpcb-snapshot: product table rows code, model, brand, specification](#src-530470310-a5-jlcpcb-snapshot)
</EvidenceFact>

<EvidenceFact>
  <EvidenceAnchor id="fact-530470310-a5-placements" />

  **Fact:** `fact-530470310-a5-placements`

  **Value:** controller/J5 x1, power\_adapter/J2 x1 (2 unique placements, 2 fitted pieces per module) · **Unit:** `NONE`

  **Conditions:** historical A5 native netlists; declared by the manual inventory provider, not bound to a schematic; as-built placement unverified

  **Verdict:** NEEDS BENCH · **Provenance:** PROJECT-CHOICE

  **Evidence:** [src-530470310-a5-netlist-controller: components section rows J5, J2](#src-530470310-a5-netlist-controller)
</EvidenceFact>

<EvidenceFact>
  <EvidenceAnchor id="fact-530470310-pinout" />

  **Fact:** `fact-530470310-pinout`

  **Value:** manufacturer circuit numbering for the 3-circuit 1.25 mm header · **Unit:** `NONE`

  **Conditions:** Primary document now available; this broad fact remains unverified pending per-criterion review. No automatic promotion from source acquisition.

  **Verdict:** UNSOURCED · **Provenance:** UNVERIFIED

  **Evidence:** [src-530470310-sd: intended circuit numbering figure](#src-530470310-sd)
</EvidenceFact>

<EvidenceFact>
  <EvidenceAnchor id="fact-530470310-cad-state" />

  **Fact:** `fact-530470310-cad-state`

  **Value:** A5 footprint LightBlock:PICO3 and symbol LightBlock:PWR3 are not configured as catalog CAD assets (cad.enabled=false); pin-asset check not performed · **Unit:** `NONE`

  **Conditions:** catalog CAD disabled for this batch; no footprint, model or receipt reviewed

  **Verdict:** UNSOURCED · **Provenance:** PROJECT-CHOICE

  **Evidence:** [src-530470310-a5-netlist-controller: components section footprint field](#src-530470310-a5-netlist-controller)
</EvidenceFact>

<EvidenceFact>
  <EvidenceAnchor id="fact-530470310-tail-length" />

  **Fact:** `fact-530470310-tail-length`

  **Value:** 2.3 · **Unit:** `mm`

  **Conditions:** terminal tail length from the housing bottom (seating) face to the tail tip, tolerance +/-0.5 mm (1.8 to 2.8 mm); this is the total tail length, not the protrusion below a board: protrusion depends on the board thickness (and its tolerance) and on the housing seating flush, neither of which this drawing gives; the recommended PCB hole is stated for t=0.8

  **Verdict:** PASS - primary-source confirmed · **Provenance:** PRIMARY-SPEC

  **Evidence:** [src-530470310-sd: figure SECTION X-X horizontal dimension 2.3 +/-0.5 (sheet 1, zones E-F, columns 8-10)](#src-530470310-sd)
</EvidenceFact>

## Pin maps

The mapping between schematic pins and PCB pads, or physical terminals for an external part, as recorded. A record may carry more than one map when the same part is documented in more than one context.

### pinmap-530470310

<EvidenceAnchor id="pinmap-530470310" />

- **Symbol:** `LightBlock:PWR3`
- **Footprint:** `LightBlock:PICO3`
- **Pins:** 3

<EvidenceDetails label="pin-assignments">
  <EvidenceTable label="pin-assignments">
    | Symbol pin | Name | Footprint pad | Function                                                                 |
    | ---------- | ---- | ------------- | ------------------------------------------------------------------------ |
    | `1`        | `1`  | `1`           | passive; A5 nets: controller/J5=/+12V\_RAW; power\_adapter/J2=/-12V\_RAW |
    | `2`        | `2`  | `2`           | passive; A5 nets: controller/J5=/GND; power\_adapter/J2=/GND             |
    | `3`        | `3`  | `3`           | passive; A5 nets: controller/J5=/-12V\_RAW; power\_adapter/J2=/+12V\_RAW |
  </EvidenceTable>
</EvidenceDetails>

## Interactions

Behaviour that is not a property of this part alone. Each interaction names the records it spans, the conditions it holds under, and how far it has been confirmed. An interaction that spans several parts appears on every one of their pages, under the same identifier, because it is equally a fact about each.

No interaction is published for this record.

## Cross-component rules

Rules that span several parts at once and are published in full on the integration page. Each rule's verdict below is that rule's own — it is a statement about the cross-component question, not about this part — and the exact wording of what the rule refuses to conclude is published with the rule itself.

No cross-component rule names this record.

## Sources

Every document cited above, with its identification, when it was retrieved, and what kind of authority it carries. Sources that could not be retrieved are listed too, with their unavailability stated, so a gap in the evidence is visible rather than absent.

### JLCPCB public product listing C122442 (A5 retained product-props snapshot)

<EvidenceAnchor id="src-530470310-a5-jlcpcb-snapshot" />

**Source ID:** `src-530470310-a5-jlcpcb-snapshot` · **Authority:** DISTRIBUTOR\_IDENTITY

| Field | Recorded value |
| --- | --- |
| Document number | C122442 |
| Revision | A5 snapshot observed 2026-11-05T20:28:17.248871+00:00 |
| Document date | 2026-11-05 |
| Retrieved | 2026-11-05 |
| Printed page | n/a (JSON snapshot of an HTML page) |

**Locator:** engineering/a5/mechanical\_evidence/C122442.snapshot.json, product table fields componentCode, componentModelEn, componentBrandEn, componentSpecificationEn

**Availability:** AVAILABLE

**Document URL:** no link is published for this source

### Light Block A5 controller native netlist (KiCad 10.0.8 export, historical)

<EvidenceAnchor id="src-530470310-a5-netlist-controller" />

**Source ID:** `src-530470310-a5-netlist-controller` · **Authority:** PROJECT\_GENERATOR

| Field | Recorded value |
| --- | --- |
| Document number | engineering/a5/integration/native\_schematic/controller/netlist.xml |
| Revision | A5 |
| Document date | 2026-11-06 |
| Retrieved | 2026-11-06 |
| Printed page | n/a (XML netlist) |

**Locator:** engineering/a5/integration/native\_schematic/controller/netlist.xml, components section rows for J5 and the matching nets section nodes

**Availability:** AVAILABLE

**Document URL:** [https://github.com/Takazudo/zudo-led-block/blob/d41cbb7fc61dc954b4affaf19527aa69f07013b6/engineering/a5/integration/native\_schematic/controller/netlist.xml](https://github.com/Takazudo/zudo-led-block/blob/d41cbb7fc61dc954b4affaf19527aa69f07013b6/engineering/a5/integration/native_schematic/controller/netlist.xml)

### Light Block A5 power\_adapter native netlist (KiCad 10.0.8 export, historical)

<EvidenceAnchor id="src-530470310-a5-netlist-power-adapter" />

**Source ID:** `src-530470310-a5-netlist-power-adapter` · **Authority:** PROJECT\_GENERATOR

| Field | Recorded value |
| --- | --- |
| Document number | engineering/a5/integration/native\_schematic/power\_adapter/netlist.xml |
| Revision | A5 |
| Document date | 2026-11-06 |
| Retrieved | 2026-11-06 |
| Printed page | n/a (XML netlist) |

**Locator:** engineering/a5/integration/native\_schematic/power\_adapter/netlist.xml, components section rows for J2 and the matching nets section nodes

**Availability:** AVAILABLE

**Document URL:** [https://github.com/Takazudo/zudo-led-block/blob/d41cbb7fc61dc954b4affaf19527aa69f07013b6/engineering/a5/integration/native\_schematic/power\_adapter/netlist.xml](https://github.com/Takazudo/zudo-led-block/blob/d41cbb7fc61dc954b4affaf19527aa69f07013b6/engineering/a5/integration/native_schematic/power_adapter/netlist.xml)

### Molex PicoBlade 1.25 header sales drawing

<EvidenceAnchor id="src-530470310-sd" />

**Source ID:** `src-530470310-sd` · **Authority:** MANUFACTURER\_PRIMARY

| Field | Recorded value |
| --- | --- |
| Document number | 530470000-SD PSD000 |
| Revision | B |
| Document date | 2022-04-19 |
| Retrieved | 2026-11-09 |
| Printed page | 1 |

**Locator:** sheet 1 exact530470310 row, circuit1 indicator; sheet2 mating products/specifications

**Availability:** AVAILABLE

**Document URL:** [https://www.molex.com/content/dam/molex/molex-dot-com/products/automated/en-us/salesdrawingpdf/530/53047/530470310\_sd.pdf](https://www.molex.com/content/dam/molex/molex-dot-com/products/automated/en-us/salesdrawingpdf/530/53047/530470310_sd.pdf)

### Molex PicoBlade 1.25 wire-to-board connector system product specification (single-row vertical TH, tin plating)

<EvidenceAnchor id="src-530470310-ps-p3" />

**Source ID:** `src-530470310-ps-p3` · **Authority:** MANUFACTURER\_PRIMARY

| Field | Recorded value |
| --- | --- |
| Document number | 510211110-PS |
| Revision | A |
| Document date | 2022-04-19 |
| Retrieved | 2026-11-12 |
| Printed page | 4 OF 16 |

**Locator:** 510211110-PS sheet 4 of 16, section 4.1 VOLTAGE, 4.2 RATED CURRENT AND APPLICABLE WIRES, 4.3 CURRENT DERATING

**Availability:** AVAILABLE

**Document URL:** [https://www.molex.com/en-us/products/part-detail/530470310](https://www.molex.com/en-us/products/part-detail/530470310)

### Molex PicoBlade 1.25 wire-to-board connector system product specification (single-row vertical TH, tin plating)

<EvidenceAnchor id="src-530470310-ps-p4" />

**Source ID:** `src-530470310-ps-p4` · **Authority:** MANUFACTURER\_PRIMARY

| Field | Recorded value |
| --- | --- |
| Document number | 510211110-PS |
| Revision | A |
| Document date | 2022-04-19 |
| Retrieved | 2026-11-12 |
| Printed page | 5 OF 16 |

**Locator:** 510211110-PS sheet 5 of 16, section 4.4 TEMPERATURE and 4.5 DURABILITY

**Availability:** AVAILABLE

**Document URL:** [https://www.molex.com/en-us/products/part-detail/530470310](https://www.molex.com/en-us/products/part-detail/530470310)

## Legend

What the recorded terms on this page mean, in ordinary words. The exact terms above are the ones that count; these descriptions explain them and never replace them.

### Verdict

| Recorded term | What it means |
| --- | --- |
| `CONFIRMED - distributor identity only` | A distributor listing confirms which part this is, and nothing more. It carries no electrical, thermal or lifetime authority. |
| `NEEDS BENCH` | Cannot be settled from documents. It needs measurement on real hardware before it can be relied on. |
| `PASS - primary-source confirmed` | Confirmed against the manufacturer's own document for this exact part. |
| `UNSOURCED` | No accepted source backs this value yet. Treat it as a claim, not a fact. |

### Provenance

| Recorded term | What it means |
| --- | --- |
| `DISTRIBUTOR-IDENTITY` | Taken from a distributor listing. Identity information only. |
| `PRIMARY-SPEC` | Taken from the manufacturer's own specification document. |
| `PROJECT-CHOICE` | A decision made by this project. No vendor asserts it. |
| `UNVERIFIED` | Recorded, but not yet backed by an accepted source. |

### Fact class

| Recorded term | What it means |
| --- | --- |
| `PROJECT_STATE` | A value this project recorded about how the part is used here — a chosen operating point, a net assignment, or a derived figure. Not a manufacturer specification. |
| `RECOMMENDED_OPERATION` | The range the manufacturer intends the part to be used in. Always narrower than the absolute maximum. |

### Coverage status

| Recorded term | What it means |
| --- | --- |
| `COVERED` | Every question this domain asks is answered by the facts listed against it. |
| `OPEN` | Unresolved. Open means the question has not been answered, not that the part is unsafe — the reason states what is missing. |

### Source availability

| Recorded term | What it means |
| --- | --- |
| `AVAILABLE` | The document was retrieved and is on record. |

### Source authority

| Recorded term | What it means |
| --- | --- |
| `DISTRIBUTOR_IDENTITY` | A distributor listing. Establishes which part this is, nothing more. |
| `MANUFACTURER_PRIMARY` | The manufacturer's own document for this exact part. |
| `PROJECT_GENERATOR` | A document this project generated, such as a schematic or netlist export. |

### Identity state

| Recorded term | What it means |
| --- | --- |
| `VERIFIED` | The exact orderable part has been confirmed against a source. |

### Source state

| Recorded term | What it means |
| --- | --- |
| `AVAILABLE` | At least one document backing this line was retrieved. |

### Unit

| Recorded term | What it means |
| --- | --- |
| `NONE` | The value is not a physical quantity, so it carries no unit. Recorded as \`NONE\`. |

## Raw agent resource

This page is generated from a stored evidence bundle and does not restate it. The bundle is the source of truth: where the two ever disagree, the bundle is right and this page is stale.

[Open the owning bundle](/docs/claude-skills/component-530470310/) `component-530470310`
