Takazudo/zudo-led-block/doc/src/content/docs/components/records/pmeg4010cej-115/index.mdx

---
# GENERATED by @takazudo/zudo-circuit-doc — do not edit; run `zudo-circuit-doc generate`
title: "PMEG4010CEJ,115"
description: "eurorack rail reverse-polarity schottky diode — Nexperia — C50704 — controller D1, D2 — rec-pmeg4010cej-115"
sidebar_position: 24
---

<EvidenceAnchor id="rec-pmeg4010cej-115" />

Generated from the component evidence records — edit the records, not this page.

Everything below is projected from this project's stored component evidence. Values keep the exact wording, conditions, units and verdicts they were recorded with — nothing here is re-typed, corrected, or combined into an overall judgement about the part.

This record in the catalog: [PMEG4010CEJ,115](/docs/components/catalog/#rec-pmeg4010cej-115)

## Identity

| Field | Recorded value |
| --- | --- |
| Record ID | `rec-pmeg4010cej-115` |
| Record kind | standalone |
| Manufacturer part number | `PMEG4010CEJ,115` |
| Manufacturer | Nexperia |
| Function | eurorack rail reverse-polarity schottky diode |
| LCSC ID | `C50704` |
| Package | `SOD-323F` |
| Inventory line | `line-pmeg4010cej-115` |
| Owner skill | `component-pmeg4010cej-115` |

**Fit:** Fitted

**Identity state:** VERIFIED

**Source state:** AVAILABLE

**Coverage:** 2 open of 5 published

## Documents and package

<EvidenceAnchor id="component-references-heading" />

<EvidenceAnchor id="component-references" />

[Datasheet PDF](https://assets.nexperia.com/documents/data-sheet/PMEG4010CEJ.pdf) — PMEG4010CEJ 40 V, 1 A very low VF Schottky barrier rectifier, Product data sheet

**Selected source ID:** `src-pmeg4010cej-115-ds`

**Authority:** MANUFACTURER\_PRIMARY

**Availability:** AVAILABLE

No footprint or 3D model is published for this record: CAD is not enabled for this project.

## Placements

Every position this exact line occupies in the as-built design. One line may be placed many times and across more than one board.

| Board | Reference designator |
| --- | --- |
| controller | `D1` |
| controller | `D2` |

## Coverage

Coverage is stated one domain at a time and is never rolled up. A domain marked open is a question that has not been answered; it is not a finding that the part is unsuitable. A record with no open domains has not thereby been declared safe.

### identity

<EvidenceAnchor id="cov-pmeg4010cej-115-identity" />

**Coverage ID:** `cov-pmeg4010cej-115-identity` · **Status:** COVERED

**Reason:** manufacturer is confirmed by Nexperia PMEG4010CEJ v.3 and the ',115' packing (SOD323F 7-inch reel) by the Nexperia SOD323F\_115 packing document; stock and assembly qualification remain separate

**Facts in this domain:**

- [`fact-pmeg4010cej-115-manufacturer`](#fact-pmeg4010cej-115-manufacturer)
- [`fact-pmeg4010cej-115-orderable`](#fact-pmeg4010cej-115-orderable)
- [`fact-pmeg4010cej-115-distributor-identity`](#fact-pmeg4010cej-115-distributor-identity)

### pinout

<EvidenceAnchor id="cov-pmeg4010cej-115-pinout" />

**Coverage ID:** `cov-pmeg4010cej-115-pinout` · **Status:** COVERED

**Reason:** pin 1 K / pin 2 A is read from the Nexperia v.3 Pinning information table and agrees with the A5 pin map; footprint pad geometry is a separate CAD domain

**Facts in this domain:**

- [`fact-pmeg4010cej-115-pinout`](#fact-pmeg4010cej-115-pinout)

### electrical-ratings

<EvidenceAnchor id="cov-pmeg4010cej-115-ratings" />

**Coverage ID:** `cov-pmeg4010cej-115-ratings` · **Status:** COVERED

**Reason:** VR, IF/IFRM/IFSM, Tj/Ptot/Rth, VF max and IR max are read from Nexperia PMEG4010CEJ v.3 Tables 5-7; application thermal and reverse-leakage margins are not evaluated here

**Facts in this domain:**

- [`fact-pmeg4010cej-115-ratings`](#fact-pmeg4010cej-115-ratings)
- [`fact-pmeg4010cej-115-forward-current`](#fact-pmeg4010cej-115-forward-current)
- [`fact-pmeg4010cej-115-junction-temperature`](#fact-pmeg4010cej-115-junction-temperature)
- [`fact-pmeg4010cej-115-forward-voltage`](#fact-pmeg4010cej-115-forward-voltage)
- [`fact-pmeg4010cej-115-reverse-current`](#fact-pmeg4010cej-115-reverse-current)

### placement

<EvidenceAnchor id="cov-pmeg4010cej-115-placement" />

**Coverage ID:** `cov-pmeg4010cej-115-placement` · **Status:** OPEN

**Reason:** fact-pmeg4010cej-115-a5-placements NEEDS BENCH: placements are declared from the historical A5 netlist only; the manual provider performs no schematic binding and no as-built check exists

**Facts in this domain:**

- [`fact-pmeg4010cej-115-a5-placements`](#fact-pmeg4010cej-115-a5-placements)

**Blocked by:** these facts must be resolved before the domain can close. Each is listed in full under Facts.

- [`fact-pmeg4010cej-115-a5-placements`](#fact-pmeg4010cej-115-a5-placements)

### cad-assets

<EvidenceAnchor id="cov-pmeg4010cej-115-cad" />

**Coverage ID:** `cov-pmeg4010cej-115-cad` · **Status:** OPEN

**Reason:** fact-pmeg4010cej-115-cad-state remains UNSOURCED: catalog CAD is disabled, so no symbol, footprint or model was reviewed or validated

**Facts in this domain:**

- [`fact-pmeg4010cej-115-cad-state`](#fact-pmeg4010cej-115-cad-state)

**Blocked by:** these facts must be resolved before the domain can close. Each is listed in full under Facts.

- [`fact-pmeg4010cej-115-cad-state`](#fact-pmeg4010cej-115-cad-state)

## Facts

Each fact keeps its value, its unit, the conditions it holds under, where it came from and how far it has been confirmed as separate fields, because they are separate claims. A value without its conditions is not the same fact, and a verdict is about the evidence for the value, not about the part.

### ABSOLUTE\_MAXIMUM

A never-exceed limit. Reaching it may damage the part; it is not an operating target and there is no margin implied by it.

<EvidenceFact>
  <EvidenceAnchor id="fact-pmeg4010cej-115-ratings" />

  **Fact:** `fact-pmeg4010cej-115-ratings`

  **Value:** 40 · **Unit:** `V`

  **Conditions:** VR reverse voltage absolute maximum (Table 5, IEC 60134 absolute maximum rating system); IF 1 A at Tsp\<=55 C, IFSM 10 A and Tj 150 C are separate facts

  **Verdict:** PASS - primary-source confirmed · **Provenance:** PRIMARY-SPEC

  **Evidence:** [src-pmeg4010cej-115-ds-p1: Table 5 Limiting values row VR](#src-pmeg4010cej-115-ds-p1)
</EvidenceFact>

<EvidenceFact>
  <EvidenceAnchor id="fact-pmeg4010cej-115-forward-current" />

  **Fact:** `fact-pmeg4010cej-115-forward-current`

  **Value:** 1 · **Unit:** `A`

  **Conditions:** IF forward current absolute maximum at Tsp\<=55 C (solder point); IFRM 7 A at tp\<=1 ms, delta\<=0.25; IFSM 10 A at tp=8 ms square wave, Tj(init)=25 C

  **Verdict:** PASS - primary-source confirmed · **Provenance:** PRIMARY-SPEC

  **Evidence:** [src-pmeg4010cej-115-ds-p1: Table 5 Limiting values rows IF, IFRM, IFSM](#src-pmeg4010cej-115-ds-p1)
</EvidenceFact>

<EvidenceFact>
  <EvidenceAnchor id="fact-pmeg4010cej-115-junction-temperature" />

  **Fact:** `fact-pmeg4010cej-115-junction-temperature`

  **Value:** 150 · **Unit:** `degC`

  **Conditions:** Tj junction temperature maximum; Tamb and Tstg -65..150 C; Ptot 350 mW (standard footprint, FR4 single-sided) or 830 mW (1 cm2 cathode pad) at Tamb\<=25 C; Rth(j-a) 350 / 150 K/W for the same two mountings; Table 6 note \[1]: thermal runaway has to be considered for Schottky barrier diodes

  **Verdict:** PASS - primary-source confirmed · **Provenance:** PRIMARY-SPEC

  **Evidence:** [src-pmeg4010cej-115-ds-p1: Table 5 rows Tj, Tamb, Tstg, Ptot; Table 6 Thermal characteristics](#src-pmeg4010cej-115-ds-p1)
</EvidenceFact>

### GUARANTEED\_ELECTRICAL

A parameter the manufacturer guarantees over the stated conditions, usually with minimum, typical and maximum values.

<EvidenceFact>
  <EvidenceAnchor id="fact-pmeg4010cej-115-forward-voltage" />

  **Fact:** `fact-pmeg4010cej-115-forward-voltage`

  **Value:** 390 max at IF=100mA; 490 max at IF=500mA; 570 max at IF=1000mA · **Unit:** `mV`

  **Conditions:** VF maximum at Tamb=25 C, pulsed tp\<=300 us, delta\<=0.02; typical curves over temperature (Fig. 1) are not guaranteed limits

  **Verdict:** PASS - primary-source confirmed · **Provenance:** PRIMARY-SPEC

  **Evidence:** [src-pmeg4010cej-115-ds-p2: Table 7 Characteristics rows VF](#src-pmeg4010cej-115-ds-p2)
</EvidenceFact>

<EvidenceFact>
  <EvidenceAnchor id="fact-pmeg4010cej-115-reverse-current" />

  **Fact:** `fact-pmeg4010cej-115-reverse-current`

  **Value:** 50 · **Unit:** `uA`

  **Conditions:** IR maximum at VR=40 V, Tamb=25 C (typ 6 uA); only typical values are printed at 5 V and 10 V; reverse current rises steeply with temperature (Fig. 2, typical)

  **Verdict:** PASS - primary-source confirmed · **Provenance:** PRIMARY-SPEC

  **Evidence:** [src-pmeg4010cej-115-ds-p2: Table 7 Characteristics rows IR](#src-pmeg4010cej-115-ds-p2)
</EvidenceFact>

### PROJECT\_STATE

A value this project recorded about how the part is used here — a chosen operating point, a net assignment, or a derived figure. Not a manufacturer specification.

<EvidenceFact>
  <EvidenceAnchor id="fact-pmeg4010cej-115-manufacturer" />

  **Fact:** `fact-pmeg4010cej-115-manufacturer`

  **Value:** Nexperia · **Unit:** `NONE`

  **Conditions:** Nexperia product data sheet PMEG4010CEJ v.3 (1 October 2022) served from assets.nexperia.com; page footer reads 'Nexperia B.V. 2022. All rights reserved'

  **Verdict:** PASS - primary-source confirmed · **Provenance:** PRIMARY-SPEC

  **Evidence:** [src-pmeg4010cej-115-ds: page 1 title block and page footer](#src-pmeg4010cej-115-ds)
</EvidenceFact>

<EvidenceFact>
  <EvidenceAnchor id="fact-pmeg4010cej-115-distributor-identity" />

  **Fact:** `fact-pmeg4010cej-115-distributor-identity`

  **Value:** `lcsc`=C50704; `manufacturer`=Nexperia; `mpn`=PMEG4010CEJ,115; `variant`=SOD-323F · **Unit:** `NONE`

  **Conditions:** order-code identity only; not performance evidence

  **Verdict:** CONFIRMED - distributor identity only · **Provenance:** DISTRIBUTOR-IDENTITY

  **Evidence:** [src-pmeg4010cej-115-a5-jlcpcb-snapshot: product table rows code, model, brand, specification](#src-pmeg4010cej-115-a5-jlcpcb-snapshot)
</EvidenceFact>

<EvidenceFact>
  <EvidenceAnchor id="fact-pmeg4010cej-115-a5-placements" />

  **Fact:** `fact-pmeg4010cej-115-a5-placements`

  **Value:** controller/D1 x1, controller/D2 x1 (2 unique placements, 2 fitted pieces per module) · **Unit:** `NONE`

  **Conditions:** historical A5 native netlists; declared by the manual inventory provider, not bound to a schematic; as-built placement unverified

  **Verdict:** NEEDS BENCH · **Provenance:** PROJECT-CHOICE

  **Evidence:** [src-pmeg4010cej-115-a5-netlist-controller: components section rows D1, D2](#src-pmeg4010cej-115-a5-netlist-controller)
</EvidenceFact>

<EvidenceFact>
  <EvidenceAnchor id="fact-pmeg4010cej-115-pinout" />

  **Fact:** `fact-pmeg4010cej-115-pinout`

  **Value:** pin 1 K (cathode, marked by the cathode bar), pin 2 A (anode), SC-90 (SOD323F) · **Unit:** `NONE`

  **Conditions:** manufacturer Pinning information; agrees with the A5 projection D1/D2 pin 1 K, pin 2 A (src-pmeg4010cej-115-a5-netlist-controller). Pad geometry of LightBlock:SOD323F is not reviewed (CAD disabled)

  **Verdict:** PASS - primary-source confirmed · **Provenance:** PRIMARY-SPEC

  **Evidence:** [src-pmeg4010cej-115-ds: Table 2 Pinning information rows 1 and 2](#src-pmeg4010cej-115-ds)
</EvidenceFact>

<EvidenceFact>
  <EvidenceAnchor id="fact-pmeg4010cej-115-cad-state" />

  **Fact:** `fact-pmeg4010cej-115-cad-state`

  **Value:** A5 footprint LightBlock:SOD323F and symbol LightBlock:RECT are not configured as catalog CAD assets (cad.enabled=false); pin-asset check not performed · **Unit:** `NONE`

  **Conditions:** catalog CAD disabled for this batch; no footprint, model or receipt reviewed

  **Verdict:** UNSOURCED · **Provenance:** PROJECT-CHOICE

  **Evidence:** [src-pmeg4010cej-115-a5-netlist-controller: components section footprint field](#src-pmeg4010cej-115-a5-netlist-controller)
</EvidenceFact>

<EvidenceFact>
  <EvidenceAnchor id="fact-pmeg4010cej-115-orderable" />

  **Fact:** `fact-pmeg4010cej-115-orderable`

  **Value:** PMEG4010CEJ,115 = SOD323F on a 7-inch reel (180 mm diameter, 8 mm tape) · **Unit:** `NONE`

  **Conditions:** Nexperia SOD323F\_115 Rev. 3.0 Table 1 gives the ,115 ending as the 7-inch reel pack (180 x 8 mm); the table's SPQ of 3000 pcs is for the package, and its note 2 says the packing quantity depends on the specific product type. The package SOD323F comes from the PMEG4010CEJ v.3 data sheet (src-pmeg4010cej-115-ds-p1), which itself removed packing information (src-pmeg4010cej-115-ds-p5). Packing identity only; not stock or assembly qualification.

  **Verdict:** PASS - primary-source confirmed · **Provenance:** PRIMARY-SPEC

  **Evidence:** [src-pmeg4010cej-115-packing: Table 1 Dimensions and quantities, row SOD323F / 115; src-pmeg4010cej-115-ds-p1: package SOD323F](#src-pmeg4010cej-115-packing)
</EvidenceFact>

## Pin maps

The mapping between schematic pins and PCB pads, or physical terminals for an external part, as recorded. A record may carry more than one map when the same part is documented in more than one context.

### pinmap-pmeg4010cej-115

<EvidenceAnchor id="pinmap-pmeg4010cej-115" />

- **Symbol:** `LightBlock:RECT`
- **Footprint:** `LightBlock:SOD323F`
- **Pins:** 2

<EvidenceDetails label="pin-assignments">
  <EvidenceTable label="pin-assignments">
    | Symbol pin | Name | Footprint pad | Function                                                              |
    | ---------- | ---- | ------------- | --------------------------------------------------------------------- |
    | `1`        | `K`  | `1`           | passive; A5 nets: controller/D1=/+12V\_PROT; controller/D2=/-12V\_RAW |
    | `2`        | `A`  | `2`           | passive; A5 nets: controller/D1=/+12V\_RAW; controller/D2=/-12V\_PROT |
  </EvidenceTable>
</EvidenceDetails>

## Interactions

Behaviour that is not a property of this part alone. Each interaction names the records it spans, the conditions it holds under, and how far it has been confirmed. An interaction that spans several parts appears on every one of their pages, under the same identifier, because it is equally a fact about each.

No interaction is published for this record.

## Cross-component rules

Rules that span several parts at once and are published in full on the integration page. Each rule's verdict below is that rule's own — it is a statement about the cross-component question, not about this part — and the exact wording of what the rule refuses to conclude is published with the rule itself.

No cross-component rule names this record.

## Sources

Every document cited above, with its identification, when it was retrieved, and what kind of authority it carries. Sources that could not be retrieved are listed too, with their unavailability stated, so a gap in the evidence is visible rather than absent.

### JLCPCB public product listing C50704 (A5 retained product-props snapshot)

<EvidenceAnchor id="src-pmeg4010cej-115-a5-jlcpcb-snapshot" />

**Source ID:** `src-pmeg4010cej-115-a5-jlcpcb-snapshot` · **Authority:** DISTRIBUTOR\_IDENTITY

| Field | Recorded value |
| --- | --- |
| Document number | C50704 |
| Revision | A5 snapshot observed 2026-11-05T20:18:05.304634+00:00 |
| Document date | 2026-11-05 |
| Retrieved | 2026-11-05 |
| Printed page | n/a (JSON snapshot of an HTML page) |

**Locator:** engineering/a5/ic\_led\_evidence/C50704.snapshot.json, product table fields componentCode, componentModelEn, componentBrandEn, componentSpecificationEn

**Availability:** AVAILABLE

**Document URL:** no link is published for this source

### Light Block A5 controller native netlist (KiCad 10.0.8 export, historical)

<EvidenceAnchor id="src-pmeg4010cej-115-a5-netlist-controller" />

**Source ID:** `src-pmeg4010cej-115-a5-netlist-controller` · **Authority:** PROJECT\_GENERATOR

| Field | Recorded value |
| --- | --- |
| Document number | engineering/a5/integration/native\_schematic/controller/netlist.xml |
| Revision | A5 |
| Document date | 2026-11-06 |
| Retrieved | 2026-11-06 |
| Printed page | n/a (XML netlist) |

**Locator:** engineering/a5/integration/native\_schematic/controller/netlist.xml, components section rows for D1, D2 and the matching nets section nodes

**Availability:** AVAILABLE

**Document URL:** [https://github.com/Takazudo/zudo-led-block/blob/d41cbb7fc61dc954b4affaf19527aa69f07013b6/engineering/a5/integration/native\_schematic/controller/netlist.xml](https://github.com/Takazudo/zudo-led-block/blob/d41cbb7fc61dc954b4affaf19527aa69f07013b6/engineering/a5/integration/native_schematic/controller/netlist.xml)

### PMEG4010CEJ 40 V, 1 A very low VF Schottky barrier rectifier, Product data sheet

<EvidenceAnchor id="src-pmeg4010cej-115-ds" />

**Source ID:** `src-pmeg4010cej-115-ds` · **Authority:** MANUFACTURER\_PRIMARY

| Field | Recorded value |
| --- | --- |
| Document number | PMEG4010CEJ v.3 |
| Revision | v.3 (Product data sheet, release 20221001) |
| Document date | 2022-10-01 |
| Retrieved | 2026-11-11 |
| Printed page | 1 / 8 |

**Locator:** page 1: title block, Table 1 Quick reference data, Table 2 Pinning information

**Availability:** AVAILABLE

**Document URL:** [https://assets.nexperia.com/documents/data-sheet/PMEG4010CEJ.pdf](https://assets.nexperia.com/documents/data-sheet/PMEG4010CEJ.pdf)

### PMEG4010CEJ 40 V, 1 A very low VF Schottky barrier rectifier, Product data sheet

<EvidenceAnchor id="src-pmeg4010cej-115-ds-p1" />

**Source ID:** `src-pmeg4010cej-115-ds-p1` · **Authority:** MANUFACTURER\_PRIMARY

| Field | Recorded value |
| --- | --- |
| Document number | PMEG4010CEJ v.3 |
| Revision | v.3 (Product data sheet, release 20221001) |
| Document date | 2022-10-01 |
| Retrieved | 2026-11-11 |
| Printed page | 2 / 8 |

**Locator:** page 2: Table 3 Ordering information, Table 4 Marking codes, Table 5 Limiting values, Table 6 Thermal characteristics

**Availability:** AVAILABLE

**Document URL:** [https://assets.nexperia.com/documents/data-sheet/PMEG4010CEJ.pdf](https://assets.nexperia.com/documents/data-sheet/PMEG4010CEJ.pdf)

### PMEG4010CEJ 40 V, 1 A very low VF Schottky barrier rectifier, Product data sheet

<EvidenceAnchor id="src-pmeg4010cej-115-ds-p2" />

**Source ID:** `src-pmeg4010cej-115-ds-p2` · **Authority:** MANUFACTURER\_PRIMARY

| Field | Recorded value |
| --- | --- |
| Document number | PMEG4010CEJ v.3 |
| Revision | v.3 (Product data sheet, release 20221001) |
| Document date | 2022-10-01 |
| Retrieved | 2026-11-11 |
| Printed page | 3 / 8 |

**Locator:** page 3: Table 7 Characteristics, rows VF, IR, Cd

**Availability:** AVAILABLE

**Document URL:** [https://assets.nexperia.com/documents/data-sheet/PMEG4010CEJ.pdf](https://assets.nexperia.com/documents/data-sheet/PMEG4010CEJ.pdf)

### PMEG4010CEJ 40 V, 1 A very low VF Schottky barrier rectifier, Product data sheet

<EvidenceAnchor id="src-pmeg4010cej-115-ds-p5" />

**Source ID:** `src-pmeg4010cej-115-ds-p5` · **Authority:** MANUFACTURER\_PRIMARY

| Field | Recorded value |
| --- | --- |
| Document number | PMEG4010CEJ v.3 |
| Revision | v.3 (Product data sheet, release 20221001) |
| Document date | 2022-10-01 |
| Retrieved | 2026-11-11 |
| Printed page | 6 / 8 |

**Locator:** page 6: Table 8 Revision history

**Availability:** AVAILABLE

**Document URL:** [https://assets.nexperia.com/documents/data-sheet/PMEG4010CEJ.pdf](https://assets.nexperia.com/documents/data-sheet/PMEG4010CEJ.pdf)

### SOD323F Reel pack for SMD, 7''; Q1/T1-Q2/T3 product orientation (Nexperia packing information)

<EvidenceAnchor id="src-pmeg4010cej-115-packing" />

**Source ID:** `src-pmeg4010cej-115-packing` · **Authority:** MANUFACTURER\_PRIMARY

| Field | Recorded value |
| --- | --- |
| Document number | SOD323F\_115 |
| Revision | Rev. 3.0 |
| Document date | 2024-08-26 |
| Retrieved | 2026-11-12 |
| Printed page | none printed (first page; pages 2-6 carry an n/6 footer) |

**Locator:** page 1: section 1 Packing method, Table 1 Dimensions and quantities

**Availability:** AVAILABLE

**Document URL:** [https://assets.nexperia.com/documents/packing-information/SOD323F\_115.pdf](https://assets.nexperia.com/documents/packing-information/SOD323F_115.pdf)

## Legend

What the recorded terms on this page mean, in ordinary words. The exact terms above are the ones that count; these descriptions explain them and never replace them.

### Verdict

| Recorded term | What it means |
| --- | --- |
| `CONFIRMED - distributor identity only` | A distributor listing confirms which part this is, and nothing more. It carries no electrical, thermal or lifetime authority. |
| `NEEDS BENCH` | Cannot be settled from documents. It needs measurement on real hardware before it can be relied on. |
| `PASS - primary-source confirmed` | Confirmed against the manufacturer's own document for this exact part. |
| `UNSOURCED` | No accepted source backs this value yet. Treat it as a claim, not a fact. |

### Provenance

| Recorded term | What it means |
| --- | --- |
| `DISTRIBUTOR-IDENTITY` | Taken from a distributor listing. Identity information only. |
| `PRIMARY-SPEC` | Taken from the manufacturer's own specification document. |
| `PROJECT-CHOICE` | A decision made by this project. No vendor asserts it. |

### Fact class

| Recorded term | What it means |
| --- | --- |
| `ABSOLUTE_MAXIMUM` | A never-exceed limit. Reaching it may damage the part; it is not an operating target and there is no margin implied by it. |
| `GUARANTEED_ELECTRICAL` | A parameter the manufacturer guarantees over the stated conditions, usually with minimum, typical and maximum values. |
| `PROJECT_STATE` | A value this project recorded about how the part is used here — a chosen operating point, a net assignment, or a derived figure. Not a manufacturer specification. |

### Coverage status

| Recorded term | What it means |
| --- | --- |
| `COVERED` | Every question this domain asks is answered by the facts listed against it. |
| `OPEN` | Unresolved. Open means the question has not been answered, not that the part is unsafe — the reason states what is missing. |

### Source availability

| Recorded term | What it means |
| --- | --- |
| `AVAILABLE` | The document was retrieved and is on record. |

### Source authority

| Recorded term | What it means |
| --- | --- |
| `DISTRIBUTOR_IDENTITY` | A distributor listing. Establishes which part this is, nothing more. |
| `MANUFACTURER_PRIMARY` | The manufacturer's own document for this exact part. |
| `PROJECT_GENERATOR` | A document this project generated, such as a schematic or netlist export. |

### Identity state

| Recorded term | What it means |
| --- | --- |
| `VERIFIED` | The exact orderable part has been confirmed against a source. |

### Source state

| Recorded term | What it means |
| --- | --- |
| `AVAILABLE` | At least one document backing this line was retrieved. |

### Unit

| Recorded term | What it means |
| --- | --- |
| `NONE` | The value is not a physical quantity, so it carries no unit. Recorded as \`NONE\`. |

## Raw agent resource

This page is generated from a stored evidence bundle and does not restate it. The bundle is the source of truth: where the two ever disagree, the bundle is right and this page is stale.

[Open the owning bundle](/docs/claude-skills/component-pmeg4010cej-115/) `component-pmeg4010cej-115`
