Takazudo/zudo-led-block/doc/src/content/docs/components/records/stm32g031g8u6tr/index.mdx

---
# GENERATED by @takazudo/zudo-circuit-doc — do not edit; run `zudo-circuit-doc generate`
title: "STM32G031G8U6TR"
description: "main microcontroller — STMicroelectronics — C5270180 — controller U1 — rec-stm32g031g8u6tr"
sidebar_position: 25
---

<EvidenceAnchor id="rec-stm32g031g8u6tr" />

Generated from the component evidence records — edit the records, not this page.

Everything below is projected from this project's stored component evidence. Values keep the exact wording, conditions, units and verdicts they were recorded with — nothing here is re-typed, corrected, or combined into an overall judgement about the part.

This record in the catalog: [STM32G031G8U6TR](/docs/components/catalog/#rec-stm32g031g8u6tr)

## Identity

| Field | Recorded value |
| --- | --- |
| Record ID | `rec-stm32g031g8u6tr` |
| Record kind | standalone |
| Manufacturer part number | `STM32G031G8U6TR` |
| Manufacturer | STMicroelectronics |
| Function | main microcontroller |
| LCSC ID | `C5270180` |
| Package | `UFQFPN-28(4x4)` |
| Inventory line | `line-stm32g031g8u6tr` |
| Owner skill | `component-stm32g031g8u6tr` |

**Fit:** Fitted

**Identity state:** VERIFIED

**Source state:** AVAILABLE

**Coverage:** 3 open of 5 published

## Documents and package

<EvidenceAnchor id="component-references-heading" />

<EvidenceAnchor id="component-references" />

[Datasheet PDF](https://www.st.com/resource/en/datasheet/stm32g031f8.pdf) — STMicroelectronics STM32G031x4/x6/x8 datasheet

**Selected source ID:** `src-stm32g031g8u6tr-ds`

**Authority:** MANUFACTURER\_PRIMARY

**Availability:** AVAILABLE

No footprint or 3D model is published for this record: CAD is not enabled for this project.

## Placements

Every position this exact line occupies in the as-built design. One line may be placed many times and across more than one board.

| Board | Reference designator |
| --- | --- |
| controller | `U1` |

## Coverage

Coverage is stated one domain at a time and is never rolled up. A domain marked open is a question that has not been answered; it is not a finding that the part is unsuitable. A record with no open domains has not thereby been declared safe.

### identity

<EvidenceAnchor id="cov-stm32g031g8u6tr-identity" />

**Coverage ID:** `cov-stm32g031g8u6tr-identity` · **Status:** COVERED

**Reason:** Exact manufacturer identity/order scheme inspected in primary document; stock and assembly qualification remain separate.

**Facts in this domain:**

- [`fact-stm32g031g8u6tr-manufacturer`](#fact-stm32g031g8u6tr-manufacturer)
- [`fact-stm32g031g8u6tr-orderable`](#fact-stm32g031g8u6tr-orderable)
- [`fact-stm32g031g8u6tr-distributor-identity`](#fact-stm32g031g8u6tr-distributor-identity)

### pinout

<EvidenceAnchor id="cov-stm32g031g8u6tr-pinout" />

**Coverage ID:** `cov-stm32g031g8u6tr-pinout` · **Status:** OPEN

**Reason:** Primary document acquired on 2026-11-09. This domain remains OPEN: per-criterion electrical/mechanical/pin-map review and applicable physical qualification incomplete

**Facts in this domain:**

- [`fact-stm32g031g8u6tr-pinout`](#fact-stm32g031g8u6tr-pinout)

**Blocked by:** these facts must be resolved before the domain can close. Each is listed in full under Facts.

- [`fact-stm32g031g8u6tr-pinout`](#fact-stm32g031g8u6tr-pinout)

### electrical-ratings

<EvidenceAnchor id="cov-stm32g031g8u6tr-ratings" />

**Coverage ID:** `cov-stm32g031g8u6tr-ratings` · **Status:** COVERED

**Reason:** VDD and I/O absolute maxima, injected-current limits and operating VDD are read from DS12992 Rev 4 Tables 18-21 in the owner's text conversion of the ST datasheet; application margins and partial-power behaviour are not qualified

**Facts in this domain:**

- [`fact-stm32g031g8u6tr-ratings`](#fact-stm32g031g8u6tr-ratings)
- [`fact-stm32g031g8u6tr-abs-max-vin-ft`](#fact-stm32g031g8u6tr-abs-max-vin-ft)
- [`fact-stm32g031g8u6tr-iinj-pin`](#fact-stm32g031g8u6tr-iinj-pin)
- [`fact-stm32g031g8u6tr-iinj-total`](#fact-stm32g031g8u6tr-iinj-total)
- [`fact-stm32g031g8u6tr-vdd-operating`](#fact-stm32g031g8u6tr-vdd-operating)
- [`fact-stm32g031g8u6tr-operating-temperature`](#fact-stm32g031g8u6tr-operating-temperature)

### placement

<EvidenceAnchor id="cov-stm32g031g8u6tr-placement" />

**Coverage ID:** `cov-stm32g031g8u6tr-placement` · **Status:** OPEN

**Reason:** fact-stm32g031g8u6tr-a5-placements NEEDS BENCH: placements are declared from the historical A5 netlist only; the manual provider performs no schematic binding and no as-built check exists

**Facts in this domain:**

- [`fact-stm32g031g8u6tr-a5-placements`](#fact-stm32g031g8u6tr-a5-placements)

**Blocked by:** these facts must be resolved before the domain can close. Each is listed in full under Facts.

- [`fact-stm32g031g8u6tr-a5-placements`](#fact-stm32g031g8u6tr-a5-placements)

### cad-assets

<EvidenceAnchor id="cov-stm32g031g8u6tr-cad" />

**Coverage ID:** `cov-stm32g031g8u6tr-cad` · **Status:** OPEN

**Reason:** fact-stm32g031g8u6tr-cad-state remains UNSOURCED: catalog CAD is disabled, so no symbol, footprint or model was reviewed or validated

**Facts in this domain:**

- [`fact-stm32g031g8u6tr-cad-state`](#fact-stm32g031g8u6tr-cad-state)

**Blocked by:** these facts must be resolved before the domain can close. Each is listed in full under Facts.

- [`fact-stm32g031g8u6tr-cad-state`](#fact-stm32g031g8u6tr-cad-state)

## Facts

Each fact keeps its value, its unit, the conditions it holds under, where it came from and how far it has been confirmed as separate fields, because they are separate claims. A value without its conditions is not the same fact, and a verdict is about the evidence for the value, not about the part.

### ABSOLUTE\_MAXIMUM

A never-exceed limit. Reaching it may damage the part; it is not an operating target and there is no margin implied by it.

<EvidenceFact>
  <EvidenceAnchor id="fact-stm32g031g8u6tr-ratings" />

  **Fact:** `fact-stm32g031g8u6tr-ratings`

  **Value:** -0.3 to 4.0 · **Unit:** `V`

  **Conditions:** VDD external supply voltage absolute maximum (Table 18); Table 19 note 1: all VDD/VDDA, VBAT and VSS/VSSA pins must always be connected to the external supplies, in the permitted range. I/O input voltage, injected current and operating VDD are separate facts. Read from the owner's text conversion of DS12992 Rev 4 (see the source's authority note), not from a PDF render.

  **Verdict:** PASS - primary-source confirmed · **Provenance:** PRIMARY-SPEC

  **Evidence:** [src-stm32g031g8u6tr-ds-text-p45: Table 18 Voltage characteristics, row VDD](#src-stm32g031g8u6tr-ds-text-p45)
</EvidenceFact>

<EvidenceFact>
  <EvidenceAnchor id="fact-stm32g031g8u6tr-abs-max-vin-ft" />

  **Fact:** `fact-stm32g031g8u6tr-abs-max-vin-ft`

  **Value:** -0.3 to VDD + 4.0 · **Unit:** `V`

  **Conditions:** input voltage on FT\_xx pins (Table 18); any other pin -0.3 to 4.0 V; above 4 V the internal pull-up/pull-down must be disabled; when an FT\_a pin is used by an analog peripheral such as the ADC the maximum is 4 V. Read from the owner's text conversion of DS12992 Rev 4 (see the source's authority note), not from a PDF render.

  **Verdict:** PASS - primary-source confirmed · **Provenance:** PRIMARY-SPEC

  **Evidence:** [src-stm32g031g8u6tr-ds-text-p45: Table 18 row VIN and notes 2-3](#src-stm32g031g8u6tr-ds-text-p45)
</EvidenceFact>

<EvidenceFact>
  <EvidenceAnchor id="fact-stm32g031g8u6tr-iinj-pin" />

  **Fact:** `fact-stm32g031g8u6tr-iinj-pin`

  **Value:** -5 · **Unit:** `mA`

  **Conditions:** injected current on a FT\_xx pin, negative injection (VIN \< VSS); positive injection is NA: not possible on these I/Os and does not occur below the maximum VIN (Table 19 notes 2-3); IINJ(PIN) must never be exceeded. Separately, FT\_e pins with the switchable diode to VDDIO1 enabled in software accept up to 5 mA positive injection (Table 52, printed page 72; not read into a fact here); A5 uses FT\_e-capable pins such as PA3, PA5, PA6 and PA13. Read from the owner's text conversion of DS12992 Rev 4 (see the source's authority note), not from a PDF render.

  **Verdict:** PASS - primary-source confirmed · **Provenance:** PRIMARY-SPEC

  **Evidence:** [src-stm32g031g8u6tr-ds-text-p46: Table 19 (continued) row IINJ(PIN), notes 2-3](#src-stm32g031g8u6tr-ds-text-p46)
</EvidenceFact>

<EvidenceFact>
  <EvidenceAnchor id="fact-stm32g031g8u6tr-iinj-total" />

  **Fact:** `fact-stm32g031g8u6tr-iinj-total`

  **Value:** 25 · **Unit:** `mA`

  **Conditions:** total injected current, the absolute sum of the negative injected currents of all I/Os and control pins, instantaneous (Table 19 note 4). Read from the owner's text conversion of DS12992 Rev 4 (see the source's authority note), not from a PDF render.

  **Verdict:** PASS - primary-source confirmed · **Provenance:** PRIMARY-SPEC

  **Evidence:** [src-stm32g031g8u6tr-ds-text-p46: Table 19 (continued) row sum |IINJ(PIN)|, note 4](#src-stm32g031g8u6tr-ds-text-p46)
</EvidenceFact>

### RECOMMENDED\_OPERATION

The range the manufacturer intends the part to be used in. Always narrower than the absolute maximum.

<EvidenceFact>
  <EvidenceAnchor id="fact-stm32g031g8u6tr-operating-temperature" />

  **Fact:** `fact-stm32g031g8u6tr-operating-temperature`

  **Value:** -40 to +85 · **Unit:** `degC`

  **Conditions:** temperature range code 6 of the exact ordering code (ordering information scheme); the datasheet's general operating conditions table (TA/TJ rows) is not in the recorded extract; manufacturer data only; not a thermal qualification of the assembled module

  **Verdict:** PASS - primary-source confirmed · **Provenance:** PRIMARY-SPEC

  **Evidence:** [src-stm32g031g8u6tr-ds: printed page 122 ordering information scheme row temperature range](#src-stm32g031g8u6tr-ds)
</EvidenceFact>

<EvidenceFact>
  <EvidenceAnchor id="fact-stm32g031g8u6tr-vdd-operating" />

  **Fact:** `fact-stm32g031g8u6tr-vdd-operating`

  **Value:** 1.7 to 3.6 · **Unit:** `V`

  **Conditions:** standard operating VDD (Table 21); VDDA 1.62 to 3.6 V for ADC operation; I/O input voltage in operation -0.3 to Min(VDD + 3.6, 5.5) V except RST; note 1: after RESET is released, functionality is guaranteed down to VPDR min; note 2: above VDD + 0.3 V the internal pull-up and pull-down must be disabled. Read from the owner's text conversion of DS12992 Rev 4 (see the source's authority note), not from a PDF render.

  **Verdict:** PASS - primary-source confirmed · **Provenance:** PRIMARY-SPEC

  **Evidence:** [src-stm32g031g8u6tr-ds-text-p46: Table 21 General operating conditions, rows VDD, VDDA, VIN](#src-stm32g031g8u6tr-ds-text-p46)
</EvidenceFact>

### PROJECT\_STATE

A value this project recorded about how the part is used here — a chosen operating point, a net assignment, or a derived figure. Not a manufacturer specification.

<EvidenceFact>
  <EvidenceAnchor id="fact-stm32g031g8u6tr-manufacturer" />

  **Fact:** `fact-stm32g031g8u6tr-manufacturer`

  **Value:** STMicroelectronics · **Unit:** `NONE`

  **Conditions:** Exact part applicability inspected in acquired primary document; no stock, assembly or hardware qualification.

  **Verdict:** PASS - primary-source confirmed · **Provenance:** PRIMARY-SPEC

  **Evidence:** [src-stm32g031g8u6tr-ds: printed 33 Figure 6 UFQFPN28 top view; 104 package; 122 ordering](#src-stm32g031g8u6tr-ds)
</EvidenceFact>

<EvidenceFact>
  <EvidenceAnchor id="fact-stm32g031g8u6tr-distributor-identity" />

  **Fact:** `fact-stm32g031g8u6tr-distributor-identity`

  **Value:** `lcsc`=C5270180; `manufacturer`=STMicroelectronics; `mpn`=STM32G031G8U6TR; `variant`=UFQFPN-28(4x4) · **Unit:** `NONE`

  **Conditions:** order-code identity only; not performance evidence

  **Verdict:** CONFIRMED - distributor identity only · **Provenance:** DISTRIBUTOR-IDENTITY

  **Evidence:** [src-stm32g031g8u6tr-a5-jlcpcb-snapshot: product table rows code, model, brand, specification](#src-stm32g031g8u6tr-a5-jlcpcb-snapshot)
</EvidenceFact>

<EvidenceFact>
  <EvidenceAnchor id="fact-stm32g031g8u6tr-a5-placements" />

  **Fact:** `fact-stm32g031g8u6tr-a5-placements`

  **Value:** controller/U1 x1 (1 unique placements, 1 fitted pieces per module) · **Unit:** `NONE`

  **Conditions:** historical A5 native netlists; declared by the manual inventory provider, not bound to a schematic; as-built placement unverified

  **Verdict:** NEEDS BENCH · **Provenance:** PROJECT-CHOICE

  **Evidence:** [src-stm32g031g8u6tr-a5-netlist-controller: components section rows U1](#src-stm32g031g8u6tr-a5-netlist-controller)
</EvidenceFact>

<EvidenceFact>
  <EvidenceAnchor id="fact-stm32g031g8u6tr-pinout" />

  **Fact:** `fact-stm32g031g8u6tr-pinout`

  **Value:** manufacturer pin numbering and pin functions for package UFQFPN-28 (4x4) · **Unit:** `NONE`

  **Conditions:** Primary document now available; this broad fact remains unverified pending per-criterion review. No automatic promotion from source acquisition.

  **Verdict:** UNSOURCED · **Provenance:** UNVERIFIED

  **Evidence:** [src-stm32g031g8u6tr-ds: pinout table rows for UFQFPN28 (primary acquired 2026-11-09; this broad fact still requires per-criterion review)](#src-stm32g031g8u6tr-ds)
</EvidenceFact>

<EvidenceFact>
  <EvidenceAnchor id="fact-stm32g031g8u6tr-cad-state" />

  **Fact:** `fact-stm32g031g8u6tr-cad-state`

  **Value:** A5 footprint LightBlock:QFN28 and symbol LightBlock:MCU are not configured as catalog CAD assets (cad.enabled=false); pin-asset check not performed · **Unit:** `NONE`

  **Conditions:** catalog CAD disabled for this batch; no footprint, model or receipt reviewed

  **Verdict:** UNSOURCED · **Provenance:** PROJECT-CHOICE

  **Evidence:** [src-stm32g031g8u6tr-a5-netlist-controller: components section footprint field](#src-stm32g031g8u6tr-a5-netlist-controller)
</EvidenceFact>

<EvidenceFact>
  <EvidenceAnchor id="fact-stm32g031g8u6tr-orderable" />

  **Fact:** `fact-stm32g031g8u6tr-orderable`

  **Value:** STM32G031G8U6TR in the DS12992 ordering information scheme · **Unit:** `NONE`

  **Conditions:** Exact part applicability inspected in acquired primary document; no stock, assembly or hardware qualification.

  **Verdict:** PASS - primary-source confirmed · **Provenance:** PRIMARY-SPEC

  **Evidence:** [src-stm32g031g8u6tr-ds: printed 33 Figure 6 UFQFPN28 top view; 104 package; 122 ordering](#src-stm32g031g8u6tr-ds)
</EvidenceFact>

## Pin maps

The mapping between schematic pins and PCB pads, or physical terminals for an external part, as recorded. A record may carry more than one map when the same part is documented in more than one context.

### pinmap-stm32g031g8u6tr

<EvidenceAnchor id="pinmap-stm32g031g8u6tr" />

- **Symbol:** `LightBlock:MCU`
- **Footprint:** `LightBlock:QFN28`
- **Pins:** 28

<EvidenceDetails label="pin-assignments">
  <EvidenceTable label="pin-assignments">
    | Symbol pin | Name           | Footprint pad | Function                                                          |
    | ---------- | -------------- | ------------- | ----------------------------------------------------------------- |
    | `1`        | `PC14`         | `1`           | bidirectional; A5 nets: controller/U1=unconnected-(U1-PC14-Pad1)  |
    | `2`        | `PC15`         | `2`           | bidirectional; A5 nets: controller/U1=unconnected-(U1-PC15-Pad2)  |
    | `3`        | `VDD/VDDA`     | `3`           | power\_in; A5 nets: controller/U1=/+3V3                           |
    | `4`        | `VSS/VSSA`     | `4`           | power\_in; A5 nets: controller/U1=/GND                            |
    | `5`        | `PF2/NRST`     | `5`           | bidirectional; A5 nets: controller/U1=/NRST                       |
    | `6`        | `PA0/ADC0`     | `6`           | bidirectional; A5 nets: controller/U1=/CV\_ADC                    |
    | `7`        | `PA1`          | `7`           | bidirectional; A5 nets: controller/U1=unconnected-(U1-PA1-Pad7)   |
    | `8`        | `PA2`          | `8`           | bidirectional; A5 nets: controller/U1=/MODE\_A                    |
    | `9`        | `PA3`          | `9`           | bidirectional; A5 nets: controller/U1=/MODE\_B                    |
    | `10`       | `PA4`          | `10`          | bidirectional; A5 nets: controller/U1=/LED\_FAULT\_N              |
    | `11`       | `PA5`          | `11`          | bidirectional; A5 nets: controller/U1=/LED\_ENABLE                |
    | `12`       | `PA6/TIM3_CH1` | `12`          | bidirectional; A5 nets: controller/U1=/DATA\_L\_3V3               |
    | `13`       | `PA7/TIM3_CH2` | `13`          | bidirectional; A5 nets: controller/U1=/DATA\_R\_3V3               |
    | `14`       | `PB0`          | `14`          | bidirectional; A5 nets: controller/U1=unconnected-(U1-PB0-Pad14)  |
    | `15`       | `PB1`          | `15`          | bidirectional; A5 nets: controller/U1=unconnected-(U1-PB1-Pad15)  |
    | `16`       | `PA8`          | `16`          | bidirectional; A5 nets: controller/U1=unconnected-(U1-PA8-Pad16)  |
    | `17`       | `PC6`          | `17`          | bidirectional; A5 nets: controller/U1=unconnected-(U1-PC6-Pad17)  |
    | `18`       | `PA11`         | `18`          | bidirectional; A5 nets: controller/U1=unconnected-(U1-PA11-Pad18) |
    | `19`       | `PA12`         | `19`          | bidirectional; A5 nets: controller/U1=unconnected-(U1-PA12-Pad19) |
    | `20`       | `PA13/SWDIO`   | `20`          | bidirectional; A5 nets: controller/U1=/SWDIO                      |
    | `21`       | `PA14/SWCLK`   | `21`          | bidirectional; A5 nets: controller/U1=/SWCLK                      |
    | `22`       | `PA15`         | `22`          | bidirectional; A5 nets: controller/U1=unconnected-(U1-PA15-Pad22) |
    | `23`       | `PB3`          | `23`          | bidirectional; A5 nets: controller/U1=unconnected-(U1-PB3-Pad23)  |
    | `24`       | `PB4`          | `24`          | bidirectional; A5 nets: controller/U1=unconnected-(U1-PB4-Pad24)  |
    | `25`       | `PB5`          | `25`          | bidirectional; A5 nets: controller/U1=unconnected-(U1-PB5-Pad25)  |
    | `26`       | `PB6`          | `26`          | bidirectional; A5 nets: controller/U1=unconnected-(U1-PB6-Pad26)  |
    | `27`       | `PB7`          | `27`          | bidirectional; A5 nets: controller/U1=unconnected-(U1-PB7-Pad27)  |
    | `28`       | `PB8`          | `28`          | bidirectional; A5 nets: controller/U1=unconnected-(U1-PB8-Pad28)  |
  </EvidenceTable>
</EvidenceDetails>

## Interactions

Behaviour that is not a property of this part alone. Each interaction names the records it spans, the conditions it holds under, and how far it has been confirmed. An interaction that spans several parts appears on every one of their pages, under the same identifier, because it is equally a fact about each.

No interaction is published for this record.

## Cross-component rules

Rules that span several parts at once and are published in full on the integration page. Each rule's verdict below is that rule's own — it is a statement about the cross-component question, not about this part — and the exact wording of what the rule refuses to conclude is published with the rule itself.

No cross-component rule names this record.

## Sources

Every document cited above, with its identification, when it was retrieved, and what kind of authority it carries. Sources that could not be retrieved are listed too, with their unavailability stated, so a gap in the evidence is visible rather than absent.

### JLCPCB public product listing C5270180 (A5 retained product-props snapshot)

<EvidenceAnchor id="src-stm32g031g8u6tr-a5-jlcpcb-snapshot" />

**Source ID:** `src-stm32g031g8u6tr-a5-jlcpcb-snapshot` · **Authority:** DISTRIBUTOR\_IDENTITY

| Field | Recorded value |
| --- | --- |
| Document number | C5270180 |
| Revision | A5 snapshot observed 2026-11-05T20:15:49.918702+00:00 |
| Document date | 2026-11-05 |
| Retrieved | 2026-11-05 |
| Printed page | n/a (JSON snapshot of an HTML page) |

**Locator:** engineering/a5/ic\_led\_evidence/C5270180.snapshot.json, product table fields componentCode, componentModelEn, componentBrandEn, componentSpecificationEn

**Availability:** AVAILABLE

**Document URL:** no link is published for this source

### Light Block A5 controller native netlist (KiCad 10.0.8 export, historical)

<EvidenceAnchor id="src-stm32g031g8u6tr-a5-netlist-controller" />

**Source ID:** `src-stm32g031g8u6tr-a5-netlist-controller` · **Authority:** PROJECT\_GENERATOR

| Field | Recorded value |
| --- | --- |
| Document number | engineering/a5/integration/native\_schematic/controller/netlist.xml |
| Revision | A5 |
| Document date | 2026-11-06 |
| Retrieved | 2026-11-06 |
| Printed page | n/a (XML netlist) |

**Locator:** engineering/a5/integration/native\_schematic/controller/netlist.xml, components section rows for U1 and the matching nets section nodes

**Availability:** AVAILABLE

**Document URL:** [https://github.com/Takazudo/zudo-led-block/blob/d41cbb7fc61dc954b4affaf19527aa69f07013b6/engineering/a5/integration/native\_schematic/controller/netlist.xml](https://github.com/Takazudo/zudo-led-block/blob/d41cbb7fc61dc954b4affaf19527aa69f07013b6/engineering/a5/integration/native_schematic/controller/netlist.xml)

### STMicroelectronics STM32G031x4/x6/x8 datasheet

<EvidenceAnchor id="src-stm32g031g8u6tr-ds" />

**Source ID:** `src-stm32g031g8u6tr-ds` · **Authority:** MANUFACTURER\_PRIMARY

| Field | Recorded value |
| --- | --- |
| Document number | DS12992 |
| Revision | Rev 4 |
| Document date | 2025-06 |
| Retrieved | 2026-11-09 |
| Printed page | 1 |

**Locator:** printed 33 Figure 6 UFQFPN28 top view; 104 package; 122 ordering

**Availability:** AVAILABLE

**Document URL:** [https://www.st.com/resource/en/datasheet/stm32g031f8.pdf](https://www.st.com/resource/en/datasheet/stm32g031f8.pdf)

### STMicroelectronics STM32G031x4/x6/x8 datasheet (owner download, delivered as a text conversion)

<EvidenceAnchor id="src-stm32g031g8u6tr-ds-text-p45" />

**Source ID:** `src-stm32g031g8u6tr-ds-text-p45` · **Authority:** MANUFACTURER\_PRIMARY

| Field | Recorded value |
| --- | --- |
| Document number | DS12992 |
| Revision | Rev 4 |
| Document date | 2025-06 |
| Retrieved | 2026-11-12 |
| Printed page | 45/126 |

**Locator:** printed page 45 (text extraction): section 5.2 Absolute maximum ratings, Table 18 Voltage characteristics and Table 19 Current characteristics (first part)

**Availability:** AVAILABLE

**Document URL:** [https://www.st.com/resource/en/datasheet/stm32g031f8.pdf](https://www.st.com/resource/en/datasheet/stm32g031f8.pdf)

### STMicroelectronics STM32G031x4/x6/x8 datasheet (owner download, delivered as a text conversion)

<EvidenceAnchor id="src-stm32g031g8u6tr-ds-text-p46" />

**Source ID:** `src-stm32g031g8u6tr-ds-text-p46` · **Authority:** MANUFACTURER\_PRIMARY

| Field | Recorded value |
| --- | --- |
| Document number | DS12992 |
| Revision | Rev 4 |
| Document date | 2025-06 |
| Retrieved | 2026-11-12 |
| Printed page | 46/126 |

**Locator:** printed page 46 (text extraction): Table 19 Current characteristics (continued), Table 20 Thermal characteristics, Table 21 General operating conditions

**Availability:** AVAILABLE

**Document URL:** [https://www.st.com/resource/en/datasheet/stm32g031f8.pdf](https://www.st.com/resource/en/datasheet/stm32g031f8.pdf)

## Legend

What the recorded terms on this page mean, in ordinary words. The exact terms above are the ones that count; these descriptions explain them and never replace them.

### Verdict

| Recorded term | What it means |
| --- | --- |
| `CONFIRMED - distributor identity only` | A distributor listing confirms which part this is, and nothing more. It carries no electrical, thermal or lifetime authority. |
| `NEEDS BENCH` | Cannot be settled from documents. It needs measurement on real hardware before it can be relied on. |
| `PASS - primary-source confirmed` | Confirmed against the manufacturer's own document for this exact part. |
| `UNSOURCED` | No accepted source backs this value yet. Treat it as a claim, not a fact. |

### Provenance

| Recorded term | What it means |
| --- | --- |
| `DISTRIBUTOR-IDENTITY` | Taken from a distributor listing. Identity information only. |
| `PRIMARY-SPEC` | Taken from the manufacturer's own specification document. |
| `PROJECT-CHOICE` | A decision made by this project. No vendor asserts it. |
| `UNVERIFIED` | Recorded, but not yet backed by an accepted source. |

### Fact class

| Recorded term | What it means |
| --- | --- |
| `ABSOLUTE_MAXIMUM` | A never-exceed limit. Reaching it may damage the part; it is not an operating target and there is no margin implied by it. |
| `PROJECT_STATE` | A value this project recorded about how the part is used here — a chosen operating point, a net assignment, or a derived figure. Not a manufacturer specification. |
| `RECOMMENDED_OPERATION` | The range the manufacturer intends the part to be used in. Always narrower than the absolute maximum. |

### Coverage status

| Recorded term | What it means |
| --- | --- |
| `COVERED` | Every question this domain asks is answered by the facts listed against it. |
| `OPEN` | Unresolved. Open means the question has not been answered, not that the part is unsafe — the reason states what is missing. |

### Source availability

| Recorded term | What it means |
| --- | --- |
| `AVAILABLE` | The document was retrieved and is on record. |

### Source authority

| Recorded term | What it means |
| --- | --- |
| `DISTRIBUTOR_IDENTITY` | A distributor listing. Establishes which part this is, nothing more. |
| `MANUFACTURER_PRIMARY` | The manufacturer's own document for this exact part. |
| `PROJECT_GENERATOR` | A document this project generated, such as a schematic or netlist export. |

### Identity state

| Recorded term | What it means |
| --- | --- |
| `VERIFIED` | The exact orderable part has been confirmed against a source. |

### Source state

| Recorded term | What it means |
| --- | --- |
| `AVAILABLE` | At least one document backing this line was retrieved. |

### Unit

| Recorded term | What it means |
| --- | --- |
| `NONE` | The value is not a physical quantity, so it carries no unit. Recorded as \`NONE\`. |

## Raw agent resource

This page is generated from a stored evidence bundle and does not restate it. The bundle is the source of truth: where the two ever disagree, the bundle is right and this page is stale.

[Open the owning bundle](/docs/claude-skills/component-stm32g031g8u6tr/) `component-stm32g031g8u6tr`
