Takazudo/zudo-led-block/doc/src/content/docs/components/records/ap63205wu-7/index.mdx

---
# GENERATED by @takazudo/zudo-circuit-doc — do not edit; run `zudo-circuit-doc generate`
title: "AP63205WU-7"
description: "fixed 5 v buck converter — Diodes Incorporated — C2071056 — controller U2 — rec-ap63205wu-7"
sidebar_position: 12
---

<EvidenceAnchor id="rec-ap63205wu-7" />

Generated from the component evidence records — edit the records, not this page.

Everything below is projected from this project's stored component evidence. Values keep the exact wording, conditions, units and verdicts they were recorded with — nothing here is re-typed, corrected, or combined into an overall judgement about the part.

This record in the catalog: [AP63205WU-7](/docs/components/catalog/#rec-ap63205wu-7)

## Identity

| Field | Recorded value |
| --- | --- |
| Record ID | `rec-ap63205wu-7` |
| Record kind | standalone |
| Manufacturer part number | `AP63205WU-7` |
| Manufacturer | Diodes Incorporated |
| Function | fixed 5 v buck converter |
| LCSC ID | `C2071056` |
| Package | `TSOT-23-6` |
| Inventory line | `line-ap63205wu-7` |
| Owner skill | `component-ap63205wu-7`  |

**Fit:** Fitted

**Identity state:** VERIFIED

**Source state:** AVAILABLE

**Coverage:** 2 open of 5 published

## Documents and package

<EvidenceAnchor id="component-references-heading" />

<EvidenceAnchor id="component-references" />

[Datasheet PDF](https://www.diodes.com/assets/Datasheets/AP63200-AP63201-AP63203-AP63205.pdf) — AP63200/AP63201/AP63203/AP63205 3.8V to 32V input, 2A low IQ synchronous buck with enhanced EMI reduction

**Selected source ID:** `src-ap63205wu-7-ds-p0`

**Authority:** MANUFACTURER\_PRIMARY

**Availability:** AVAILABLE

No footprint or 3D model is published for this record: CAD is not enabled for this project.

## Placements

Every position this exact line occupies in the as-built design. One line may be placed many times and across more than one board.

| Board | Reference designator |
| --- | --- |
| controller | `U2` |

## Coverage

Coverage is stated one domain at a time and is never rolled up. A domain marked open is a question that has not been answered; it is not a finding that the part is unsuitable. A record with no open domains has not thereby been declared safe.

### identity

<EvidenceAnchor id="cov-ap63205wu-7-identity" />

**Coverage ID:** `cov-ap63205wu-7-identity` · **Status:** COVERED

**Reason:** manufacturer and exact orderable AP63205WU-7 confirmed in the Diodes DS41326 Rev. 3 - 2 title block and Ordering Information table; distributor listing retained for order-code identity

**Facts in this domain:**

- [`fact-ap63205wu-7-manufacturer`](#fact-ap63205wu-7-manufacturer)
- [`fact-ap63205wu-7-orderable`](#fact-ap63205wu-7-orderable)
- [`fact-ap63205wu-7-distributor-identity`](#fact-ap63205wu-7-distributor-identity)

### pinout

<EvidenceAnchor id="cov-ap63205wu-7-pinout" />

**Coverage ID:** `cov-ap63205wu-7-pinout` · **Status:** COVERED

**Reason:** TSOT26 pin functions read from the DS41326 Pin Descriptions table and matched to the project pin map by number and function

**Facts in this domain:**

- [`fact-ap63205wu-7-pinout`](#fact-ap63205wu-7-pinout)

### electrical-ratings

<EvidenceAnchor id="cov-ap63205wu-7-ratings" />

**Coverage ID:** `cov-ap63205wu-7-ratings` · **Status:** COVERED

**Reason:** absolute-maximum VIN/VEN/VFB, recommended VIN range, AP63205 output regulation, peak current limit and switching frequency read from DS41326 pages 4 and 5

**Facts in this domain:**

- [`fact-ap63205wu-7-ratings`](#fact-ap63205wu-7-ratings)
- [`fact-ap63205wu-7-en-abs-max`](#fact-ap63205wu-7-en-abs-max)
- [`fact-ap63205wu-7-fb-abs-max`](#fact-ap63205wu-7-fb-abs-max)
- [`fact-ap63205wu-7-vin-recommended`](#fact-ap63205wu-7-vin-recommended)
- [`fact-ap63205wu-7-vout`](#fact-ap63205wu-7-vout)
- [`fact-ap63205wu-7-peak-current-limit`](#fact-ap63205wu-7-peak-current-limit)
- [`fact-ap63205wu-7-switching-frequency`](#fact-ap63205wu-7-switching-frequency)
- [`fact-ap63205wu-7-operating-temperature`](#fact-ap63205wu-7-operating-temperature)
- [`fact-ap63205wu-7-storage-temperature`](#fact-ap63205wu-7-storage-temperature)
- [`fact-ap63205wu-7-recommended-capacitors`](#fact-ap63205wu-7-recommended-capacitors)

### placement

<EvidenceAnchor id="cov-ap63205wu-7-placement" />

**Coverage ID:** `cov-ap63205wu-7-placement` · **Status:** OPEN

**Reason:** fact-ap63205wu-7-a5-placements NEEDS BENCH: placements are declared from the historical A5 netlist only; the manual provider performs no schematic binding and no as-built check exists

**Facts in this domain:**

- [`fact-ap63205wu-7-a5-placements`](#fact-ap63205wu-7-a5-placements)

**Blocked by:** these facts must be resolved before the domain can close. Each is listed in full under Facts.

- [`fact-ap63205wu-7-a5-placements`](#fact-ap63205wu-7-a5-placements)

### cad-assets

<EvidenceAnchor id="cov-ap63205wu-7-cad" />

**Coverage ID:** `cov-ap63205wu-7-cad` · **Status:** OPEN

**Reason:** fact-ap63205wu-7-cad-state remains UNSOURCED: catalog CAD is disabled, so no symbol, footprint or model was reviewed or validated

**Facts in this domain:**

- [`fact-ap63205wu-7-cad-state`](#fact-ap63205wu-7-cad-state)

**Blocked by:** these facts must be resolved before the domain can close. Each is listed in full under Facts.

- [`fact-ap63205wu-7-cad-state`](#fact-ap63205wu-7-cad-state)

## Facts

Each fact keeps its value, its unit, the conditions it holds under, where it came from and how far it has been confirmed as separate fields, because they are separate claims. A value without its conditions is not the same fact, and a verdict is about the evidence for the value, not about the part.

### ABSOLUTE\_MAXIMUM

A never-exceed limit. Reaching it may damage the part; it is not an operating target and there is no margin implied by it.

<EvidenceFact>
  <EvidenceAnchor id="fact-ap63205wu-7-ratings" />

  **Fact:** `fact-ap63205wu-7-ratings`

  **Value:** 35 · **Unit:** `V`

  **Conditions:** VIN supply voltage absolute maximum -0.3 to +35.0 V DC (-0.3 to +40.0 V for 400 ms); TA=+25C; stress rating only, not an operating condition

  **Verdict:** PASS - primary-source confirmed · **Provenance:** PRIMARY-SPEC

  **Evidence:** [src-ap63205wu-7-ds-p3: Absolute Maximum Ratings table row VIN](#src-ap63205wu-7-ds-p3)
</EvidenceFact>

<EvidenceFact>
  <EvidenceAnchor id="fact-ap63205wu-7-en-abs-max" />

  **Fact:** `fact-ap63205wu-7-en-abs-max`

  **Value:** 35 · **Unit:** `V`

  **Conditions:** VEN enable/UVLO voltage absolute maximum -0.3 to +35.0 V; TA=+25C

  **Verdict:** PASS - primary-source confirmed · **Provenance:** PRIMARY-SPEC

  **Evidence:** [src-ap63205wu-7-ds-p3: Absolute Maximum Ratings table row VEN](#src-ap63205wu-7-ds-p3)
</EvidenceFact>

<EvidenceFact>
  <EvidenceAnchor id="fact-ap63205wu-7-fb-abs-max" />

  **Fact:** `fact-ap63205wu-7-fb-abs-max`

  **Value:** 6 · **Unit:** `V`

  **Conditions:** VFB feedback voltage absolute maximum -0.3 to +6.0 V; TA=+25C

  **Verdict:** PASS - primary-source confirmed · **Provenance:** PRIMARY-SPEC

  **Evidence:** [src-ap63205wu-7-ds-p3: Absolute Maximum Ratings table row VFB](#src-ap63205wu-7-ds-p3)
</EvidenceFact>

<EvidenceFact>
  <EvidenceAnchor id="fact-ap63205wu-7-storage-temperature" />

  **Fact:** `fact-ap63205wu-7-storage-temperature`

  **Value:** -65 to +150 · **Unit:** `degC`

  **Conditions:** TST storage temperature, absolute maximum

  **Verdict:** PASS - primary-source confirmed · **Provenance:** PRIMARY-SPEC

  **Evidence:** [src-ap63205wu-7-ds-p3: Absolute Maximum Ratings table row TST](#src-ap63205wu-7-ds-p3)
</EvidenceFact>

### RECOMMENDED\_OPERATION

The range the manufacturer intends the part to be used in. Always narrower than the absolute maximum.

<EvidenceFact>
  <EvidenceAnchor id="fact-ap63205wu-7-vin-recommended" />

  **Fact:** `fact-ap63205wu-7-vin-recommended`

  **Value:** 3.8 to 32 · **Unit:** `V`

  **Conditions:** VIN supply voltage recommended operating range, min 3.8 V, max 32 V; TA -40C to +85C; function not guaranteed outside this range

  **Verdict:** PASS - primary-source confirmed · **Provenance:** PRIMARY-SPEC

  **Evidence:** [src-ap63205wu-7-ds-p3: Recommended Operating Conditions table row VIN](#src-ap63205wu-7-ds-p3)
</EvidenceFact>

<EvidenceFact>
  <EvidenceAnchor id="fact-ap63205wu-7-operating-temperature" />

  **Fact:** `fact-ap63205wu-7-operating-temperature`

  **Value:** -40 to +85 · **Unit:** `degC`

  **Conditions:** TA operating ambient temperature range (recommended operating conditions); absolute maximum TJ +160 C; manufacturer data only; not a thermal qualification of the assembled module

  **Verdict:** PASS - primary-source confirmed · **Provenance:** PRIMARY-SPEC

  **Evidence:** [src-ap63205wu-7-ds-p3: Recommended Operating Conditions table row TA](#src-ap63205wu-7-ds-p3)
</EvidenceFact>

<EvidenceFact>
  <EvidenceAnchor id="fact-ap63205wu-7-recommended-capacitors" />

  **Fact:** `fact-ap63205wu-7-recommended-capacitors`

  **Value:** C1 10; C2 2 x 22 · **Unit:** `uF`

  **Conditions:** Table 3 component values for the fixed 5 V AP63205 (C1 input, C2 output); the datasheet does not say whether these are nominal or effective values and states no minimum effective capacitance; Section 11 says a ceramic input capacitor greater than 10 µF is sufficient for most applications, and Section 12 (src-ap63205wu-7-ds-p13) says 22 µF to 68 µF output is sufficient for most applications, with Eq. 10 giving a load-transient lower bound that needs a load step and an allowed overshoot chosen by the project

  **Verdict:** PASS - primary-source confirmed · **Provenance:** PRIMARY-SPEC

  **Evidence:** [src-ap63205wu-7-ds-p12: Table 3 Recommended Component Selections for AP63205 row 5 V](#src-ap63205wu-7-ds-p12)
</EvidenceFact>

### GUARANTEED\_ELECTRICAL

A parameter the manufacturer guarantees over the stated conditions, usually with minimum, typical and maximum values.

<EvidenceFact>
  <EvidenceAnchor id="fact-ap63205wu-7-vout" />

  **Fact:** `fact-ap63205wu-7-vout`

  **Value:** 4.95 to 5.05 (typ 5.00) · **Unit:** `V`

  **Conditions:** VFB regulation for AP63205 in CCM: min 4.95 V, typ 5.00 V, max 5.05 V; min/max over TA -40C to +85C and VIN 3.8 V to 32 V

  **Verdict:** PASS - primary-source confirmed · **Provenance:** PRIMARY-SPEC

  **Evidence:** [src-ap63205wu-7-ds-p4: Electrical Characteristics table row VFB, condition CCM AP63205](#src-ap63205wu-7-ds-p4)
</EvidenceFact>

<EvidenceFact>
  <EvidenceAnchor id="fact-ap63205wu-7-peak-current-limit" />

  **Fact:** `fact-ap63205wu-7-peak-current-limit`

  **Value:** 2.5 to 3.1 (typ 2.8) · **Unit:** `A`

  **Conditions:** IPEAK\_LIMIT high-side peak current limit min 2.5 A, typ 2.8 A, max 3.1 A (Note 8: production test, characterization and/or design); 2A continuous output current is the page-1 feature rating

  **Verdict:** PASS - primary-source confirmed · **Provenance:** PRIMARY-SPEC

  **Evidence:** [src-ap63205wu-7-ds-p4: Electrical Characteristics table row IPEAK\_LIMIT](#src-ap63205wu-7-ds-p4)
</EvidenceFact>

### TYPICAL\_CURVE

A representative figure read from a characteristic curve. Typical values are not guaranteed and vary part to part.

<EvidenceFact>
  <EvidenceAnchor id="fact-ap63205wu-7-switching-frequency" />

  **Fact:** `fact-ap63205wu-7-switching-frequency`

  **Value:** 1.1 · **Unit:** `MHz`

  **Conditions:** fSW oscillator frequency AP63203/AP63205 typ 1100 kHz with frequency spread spectrum typ +/-6 %; typical only, no min/max printed

  **Verdict:** PASS - primary-source confirmed · **Provenance:** PRIMARY-SPEC

  **Evidence:** [src-ap63205wu-7-ds-p4: Electrical Characteristics table rows fSW and FSS](#src-ap63205wu-7-ds-p4)
</EvidenceFact>

### PROJECT\_STATE

A value this project recorded about how the part is used here — a chosen operating point, a net assignment, or a derived figure. Not a manufacturer specification.

<EvidenceFact>
  <EvidenceAnchor id="fact-ap63205wu-7-manufacturer" />

  **Fact:** `fact-ap63205wu-7-manufacturer`

  **Value:** Diodes Incorporated · **Unit:** `NONE`

  **Conditions:** manufacturer-primary datasheet DS41326 Rev. 3 - 2 served from diodes.com; printed form "(c) 2024 Copyright Diodes Incorporated" in the page footer; PDF Author metadata "Diodes Incorporated"

  **Verdict:** PASS - primary-source confirmed · **Provenance:** PRIMARY-SPEC

  **Evidence:** [src-ap63205wu-7-ds-p0: page 1 title block and footer copyright row](#src-ap63205wu-7-ds-p0)
</EvidenceFact>

<EvidenceFact>
  <EvidenceAnchor id="fact-ap63205wu-7-distributor-identity" />

  **Fact:** `fact-ap63205wu-7-distributor-identity`

  **Value:** `lcsc`=C2071056; `manufacturer`=Diodes Incorporated; `mpn`=AP63205WU-7; `variant`=TSOT-23-6 · **Unit:** `NONE`

  **Conditions:** order-code identity only; not performance evidence

  **Verdict:** CONFIRMED - distributor identity only · **Provenance:** DISTRIBUTOR-IDENTITY

  **Evidence:** [src-ap63205wu-7-a5-jlcpcb-snapshot: product table rows code, model, brand, specification](#src-ap63205wu-7-a5-jlcpcb-snapshot)
</EvidenceFact>

<EvidenceFact>
  <EvidenceAnchor id="fact-ap63205wu-7-a5-placements" />

  **Fact:** `fact-ap63205wu-7-a5-placements`

  **Value:** controller/U2 x1 (1 unique placements, 1 fitted pieces per module) · **Unit:** `NONE`

  **Conditions:** historical A5 native netlists; declared by the manual inventory provider, not bound to a schematic; as-built placement unverified

  **Verdict:** NEEDS BENCH · **Provenance:** PROJECT-CHOICE

  **Evidence:** [src-ap63205wu-7-a5-netlist-controller: components section rows U2](#src-ap63205wu-7-a5-netlist-controller)
</EvidenceFact>

<EvidenceFact>
  <EvidenceAnchor id="fact-ap63205wu-7-pinout" />

  **Fact:** `fact-ap63205wu-7-pinout`

  **Value:** 1 FB; 2 EN; 3 VIN; 4 GND; 5 SW; 6 BST · **Unit:** `NONE`

  **Conditions:** TSOT26 package; Pin Descriptions table agrees with the page-1 Pin Assignments figure; matches project pin map by number and function (pin map: 1 FB, 2 EN, 3 VIN, 4 GND, 5 SW, 6 BST)

  **Verdict:** PASS - primary-source confirmed · **Provenance:** PRIMARY-SPEC

  **Evidence:** [src-ap63205wu-7-ds-p1: Pin Descriptions table rows pin 1 to pin 6](#src-ap63205wu-7-ds-p1)
</EvidenceFact>

<EvidenceFact>
  <EvidenceAnchor id="fact-ap63205wu-7-cad-state" />

  **Fact:** `fact-ap63205wu-7-cad-state`

  **Value:** A5 footprint LightBlock:TSOT26 and symbol LightBlock:BUCK are not configured as catalog CAD assets (cad.enabled=false); pin-asset check not performed · **Unit:** `NONE`

  **Conditions:** catalog CAD disabled for this batch; no footprint, model or receipt reviewed

  **Verdict:** UNSOURCED · **Provenance:** PROJECT-CHOICE

  **Evidence:** [src-ap63205wu-7-a5-netlist-controller: components section footprint field](#src-ap63205wu-7-a5-netlist-controller)
</EvidenceFact>

<EvidenceFact>
  <EvidenceAnchor id="fact-ap63205wu-7-orderable" />

  **Fact:** `fact-ap63205wu-7-orderable`

  **Value:** AP63205WU-7 listed: TSOT26, PWM/PFM, 1100 kHz, fixed 5V output, package code WU, 3000 per 7-inch tape and reel · **Unit:** `NONE`

  **Conditions:** exact orderable MPN appears in the manufacturer ordering table; Diodes names the package TSOT26, the record package string TSOT-23-6 is the distributor description

  **Verdict:** PASS - primary-source confirmed · **Provenance:** PRIMARY-SPEC

  **Evidence:** [src-ap63205wu-7-ds-p15: Ordering Information table row AP63205WU-7](#src-ap63205wu-7-ds-p15)
</EvidenceFact>

## Pin maps

The mapping between schematic pins and PCB pads, or physical terminals for an external part, as recorded. A record may carry more than one map when the same part is documented in more than one context.

### pinmap-ap63205wu-7

<EvidenceAnchor id="pinmap-ap63205wu-7" />

- **Symbol:** `LightBlock:BUCK`
- **Footprint:** `LightBlock:TSOT26`
- **Pins:** 6

<EvidenceDetails label="pin-assignments">
  <EvidenceTable label="pin-assignments">
    | Symbol pin | Name  | Footprint pad | Function                                      |
    | ---------- | ----- | ------------- | --------------------------------------------- |
    | `1`        | `FB`  | `1`           | input; A5 nets: controller/U2=/+5V            |
    | `2`        | `EN`  | `2`           | input; A5 nets: controller/U2=/+12V\_PROT     |
    | `3`        | `VIN` | `3`           | power\_in; A5 nets: controller/U2=/+12V\_PROT |
    | `4`        | `GND` | `4`           | power\_in; A5 nets: controller/U2=/GND        |
    | `5`        | `SW`  | `5`           | power\_out; A5 nets: controller/U2=/BUCK\_SW  |
    | `6`        | `BST` | `6`           | passive; A5 nets: controller/U2=/BUCK\_BST    |
  </EvidenceTable>
</EvidenceDetails>

## Interactions

Behaviour that is not a property of this part alone. Each interaction names the records it spans, the conditions it holds under, and how far it has been confirmed. An interaction that spans several parts appears on every one of their pages, under the same identifier, because it is equally a fact about each.

No interaction is published for this record.

## Cross-component rules

Rules that span several parts at once and are published in full on the integration page. Each rule's verdict below is that rule's own — it is a statement about the cross-component question, not about this part — and the exact wording of what the rule refuses to conclude is published with the rule itself.

No cross-component rule names this record.

## Sources

Every document cited above, with its identification, when it was retrieved, and what kind of authority it carries. Sources that could not be retrieved are listed too, with their unavailability stated, so a gap in the evidence is visible rather than absent.

### JLCPCB public product listing C2071056 (A5 retained product-props snapshot)

<EvidenceAnchor id="src-ap63205wu-7-a5-jlcpcb-snapshot" />

**Source ID:** `src-ap63205wu-7-a5-jlcpcb-snapshot` · **Authority:** DISTRIBUTOR\_IDENTITY

| Field | Recorded value |
| --- | --- |
| Document number | C2071056 |
| Revision | A5 snapshot observed 2026-11-05T20:15:49.716982+00:00 |
| Document date | 2026-11-05 |
| Retrieved | 2026-11-05 |
| Printed page | n/a (JSON snapshot of an HTML page) |

**Locator:** engineering/a5/ic\_led\_evidence/C2071056.snapshot.json, product table fields componentCode, componentModelEn, componentBrandEn, componentSpecificationEn

**Availability:** AVAILABLE

**Document URL:** no link is published for this source

### Light Block A5 controller native netlist (KiCad 10.0.8 export, historical)

<EvidenceAnchor id="src-ap63205wu-7-a5-netlist-controller" />

**Source ID:** `src-ap63205wu-7-a5-netlist-controller` · **Authority:** PROJECT\_GENERATOR

| Field | Recorded value |
| --- | --- |
| Document number | engineering/a5/integration/native\_schematic/controller/netlist.xml |
| Revision | A5 |
| Document date | 2026-11-06 |
| Retrieved | 2026-11-06 |
| Printed page | n/a (XML netlist) |

**Locator:** engineering/a5/integration/native\_schematic/controller/netlist.xml, components section rows for U2 and the matching nets section nodes

**Availability:** AVAILABLE

**Document URL:** [https://github.com/Takazudo/zudo-led-block/blob/d41cbb7fc61dc954b4affaf19527aa69f07013b6/engineering/a5/integration/native\_schematic/controller/netlist.xml](https://github.com/Takazudo/zudo-led-block/blob/d41cbb7fc61dc954b4affaf19527aa69f07013b6/engineering/a5/integration/native_schematic/controller/netlist.xml)

### AP63200/AP63201/AP63203/AP63205 3.8V to 32V input, 2A low IQ synchronous buck with enhanced EMI reduction

<EvidenceAnchor id="src-ap63205wu-7-ds-p0" />

**Source ID:** `src-ap63205wu-7-ds-p0` · **Authority:** MANUFACTURER\_PRIMARY

| Field | Recorded value |
| --- | --- |
| Document number | DS41326 |
| Revision | Rev. 3 - 2 |
| Document date | 2024-11 |
| Retrieved | 2026-11-08 |
| Printed page | 1 of 18 |

**Locator:** Page 1: title block, Features section, Pin Assignments figure (TSOT26 top view) and footer

**Availability:** AVAILABLE

**Document URL:** [https://www.diodes.com/assets/Datasheets/AP63200-AP63201-AP63203-AP63205.pdf](https://www.diodes.com/assets/Datasheets/AP63200-AP63201-AP63203-AP63205.pdf)

### AP63200/AP63201/AP63203/AP63205 3.8V to 32V input, 2A low IQ synchronous buck with enhanced EMI reduction

<EvidenceAnchor id="src-ap63205wu-7-ds-p1" />

**Source ID:** `src-ap63205wu-7-ds-p1` · **Authority:** MANUFACTURER\_PRIMARY

| Field | Recorded value |
| --- | --- |
| Document number | DS41326 |
| Revision | Rev. 3 - 2 |
| Document date | 2024-11 |
| Retrieved | 2026-11-08 |
| Printed page | 2 of 18 |

**Locator:** Page 2: Pin Descriptions table, rows pin 1 to pin 6

**Availability:** AVAILABLE

**Document URL:** [https://www.diodes.com/assets/Datasheets/AP63200-AP63201-AP63203-AP63205.pdf](https://www.diodes.com/assets/Datasheets/AP63200-AP63201-AP63203-AP63205.pdf)

### AP63200/AP63201/AP63203/AP63205 3.8V to 32V input, 2A low IQ synchronous buck with enhanced EMI reduction

<EvidenceAnchor id="src-ap63205wu-7-ds-p3" />

**Source ID:** `src-ap63205wu-7-ds-p3` · **Authority:** MANUFACTURER\_PRIMARY

| Field | Recorded value |
| --- | --- |
| Document number | DS41326 |
| Revision | Rev. 3 - 2 |
| Document date | 2024-11 |
| Retrieved | 2026-11-08 |
| Printed page | 4 of 18 |

**Locator:** Page 4: Absolute Maximum Ratings table (rows VIN, VSW, VBST, VFB, VEN, TJ) and Recommended Operating Conditions table (rows VIN, TA)

**Availability:** AVAILABLE

**Document URL:** [https://www.diodes.com/assets/Datasheets/AP63200-AP63201-AP63203-AP63205.pdf](https://www.diodes.com/assets/Datasheets/AP63200-AP63201-AP63203-AP63205.pdf)

### AP63200/AP63201/AP63203/AP63205 3.8V to 32V input, 2A low IQ synchronous buck with enhanced EMI reduction

<EvidenceAnchor id="src-ap63205wu-7-ds-p4" />

**Source ID:** `src-ap63205wu-7-ds-p4` · **Authority:** MANUFACTURER\_PRIMARY

| Field | Recorded value |
| --- | --- |
| Document number | DS41326 |
| Revision | Rev. 3 - 2 |
| Document date | 2024-11 |
| Retrieved | 2026-11-08 |
| Printed page | 5 of 18 |

**Locator:** Page 5: Electrical Characteristics table, rows IPEAK\_LIMIT, fSW, FSS, VFB (CCM, AP63205)

**Availability:** AVAILABLE

**Document URL:** [https://www.diodes.com/assets/Datasheets/AP63200-AP63201-AP63203-AP63205.pdf](https://www.diodes.com/assets/Datasheets/AP63200-AP63201-AP63203-AP63205.pdf)

### AP63200/AP63201/AP63203/AP63205 3.8V to 32V input, 2A low IQ synchronous buck with enhanced EMI reduction

<EvidenceAnchor id="src-ap63205wu-7-ds-p15" />

**Source ID:** `src-ap63205wu-7-ds-p15` · **Authority:** MANUFACTURER\_PRIMARY

| Field | Recorded value |
| --- | --- |
| Document number | DS41326 |
| Revision | Rev. 3 - 2 |
| Document date | 2024-11 |
| Retrieved | 2026-11-08 |
| Printed page | 16 of 18 |

**Locator:** Page 16: Ordering Information table, row AP63205WU-7

**Availability:** AVAILABLE

**Document URL:** [https://www.diodes.com/assets/Datasheets/AP63200-AP63201-AP63203-AP63205.pdf](https://www.diodes.com/assets/Datasheets/AP63200-AP63201-AP63203-AP63205.pdf)

### AP63200/AP63201/AP63203/AP63205 3.8V to 32V input, 2A low IQ synchronous buck with enhanced EMI reduction

<EvidenceAnchor id="src-ap63205wu-7-ds-p12" />

**Source ID:** `src-ap63205wu-7-ds-p12` · **Authority:** MANUFACTURER\_PRIMARY

| Field | Recorded value |
| --- | --- |
| Document number | DS41326 |
| Revision | Rev. 3 - 2 |
| Document date | 2024-11 |
| Retrieved | 2026-11-08 |
| Printed page | 13 of 18 |

**Locator:** Page 13: Table 3 Recommended Component Selections for AP63205 (row 5 V) and Section 11 Input Capacitor

**Availability:** AVAILABLE

**Document URL:** [https://www.diodes.com/assets/Datasheets/AP63200-AP63201-AP63203-AP63205.pdf](https://www.diodes.com/assets/Datasheets/AP63200-AP63201-AP63203-AP63205.pdf)

### AP63200/AP63201/AP63203/AP63205 3.8V to 32V input, 2A low IQ synchronous buck with enhanced EMI reduction

<EvidenceAnchor id="src-ap63205wu-7-ds-p13" />

**Source ID:** `src-ap63205wu-7-ds-p13` · **Authority:** MANUFACTURER\_PRIMARY

| Field | Recorded value |
| --- | --- |
| Document number | DS41326 |
| Revision | Rev. 3 - 2 |
| Document date | 2024-11 |
| Retrieved | 2026-11-08 |
| Printed page | 14 of 18 |

**Locator:** Page 14: Section 12 Output Capacitor, Eq. 9 and Eq. 10

**Availability:** AVAILABLE

**Document URL:** [https://www.diodes.com/assets/Datasheets/AP63200-AP63201-AP63203-AP63205.pdf](https://www.diodes.com/assets/Datasheets/AP63200-AP63201-AP63203-AP63205.pdf)

## Legend

What the recorded terms on this page mean, in ordinary words. The exact terms above are the ones that count; these descriptions explain them and never replace them.

### Verdict

| Recorded term | What it means |
| --- | --- |
| `CONFIRMED - distributor identity only` | A distributor listing confirms which part this is, and nothing more. It carries no electrical, thermal or lifetime authority. |
| `NEEDS BENCH` | Cannot be settled from documents. It needs measurement on real hardware before it can be relied on. |
| `PASS - primary-source confirmed` | Confirmed against the manufacturer's own document for this exact part. |
| `UNSOURCED` | No accepted source backs this value yet. Treat it as a claim, not a fact. |

### Provenance

| Recorded term | What it means |
| --- | --- |
| `DISTRIBUTOR-IDENTITY` | Taken from a distributor listing. Identity information only. |
| `PRIMARY-SPEC` | Taken from the manufacturer's own specification document. |
| `PROJECT-CHOICE` | A decision made by this project. No vendor asserts it. |

### Fact class

| Recorded term | What it means |
| --- | --- |
| `ABSOLUTE_MAXIMUM` | A never-exceed limit. Reaching it may damage the part; it is not an operating target and there is no margin implied by it. |
| `GUARANTEED_ELECTRICAL` | A parameter the manufacturer guarantees over the stated conditions, usually with minimum, typical and maximum values. |
| `PROJECT_STATE` | A value this project recorded about how the part is used here — a chosen operating point, a net assignment, or a derived figure. Not a manufacturer specification. |
| `RECOMMENDED_OPERATION` | The range the manufacturer intends the part to be used in. Always narrower than the absolute maximum. |
| `TYPICAL_CURVE` | A representative figure read from a characteristic curve. Typical values are not guaranteed and vary part to part. |

### Coverage status

| Recorded term | What it means |
| --- | --- |
| `COVERED` | Every question this domain asks is answered by the facts listed against it. |
| `OPEN` | Unresolved. Open means the question has not been answered, not that the part is unsafe — the reason states what is missing. |

### Source availability

| Recorded term | What it means |
| --- | --- |
| `AVAILABLE` | The document was retrieved and is on record. |

### Source authority

| Recorded term | What it means |
| --- | --- |
| `DISTRIBUTOR_IDENTITY` | A distributor listing. Establishes which part this is, nothing more. |
| `MANUFACTURER_PRIMARY` | The manufacturer's own document for this exact part. |
| `PROJECT_GENERATOR` | A document this project generated, such as a schematic or netlist export. |

### Identity state

| Recorded term | What it means |
| --- | --- |
| `VERIFIED` | The exact orderable part has been confirmed against a source. |

### Source state

| Recorded term | What it means |
| --- | --- |
| `AVAILABLE` | At least one document backing this line was retrieved. |

### Unit

| Recorded term | What it means |
| --- | --- |
| `NONE` | The value is not a physical quantity, so it carries no unit. Recorded as \`NONE\`. |

## Raw agent resource

This page is generated from a stored evidence bundle and does not restate it. The bundle is the source of truth: where the two ever disagree, the bundle is right and this page is stale.

[Open the owning bundle](/docs/claude-skills/component-ap63205wu-7/) `component-ap63205wu-7`
