Takazudo/zudo-led-block/doc/src/content/docs/components/records/tlv75533pdbvr/index.mdx

---
# GENERATED by @takazudo/zudo-circuit-doc — do not edit; run `zudo-circuit-doc generate`
title: "TLV75533PDBVR"
description: "3.3 v ldo regulator — Texas Instruments — C404027 — controller U3 — rec-tlv75533pdbvr"
sidebar_position: 22
---

<EvidenceAnchor id="rec-tlv75533pdbvr" />

Generated from the component evidence records — edit the records, not this page.

Everything below is projected from this project's stored component evidence. Values keep the exact wording, conditions, units and verdicts they were recorded with — nothing here is re-typed, corrected, or combined into an overall judgement about the part.

This record in the catalog: [TLV75533PDBVR](/docs/components/catalog/#rec-tlv75533pdbvr)

## Identity

| Field | Recorded value |
| --- | --- |
| Record ID | `rec-tlv75533pdbvr` |
| Record kind | standalone |
| Manufacturer part number | `TLV75533PDBVR` |
| Manufacturer | Texas Instruments |
| Function | 3.3 v ldo regulator |
| LCSC ID | `C404027` |
| Package | `SOT-23-5` |
| Inventory line | `line-tlv75533pdbvr` |
| Owner skill | `component-tlv75533pdbvr` |

**Fit:** Fitted

**Identity state:** VERIFIED

**Source state:** AVAILABLE

**Coverage:** 2 open of 5 published

## Documents and package

<EvidenceAnchor id="component-references-heading" />

<EvidenceAnchor id="component-references" />

[Datasheet PDF](https://www.ti.com/lit/ds/symlink/tlv755p.pdf) — TLV755P 500mA, Low-IQ, Small-Size, Low-Dropout Regulator datasheet

**Selected source ID:** `src-tlv75533pdbvr-ds-2026-11-11-p3`

**Authority:** MANUFACTURER\_PRIMARY

**Availability:** AVAILABLE

No footprint or 3D model is published for this record: CAD is not enabled for this project.

## Placements

Every position this exact line occupies in the as-built design. One line may be placed many times and across more than one board.

| Board | Reference designator |
| --- | --- |
| controller | `U3` |

## Coverage

Coverage is stated one domain at a time and is never rolled up. A domain marked open is a question that has not been answered; it is not a finding that the part is unsuitable. A record with no open domains has not thereby been declared safe.

### identity

<EvidenceAnchor id="cov-tlv75533pdbvr-identity" />

**Coverage ID:** `cov-tlv75533pdbvr-identity` · **Status:** COVERED

**Reason:** manufacturer and exact orderable confirmed from the manufacturer-hosted datasheet (MANUFACTURER\_PRIMARY, bytes inspected 2026-11-08); distributor identity retained as order-code evidence

**Facts in this domain:**

- [`fact-tlv75533pdbvr-manufacturer`](#fact-tlv75533pdbvr-manufacturer)
- [`fact-tlv75533pdbvr-distributor-identity`](#fact-tlv75533pdbvr-distributor-identity)
- [`fact-tlv75533pdbvr-orderable`](#fact-tlv75533pdbvr-orderable)
- [`fact-tlv75533pdbvr-vout-nominal`](#fact-tlv75533pdbvr-vout-nominal)

### pinout

<EvidenceAnchor id="cov-tlv75533pdbvr-pinout" />

**Coverage ID:** `cov-tlv75533pdbvr-pinout` · **Status:** COVERED

**Reason:** datasheet pin table for the exact package inspected and compared with the project pin map: matches by number and function

**Facts in this domain:**

- [`fact-tlv75533pdbvr-pinout`](#fact-tlv75533pdbvr-pinout)

### electrical-ratings

<EvidenceAnchor id="cov-tlv75533pdbvr-ratings" />

**Coverage ID:** `cov-tlv75533pdbvr-ratings` · **Status:** COVERED

**Reason:** absolute-maximum, recommended-operation and design-relevant characteristics recorded from the manufacturer-hosted datasheet; this is manufacturer data only, not a design-margin or safety verdict

**Facts in this domain:**

- [`fact-tlv75533pdbvr-ratings`](#fact-tlv75533pdbvr-ratings)
- [`fact-tlv75533pdbvr-abs-max-en`](#fact-tlv75533pdbvr-abs-max-en)
- [`fact-tlv75533pdbvr-roc-vin`](#fact-tlv75533pdbvr-roc-vin)
- [`fact-tlv75533pdbvr-roc-iout`](#fact-tlv75533pdbvr-roc-iout)
- [`fact-tlv75533pdbvr-output-accuracy`](#fact-tlv75533pdbvr-output-accuracy)
- [`fact-tlv75533pdbvr-current-limit`](#fact-tlv75533pdbvr-current-limit)
- [`fact-tlv75533pdbvr-operating-temperature`](#fact-tlv75533pdbvr-operating-temperature)
- [`fact-tlv75533pdbvr-storage-temperature`](#fact-tlv75533pdbvr-storage-temperature)
- [`fact-tlv75533pdbvr-reverse-current`](#fact-tlv75533pdbvr-reverse-current)
- [`fact-tlv75533pdbvr-min-effective-capacitance`](#fact-tlv75533pdbvr-min-effective-capacitance)

### placement

<EvidenceAnchor id="cov-tlv75533pdbvr-placement" />

**Coverage ID:** `cov-tlv75533pdbvr-placement` · **Status:** OPEN

**Reason:** fact-tlv75533pdbvr-a5-placements NEEDS BENCH: placements are declared from the historical A5 netlist only; the manual provider performs no schematic binding and no as-built check exists

**Facts in this domain:**

- [`fact-tlv75533pdbvr-a5-placements`](#fact-tlv75533pdbvr-a5-placements)

**Blocked by:** these facts must be resolved before the domain can close. Each is listed in full under Facts.

- [`fact-tlv75533pdbvr-a5-placements`](#fact-tlv75533pdbvr-a5-placements)

### cad-assets

<EvidenceAnchor id="cov-tlv75533pdbvr-cad" />

**Coverage ID:** `cov-tlv75533pdbvr-cad` · **Status:** OPEN

**Reason:** fact-tlv75533pdbvr-cad-state remains UNSOURCED: catalog CAD is disabled, so no symbol, footprint or model was reviewed or validated

**Facts in this domain:**

- [`fact-tlv75533pdbvr-cad-state`](#fact-tlv75533pdbvr-cad-state)

**Blocked by:** these facts must be resolved before the domain can close. Each is listed in full under Facts.

- [`fact-tlv75533pdbvr-cad-state`](#fact-tlv75533pdbvr-cad-state)

## Facts

Each fact keeps its value, its unit, the conditions it holds under, where it came from and how far it has been confirmed as separate fields, because they are separate claims. A value without its conditions is not the same fact, and a verdict is about the evidence for the value, not about the part.

### ABSOLUTE\_MAXIMUM

A never-exceed limit. Reaching it may damage the part; it is not an operating target and there is no margin implied by it.

<EvidenceFact>
  <EvidenceAnchor id="fact-tlv75533pdbvr-ratings" />

  **Fact:** `fact-tlv75533pdbvr-ratings`

  **Value:** 6 · **Unit:** `V`

  **Conditions:** absolute maximum supply voltage VIN (min -0.3 V, max 6.0 V), over operating free-air temperature; not an operating condition; read from the manufacturer-hosted datasheet bytes inspected 2026-11-08

  **Verdict:** PASS - primary-source confirmed · **Provenance:** PRIMARY-SPEC

  **Evidence:** [src-tlv75533pdbvr-ds-p4: Section 5.1 Absolute Maximum Ratings table row Supply voltage VIN](#src-tlv75533pdbvr-ds-p4)
</EvidenceFact>

<EvidenceFact>
  <EvidenceAnchor id="fact-tlv75533pdbvr-abs-max-en" />

  **Fact:** `fact-tlv75533pdbvr-abs-max-en`

  **Value:** 6 · **Unit:** `V`

  **Conditions:** absolute maximum enable voltage VEN (min -0.3 V, max 6.0 V); A5 ties EN to /+5V (pin map); read from the manufacturer-hosted datasheet bytes inspected 2026-11-08

  **Verdict:** PASS - primary-source confirmed · **Provenance:** PRIMARY-SPEC

  **Evidence:** [src-tlv75533pdbvr-ds-p4: Section 5.1 Absolute Maximum Ratings table row Enable voltage VEN](#src-tlv75533pdbvr-ds-p4)
</EvidenceFact>

<EvidenceFact>
  <EvidenceAnchor id="fact-tlv75533pdbvr-storage-temperature" />

  **Fact:** `fact-tlv75533pdbvr-storage-temperature`

  **Value:** -65 to +150 · **Unit:** `degC`

  **Conditions:** Tstg storage temperature, absolute maximum

  **Verdict:** PASS - primary-source confirmed · **Provenance:** PRIMARY-SPEC

  **Evidence:** [src-tlv75533pdbvr-ds-2026-11-11-p4: Section 5.1 table row Tstg](#src-tlv75533pdbvr-ds-2026-11-11-p4)
</EvidenceFact>

<EvidenceFact>
  <EvidenceAnchor id="fact-tlv75533pdbvr-reverse-current" />

  **Fact:** `fact-tlv75533pdbvr-reverse-current`

  **Value:** no allowed reverse current specified; VOUT must not exceed VIN + 0.3 V or 6.0 V, whichever is smaller · **Unit:** `NONE`

  **Conditions:** the datasheet gives no reverse current or duration that is allowed; it says the three reverse-current conditions the datasheet lists all exceed the absolute maximum rating of VOUT > VIN + 0.3 V and recommends external protection (Schottky OUT to IN, Figure 7-3) if reverse current is expected; any reverse-current acceptance value would be a project choice, not a manufacturer limit; the 'or 6.0 V, whichever is smaller' bound is footnote (2) of the Absolute Maximum Ratings table (src-tlv75533pdbvr-ds-2026-11-11-p4, same bytes)

  **Verdict:** PASS - primary-source confirmed · **Provenance:** PRIMARY-SPEC

  **Evidence:** [src-tlv75533pdbvr-ds-2026-11-11-p17: section 7.1.4 Reverse Current and Figure 7-3](#src-tlv75533pdbvr-ds-2026-11-11-p17)
</EvidenceFact>

### RECOMMENDED\_OPERATION

The range the manufacturer intends the part to be used in. Always narrower than the absolute maximum.

<EvidenceFact>
  <EvidenceAnchor id="fact-tlv75533pdbvr-roc-vin" />

  **Fact:** `fact-tlv75533pdbvr-roc-vin`

  **Value:** 1.45 to 5.5 · **Unit:** `V`

  **Conditions:** recommended input voltage VIN min 1.45 V, max 5.5 V; recommended VEN 0 to 5.5 V; read from the manufacturer-hosted datasheet bytes inspected 2026-11-08

  **Verdict:** PASS - primary-source confirmed · **Provenance:** PRIMARY-SPEC

  **Evidence:** [src-tlv75533pdbvr-ds-p4: Section 5.3 Recommended Operating Conditions table row VIN Input voltage](#src-tlv75533pdbvr-ds-p4)
</EvidenceFact>

<EvidenceFact>
  <EvidenceAnchor id="fact-tlv75533pdbvr-roc-iout" />

  **Fact:** `fact-tlv75533pdbvr-roc-iout`

  **Value:** 500 · **Unit:** `mA`

  **Conditions:** recommended output current IOUT max 500 mA (min 0); COUT 1 to 200 uF, CIN min 1 uF; TJ -40 to 125 degC; read from the manufacturer-hosted datasheet bytes inspected 2026-11-08

  **Verdict:** PASS - primary-source confirmed · **Provenance:** PRIMARY-SPEC

  **Evidence:** [src-tlv75533pdbvr-ds-p4: Section 5.3 Recommended Operating Conditions table row IOUT Output current](#src-tlv75533pdbvr-ds-p4)
</EvidenceFact>

<EvidenceFact>
  <EvidenceAnchor id="fact-tlv75533pdbvr-operating-temperature" />

  **Fact:** `fact-tlv75533pdbvr-operating-temperature`

  **Value:** -40 to +125 · **Unit:** `degC`

  **Conditions:** TJ junction temperature (recommended operating conditions); a junction, not an ambient, limit; absolute maximum operating TJ -40 to 150 degC; the same ROC TJ row is in the 2026-11-08 extract of src-tlv75533pdbvr-ds-p4; manufacturer data only; not a thermal qualification of the assembled module

  **Verdict:** PASS - primary-source confirmed · **Provenance:** PRIMARY-SPEC

  **Evidence:** [src-tlv75533pdbvr-ds-2026-11-11-p4: Section 5.3 table row TJ](#src-tlv75533pdbvr-ds-2026-11-11-p4)
</EvidenceFact>

<EvidenceFact>
  <EvidenceAnchor id="fact-tlv75533pdbvr-min-effective-capacitance" />

  **Fact:** `fact-tlv75533pdbvr-min-effective-capacitance`

  **Value:** 0.47 · **Unit:** `uF`

  **Conditions:** effective capacitance at the IN pin and at the OUT pin each greater than 0.47 µF (Table 4-1 footnote 1); the pin rows ask for 1 µF or larger and the datasheet assumes 50 % nominal derating; a design-margin check, not a measurement of the fitted parts

  **Verdict:** PASS - primary-source confirmed · **Provenance:** PRIMARY-SPEC

  **Evidence:** [src-tlv75533pdbvr-ds-2026-11-11-p3: Table 4-1 Pin Functions rows IN, OUT and footnote (1)](#src-tlv75533pdbvr-ds-2026-11-11-p3)
</EvidenceFact>

### GUARANTEED\_ELECTRICAL

A parameter the manufacturer guarantees over the stated conditions, usually with minimum, typical and maximum values.

<EvidenceFact>
  <EvidenceAnchor id="fact-tlv75533pdbvr-vout-nominal" />

  **Fact:** `fact-tlv75533pdbvr-vout-nominal`

  **Value:** 3.3 · **Unit:** `V`

  **Conditions:** nominal fixed output voltage decoded from Table 8-1 nomenclature: TLV755xx(x)P with xx=33 means 3.3 V (two digits for 100 mV resolution); tolerance is fact-tlv75533pdbvr-output-accuracy; read from the manufacturer-hosted datasheet bytes inspected 2026-11-08

  **Verdict:** PASS - primary-source confirmed · **Provenance:** PRIMARY-SPEC

  **Evidence:** [src-tlv75533pdbvr-ds-p23: Table 8-1 Device Nomenclature row TLV755xx(x)Pyyyz(M3)](#src-tlv75533pdbvr-ds-p23)
</EvidenceFact>

<EvidenceFact>
  <EvidenceAnchor id="fact-tlv75533pdbvr-output-accuracy" />

  **Fact:** `fact-tlv75533pdbvr-output-accuracy`

  **Value:** 1 · **Unit:** `%`

  **Conditions:** output accuracy -1 % to +1 % for -40 degC \<= TJ \<= 85 degC, DBV and DRV package (VIN=VOUT(NOM)+0.5V or 2.0V whichever greater, IOUT=1mA, CIN=COUT=1uF); -1.5 % to +1.5 % over TJ -40 to 125 degC for VOUT >= 1V; read from the manufacturer-hosted datasheet bytes inspected 2026-11-08

  **Verdict:** PASS - primary-source confirmed · **Provenance:** PRIMARY-SPEC

  **Evidence:** [src-tlv75533pdbvr-ds-p5: Section 5.5 Electrical Characteristics table row Output accuracy](#src-tlv75533pdbvr-ds-p5)
</EvidenceFact>

<EvidenceFact>
  <EvidenceAnchor id="fact-tlv75533pdbvr-current-limit" />

  **Fact:** `fact-tlv75533pdbvr-current-limit`

  **Value:** 560 · **Unit:** `mA`

  **Conditions:** output current limit ICL minimum 560 mA (typ 720 mA, max 865 mA) at VIN=VOUT+VDO(MAX)+0.25V, VOUT=0.9 x VOUT, 1.5V \< VOUT \<= 4.5V, TJ -40 to 125 degC; foldback: ISC typ 355 mA at VOUT=0V (typical only); read from the manufacturer-hosted datasheet bytes inspected 2026-11-08

  **Verdict:** PASS - primary-source confirmed · **Provenance:** PRIMARY-SPEC

  **Evidence:** [src-tlv75533pdbvr-ds-p5: Section 5.5 Electrical Characteristics table row ICL Output current limit](#src-tlv75533pdbvr-ds-p5)
</EvidenceFact>

### PROJECT\_STATE

A value this project recorded about how the part is used here — a chosen operating point, a net assignment, or a derived figure. Not a manufacturer specification.

<EvidenceFact>
  <EvidenceAnchor id="fact-tlv75533pdbvr-manufacturer" />

  **Fact:** `fact-tlv75533pdbvr-manufacturer`

  **Value:** Texas Instruments · **Unit:** `NONE`

  **Conditions:** manufacturer named on the manufacturer-hosted datasheet; printed as 'Texas Instruments Incorporated' (copyright footer) with the TEXAS INSTRUMENTS logo and www.ti.com header; read from the manufacturer-hosted datasheet bytes inspected 2026-11-08

  **Verdict:** PASS - primary-source confirmed · **Provenance:** PRIMARY-SPEC

  **Evidence:** [src-tlv75533pdbvr-ds-p3: page footer copyright line and title block header](#src-tlv75533pdbvr-ds-p3)
</EvidenceFact>

<EvidenceFact>
  <EvidenceAnchor id="fact-tlv75533pdbvr-distributor-identity" />

  **Fact:** `fact-tlv75533pdbvr-distributor-identity`

  **Value:** `lcsc`=C404027; `manufacturer`=Texas Instruments; `mpn`=TLV75533PDBVR; `variant`=SOT-23-5 · **Unit:** `NONE`

  **Conditions:** order-code identity only; not performance evidence

  **Verdict:** CONFIRMED - distributor identity only · **Provenance:** DISTRIBUTOR-IDENTITY

  **Evidence:** [src-tlv75533pdbvr-a5-jlcpcb-snapshot: product table rows code, model, brand, specification](#src-tlv75533pdbvr-a5-jlcpcb-snapshot)
</EvidenceFact>

<EvidenceFact>
  <EvidenceAnchor id="fact-tlv75533pdbvr-a5-placements" />

  **Fact:** `fact-tlv75533pdbvr-a5-placements`

  **Value:** controller/U3 x1 (1 unique placements, 1 fitted pieces per module) · **Unit:** `NONE`

  **Conditions:** historical A5 native netlists; declared by the manual inventory provider, not bound to a schematic; as-built placement unverified

  **Verdict:** NEEDS BENCH · **Provenance:** PROJECT-CHOICE

  **Evidence:** [src-tlv75533pdbvr-a5-netlist-controller: components section rows U3](#src-tlv75533pdbvr-a5-netlist-controller)
</EvidenceFact>

<EvidenceFact>
  <EvidenceAnchor id="fact-tlv75533pdbvr-pinout" />

  **Fact:** `fact-tlv75533pdbvr-pinout`

  **Value:** DBV (SOT-23-5): 1 IN; 2 GND; 3 EN; 4 NC (no internal connection); 5 OUT · **Unit:** `NONE`

  **Conditions:** matches project pin map by number and function (pin-map.json: 1 IN, 2 GND, 3 EN, 4 NC, 5 OUT); read from the manufacturer-hosted datasheet bytes inspected 2026-11-08

  **Verdict:** PASS - primary-source confirmed · **Provenance:** PRIMARY-SPEC

  **Evidence:** [src-tlv75533pdbvr-ds-p3: Figure 4-2 DBV Package and Table 4-1 Pin Functions, DBV column rows EN, GND, IN, NC, OUT](#src-tlv75533pdbvr-ds-p3)
</EvidenceFact>

<EvidenceFact>
  <EvidenceAnchor id="fact-tlv75533pdbvr-cad-state" />

  **Fact:** `fact-tlv75533pdbvr-cad-state`

  **Value:** A5 footprint LightBlock:DBV5 and symbol LightBlock:LDO are not configured as catalog CAD assets (cad.enabled=false); pin-asset check not performed · **Unit:** `NONE`

  **Conditions:** catalog CAD disabled for this batch; no footprint, model or receipt reviewed

  **Verdict:** UNSOURCED · **Provenance:** PROJECT-CHOICE

  **Evidence:** [src-tlv75533pdbvr-a5-netlist-controller: components section footprint field](#src-tlv75533pdbvr-a5-netlist-controller)
</EvidenceFact>

<EvidenceFact>
  <EvidenceAnchor id="fact-tlv75533pdbvr-orderable" />

  **Fact:** `fact-tlv75533pdbvr-orderable`

  **Value:** TLV75533PDBVR listed: Active, Production, SOT-23 (DBV) 5 pins, 3000 LARGE T\&R, -40 to 125 degC, marking 1FWF · **Unit:** `NONE`

  **Conditions:** exact orderable incl. package suffix DBV and reel suffix R appears in the Package Option Addendum; read from the manufacturer-hosted datasheet bytes inspected 2026-11-08

  **Verdict:** PASS - primary-source confirmed · **Provenance:** PRIMARY-SPEC

  **Evidence:** [src-tlv75533pdbvr-ds-p28: Package Option Addendum table row TLV75533PDBVR](#src-tlv75533pdbvr-ds-p28)
</EvidenceFact>

## Pin maps

The mapping between schematic pins and PCB pads, or physical terminals for an external part, as recorded. A record may carry more than one map when the same part is documented in more than one context.

### pinmap-tlv75533pdbvr

<EvidenceAnchor id="pinmap-tlv75533pdbvr" />

- **Symbol:** `LightBlock:LDO`
- **Footprint:** `LightBlock:DBV5`
- **Pins:** 5

<EvidenceDetails label="pin-assignments">
  <EvidenceTable label="pin-assignments">
    | Symbol pin | Name  | Footprint pad | Function                                                     |
    | ---------- | ----- | ------------- | ------------------------------------------------------------ |
    | `1`        | `IN`  | `1`           | power\_in; A5 nets: controller/U3=/+5V                       |
    | `2`        | `GND` | `2`           | power\_in; A5 nets: controller/U3=/GND                       |
    | `3`        | `EN`  | `3`           | input; A5 nets: controller/U3=/+5V                           |
    | `4`        | `NC`  | `4`           | no\_connect; A5 nets: controller/U3=unconnected-(U3-NC-Pad4) |
    | `5`        | `OUT` | `5`           | power\_out; A5 nets: controller/U3=/+3V3                     |
  </EvidenceTable>
</EvidenceDetails>

## Interactions

Behaviour that is not a property of this part alone. Each interaction names the records it spans, the conditions it holds under, and how far it has been confirmed. An interaction that spans several parts appears on every one of their pages, under the same identifier, because it is equally a fact about each.

No interaction is published for this record.

## Cross-component rules

Rules that span several parts at once and are published in full on the integration page. Each rule's verdict below is that rule's own — it is a statement about the cross-component question, not about this part — and the exact wording of what the rule refuses to conclude is published with the rule itself.

No cross-component rule names this record.

## Sources

Every document cited above, with its identification, when it was retrieved, and what kind of authority it carries. Sources that could not be retrieved are listed too, with their unavailability stated, so a gap in the evidence is visible rather than absent.

### JLCPCB public product listing C404027 (A5 retained product-props snapshot)

<EvidenceAnchor id="src-tlv75533pdbvr-a5-jlcpcb-snapshot" />

**Source ID:** `src-tlv75533pdbvr-a5-jlcpcb-snapshot` · **Authority:** DISTRIBUTOR\_IDENTITY

| Field | Recorded value |
| --- | --- |
| Document number | C404027 |
| Revision | A5 snapshot observed 2026-11-05T20:15:49.785944+00:00 |
| Document date | 2026-11-05 |
| Retrieved | 2026-11-05 |
| Printed page | n/a (JSON snapshot of an HTML page) |

**Locator:** engineering/a5/ic\_led\_evidence/C404027.snapshot.json, product table fields componentCode, componentModelEn, componentBrandEn, componentSpecificationEn

**Availability:** AVAILABLE

**Document URL:** no link is published for this source

### Light Block A5 controller native netlist (KiCad 10.0.8 export, historical)

<EvidenceAnchor id="src-tlv75533pdbvr-a5-netlist-controller" />

**Source ID:** `src-tlv75533pdbvr-a5-netlist-controller` · **Authority:** PROJECT\_GENERATOR

| Field | Recorded value |
| --- | --- |
| Document number | engineering/a5/integration/native\_schematic/controller/netlist.xml |
| Revision | A5 |
| Document date | 2026-11-06 |
| Retrieved | 2026-11-06 |
| Printed page | n/a (XML netlist) |

**Locator:** engineering/a5/integration/native\_schematic/controller/netlist.xml, components section rows for U3 and the matching nets section nodes

**Availability:** AVAILABLE

**Document URL:** [https://github.com/Takazudo/zudo-led-block/blob/d41cbb7fc61dc954b4affaf19527aa69f07013b6/engineering/a5/integration/native\_schematic/controller/netlist.xml](https://github.com/Takazudo/zudo-led-block/blob/d41cbb7fc61dc954b4affaf19527aa69f07013b6/engineering/a5/integration/native_schematic/controller/netlist.xml)

### TLV755P 500mA, Low-IQ, Small-Size, Low-Dropout Regulator datasheet

<EvidenceAnchor id="src-tlv75533pdbvr-ds-p3" />

**Source ID:** `src-tlv75533pdbvr-ds-p3` · **Authority:** MANUFACTURER\_PRIMARY

| Field | Recorded value |
| --- | --- |
| Document number | SBVS320D |
| Revision | Rev. D (NOVEMBER 2017 - REVISED SEPTEMBER 2024) |
| Document date | 2024-09 |
| Retrieved | 2026-11-08 |
| Printed page | 3 |

**Locator:** SBVS320D physical PDF page 3 of 51 (index 2), printed page 3: Section 4 Pin Configuration and Functions: Figure 4-2 DBV Package 5-Pin SOT-23 (Top View) and Table 4-1 Pin Functions, DBV column; page footer copyright line

**Availability:** AVAILABLE

**Document URL:** [https://www.ti.com/lit/ds/symlink/tlv755p.pdf](https://www.ti.com/lit/ds/symlink/tlv755p.pdf)

### TLV755P 500mA, Low-IQ, Small-Size, Low-Dropout Regulator datasheet

<EvidenceAnchor id="src-tlv75533pdbvr-ds-p4" />

**Source ID:** `src-tlv75533pdbvr-ds-p4` · **Authority:** MANUFACTURER\_PRIMARY

| Field | Recorded value |
| --- | --- |
| Document number | SBVS320D |
| Revision | Rev. D (NOVEMBER 2017 - REVISED SEPTEMBER 2024) |
| Document date | 2024-09 |
| Retrieved | 2026-11-08 |
| Printed page | 4 |

**Locator:** SBVS320D physical PDF page 4 of 51 (index 3), printed page 4: Section 5.1 Absolute Maximum Ratings table rows VIN, VEN, VOUT; Section 5.3 Recommended Operating Conditions table rows VIN, VEN, IOUT, CIN, COUT

**Availability:** AVAILABLE

**Document URL:** [https://www.ti.com/lit/ds/symlink/tlv755p.pdf](https://www.ti.com/lit/ds/symlink/tlv755p.pdf)

### TLV755P 500mA, Low-IQ, Small-Size, Low-Dropout Regulator datasheet

<EvidenceAnchor id="src-tlv75533pdbvr-ds-p5" />

**Source ID:** `src-tlv75533pdbvr-ds-p5` · **Authority:** MANUFACTURER\_PRIMARY

| Field | Recorded value |
| --- | --- |
| Document number | SBVS320D |
| Revision | Rev. D (NOVEMBER 2017 - REVISED SEPTEMBER 2024) |
| Document date | 2024-09 |
| Retrieved | 2026-11-08 |
| Printed page | 5 |

**Locator:** SBVS320D physical PDF page 5 of 51 (index 4), printed page 5: Section 5.5 Electrical Characteristics table rows Output accuracy and ICL Output current limit

**Availability:** AVAILABLE

**Document URL:** [https://www.ti.com/lit/ds/symlink/tlv755p.pdf](https://www.ti.com/lit/ds/symlink/tlv755p.pdf)

### TLV755P 500mA, Low-IQ, Small-Size, Low-Dropout Regulator datasheet

<EvidenceAnchor id="src-tlv75533pdbvr-ds-p23" />

**Source ID:** `src-tlv75533pdbvr-ds-p23` · **Authority:** MANUFACTURER\_PRIMARY

| Field | Recorded value |
| --- | --- |
| Document number | SBVS320D |
| Revision | Rev. D (NOVEMBER 2017 - REVISED SEPTEMBER 2024) |
| Document date | 2024-09 |
| Retrieved | 2026-11-08 |
| Printed page | 23 |

**Locator:** SBVS320D physical PDF page 23 of 51 (index 22), printed page 23: Section 8.1.1 Device Nomenclature, Table 8-1 Device Nomenclature row TLV755xx(x)Pyyyz(M3)

**Availability:** AVAILABLE

**Document URL:** [https://www.ti.com/lit/ds/symlink/tlv755p.pdf](https://www.ti.com/lit/ds/symlink/tlv755p.pdf)

### TLV755P 500mA, Low-IQ, Small-Size, Low-Dropout Regulator datasheet

<EvidenceAnchor id="src-tlv75533pdbvr-ds-p28" />

**Source ID:** `src-tlv75533pdbvr-ds-p28` · **Authority:** MANUFACTURER\_PRIMARY

| Field | Recorded value |
| --- | --- |
| Document number | SBVS320D |
| Revision | Rev. D (NOVEMBER 2017 - REVISED SEPTEMBER 2024) |
| Document date | 2024-09 |
| Retrieved | 2026-11-08 |
| Printed page | Addendum-Page 4 |

**Locator:** SBVS320D physical PDF page 28 of 51 (index 27), printed page Addendum-Page 4: Package Option Addendum (dated 22-Oct-2026 inside the document) orderable table row TLV75533PDBVR

**Availability:** AVAILABLE

**Document URL:** [https://www.ti.com/lit/ds/symlink/tlv755p.pdf](https://www.ti.com/lit/ds/symlink/tlv755p.pdf)

### TLV755P 500mA, Low-IQ, Small-Size, Low-Dropout Regulator datasheet

<EvidenceAnchor id="src-tlv75533pdbvr-ds-2026-11-11-p4" />

**Source ID:** `src-tlv75533pdbvr-ds-2026-11-11-p4` · **Authority:** MANUFACTURER\_PRIMARY

| Field | Recorded value |
| --- | --- |
| Document number | SBVS320D |
| Revision | Rev. D (NOVEMBER 2017 - REVISED SEPTEMBER 2024) |
| Document date | 2024-09 |
| Retrieved | 2026-11-11 |
| Printed page | 4 |

**Locator:** SBVS320D physical PDF page 4 of 51 (index 3), printed page 4: Section 5.1 Absolute Maximum Ratings table rows TJ and Tstg; Section 5.3 Recommended Operating Conditions table row TJ

**Availability:** AVAILABLE

**Document URL:** [https://www.ti.com/lit/ds/symlink/tlv755p.pdf](https://www.ti.com/lit/ds/symlink/tlv755p.pdf)

### TLV755P 500mA, Low-IQ, Small-Size, Low-Dropout Regulator datasheet

<EvidenceAnchor id="src-tlv75533pdbvr-ds-2026-11-11-p17" />

**Source ID:** `src-tlv75533pdbvr-ds-2026-11-11-p17` · **Authority:** MANUFACTURER\_PRIMARY

| Field | Recorded value |
| --- | --- |
| Document number | SBVS320D |
| Revision | Rev. D (NOVEMBER 2017 - REVISED SEPTEMBER 2024) |
| Document date | 2024-09 |
| Retrieved | 2026-11-11 |
| Printed page | 17 |

**Locator:** SBVS320D physical PDF page 17 of 51 (index 16), printed page 17 and continuation on printed page 18: Section 7.1.4 Reverse Current and Figure 7-3

**Availability:** AVAILABLE

**Document URL:** [https://www.ti.com/lit/ds/symlink/tlv755p.pdf](https://www.ti.com/lit/ds/symlink/tlv755p.pdf)

### TLV755P 500mA, Low-IQ, Small-Size, Low-Dropout Regulator datasheet

<EvidenceAnchor id="src-tlv75533pdbvr-ds-2026-11-11-p3" />

**Source ID:** `src-tlv75533pdbvr-ds-2026-11-11-p3` · **Authority:** MANUFACTURER\_PRIMARY

| Field | Recorded value |
| --- | --- |
| Document number | SBVS320D |
| Revision | Rev. D (NOVEMBER 2017 - REVISED SEPTEMBER 2024) |
| Document date | 2024-09 |
| Retrieved | 2026-11-11 |
| Printed page | 3 |

**Locator:** SBVS320D physical PDF page 3 of 51 (index 2), printed page 3: Section 4 Table 4-1 Pin Functions rows IN and OUT, and footnote (1)

**Availability:** AVAILABLE

**Document URL:** [https://www.ti.com/lit/ds/symlink/tlv755p.pdf](https://www.ti.com/lit/ds/symlink/tlv755p.pdf)

## Legend

What the recorded terms on this page mean, in ordinary words. The exact terms above are the ones that count; these descriptions explain them and never replace them.

### Verdict

| Recorded term | What it means |
| --- | --- |
| `CONFIRMED - distributor identity only` | A distributor listing confirms which part this is, and nothing more. It carries no electrical, thermal or lifetime authority. |
| `NEEDS BENCH` | Cannot be settled from documents. It needs measurement on real hardware before it can be relied on. |
| `PASS - primary-source confirmed` | Confirmed against the manufacturer's own document for this exact part. |
| `UNSOURCED` | No accepted source backs this value yet. Treat it as a claim, not a fact. |

### Provenance

| Recorded term | What it means |
| --- | --- |
| `DISTRIBUTOR-IDENTITY` | Taken from a distributor listing. Identity information only. |
| `PRIMARY-SPEC` | Taken from the manufacturer's own specification document. |
| `PROJECT-CHOICE` | A decision made by this project. No vendor asserts it. |

### Fact class

| Recorded term | What it means |
| --- | --- |
| `ABSOLUTE_MAXIMUM` | A never-exceed limit. Reaching it may damage the part; it is not an operating target and there is no margin implied by it. |
| `GUARANTEED_ELECTRICAL` | A parameter the manufacturer guarantees over the stated conditions, usually with minimum, typical and maximum values. |
| `PROJECT_STATE` | A value this project recorded about how the part is used here — a chosen operating point, a net assignment, or a derived figure. Not a manufacturer specification. |
| `RECOMMENDED_OPERATION` | The range the manufacturer intends the part to be used in. Always narrower than the absolute maximum. |

### Coverage status

| Recorded term | What it means |
| --- | --- |
| `COVERED` | Every question this domain asks is answered by the facts listed against it. |
| `OPEN` | Unresolved. Open means the question has not been answered, not that the part is unsafe — the reason states what is missing. |

### Source availability

| Recorded term | What it means |
| --- | --- |
| `AVAILABLE` | The document was retrieved and is on record. |

### Source authority

| Recorded term | What it means |
| --- | --- |
| `DISTRIBUTOR_IDENTITY` | A distributor listing. Establishes which part this is, nothing more. |
| `MANUFACTURER_PRIMARY` | The manufacturer's own document for this exact part. |
| `PROJECT_GENERATOR` | A document this project generated, such as a schematic or netlist export. |

### Identity state

| Recorded term | What it means |
| --- | --- |
| `VERIFIED` | The exact orderable part has been confirmed against a source. |

### Source state

| Recorded term | What it means |
| --- | --- |
| `AVAILABLE` | At least one document backing this line was retrieved. |

### Unit

| Recorded term | What it means |
| --- | --- |
| `NONE` | The value is not a physical quantity, so it carries no unit. Recorded as \`NONE\`. |

## Raw agent resource

This page is generated from a stored evidence bundle and does not restate it. The bundle is the source of truth: where the two ever disagree, the bundle is right and this page is stale.

[Open the owning bundle](/docs/claude-skills/component-tlv75533pdbvr/) `component-tlv75533pdbvr`
