Takazudo/zudo-led-block/doc/src/content/docs/components/records/tps2552dbvr-1/index.mdx

---
# GENERATED by @takazudo/zudo-circuit-doc — do not edit; run `zudo-circuit-doc generate`
title: "TPS2552DBVR-1"
description: "led supply current-limit latch switch — Texas Instruments — C140331 — controller U4 — rec-tps2552dbvr-1"
sidebar_position: 5
---

<EvidenceAnchor id="rec-tps2552dbvr-1" />

Generated from the component evidence records — edit the records, not this page.

Everything below is projected from this project's stored component evidence. Values keep the exact wording, conditions, units and verdicts they were recorded with — nothing here is re-typed, corrected, or combined into an overall judgement about the part.

This record in the catalog: [TPS2552DBVR-1](/docs/components/catalog/#rec-tps2552dbvr-1)

## Identity

| Field | Recorded value |
| --- | --- |
| Record ID | `rec-tps2552dbvr-1` |
| Record kind | standalone |
| Manufacturer part number | `TPS2552DBVR-1` |
| Manufacturer | Texas Instruments |
| Function | led supply current-limit latch switch |
| LCSC ID | `C140331` |
| Package | `SOT-23-6` |
| Inventory line | `line-tps2552dbvr-1` |
| Owner skill | `component-tps2552dbvr-1` |

**Fit:** Fitted

**Identity state:** VERIFIED

**Source state:** AVAILABLE

**Coverage:** 2 open of 5 published

## Documents and package

<EvidenceAnchor id="component-references-heading" />

<EvidenceAnchor id="component-references" />

[Datasheet PDF](https://www.ti.com/lit/ds/symlink/tps2552.pdf) — TPS255xx Precision Adjustable Current-Limited Power-Distribution Switches datasheet (TPS2552, TPS2552-1, TPS2553, TPS2553-1)

**Selected source ID:** `src-tps2552dbvr-1-ds-p3`

**Authority:** MANUFACTURER\_PRIMARY

**Availability:** AVAILABLE

No footprint or 3D model is published for this record: CAD is not enabled for this project.

## Placements

Every position this exact line occupies in the as-built design. One line may be placed many times and across more than one board.

| Board | Reference designator |
| --- | --- |
| controller | `U4` |

## Coverage

Coverage is stated one domain at a time and is never rolled up. A domain marked open is a question that has not been answered; it is not a finding that the part is unsuitable. A record with no open domains has not thereby been declared safe.

### identity

<EvidenceAnchor id="cov-tps2552dbvr-1-identity" />

**Coverage ID:** `cov-tps2552dbvr-1-identity` · **Status:** COVERED

**Reason:** manufacturer and exact orderable confirmed from the manufacturer-hosted datasheet (MANUFACTURER\_PRIMARY, bytes inspected 2026-11-08); distributor identity retained as order-code evidence

**Facts in this domain:**

- [`fact-tps2552dbvr-1-manufacturer`](#fact-tps2552dbvr-1-manufacturer)
- [`fact-tps2552dbvr-1-distributor-identity`](#fact-tps2552dbvr-1-distributor-identity)
- [`fact-tps2552dbvr-1-orderable`](#fact-tps2552dbvr-1-orderable)
- [`fact-tps2552dbvr-1-variant-latch`](#fact-tps2552dbvr-1-variant-latch)

### pinout

<EvidenceAnchor id="cov-tps2552dbvr-1-pinout" />

**Coverage ID:** `cov-tps2552dbvr-1-pinout` · **Status:** COVERED

**Reason:** datasheet pin table for the exact package inspected and compared with the project pin map: matches by number and function

**Facts in this domain:**

- [`fact-tps2552dbvr-1-pinout`](#fact-tps2552dbvr-1-pinout)
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
