Takazudo/zudo-led-block/engineering/a7/fixture/fixture-assembly.step

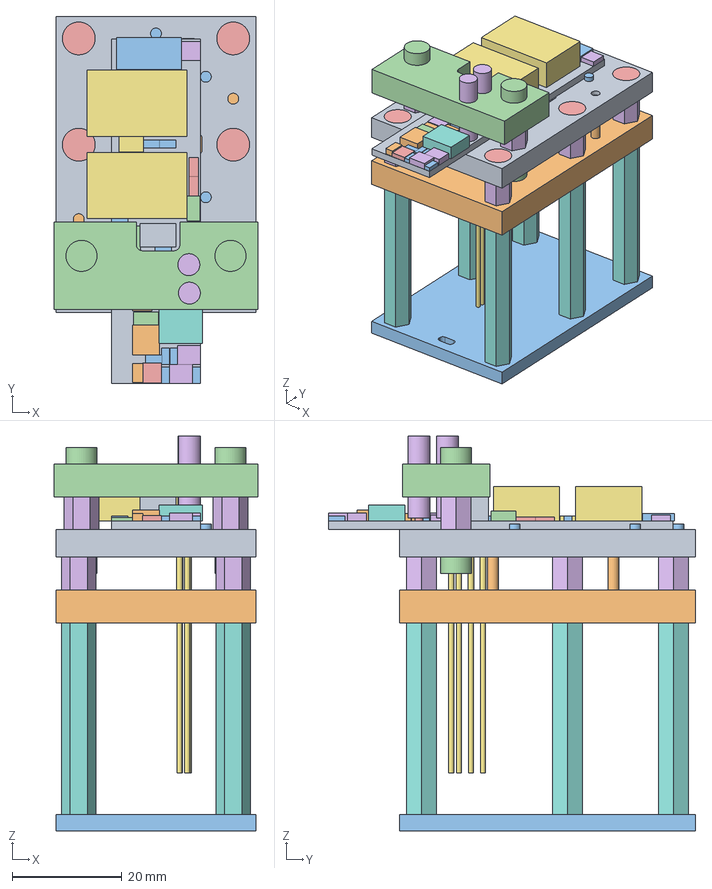
[picture p22: CAD file, 2026-11-12]
engineering/a7/fixture/fixture-assembly.step
37.2 x 67.0 x 72.1 mm
support_carrier
probe_plate
base_plate
pressure_plate
F1_M3x8_countersunk_screw
F1_M3_F-F_hex_spacer_6
F1_M3x12_stud
F1_M3_F-F_hex_standoff_35
F1_M3x8_countersunk_screw_base
F2_M3x8_countersunk_screw
F2_M3_F-F_hex_spacer_6
F2_M3x12_stud
F2_M3_F-F_hex_standoff_35
F2_M3x8_countersunk_screw_base
F3_M3x8_countersunk_screw
F3_M3_F-F_hex_spacer_6
F3_M3x12_stud
F3_M3_F-F_hex_standoff_35
F3_M3x8_countersunk_screw_base
F4_M3x8_countersunk_screw
F4_M3_F-F_hex_spacer_6
F4_M3x12_stud
F4_M3_F-F_hex_standoff_35
F4_M3x8_countersunk_screw_base
F5_M3x8_countersunk_screw
F5_M3_F-F_hex_spacer_6
F5_M3x12_stud
F5_M3_F-F_hex_standoff_35
F5_M3x8_countersunk_screw_base
F6_M3x8_countersunk_screw
F6_M3_F-F_hex_spacer_6
F6_M3x12_stud
F6_M3_F-F_hex_standoff_35
F6_M3x8_countersunk_screw_base
D1_dowel_2x16
D2_dowel_2x16
X1_datum_pin_2x6
X2_datum_pin_2x6
Y1_datum_pin_2x6
G1_M3x8_socket_head_screw
G1_M3_F-F_hex_standoff_6_stop
G1_M3x8_socket_head_screw_plate
G2_M3x8_socket_head_screw
G2_M3_F-F_hex_standoff_6_stop
G2_M3x8_socket_head_screw_plate
C1_K0318.04_POM_thrust_pin
C1_K0318.04_steel_sleeve
C2_K0318.04_POM_thrust_pin
C2_K0318.04_steel_sleeve
TP1_KS-050_receptacle
TP1_GKS-050_probe_compressed_envelope
TP2_KS-050_receptacle
TP2_GKS-050_probe_compressed_envelope
TP3_KS-050_receptacle
TP3_GKS-050_probe_compressed_envelope
TP4_KS-050_receptacle
TP4_GKS-050_probe_compressed_envelope
TP5_KS-050_receptacle
TP5_GKS-050_probe_compressed_envelope
controller_board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
