Takazudo/zudo-led-block/engineering/a7/mechanical/exports/3hp_pet/zudo_led_block_A7_3hp_pet_assembled.step

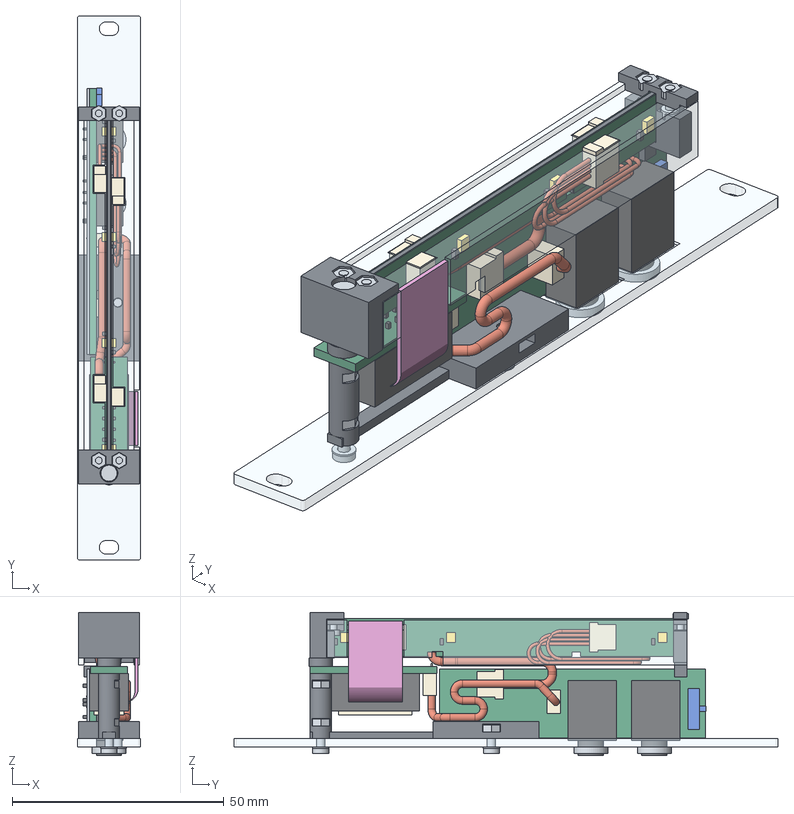
[picture p25: CAD file, 2026-11-12]
engineering/a7/mechanical/exports/3hp_pet/zudo_led_block_A7_3hp_pet_assembled.step
14.9 x 128.5 x 33.8 mm
front_pmma_A7
jack_in_PJ-324M
jack_in_solder_fillets
nut_in_M6x0.5
jack_thru_PJ-324M
jack_thru_solder_fillets
nut_thru_M6x0.5
controller_pcb_A7
solder_face_low_profile_zone
setting_switch_HX_MSK13C02
controller_PicoBlade_mated
controller_SH4_mated
spine_PETG
M2_front_washer_20.5
M2_front_screw_20.5
M2_nut_20.5
M2_front_washer_60.8
M2_front_screw_60.8
M2_nut_60.8
top_cap_screw_A7
M2_post_nut_top
power_adapter_pcb_A5
adapter_C5665_keyed_header
IDC_socket_REFERENCE_overlap6
adapter_PicoBlade_mated
IDC_ribbon_R3_side_exit_SCENARIO
left_leaf_film_PET
left_leaf_OCA
right_leaf_film_PET
right_leaf_OCA
leaf_carrier_PC
left_J1_SH4_mated
left_J2_SH4_mated
right_J1_SH4_mated
right_J2_SH4_unmated
left_D1
right_D1
left_C1
right_C1
left_D2
right_D2
left_C2
right_C2
left_D3
right_D3
left_C3
right_C3
left_D4
right_D4
left_C4
right_C4
top_cap_spacer_A7
top_leaf_adapter_cap
bottom_leaf_cap
bottom_cap_fork_A7
left_diffuser
right_diffuser
M1_6x4_-1_23.5
M1_6_nut_-1_23.5
M1_6x4_-1_105.5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
