Takazudo/zudo-led-block/engineering/a5/mechanical/exports/2hp/light_block_A5_2hp_assembled.step

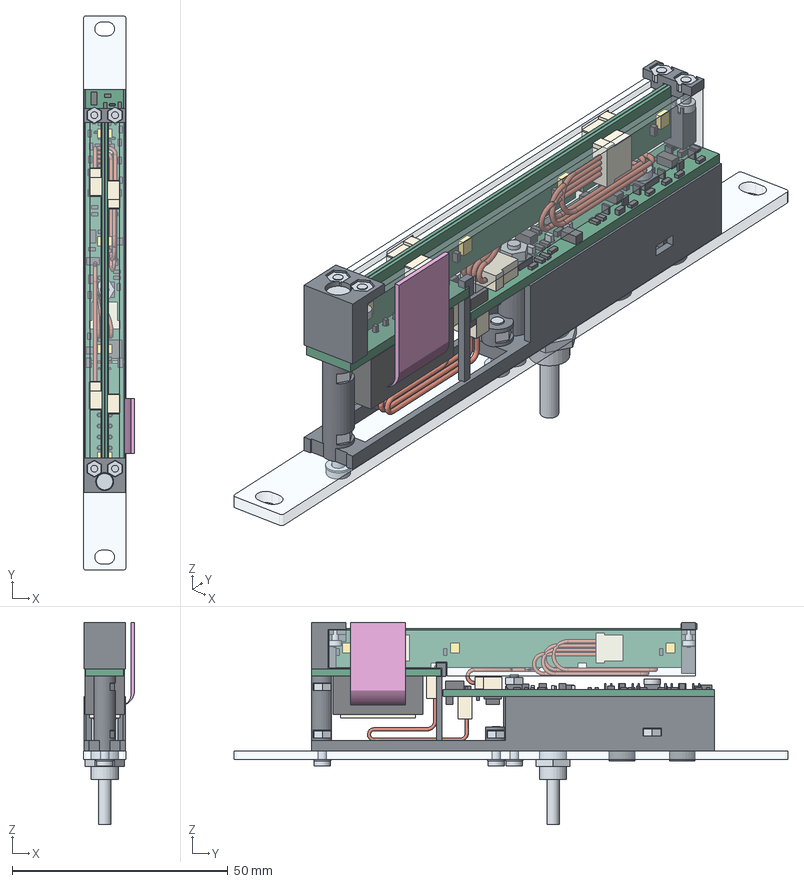
[picture p26: CAD file, 2026-11-06]
engineering/a5/mechanical/exports/2hp/light_block_A5_2hp_assembled.step
11.8 x 128.5 x 46.9 mm
front_acrylic_A4_unchanged
controller_pcb
power_adapter_pcb
left_leaf_pcb
right_leaf_pcb
leaf_bond_line_design_reserve
jack_90_PJ3582
jack_104_PJ3582
toggle_Dailywell_trimmed
toggle_front_nut
left_J1_SH4_mated
left_J2_SH4_mated
right_J1_SH4_mated
right_J2_SH4_unmated
controller_J3_SH4_mated
adapter_PicoBlade_mated
controller_PicoBlade_mated
adapter_C5665_keyed_header_trimmed
IDC_socket_REFERENCE_overlap6
controller_U1
controller_U2
controller_U3
controller_U4
controller_U5
controller_U6
controller_U7
controller_Q1
controller_D1
controller_D2
controller_D3
controller_L1
controller_R1
controller_R2
controller_R3
controller_R4
controller_R5
controller_R6
controller_R7
controller_R8
controller_R9
controller_R10
controller_R11
controller_R12
controller_R13
controller_R14
controller_R15
controller_R16
controller_R17
controller_R18
controller_R19
controller_R20
controller_R21
controller_R22
controller_R23
controller_R24
controller_R25
controller_C1
controller_C2
controller_C3
controller_C4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
