Takazudo/zudo-led-block/engineering/a5/front_panel/comparison_A3_holes/exports/front_A4_2hp_2mm.step

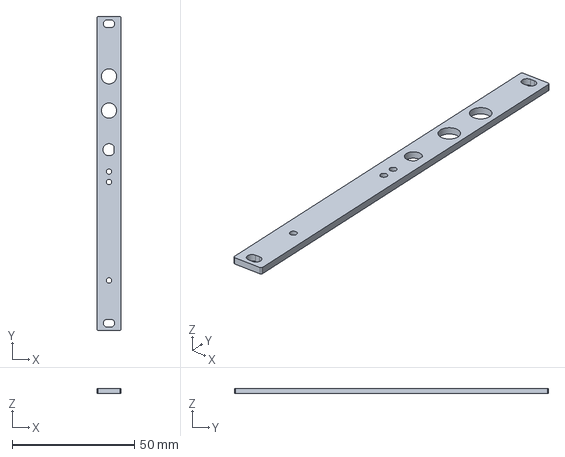
[picture p28: CAD file, 2026-11-06]
engineering/a5/front_panel/comparison_A3_holes/exports/front_A4_2hp_2mm.step
9.80 x 128.5 x 2.00 mm
