Takazudo/zudo-led-block/engineering/a5/front_panel/comparison_A3_holes/reference_A3/front_A3_3hp_CUT.dxf

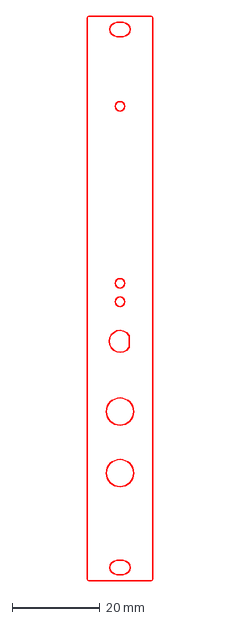
[picture p29: CAD file, 2026-11-06]
engineering/a5/front_panel/comparison_A3_holes/reference_A3/front_A3_3hp_CUT.dxf
14.9 x 128.5 mm
