Takazudo/zudo-led-block/engineering/a5/front_panel/reference_A3/front_A3_3hp_2mm.step

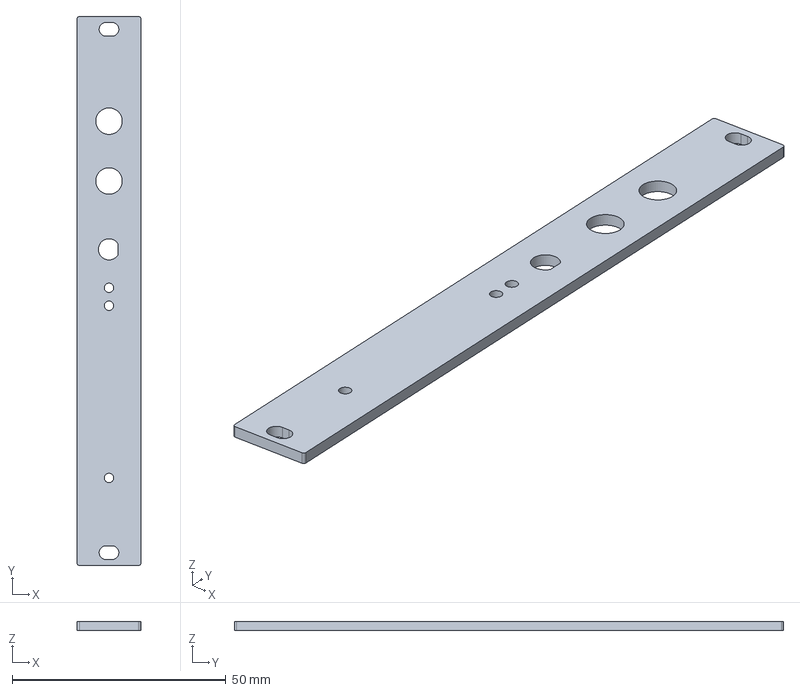
[picture p30: CAD file, 2026-11-06]
engineering/a5/front_panel/reference_A3/front_A3_3hp_2mm.step
14.9 x 128.5 x 2.00 mm
