Takazudo/zudo-led-block/engineering/a5/mechanical/exports/2hp/printable/controller_upper_clamp.step

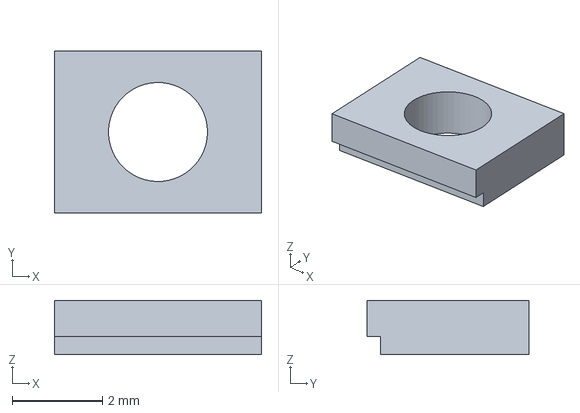
[picture p32: CAD file, 2026-11-06]
engineering/a5/mechanical/exports/2hp/printable/controller_upper_clamp.step
4.60 x 3.60 x 1.20 mm
