Takazudo/zudo-led-block/engineering/a5/mechanical/exports/3hp/light_block_A5_3hp_PLA_fit_check_r01.3mf

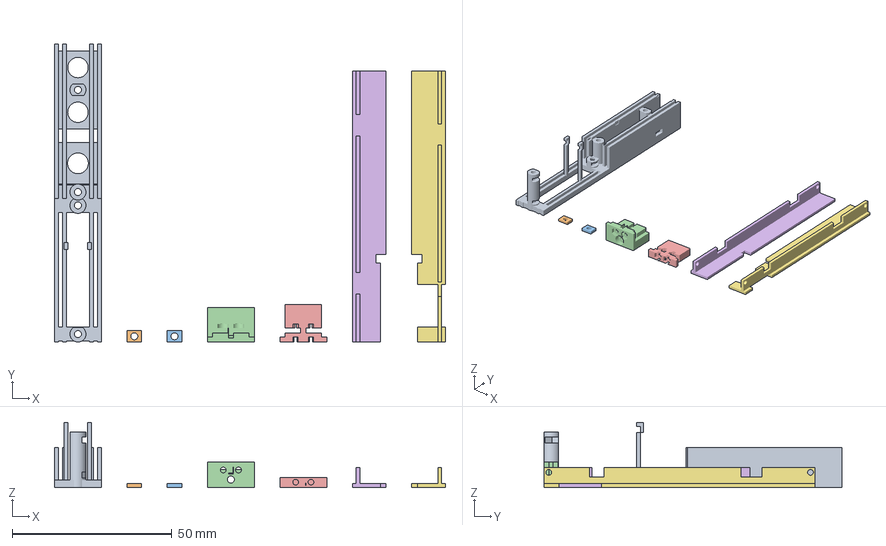
[picture p33: CAD file, 2026-11-06]
engineering/a5/mechanical/exports/3hp/light_block_A5_3hp_PLA_fit_check_r01.3mf
122.5 x 93.4 x 20.4 mm
3hp_front_cradle
3hp_controller_upper_clamp
3hp_controller_lower_clamp
3hp_top_leaf_adapter_cap
3hp_bottom_leaf_cap
3hp_left_diffuser
3hp_right_diffuser
