Takazudo/zudo-led-block/engineering/a5/mechanical/exports/3hp/printable/front_cradle.step

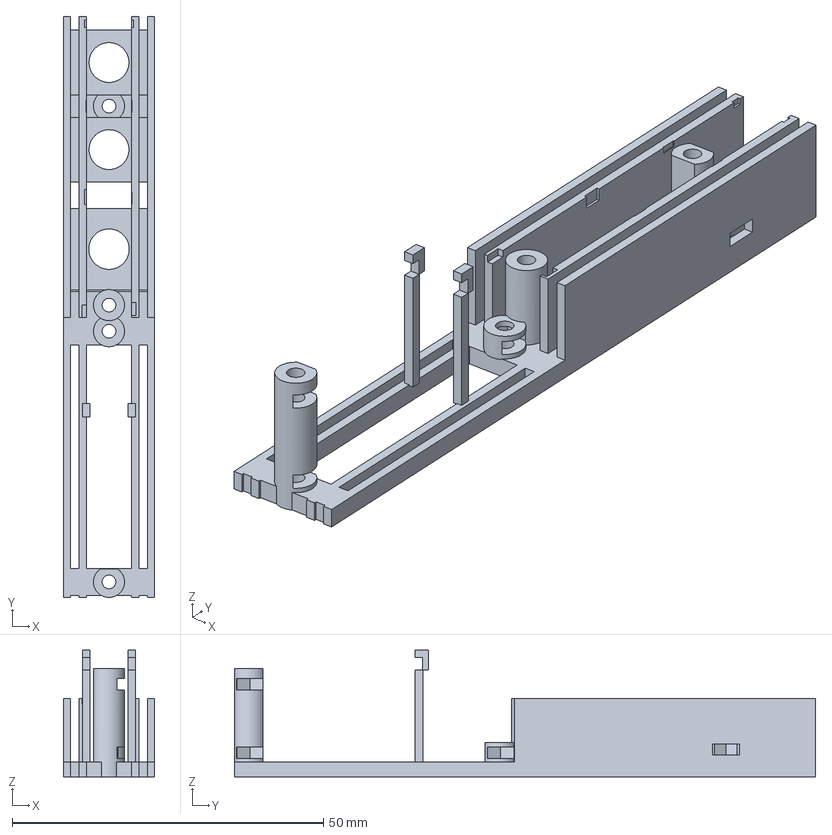
[picture p34: CAD file, 2026-11-06]
engineering/a5/mechanical/exports/3hp/printable/front_cradle.step
14.7 x 93.4 x 20.4 mm
