Takazudo/zudo-led-block/engineering/a5/mechanical/exports/2hp/printable/left_diffuser.step

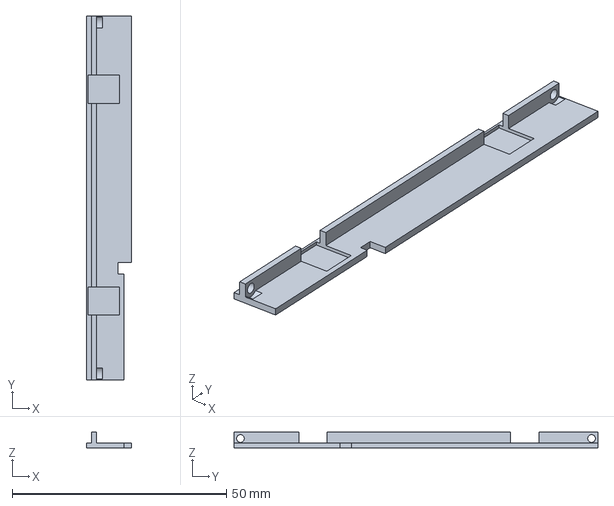
[picture p36: CAD file, 2026-11-06]
engineering/a5/mechanical/exports/2hp/printable/left_diffuser.step
10.6 x 85.0 x 3.70 mm
