Takazudo/zudo-led-block/engineering/a5/front_panel/exports/front_A4_2hp_CUT.dxf

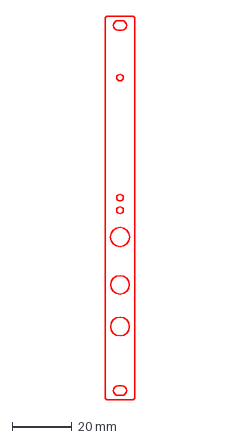
[picture p39: CAD file, 2026-11-06]
engineering/a5/front_panel/exports/front_A4_2hp_CUT.dxf
9.80 x 128.5 mm
