Takazudo/zudo-led-block/engineering/a5/mechanical/exports/2hp/light_block_A5_2hp_PLA_fit_check_r01.3mf

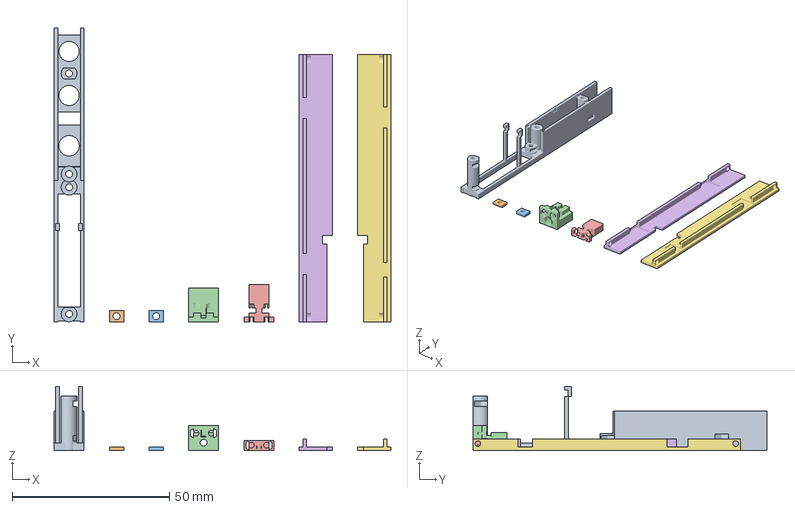
[picture p40: CAD file, 2026-11-06]
engineering/a5/mechanical/exports/2hp/light_block_A5_2hp_PLA_fit_check_r01.3mf
107.2 x 93.4 x 20.4 mm
2hp_front_cradle
2hp_controller_upper_clamp
2hp_controller_lower_clamp
2hp_top_leaf_adapter_cap
2hp_bottom_leaf_cap
2hp_left_diffuser
2hp_right_diffuser
