Takazudo/zudo-led-block/engineering/a5/mechanical/exports/2hp/printable/front_cradle.step

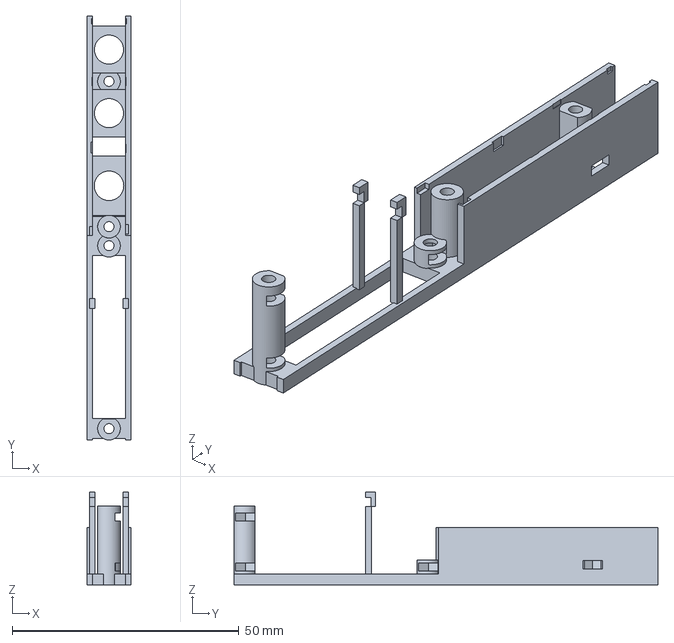
[picture p41: CAD file, 2026-11-06]
engineering/a5/mechanical/exports/2hp/printable/front_cradle.step
9.60 x 93.4 x 20.4 mm
