Takazudo/zudo-led-block/engineering/a5/mechanical/exports/3hp/printable/left_diffuser.step

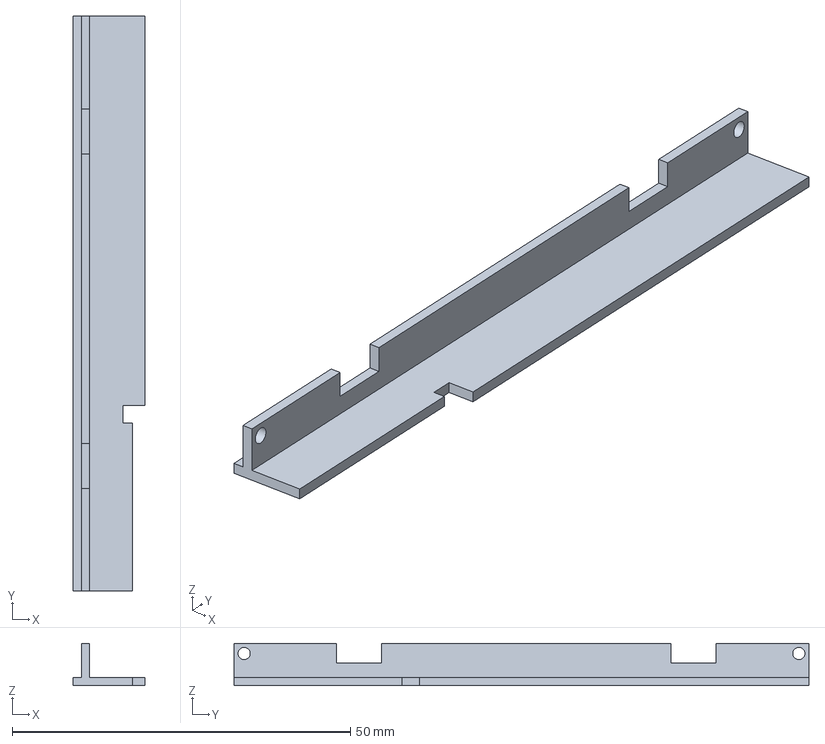
[picture p42: CAD file, 2026-11-06]
engineering/a5/mechanical/exports/3hp/printable/left_diffuser.step
10.6 x 85.0 x 6.25 mm
