Takazudo/zudo-led-block/engineering/a7/front_panel/exports/front_A7_2hp_CUT.dxf

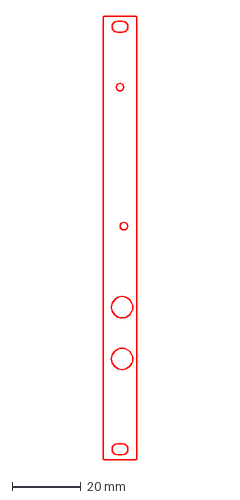
[picture p43: CAD file, 2026-11-12]
engineering/a7/front_panel/exports/front_A7_2hp_CUT.dxf
9.80 x 128.5 mm
