Takazudo/zudo-led-block/engineering/a5/front_panel/exports/front_A4_3hp_CUT.dxf

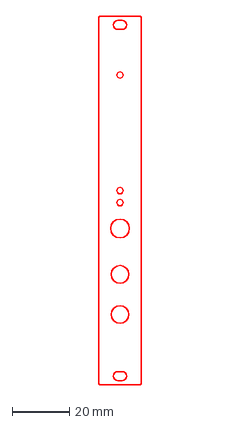
[picture p44: CAD file, 2026-11-06]
engineering/a5/front_panel/exports/front_A4_3hp_CUT.dxf
14.9 x 128.5 mm
