Takazudo/zudo-led-block/engineering/a5/mechanical/exports/2hp/printable/bottom_leaf_cap.step

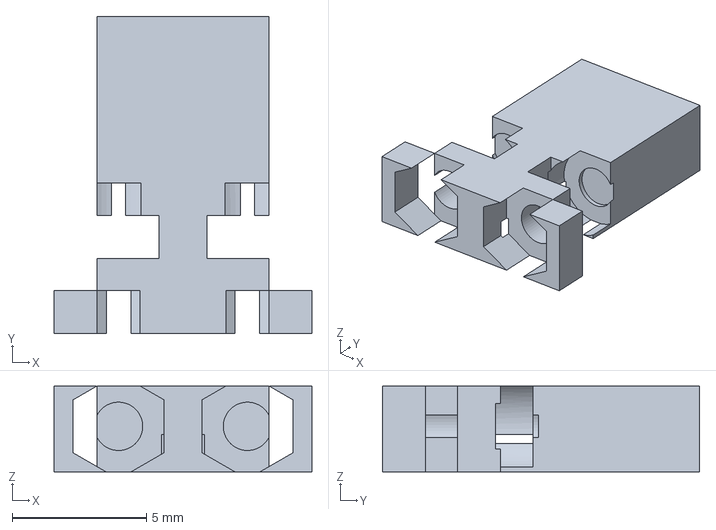
[picture p45: CAD file, 2026-11-06]
engineering/a5/mechanical/exports/2hp/printable/bottom_leaf_cap.step
9.60 x 11.8 x 3.20 mm
