Takazudo/zudo-led-block/engineering/a5/mechanical/exports/3hp/printable/top_leaf_adapter_cap.step

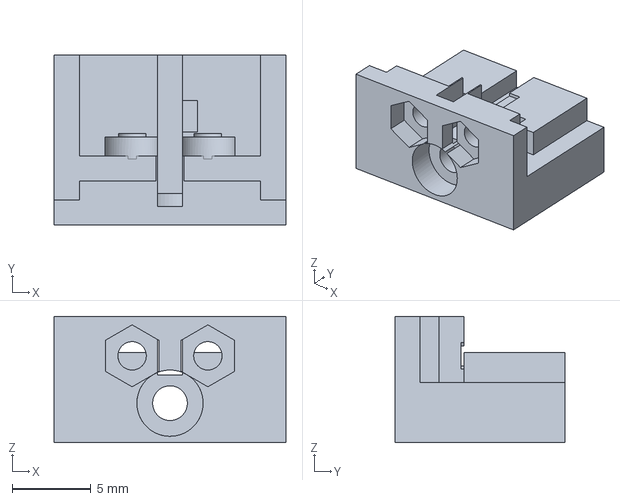
[picture p46: CAD file, 2026-11-06]
engineering/a5/mechanical/exports/3hp/printable/top_leaf_adapter_cap.step
14.7 x 10.8 x 8.00 mm
