Takazudo/zudo-led-block/engineering/a5/mechanical/exports/3hp/printable/controller_lower_clamp.step

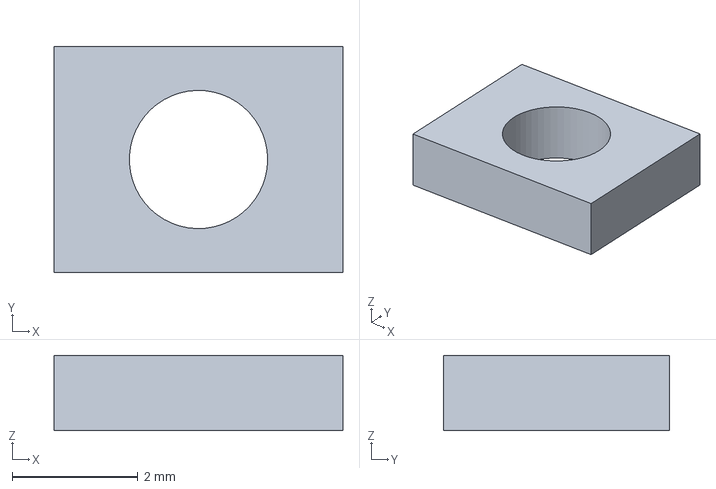
[picture p48: CAD file, 2026-11-06]
engineering/a5/mechanical/exports/3hp/printable/controller_lower_clamp.step
4.60 x 3.60 x 1.20 mm
