Takazudo/zudo-led-block/engineering/a7/front_panel/exports/front_A7_2hp_2mm.step

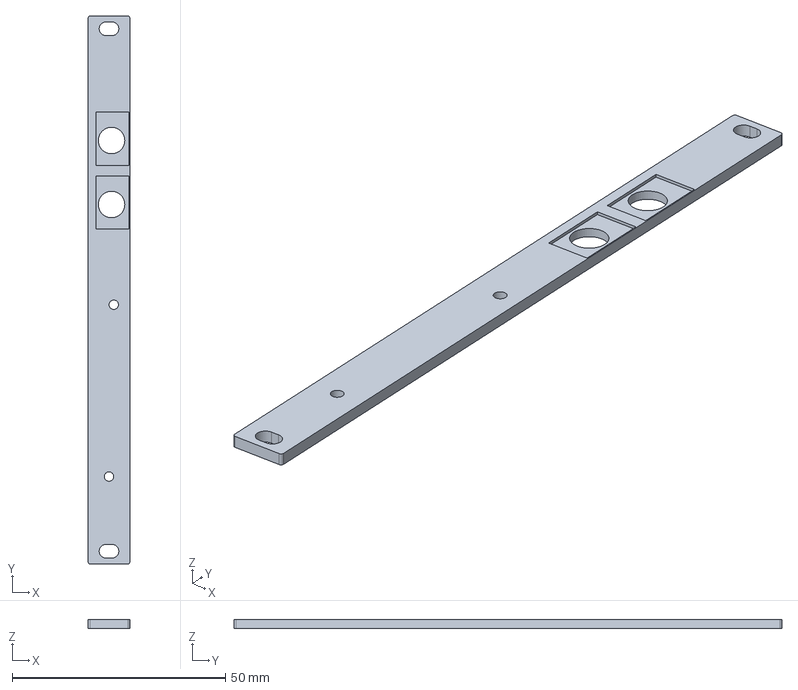
[picture p49: CAD file, 2026-11-12]
engineering/a7/front_panel/exports/front_A7_2hp_2mm.step
9.80 x 128.5 x 2.00 mm
