Takazudo/zudo-led-block/engineering/a7/front_panel/exports/front_A7_3hp_CUT.dxf

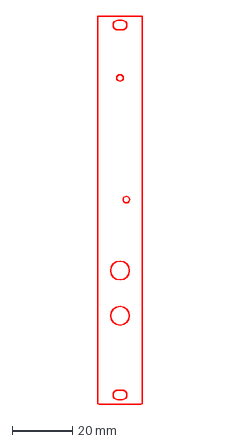
[picture p50: CAD file, 2026-11-12]
engineering/a7/front_panel/exports/front_A7_3hp_CUT.dxf
14.9 x 128.5 mm
