Takazudo/zudo-led-block/engineering/a5/mechanical/exports/2hp/printable/top_leaf_adapter_cap.step

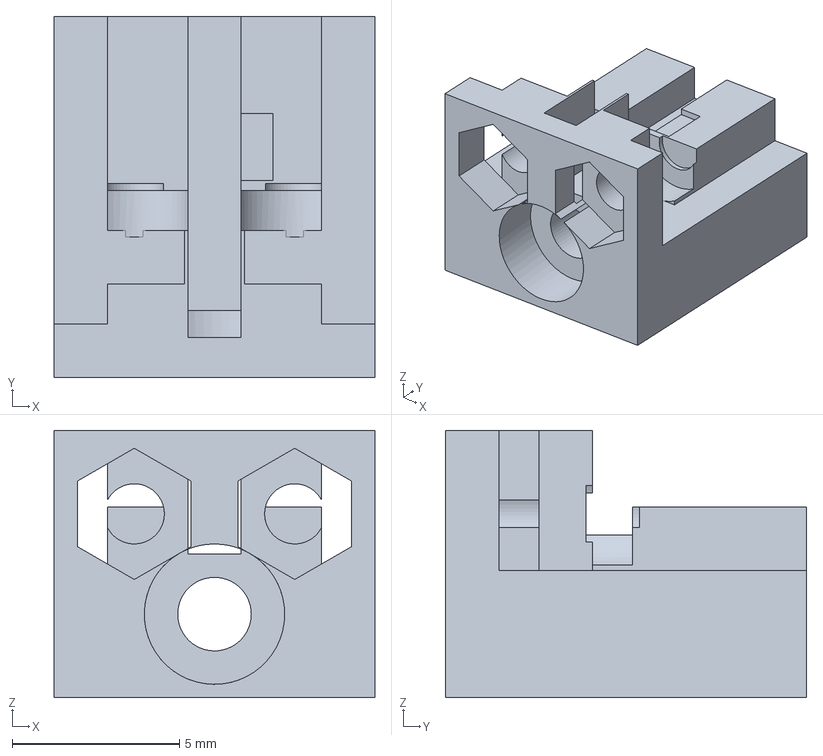
[picture p51: CAD file, 2026-11-06]
engineering/a5/mechanical/exports/2hp/printable/top_leaf_adapter_cap.step
9.60 x 10.8 x 8.00 mm
