Takazudo/zudo-led-block/engineering/a5/mechanical/exports/3hp/printable/bottom_leaf_cap.step

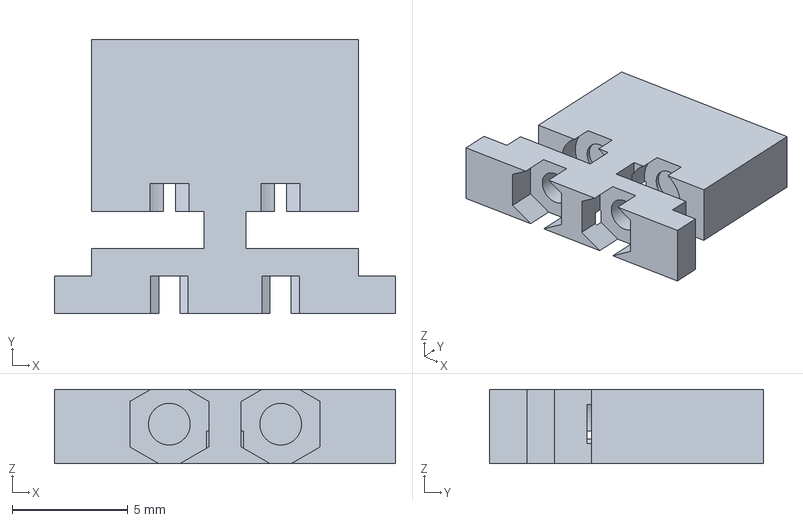
[picture p52: CAD file, 2026-11-06]
engineering/a5/mechanical/exports/3hp/printable/bottom_leaf_cap.step
14.7 x 11.8 x 3.20 mm
