Takazudo/zudo-led-block/(list of files, cad)

Other CAD files:
engineering/a5/front_panel/exports/rear_A4_2hp_REAR_FULL_FROST_CLEAR_LETTERS.dxf
engineering/a7/front_panel/exports/rear_A7_3hp_REAR_FULL_FROST_CLEAR_LETTERS.dxf
engineering/a5/front_panel/comparison_A3_holes/exports/rear_A4_2hp_REAR_FULL_FROST_CLEAR_LETTERS.dxf
engineering/a5/front_panel/exports/rear_A4_3hp_REAR_FULL_FROST_CLEAR_LETTERS.dxf
engineering/a5/front_panel/comparison_A3_holes/exports/rear_A4_3hp_REAR_FULL_FROST_CLEAR_LETTERS.dxf
engineering/a7/front_panel/exports/rear_A7_2hp_REAR_FULL_FROST_CLEAR_LETTERS.dxf
engineering/a5/mechanical/print_packaging/assets/h2d-empty.3mf
engineering/a7/front_panel/exports/front_A7_3hp_2mm.step
engineering/a5/front_panel/exports/front_A4_3hp_2mm.step
engineering/a5/front_panel/exports/front_A4_2hp_2mm.step
engineering/a5/mechanical/exports/2hp/printable/controller_lower_clamp.step
engineering/a5/mechanical/exports/3hp/printable/controller_upper_clamp.step
engineering/a5/mechanical/exports/2hp/printable/bottom_leaf_cap.stl
engineering/a5/mechanical/exports/2hp/printable/controller_lower_clamp.stl
engineering/a5/mechanical/exports/2hp/printable/controller_upper_clamp.stl
engineering/a5/mechanical/exports/2hp/printable/front_cradle.stl
engineering/a5/mechanical/exports/2hp/printable/left_diffuser.stl
engineering/a5/mechanical/exports/2hp/printable/right_diffuser.stl
engineering/a5/mechanical/exports/2hp/printable/top_leaf_adapter_cap.stl
engineering/a5/mechanical/exports/3hp/printable/bottom_leaf_cap.stl
engineering/a5/mechanical/exports/3hp/printable/controller_lower_clamp.stl
engineering/a5/mechanical/exports/3hp/printable/controller_upper_clamp.stl
engineering/a5/mechanical/exports/3hp/printable/front_cradle.stl
engineering/a5/mechanical/exports/3hp/printable/left_diffuser.stl
engineering/a5/mechanical/exports/3hp/printable/right_diffuser.stl
engineering/a5/mechanical/exports/3hp/printable/top_leaf_adapter_cap.stl
