Takazudo/zudo-led-block/engineering/a5/mechanical/exports/2hp/light_block_A5_2hp_assembled.png

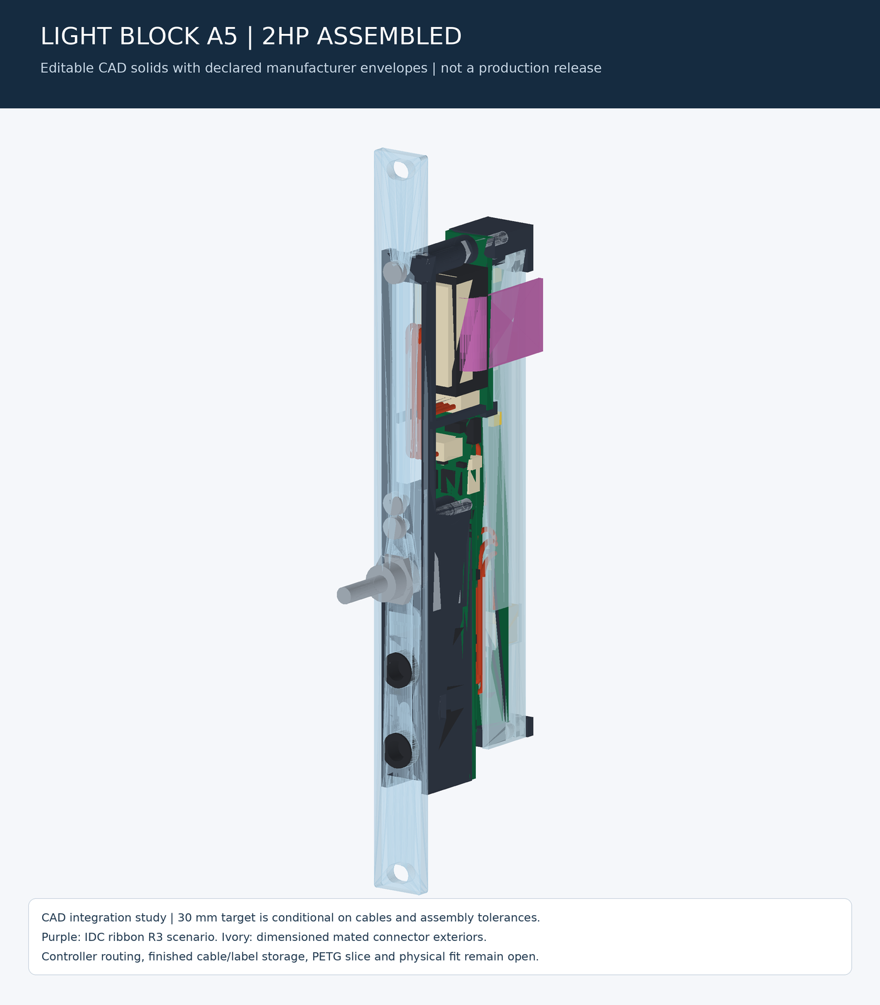
engineering/a5/mechanical/exports/2hp/light_block_A5_2hp_assembled.png
