Takazudo/zudo-led-block/doc/src/content/docs/verification/historical-records.mdx

---
# GENERATED by scripts/a5_site.py from engineering/a5/ — do not edit; run `pnpm a5:generate`
title: "履歴上の検証記録 (A5)"
description: "A5 作成時に記録された ERC/DRC・ネットリスト照合・FW 試験の結果。CI の結果とは区別して表示。"
sidebar_position: 3
---

:::note[これは履歴上の記録です]
以下は A5 パッケージ作成時 (2026-11-06T06:46:04 UTC) に記録された結果で、このリポジトリでは KiCad を再実行していません。CI は入力ファイルの同一性 (SHA-256) を確認し、再実行できる確認 (ネットリスト照合・調達表の再計算・FW の試験とビルド) だけを新たに実行します。
:::

## ネイティブ回路 (ERC)

| 基板 | KiCad | ERC エラー | ERC 警告 | 既定で除外されたカテゴリ |
| --- | --- | ---: | ---: | --- |
| `controller` | 10.0.8 | 0 | 0 | single\_global\_label, four\_way\_junction, simulation\_model\_issue, footprint\_filter |
| `led\_leaf` | 10.0.8 | 0 | 0 | single\_global\_label, four\_way\_junction, simulation\_model\_issue, footprint\_filter |
| `power\_adapter` | 10.0.8 | 0 | 0 | single\_global\_label, four\_way\_junction, simulation\_model\_issue, footprint\_filter |

## ネイティブ基板 (DRC)

| 基板 | 違反 | 未接続 | 状態 | PCB SHA-256 | 記録 |
| --- | ---: | ---: | --- | --- | --- |
| `controller` | 2 | 130 | UNROUTED\_CONTROLLER | `b5fff82b709c…` | [`electronics/reports/controller_drc.json`](https://github.com/Takazudo/zudo-led-block/blob/main/engineering/a5/electronics/reports/controller_drc.json) |
| `led\_leaf` | 0 | 0 | NATIVE\_DRC\_PASS | `6244280cec3e…` | [`electronics/reports/led_leaf_drc.json`](https://github.com/Takazudo/zudo-led-block/blob/main/engineering/a5/electronics/reports/led_leaf_drc.json) |
| `power\_adapter` | 0 | 0 | NATIVE\_DRC\_PASS | `b0f071f2730a…` | [`electronics/reports/power_adapter_drc.json`](https://github.com/Takazudo/zudo-led-block/blob/main/engineering/a5/electronics/reports/power_adapter_drc.json) |

制御基板の 2 件の違反は J3 と C7、J3 と H1 のコートヤード重なりです。

## ネットリスト照合

記録: 42 項目 PASS ([`integration/schematic_interface_check.json`](https://github.com/Takazudo/zudo-led-block/blob/main/engineering/a5/integration/schematic_interface_check.json))。CI はこの照合スクリプトを一時出力先で再実行し、結果が履歴記録と一致することを確認します。

## 独立レビュー

Final bridge electrical topology verified; current mechanical cable routes rejected; harness routing and hardware qualification remain open。未解決: `CV-02`, `POWER-01`, `RESET-01`, `BRIDGE-02`。

## ファームウェア

| 項目 | 記録された結果 |
| --- | --- |
| コンパイラ | `arm-none-eabi-gcc (15:13.2.rel1-2) 13.2.1 20231009` |
| ホスト試験 | PASS — 7 スイート, 987,189 アサーション |
| ASan / UBSan | PASS / PASS |
| LeakSanitizer | NOT RUN: explicit container/process-inspection limitation |
| クロック許容差の掃引 | -30,000〜30,000 ppm, 60,001 点 |
| ARM コンパイル / リンク | PASS, 未解決シンボル 0 |
| 割込みベクタ | NMI\_Handler#2, HardFault\_Handler#3, SysTick\_Handler#15, EXTI4\_15\_IRQHandler#23, DMA1\_Channel1\_IRQHandler#25 |
| 書込み / 実機試験 | 未実施 |

## 機構

129 valid modeled solids and seven connected printable parts per width; assembled/exploded STEP readback passed. No unresolved retained-part collisions. Each variant has16 declared conditional cable findings and no installed-fit PASS. Rear29.8mm is a modeled bound; 2HP IDC R3 scenario extends2.0mm beyond width; 3HP width margin0.55mm.
