Takazudo/zudo-led-block/engineering/a5/history_A4_1/README_JA.md

# Light Block A4.1

更新日: 2026-11-06 JST

中断したA4ソースを復元し、前面加工データの独立検証、JLC在庫・価格の更新、インダクタの低価格品への再選定を行いました。主BOMは **29型番・76点/台**。前面の形状・意匠はA4から変更していません。

**この版は前面加工データと部品選定の成果物です。** 完成機構、KiCad実配線、ERC/DRC、製造BOM/CPL、動作FW、ケーブルを含む30 mmの収まりは未完成です。前面単体のSTEPをモジュール全体の製造リリースと扱わないでください。

## 継続する仕様

- 2HP第一候補、3HP代替。高さ128.5 mm、幅9.8 / 14.9 mm、前面厚2 mm。
- パネル裏から30 mmを目標に、相手コネクタとケーブルの曲げまで含める。
- 交換できる半透明PETG側板。隣のKumikoの層間へ横から光を入れる。
- ON / PROGRAM / CVの3モード。INとOUTは受動THRU直結、CV検出は別枝。
- 左右4個、合計8個の個別制御RGB LED。片面実装の同一0.6 mm FR-4板2枚を背中合わせにする。
- 基板はJLCで実装し、自宅でははんだ付けしない。工場の手はんだは許容。完成ケーブルを別手配して差し込む。
- 光学専用PCBの先行発注はしない。完成した統合試作機でPETG厚さ・造形条件・光・温度を評価する。

## 透明文字と全面フロスト

透明キャストPMMAの裏面を、文字線以外フロスト彫刻します。Oなどの文字内部もフロスト、文字線は透明です。正面は平滑な原面のままです。ElecrowにはTransparent (000)、2 mmを希望し、材種と仕上げは個別見積りで確認します。最初からマットな板では透明な文字を作れません。[1,2]

「全面」は正面から見える面を指します。締結部品の下に隠れる小さな座面、合計約47.66 mm²/板だけは透明のままです。広い透明な外縁やジャック周囲の透明な輪は設けません。

主データは `front_panel/exports/` です。

| ファイル | 用途 |
|---|---|
| `front_A4_2hp_CUT.svg/.dxf` と3HP版 | 切断。トグルØ6.50、ジャックØ6.20 mm |
| `rear_A4_2hp_REAR_FULL_FROST_CLEAR_LETTERS.svg/.dxf` と3HP版 | 裏面彫刻。既に鏡像化済み。黒部分を彫る |
| `front_A4_2hp_2mm.step` と3HP版 | 前面板単体STEP |
| `A4_full_frost_clear_letters_summary.png` | 透明・フロスト領域の説明図。光学予測画像ではない |

独立検証で29ファイルのハッシュ、STEP寸法、8開口、SVG/DXFの登録位置と鏡像、5個の文字内部、透明文字と外周を確認しました。前面の修正は不要でした。`front_panel/comparison_A3_holes/` は過去の比較資料です。

## JLC実装を前提とした調達

全29型番の公開ページを **2026-11-06 11:30〜11:37 JST** に確認しました。各行の型番、C番号、個数、In Stock、Available Order Qty、USD価格帯、日時、一次URLは `procurement_rows.json` と表計算にあります。Available Order Qtyは先行購入欄であり、PCBA全体の確定割当とは区別します。在庫は予約していません。

| 主な役割 | 型番 / JLC番号 | 個/台 | 在庫 | 先行購入欄 |
|---|---|---:|---:|---:|
| MCU | STM32G031G8U6TR / C5270180 | 1 | 4,522 | 3,751 |
| RGB LED | WS2812B-2020-V6 / C52917434 | 8 | 768,169 | 747,432 |
| 降圧 | AP63205WU-7 / C2071056 | 1 | 20,569 | 17,967 |
| LED電源ラッチ | TPS2552DBVR-1 / C140331 | 1 | 2,336 | 2,329 |
| インダクタ | SPM4020T-4R7M-LR / C694586 | 1 | 726 | 719 |
| モードスイッチ | 1MS3T1B1M2QES-5 / C908270 | 1 | 1,134 | 987 |
| ジャック | PJ-3582-B / C500090 | 2 | 2,891 | 2,862 |
| LEDヘッダ | SM04B-SRSS-TB(LF)(SN) / C160404 | 4 | 57,403 | 50,854 |
| 電源ヘッダ | Molex530470310 / C122442 | 2 | 22,487 | 21,850 |
| IDC10 | BOOMELE2.54-2*5P / C5665 | 1 | 143,499 | 136,782 |

全型番の在庫と先行購入欄は、比較用100台の実装必要数を上回ります。100台は発注数量ではありません。余剰、最低購入数、別PCBへの数量分割、最終実装審査は別途必要です。

LEDのC52917434は **Standard Only**。FR-4へ変更してもEconomic対象にはなりません。StandardではBasicにもフィーダー費がかかります。抵抗・コンデンサ13型番はBasicに統一し、型番数と実装面数を減らします。Wave Soldering表記の部品はJLC FAQ上では工場の手はんだ対象です。[3,4,5]

## インダクタの低価格化

A4のWürth74437324047を **TDK SPM4020T-4R7M-LR / C694586** へ変更しました。メーカー現行品、4.7 µH±20%、最大高さ2.0 mm、最大外形4.6×4.3×2.0 mmです。LRの付かない旧品は廃止品なので採用しません。[6]

10台比較の単価は$1.5831から$0.3802となり、**$1.2029/台**を削減します。新しい基板へ採用する選定であり、既存ランドへの無条件な差替えではありません。Würthは `alternative_components` にフォールバックとして保持し、主BOMの費用には含めません。

公称12 V→5 V、1.1 MHz、4.7 µH、出力0.4 Aでは、計算上リップル0.564 App、ピーク0.682 A、実効値0.432 Aです。正常負荷の余裕はあります。ただし飽和電流は典型値であり、高温保証最小値ではありません。正確なパッド、起動、上流短絡と高温での動作は今後検証します。下流LEDラッチだけでは、その上流の短絡を保護できません。

## 費用の比較

| 台数 | JLC実装部品/台 | LEDケーブル2本/台 | 電源ケーブル1本/台 | ここまでの合計/台 |
|---:|---:|---:|---:|---:|
| 1 | $9.6312 | $1.9000 | $3.5100 | $15.0412 |
| 10 | **$8.6171** | $1.9000 | $2.9850 | **$13.5021** |
| 100 | $6.4997 | $1.9000 | $2.5365 | $10.9362 |

実装必要数に公開価格帯を適用した計算です。PCB、実装、段取り、面付け、治具、X線、書込み、余剰、最低購入数、Eurorackリボン、アクリル、PETG、固定金具、送料、税は含みません。完成品の原価・発注見積りではありません。

完成ケーブルはAdafruit4399を2本/台、Molex151340300を1本/台。DigiKeyで11:37 JSTに確認した在庫は12,943本と17,783本です。Molexの1/3反転結線は変換PCB側で補償します。LED用SH4はGND/VLED/DATA/NCの独自配線であり、Qwiic通信ポートではありません。[7,8]

## 機構と回路に残る確認

無ねじPJ-3582-Bの挿入・抜去荷重、トグル回り止め、座面、工場での長い端子のトリムを含むPETG支持体が必要です。SH4は相手ハウジングを含めると中央の光学空間へそのまま収まらず、下端で位置をずらすなどの逃げが必要です。電源変換基板とケーブルも含めて全体を設計します。**A3の29.5 mmをA4.1全体の奥行き保証には使いません。**

CVは公称20 MΩ検出枝、THRU直結、`VADC = V3V3/2 + CV/8`。抵抗のみの最悪組合せは±5 Vで最大約0.233 Vの入力換算誤差です。FWでゼロ/ゲインを校正します。ADC負側保護、電源OFF時注入、逆接、MLCC実効容量、降圧ループは未完の設計確認です。

TPS2552DBVR-1はEN切替でラッチ解除します。MCUリセット後に毎回自動でLEDを再有効化すると故障後も再試行するため、FAULT、リセット理由、故障記録、明示的復帰条件をFWで定義する必要があります。20%の初期輝度制限と過電流遮断は別機能です。

## ファイルと継続方法

- 現行: このREADME、`continue-here.md`、`procurement_rows.json`。
- 新観測: `evidence_refresh/`、`live_jlc_refresh.json`。
- 独立監査: `audits/`。前面、電気、表計算、復元整合性を含む。
- 過去の調査: A4の研究ファイルと `history_A4/`。旧価格・旧在庫・Würth主案は当時の記録。
- 元機構: `references/light_block_A3_design_package.zip`。ユーザー提供の元CADであり、新I/Oを含む完成モデルではない。
- 再生成: `build_procurement_rows.py`、`spreadsheet/build_parts_workbook.mjs`、`build_brief.py`、`build_package.py`。

## 主な一次資料

1. https://www.elecrow.com/acrylic-cutting.html
2. https://www.troteclaser.com/en-us/helpcenter/materials/material-usage-hints/material-handling-acrylic
3. https://jlcpcb.com/partdetail/Worldsemi-LED/C52917434
4. https://jlcpcb.com/help/article/pcb-assembly-price
5. https://jlcpcb.com/help/article/pcb-assembly-faqs
6. https://product.tdk.com/en/search/inductor/inductor/smd/info?part_no=SPM4020T-4R7M-LR
7. https://www.digikey.com/en/products/detail/adafruit-industries-llc/4399/10824268
8. https://www.digikey.com/en/products/detail/molex/0151340300/6198142

全29部品のURLと時刻は部品表の各行にあります。問い合わせ送信、部品予約、購入は行っていません。
