Takazudo/zudo-led-block/engineering/a5/integration/native_schematic/controller/controller.pdf

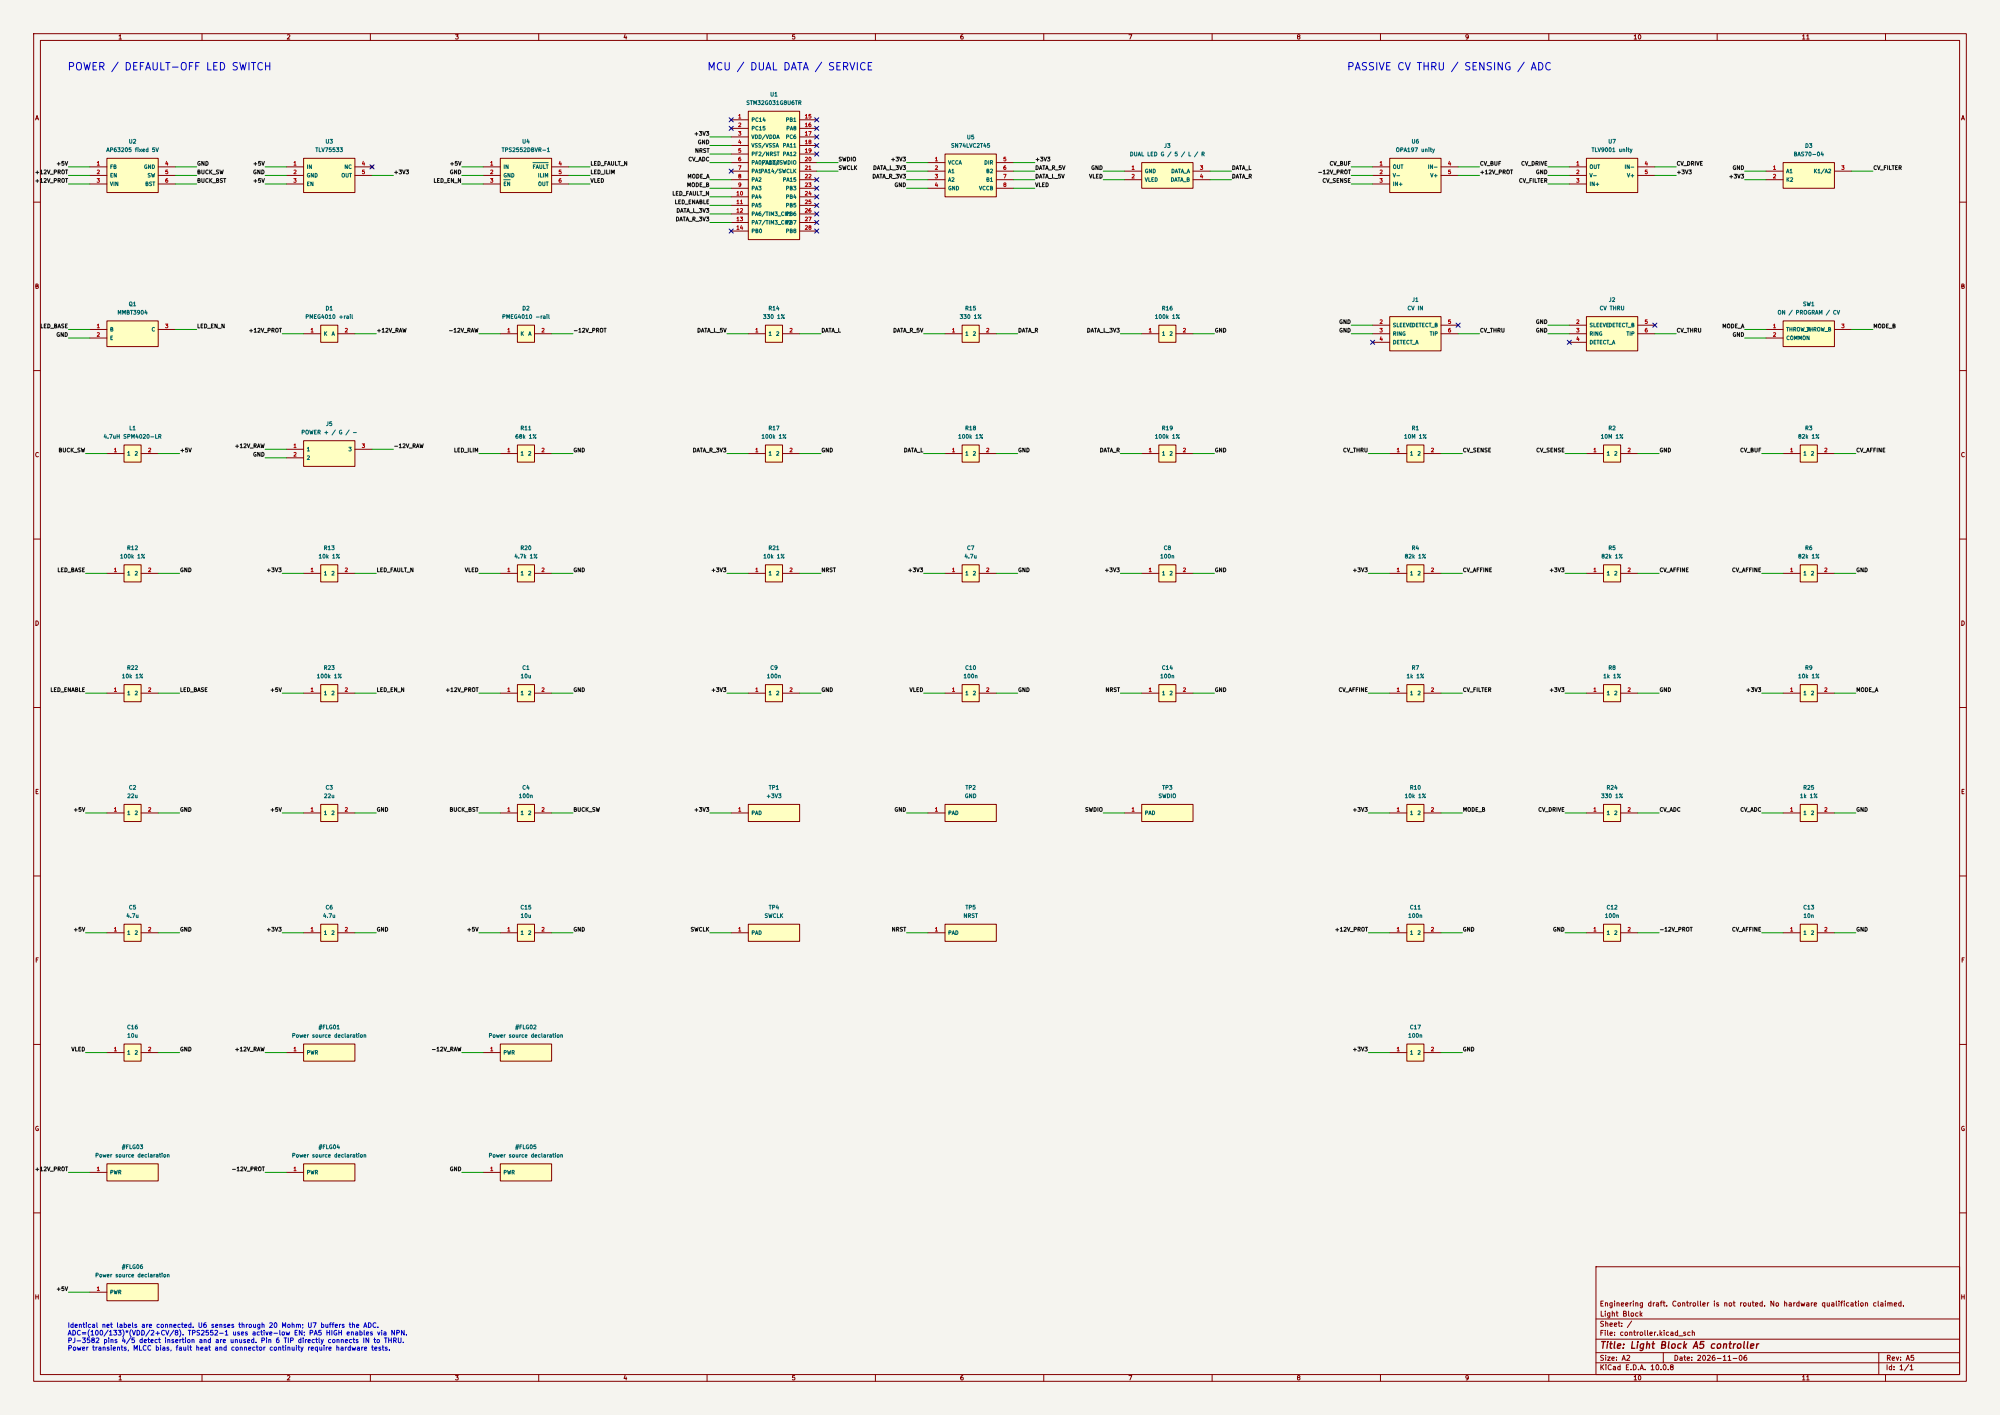
[picture p54: page 1]

Engineering draft. Controller is not routed. No hardware qualification claimed.
Light Block
Sheet: /
File: controller.kicad_sch
Title: Light Block A5 controller

Identical net labels are connected. U6 senses through 20 Mohm; U7 buffers the ADC. ADC=(100/133)*(VDD/2+CV/8). TPS2552-1 uses active-low EN; PA5 HIGH enables via NPN. PJ-3582 pins 4/5 detect insertion and are unused. Pin 6 TIP directly connects IN to THRU. Power transients, MLCC bias, fault heat and connector continuity require hardware tests.

Size: A2 | Rev: A5
KiCad E.D.A. 10.0.8 | Id: 1/1
