Takazudo/zudo-led-block/engineering/a5/integration/native_schematic/led_leaf/led_leaf.pdf

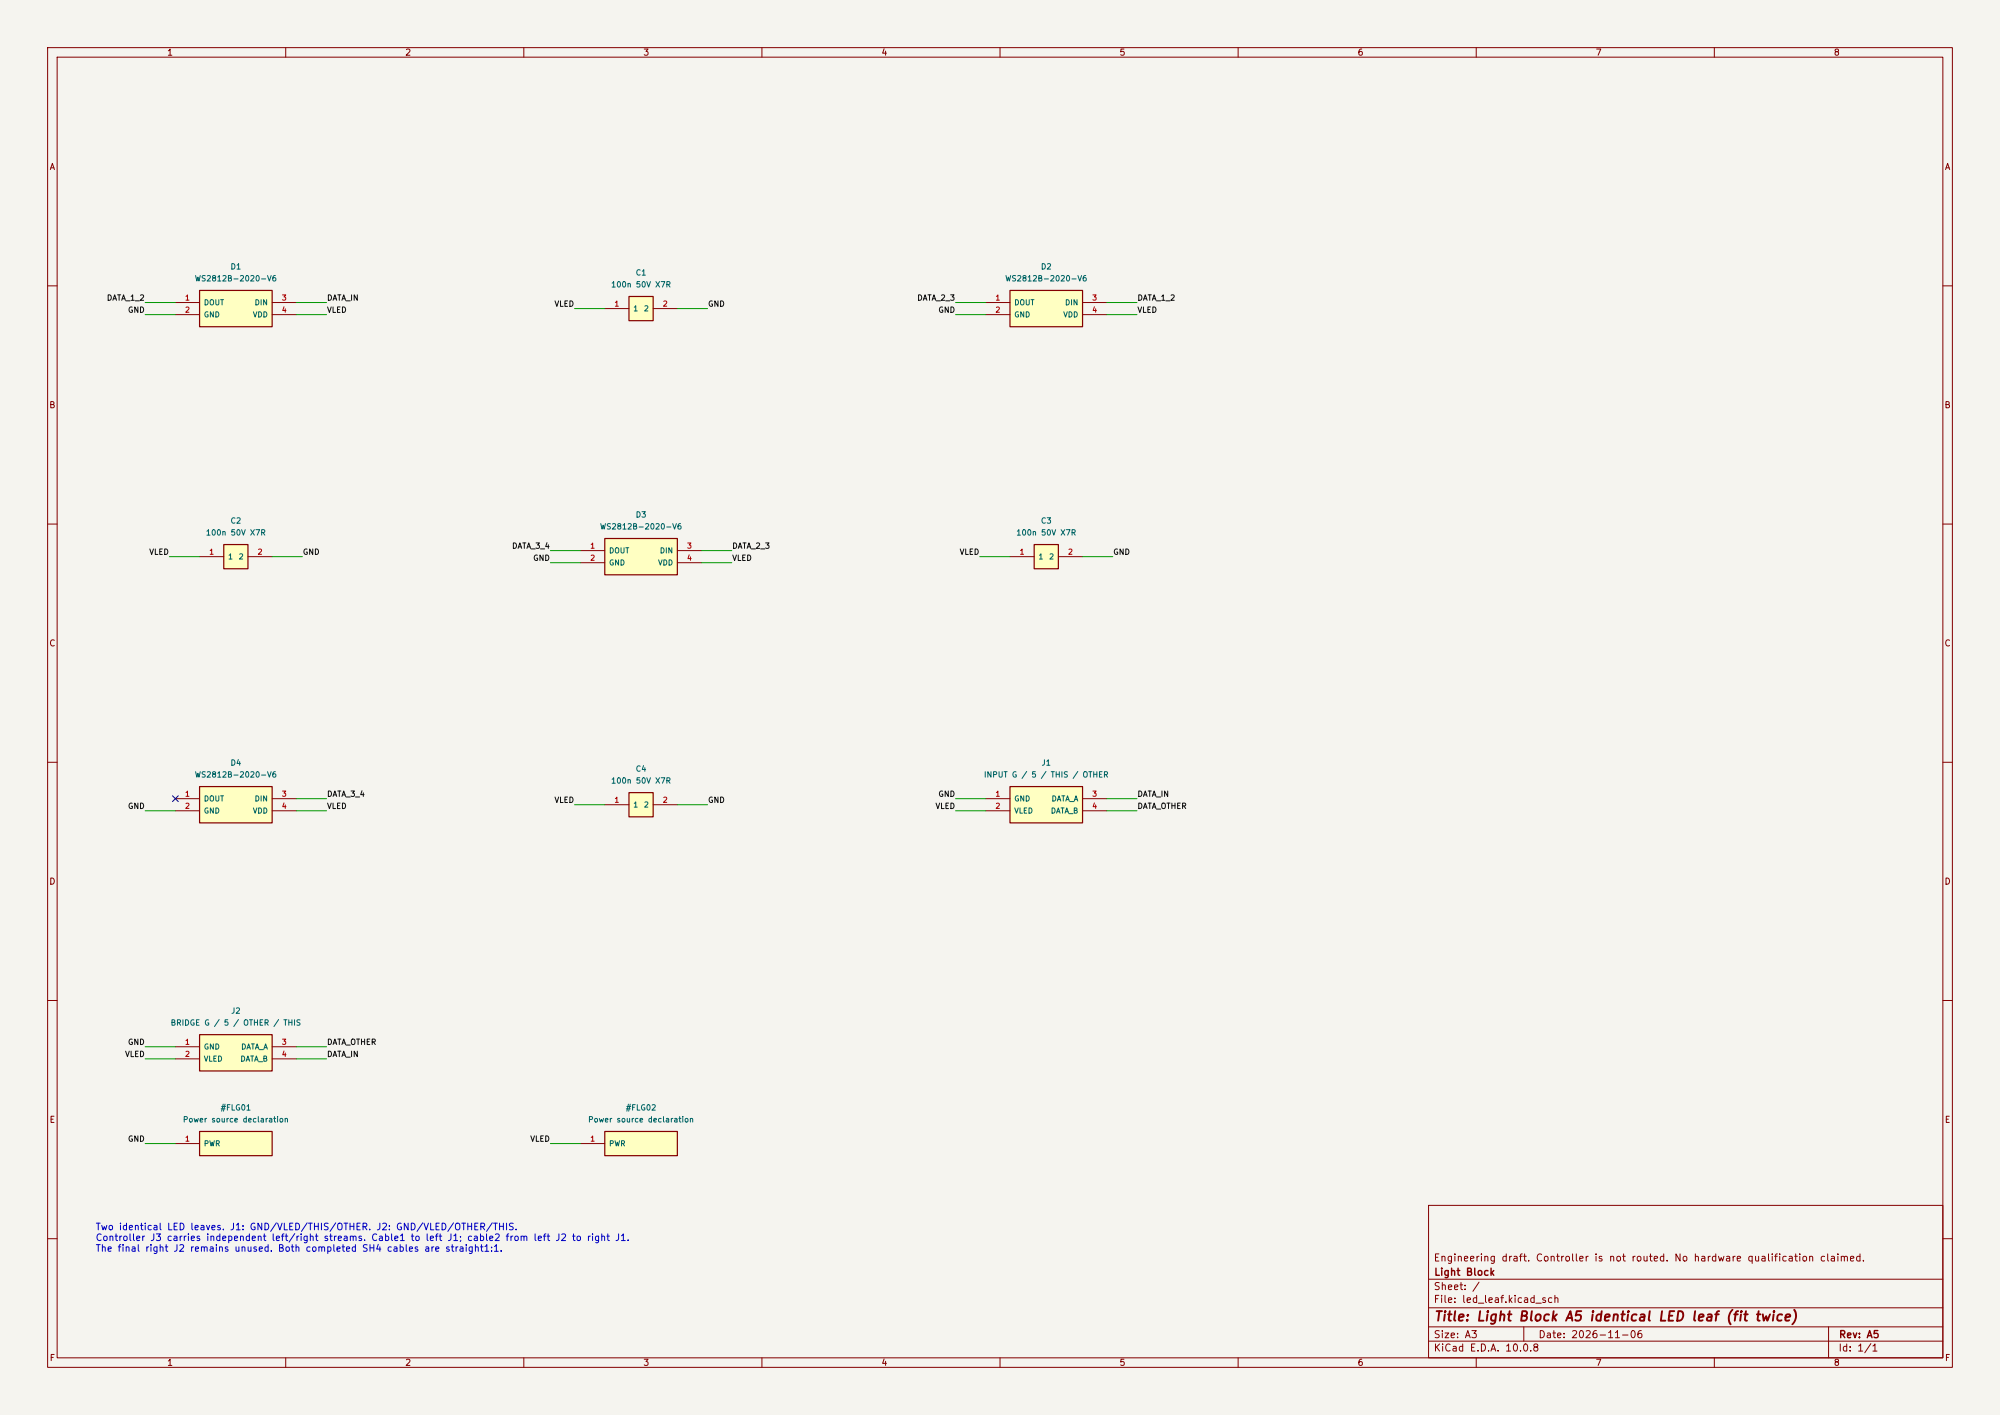
[picture p55: page 1]

Two identical LED leaves. J1: GND/VLED/THIS/OTHER. J2: GND/VLED/OTHER/THIS. Controller J3 carries independent left/right streams. Cable1 to left J1; cable2 from left J2 to right J1. The final right J2 remains unused. Both completed SH4 cables are straight1:1.

Engineering draft. Controller is not routed. No hardware qualification claimed.
Light Block
Sheet: /
File: led_leaf.kicad_sch
Title: Light Block A5 identical LED leaf (fit twice)

Size: A3 | Rev: A5 | F Date: 2026-11-06
KiCad E.D.A. 10.0.8 | Id: 1/1
