Takazudo/zudo-led-block/engineering/a5/integration/native_schematic/power_adapter/power_adapter.pdf

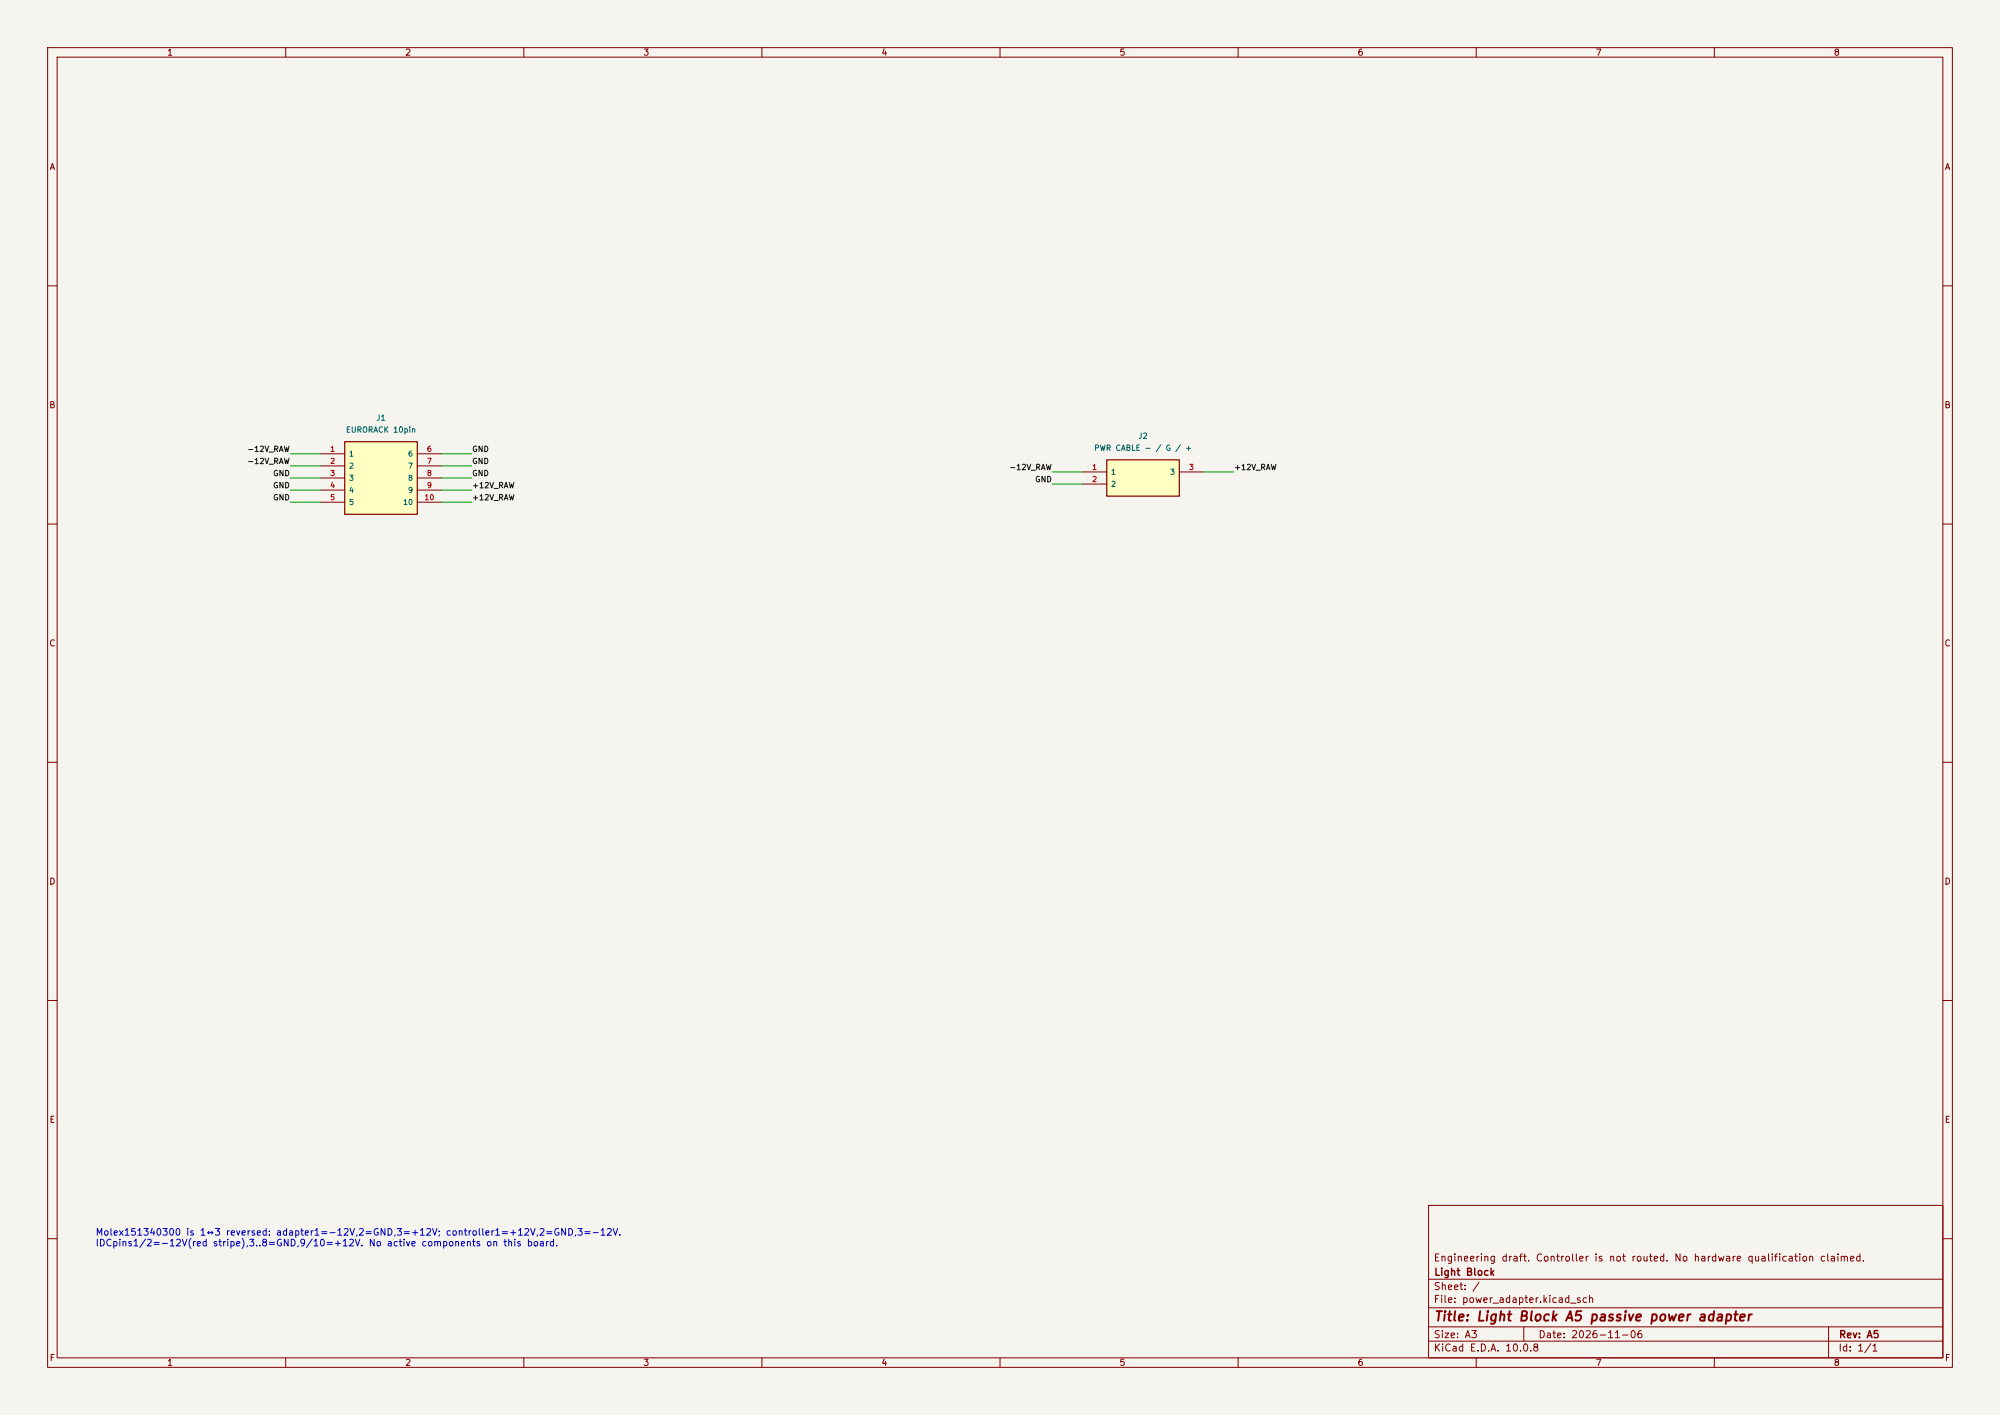
[picture p56: page 1]

GND Molex151340300 is 1↔3 reversed: adapter1=-12V,2=GND,3=+12V; controller1=+12V,2=GND,3=-12V.

IDCpins1/2=-12V(red stripe),3..8=GND,9/10=+12V. No active components on this board.

Engineering draft. Controller is not routed. No hardware qualification claimed.
Light Block
Sheet: /
File: power_adapter.kicad_sch
Title: Light Block A5 passive power adapter

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
