Takazudo/zudo-led-block/(list of files, drawings)

Other design files:
engineering/a5/electronics/reports/pcb_qualification.json
engineering/a5/integration/schematic_interface_check.json
engineering/a5/integration/schematic_visual_review.json
