Takazudo/zudo-led-block/engineering/a7/electronics/controller/controller.kicad_pcb

## KiCad design engineering/a7/electronics/controller/controller.kicad_pcb (2026-11-12)

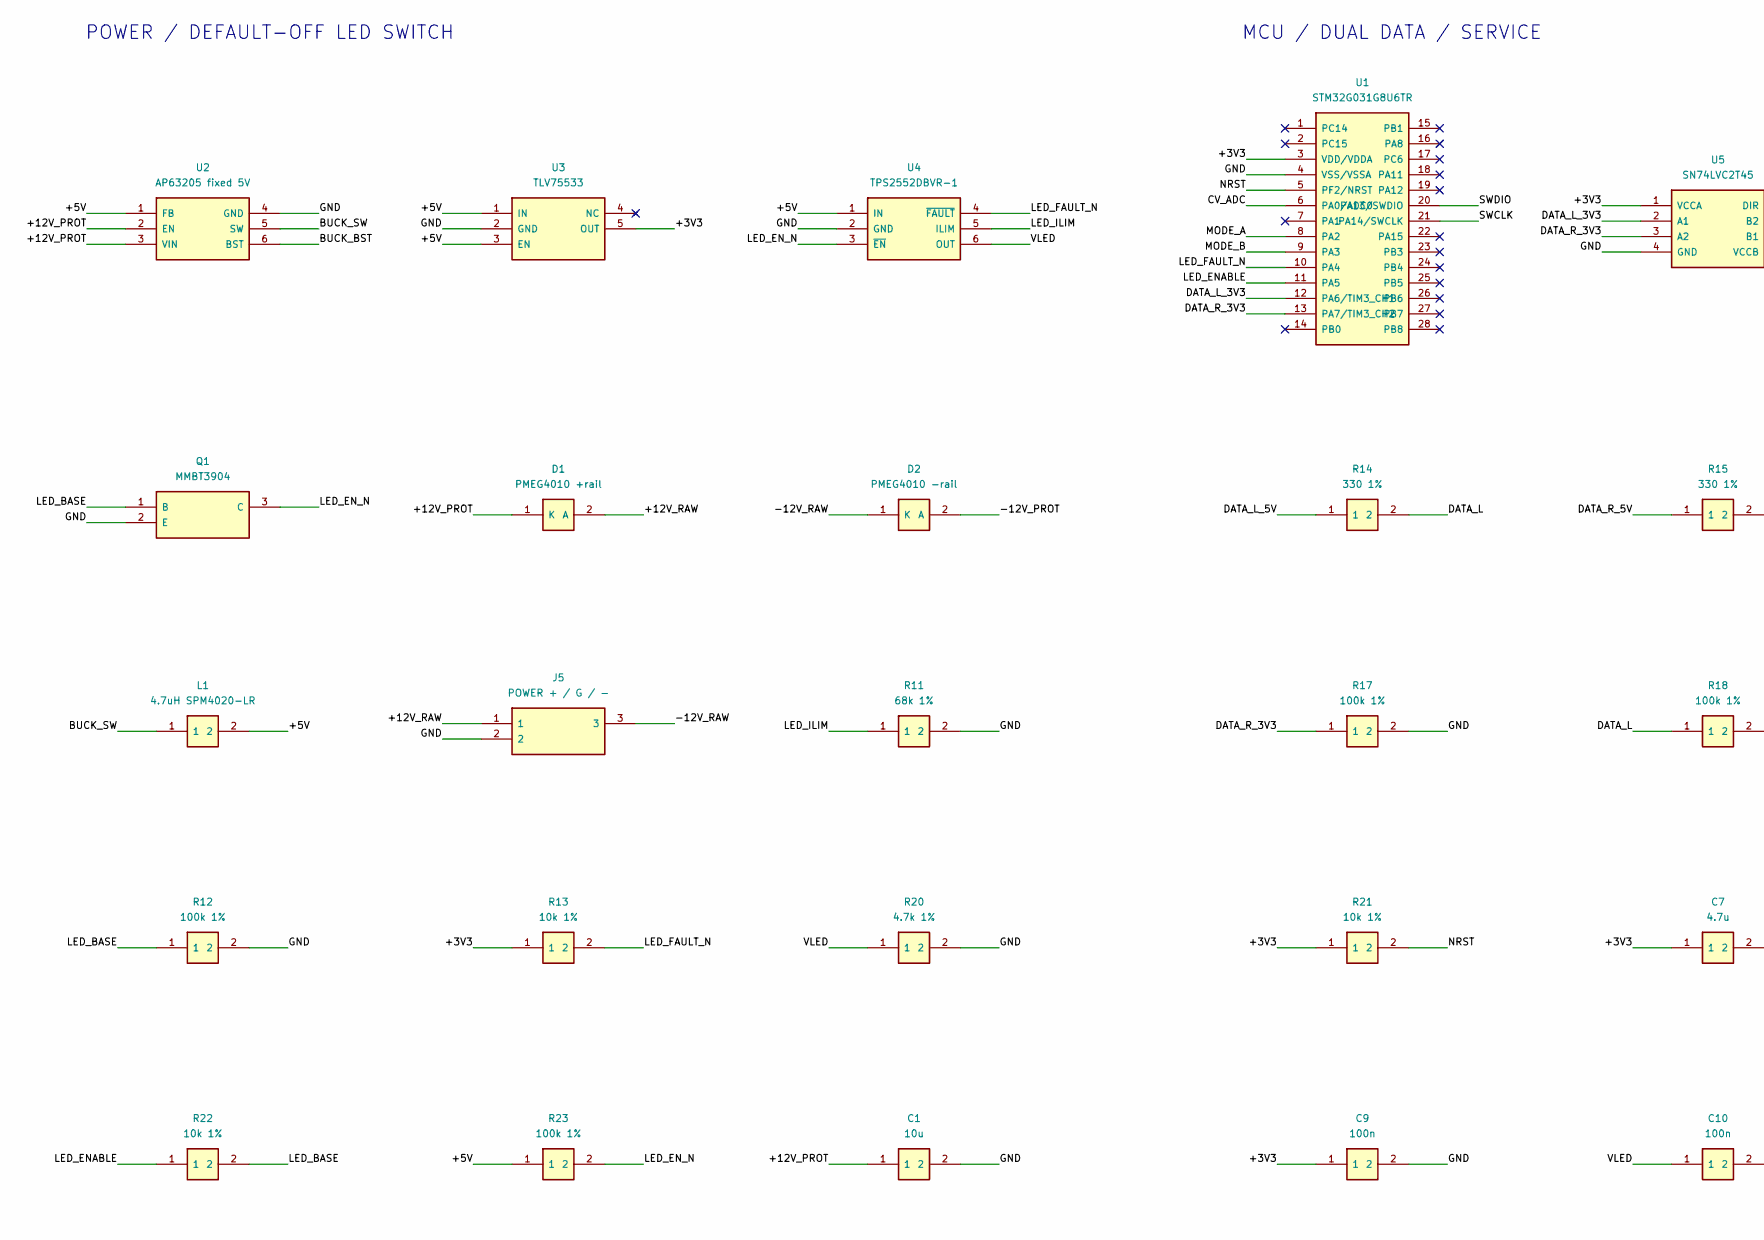
[picture p57: schematic controller.kicad_sch, Light Block A7 controller, part in row 1, column 1]

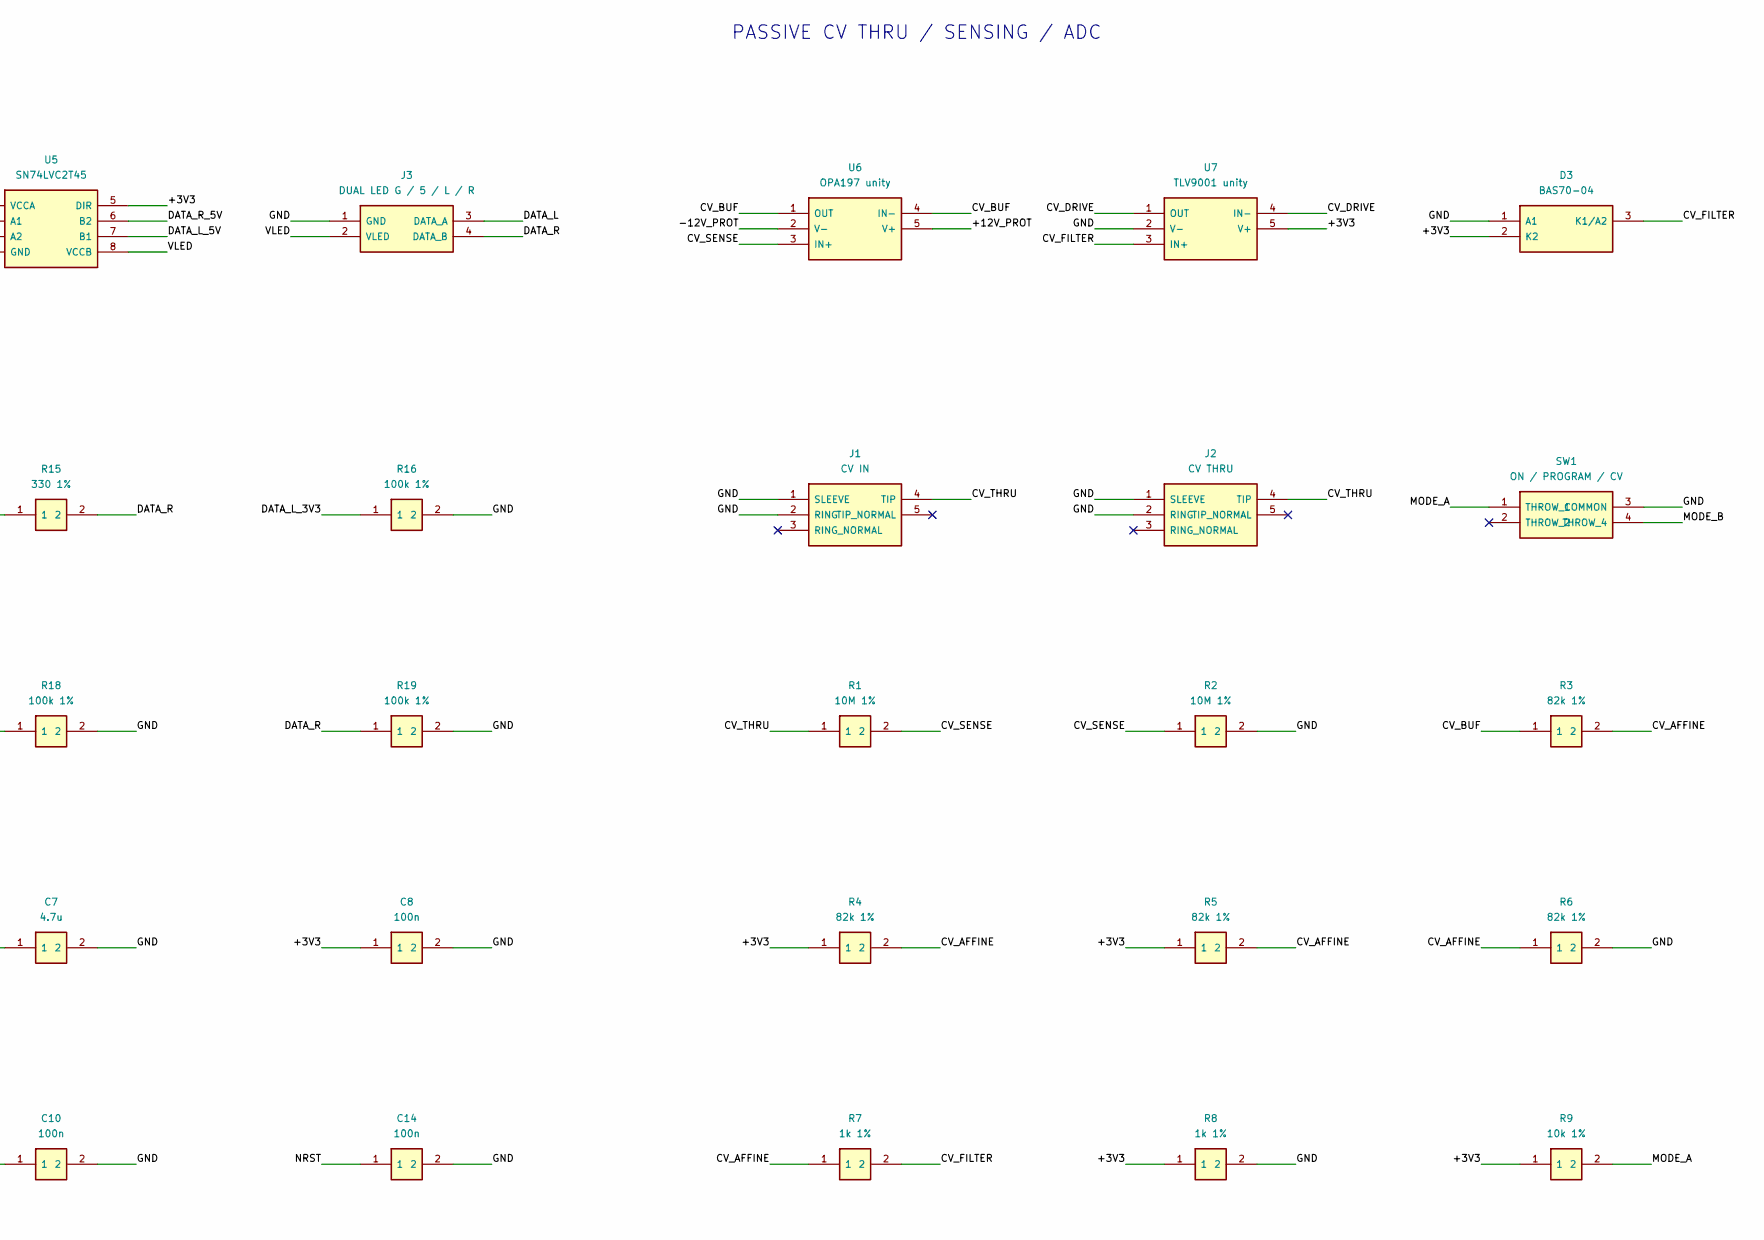
[picture p58: schematic controller.kicad_sch, Light Block A7 controller, part in row 1, column 2]

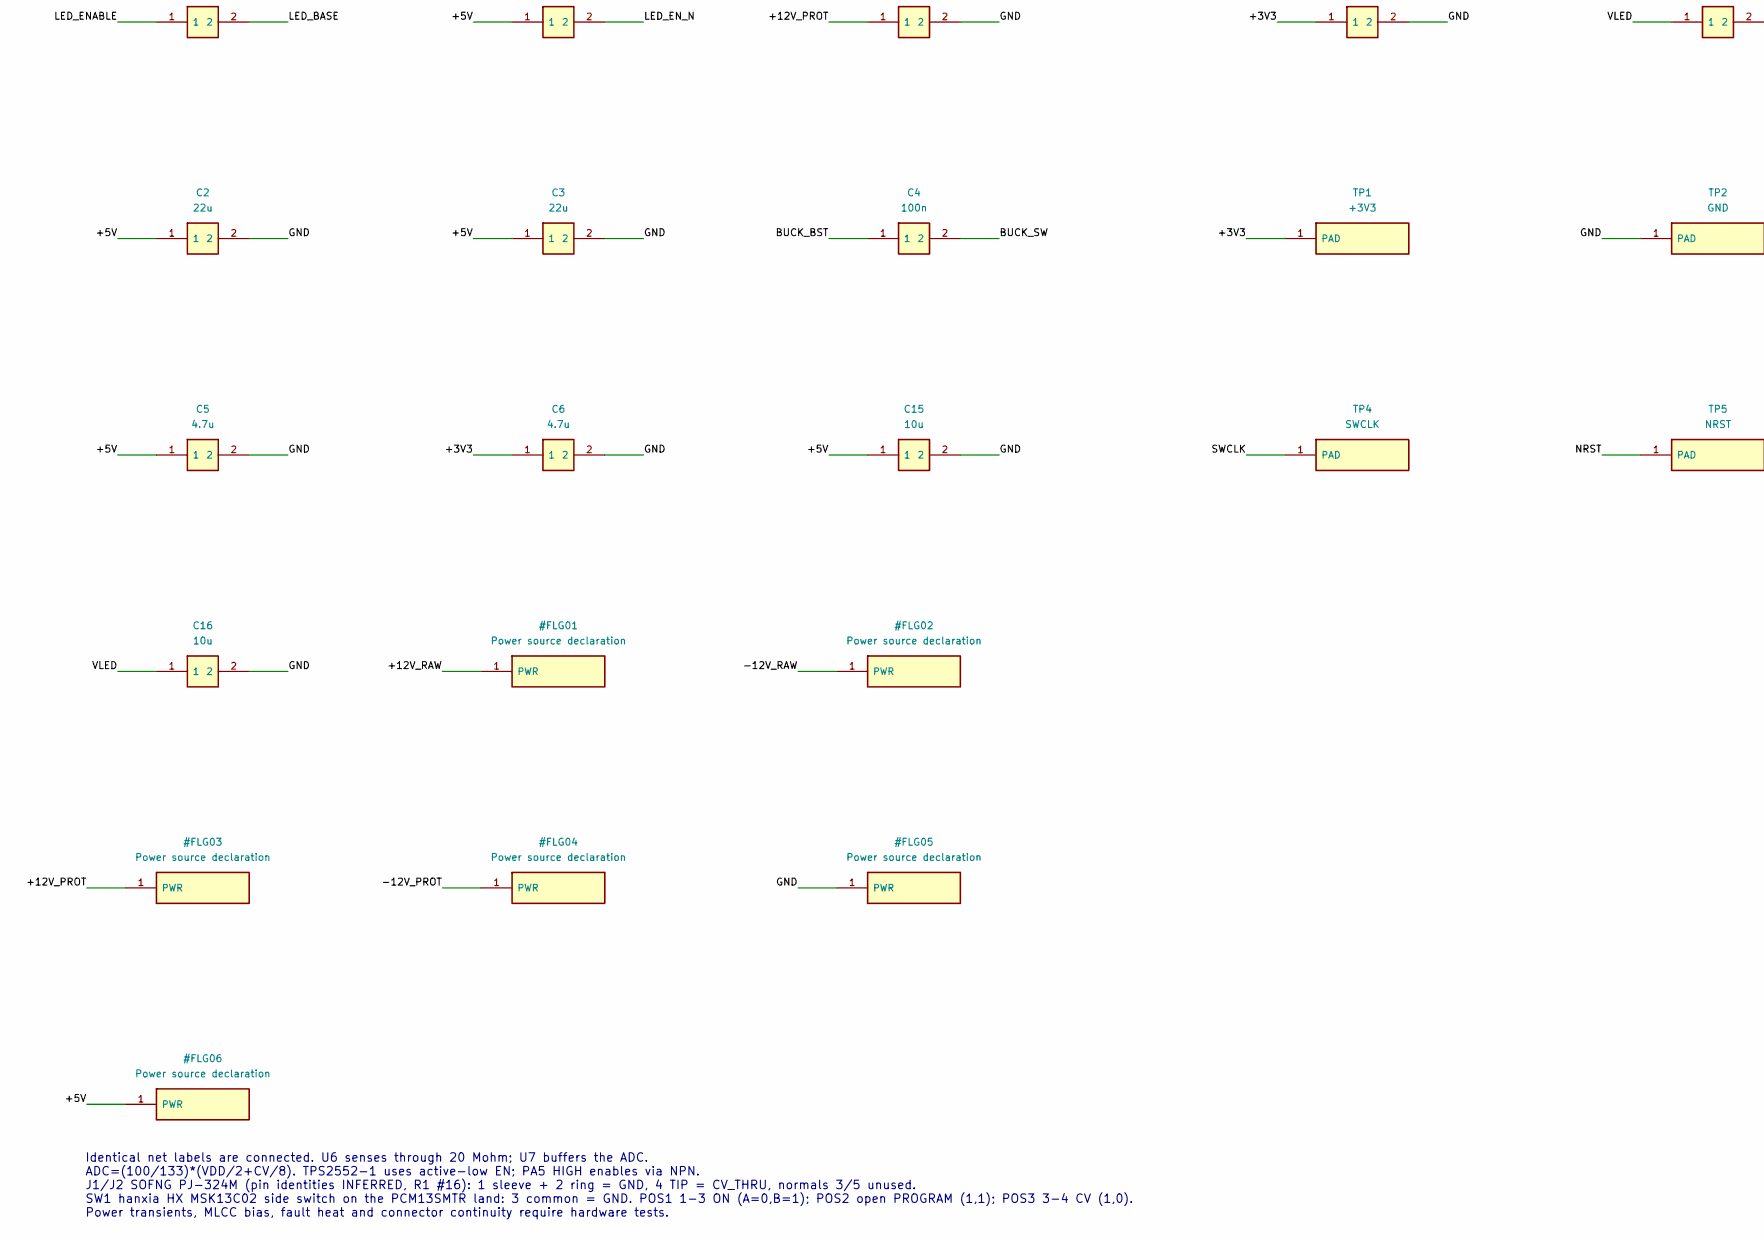
[picture p59: schematic controller.kicad_sch, Light Block A7 controller, part in row 2, column 1]

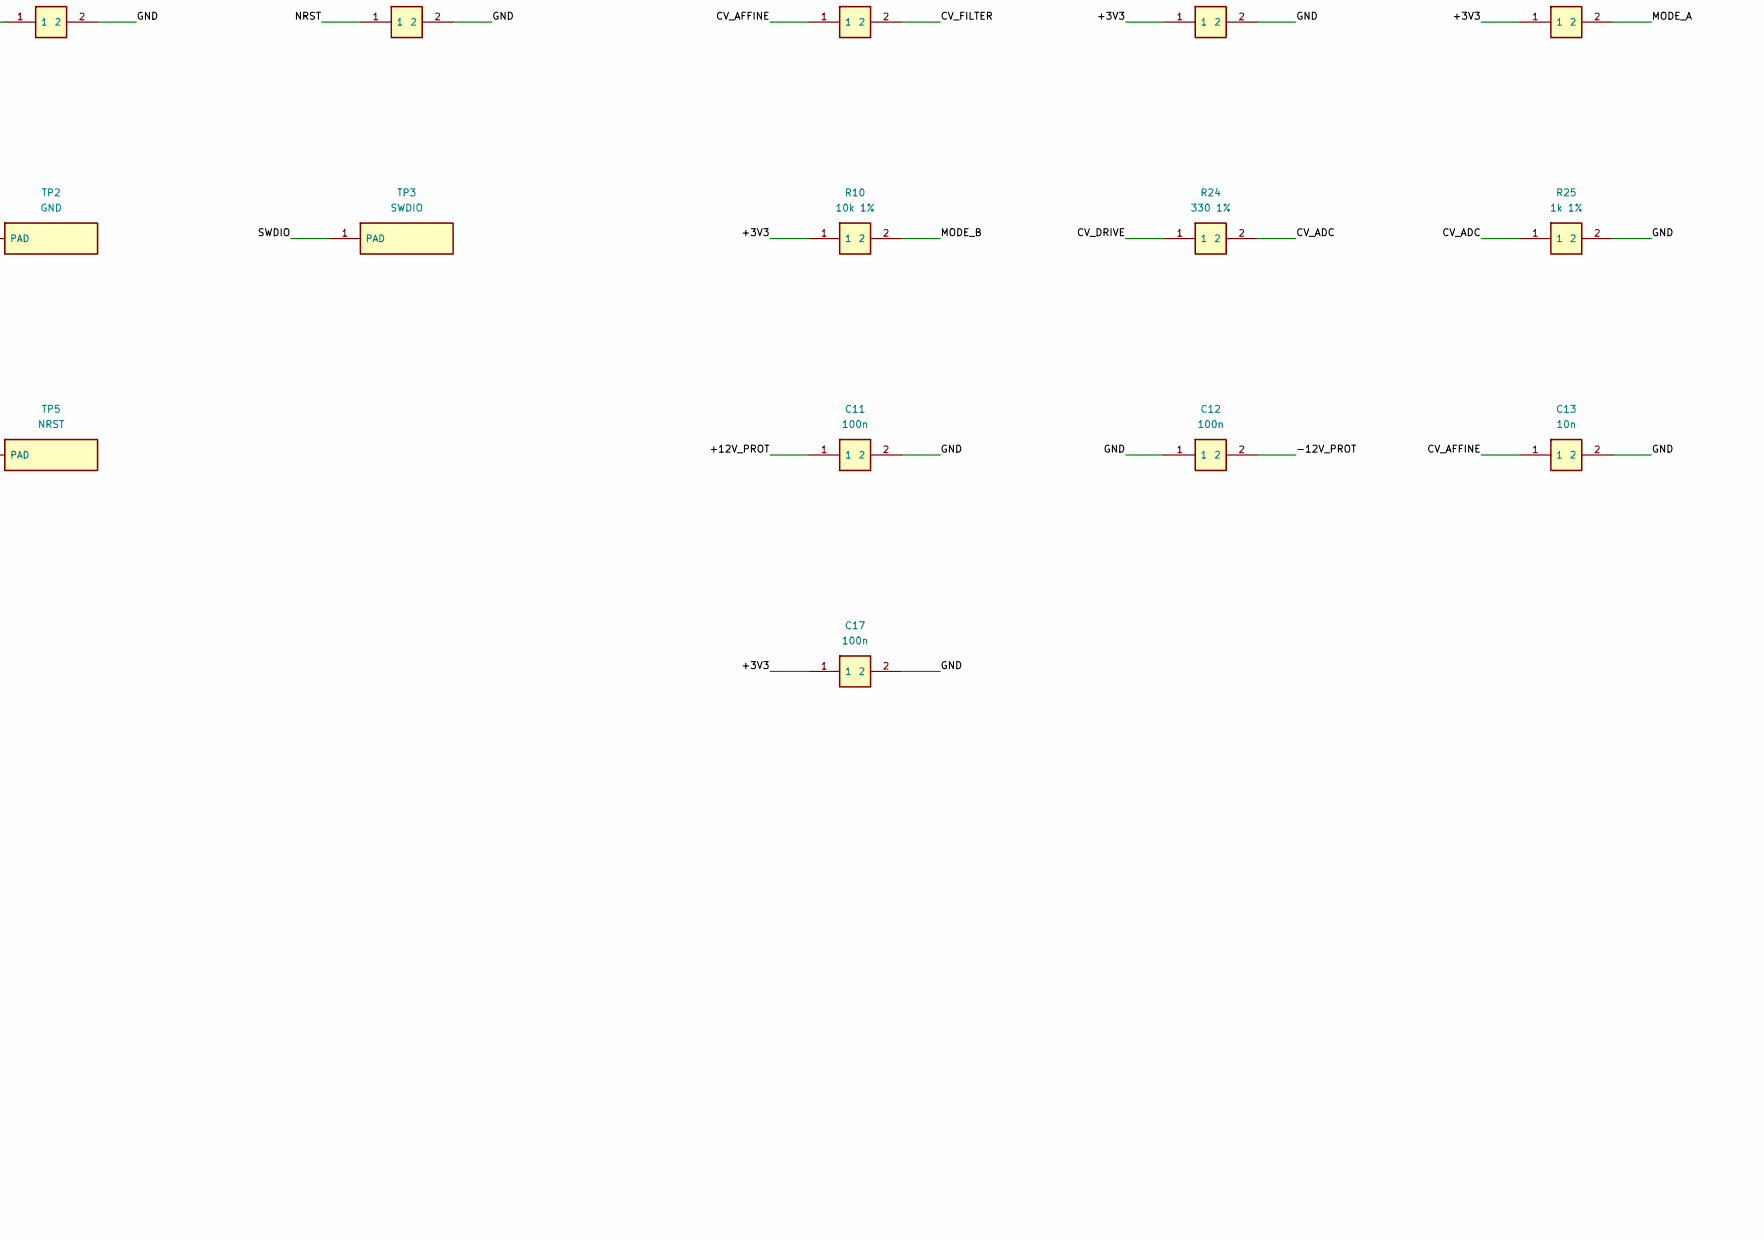
[picture p60: schematic controller.kicad_sch, Light Block A7 controller, part in row 2, column 2]

Parts:
C1, C15, C16: 10u; C0805; MPN CL21A106KAYNNNE; LCSC C15850
C2, C3: 22u; C1206; MPN CL31A226KAHNNNE; LCSC C12891
C4, C8, C9, C10, C11, C12, C14, C17: 100n; C0603; MPN CC0603KRX7R9BB104; LCSC C14663
C5, C6, C7: 4.7u; C0603; MPN CL10A475KO8NNNC; LCSC C19666
C13: 10n; C0603; MPN 0603B103K500NT; LCSC C57112
D1: PMEG4010 +rail; SOD323F; MPN PMEG4010CEJ,115; LCSC C50704
D2: PMEG4010 -rail; SOD323F; MPN PMEG4010CEJ,115; LCSC C50704
D3: BAS70-04; SOT23; MPN BAS70-04-7-F; LCSC C134375
J1: CV IN; PJ324M; MPN PJ-324M; LCSC C22355739
J2: CV THRU; PJ324M; MPN PJ-324M; LCSC C22355739
J3: DUAL LED G / 5 / L / R; JST_SH4; MPN SM04B-SRSS-TB(LF)(SN); LCSC C160404
J5: POWER + / G / -; PICO3; MPN 530470310; LCSC C122442
L1: 4.7uH SPM4020-LR; SPM4020_LR; MPN SPM4020T-4R7M-LR; LCSC C694586
Q1: MMBT3904; SOT23; MPN MMBT3904(RANGE:100-300); LCSC C20526
R1, R2: 10M 1%; R0603; MPN 0603WAF1005T5E; LCSC C7250
R3, R4, R5, R6: 82k 1%; R0603; MPN 0603WAF8202T5E; LCSC C23254
R7, R8, R25: 1k 1%; R0603; MPN 0603WAF1001T5E; LCSC C21190
R9, R10, R13, R21, R22: 10k 1%; R0603; MPN 0603WAF1002T5E; LCSC C25804
R11: 68k 1%; R0603; MPN 0603WAF6802T5E; LCSC C23231
R12, R16, R17, R18, R19, R23: 100k 1%; R0603; MPN 0603WAF1003T5E; LCSC C25803
R14, R15, R24: 330 1%; R0603; MPN 0603WAF3300T5E; LCSC C23138
R20: 4.7k 1%; R0603; MPN 0603WAF4701T5E; LCSC C23162
SW1: ON / PROGRAM / CV; PCM13SMTR; MPN HX MSK13C02; LCSC C5149819
TP1: +3V3; TESTPAD
TP2: GND; TESTPAD
TP3: SWDIO; TESTPAD
TP4: SWCLK; TESTPAD
TP5: NRST; TESTPAD
U1: STM32G031G8U6TR; QFN28; MPN STM32G031G8U6TR; LCSC C5270180
U2: AP63205 fixed 5V; TSOT26; MPN AP63205WU-7; LCSC C2071056
U3: TLV75533; DBV5; MPN TLV75533PDBVR; LCSC C404027
U4: TPS2552DBVR-1; DBV6; MPN TPS2552DBVR-1; LCSC C140331
U5: SN74LVC2T45; DCU8; MPN SN74LVC2T45DCUR; LCSC C15741
U6: OPA197 unity; DBV5; MPN OPA197IDBVR; LCSC C221351
U7: TLV9001 unity; DBV5; MPN TLV9001IDBVR; LCSC C398363

Connections:
/+3V3: C6.1, C7.1, C8.1, C9.1, C17.1, D3.2 (K2), R4.1, R5.1, R8.1, R9.1, R10.1, R13.1, R21.1, TP1.1, U1.3 (VDD/VDDA), U3.5 (OUT), U5.1 (VCCA), U5.5 (DIR), U7.5 (V+)
/+5V: C2.1, C3.1, C5.1, C15.1, L1.2, R23.1, U2.1 (FB), U3.1 (IN), U3.3 (EN), U4.1 (IN)
/+12V_PROT: C1.1, C11.1, D1.1 (K), U2.2 (EN), U2.3 (VIN), U6.5 (V+)
/+12V_RAW: D1.2 (A), J5.1
/-12V_PROT: C12.2, D2.2 (A), U6.2 (V-)
/-12V_RAW: D2.1 (K), J5.3
/BUCK_BST: C4.1, U2.6 (BST)
/BUCK_SW: C4.2, L1.1, U2.5 (SW)
/CV_ADC: R24.2, R25.1, U1.6 (PA0/ADC0)
/CV_AFFINE: C13.1, R3.2, R4.2, R5.2, R6.1, R7.1
/CV_BUF: R3.1, U6.1 (OUT), U6.4 (IN-)
/CV_DRIVE: R24.1, U7.1 (OUT), U7.4 (IN-)
/CV_FILTER: D3.3 (K1/A2), R7.2, U7.3 (IN+)
/CV_SENSE: R1.2, R2.1, U6.3 (IN+)
/CV_THRU: J1.4 (TIP), J2.4 (TIP), R1.1
/DATA_L: J3.3 (DATA_A), R14.2, R18.1
/DATA_L_3V3: R16.1, U1.12 (PA6/TIM3_CH1), U5.2 (A1)
/DATA_L_5V: R14.1, U5.7 (B1)
/DATA_R: J3.4 (DATA_B), R15.2, R19.1
/DATA_R_3V3: R17.1, U1.13 (PA7/TIM3_CH2), U5.3 (A2)
/DATA_R_5V: R15.1, U5.6 (B2)
/GND: C1.2, C2.2, C3.2, C5.2, C6.2, C7.2, C8.2, C9.2, C10.2, C11.2, C12.1, C13.2, C14.2, C15.2, C16.2, C17.2, D3.1 (A1), J1.1 (SLEEVE), J1.2 (RING), J2.1 (SLEEVE), J2.2 (RING), J3.1 (GND), J5.2, Q1.2 (E), R2.2, R6.2, R8.2, R11.2, R12.2, R16.2, R17.2, R18.2, R19.2, R20.2, R25.2, SW1.3 (COMMON), TP2.1, U1.4 (VSS/VSSA), U2.4 (GND), U3.2 (GND), U4.2 (GND), U5.4 (GND), U7.2 (V-)
/LED_BASE: Q1.1 (B), R12.1, R22.2
/LED_ENABLE: R22.1, U1.11 (PA5)
/LED_EN_N: Q1.3 (C), R23.2, U4.3 (~EN)
/LED_FAULT_N: R13.2, U1.10 (PA4), U4.4 (~FAULT)
/LED_ILIM: R11.1, U4.5 (ILIM)
/MODE_A: R9.2, SW1.1 (THROW_1), U1.8 (PA2)
/MODE_B: R10.2, SW1.4 (THROW_4), U1.9 (PA3)
/NRST: C14.1, R21.2, TP5.1, U1.5 (PF2/NRST)
/SWCLK: TP4.1, U1.21 (PA14/SWCLK)
/SWDIO: TP3.1, U1.20 (PA13/SWDIO)
/VLED: C10.1, C16.1, J3.2 (VLED), R20.1, U4.6 (OUT), U5.8 (VCCB)

Notes on the sheet:
POWER / DEFAULT-OFF LED SWITCH
MCU / DUAL DATA / SERVICE
PASSIVE CV THRU / SENSING / ADC
Identical net labels are connected. U6 senses through 20 Mohm; U7 buffers the ADC. ADC=(100/133)*(VDD/2+CV/8). TPS2552-1 uses active-low EN; PA5 HIGH enables via NPN. J1/J2 SOFNG PJ-324M (pin identities INFERRED, R1 #16): 1 sleeve + 2 ring = GND, 4 TIP = CV_THRU, normals 3/5 unused. SW1 hanxia HX M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

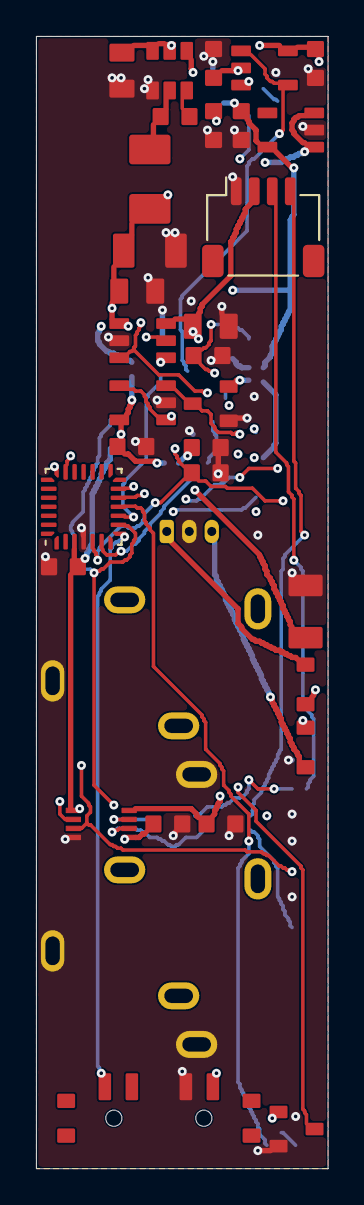
[picture p61: board controller.kicad_pcb from above]

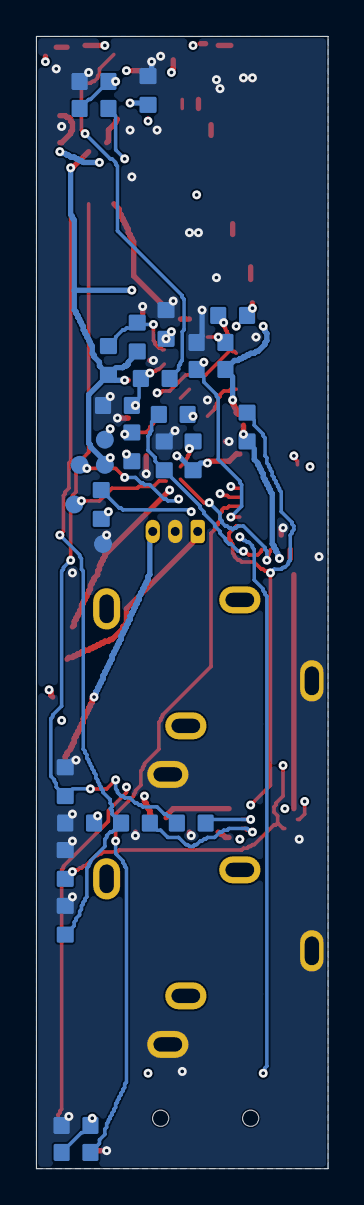
[picture p62: board controller.kicad_pcb from below]

Board: 4 copper layers, 16.2 x 62.9 mm, 64 parts (30 on the bottom side), 33 nets.
