Takazudo/zudo-led-block/scripts/tests/fixtures/native/led_leaf_zoned/fixture.kicad_pcb

## KiCad design scripts/tests/fixtures/native/led_leaf_zoned/fixture.kicad_pcb (2026-11-08)

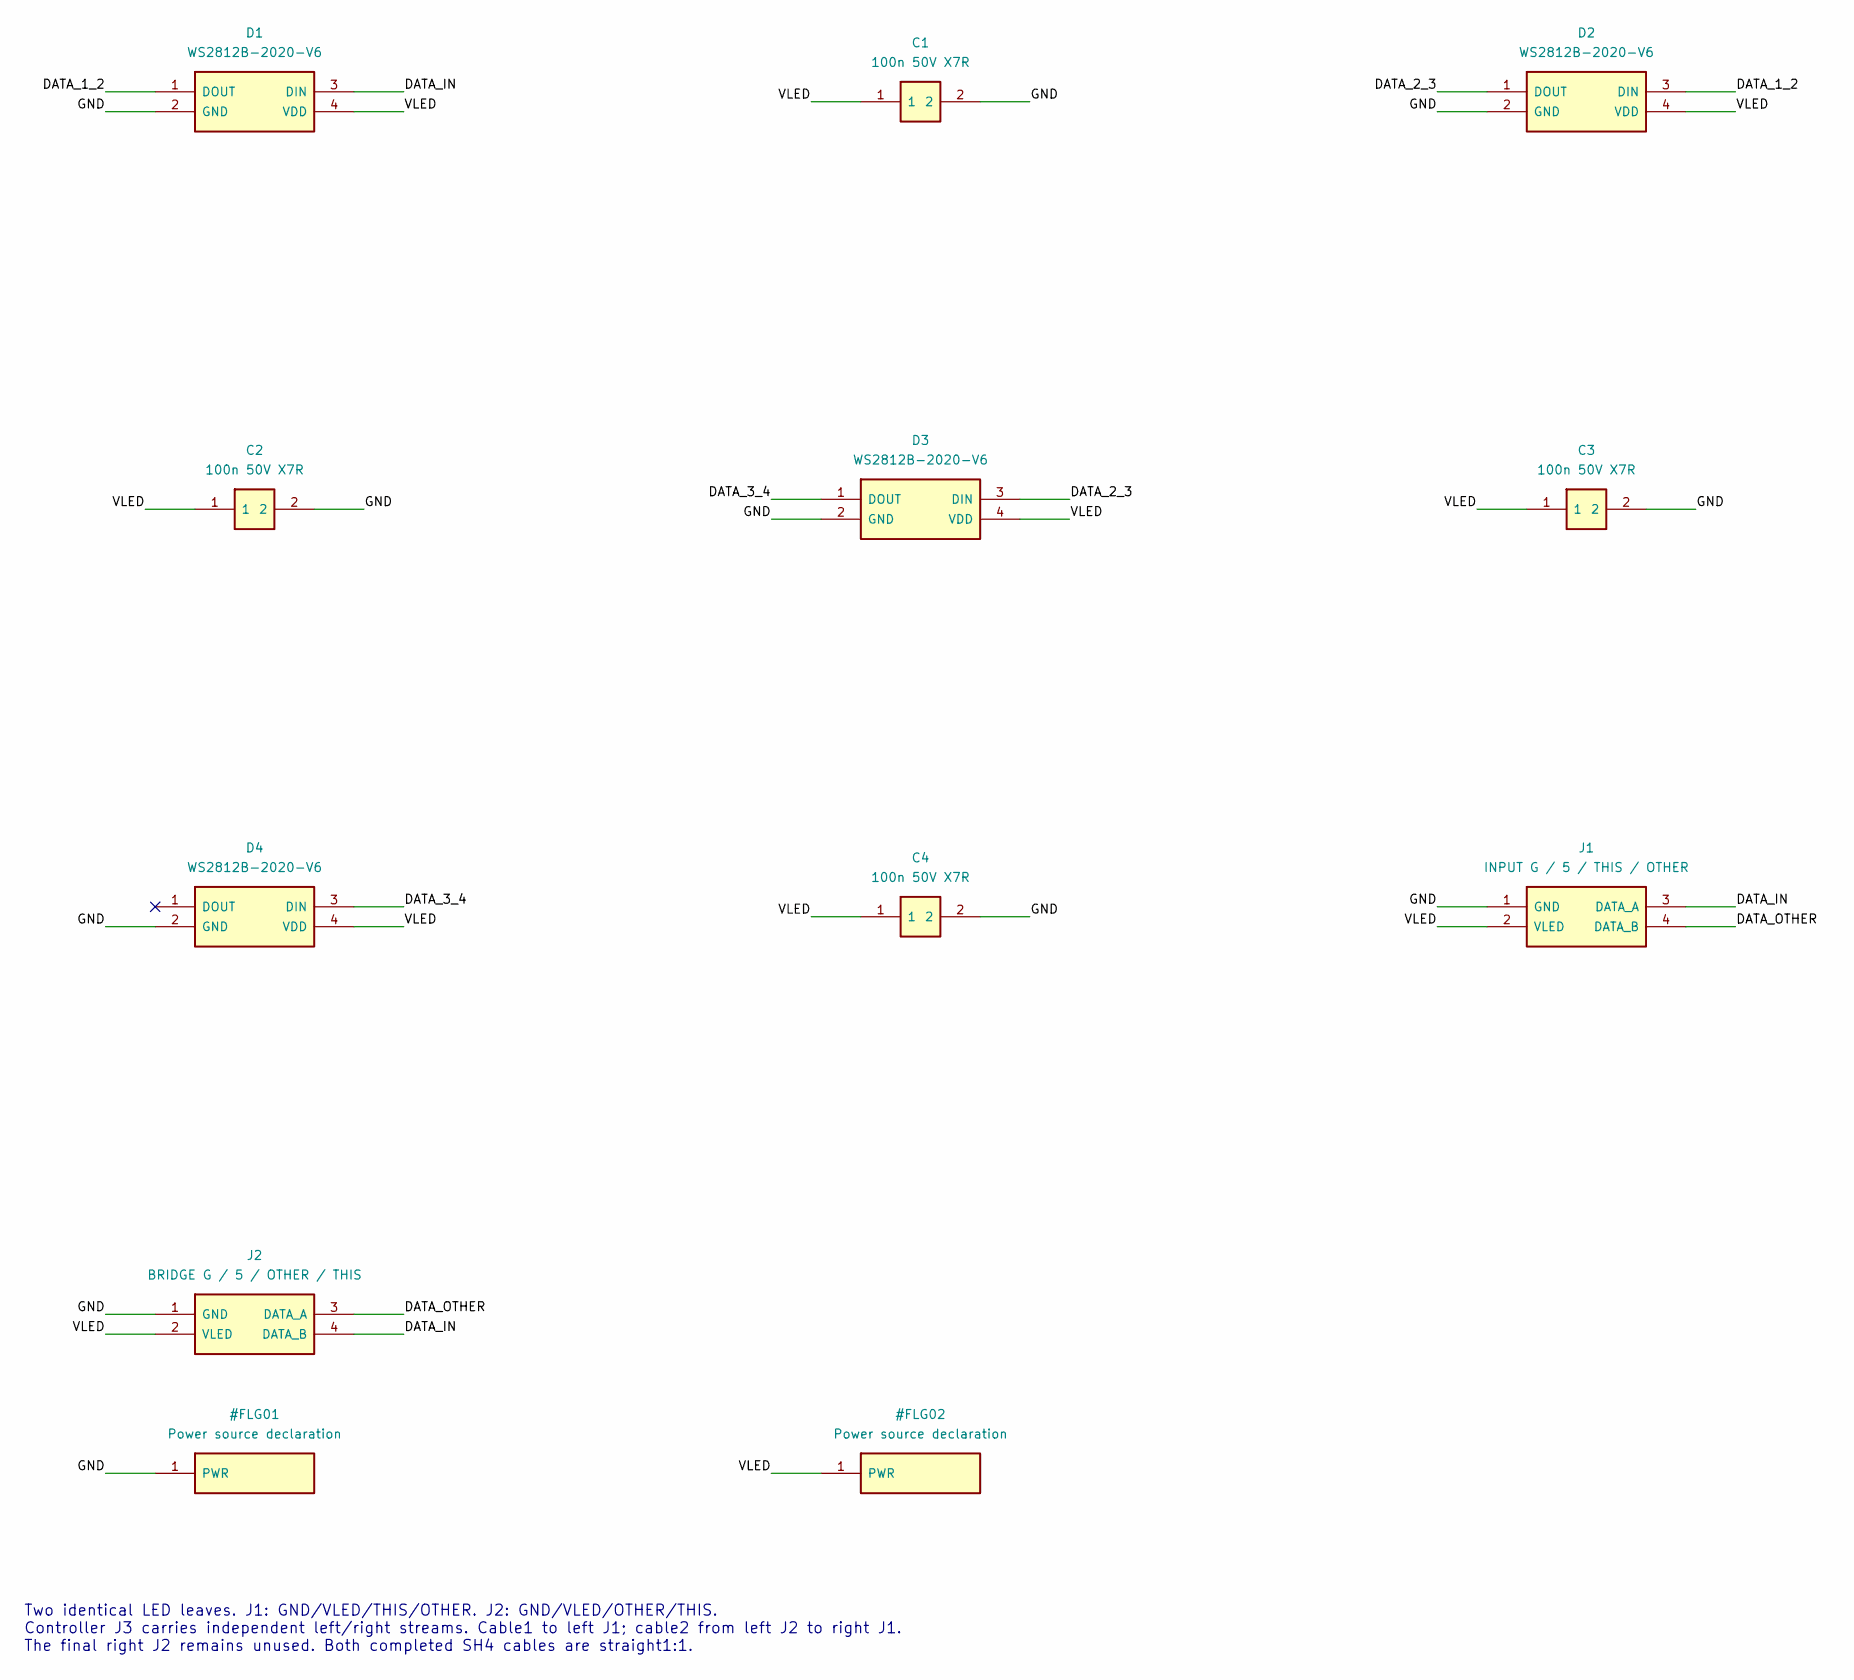
[picture p63: schematic fixture.kicad_sch, Light Block A5 identical LED leaf (fit twice)]

Parts:
C1, C2, C3, C4: 100n 50V X7R; C0603; MPN CC0603KRX7R9BB104; LCSC C14663
D1, D2, D3, D4: WS2812B-2020-V6; WS2812B_2020_V6; MPN WS2812B-2020-V6; LCSC C52917434
J1: INPUT G / 5 / THIS / OTHER; JST_SH4; MPN SM04B-SRSS-TB(LF)(SN); LCSC C160404
J2: BRIDGE G / 5 / OTHER / THIS; JST_SH4; MPN SM04B-SRSS-TB(LF)(SN); LCSC C160404

Connections:
DATA_1_2: D1.1 (DOUT), D2.3 (DIN)
DATA_2_3: D2.1 (DOUT), D3.3 (DIN)
DATA_3_4: D3.1 (DOUT), D4.3 (DIN)
DATA_IN: D1.3 (DIN), J1.3 (DATA_A), J2.4 (DATA_B)
DATA_OTHER: J1.4 (DATA_B), J2.3 (DATA_A)
GND: C1.2, C2.2, C3.2, C4.2, D1.2 (GND), D2.2 (GND), D3.2 (GND), D4.2 (GND), J1.1 (GND), J2.1 (GND)
VLED: C1.1, C2.1, C3.1, C4.1, D1.4 (VDD), D2.4 (VDD), D3.4 (VDD), D4.4 (VDD), J1.2 (VLED), J2.2 (VLED)

Notes on the sheet:
Two identical LED leaves. J1: GND/VLED/THIS/OTHER. J2: GND/VLED/OTHER/THIS. Controller J3 carries independent left/right streams. Cable1 to left J1; cable2 from left J2 to right J1. The final right J2 remains unused. Both completed SH4 cables are straight1:1.

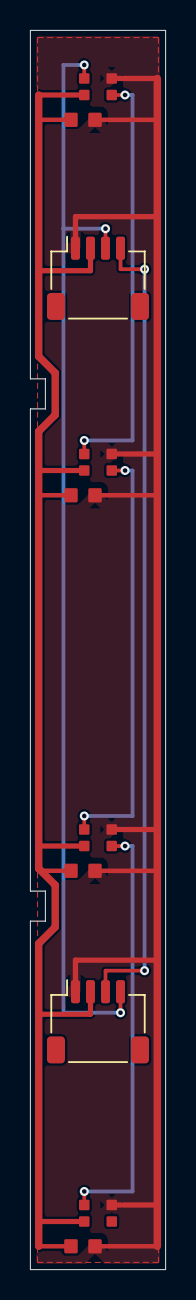
[picture p64: board fixture.kicad_pcb from above]

Board: 2 copper layers, 9.0 x 82.5 mm, 10 parts (0 on the bottom side), 7 nets.
