Takazudo/zudo-led-block/engineering/a5/electronics/native/power_adapter/power_adapter.kicad_pcb

## KiCad design engineering/a5/electronics/native/power_adapter/power_adapter.kicad_pcb (2026-11-06)

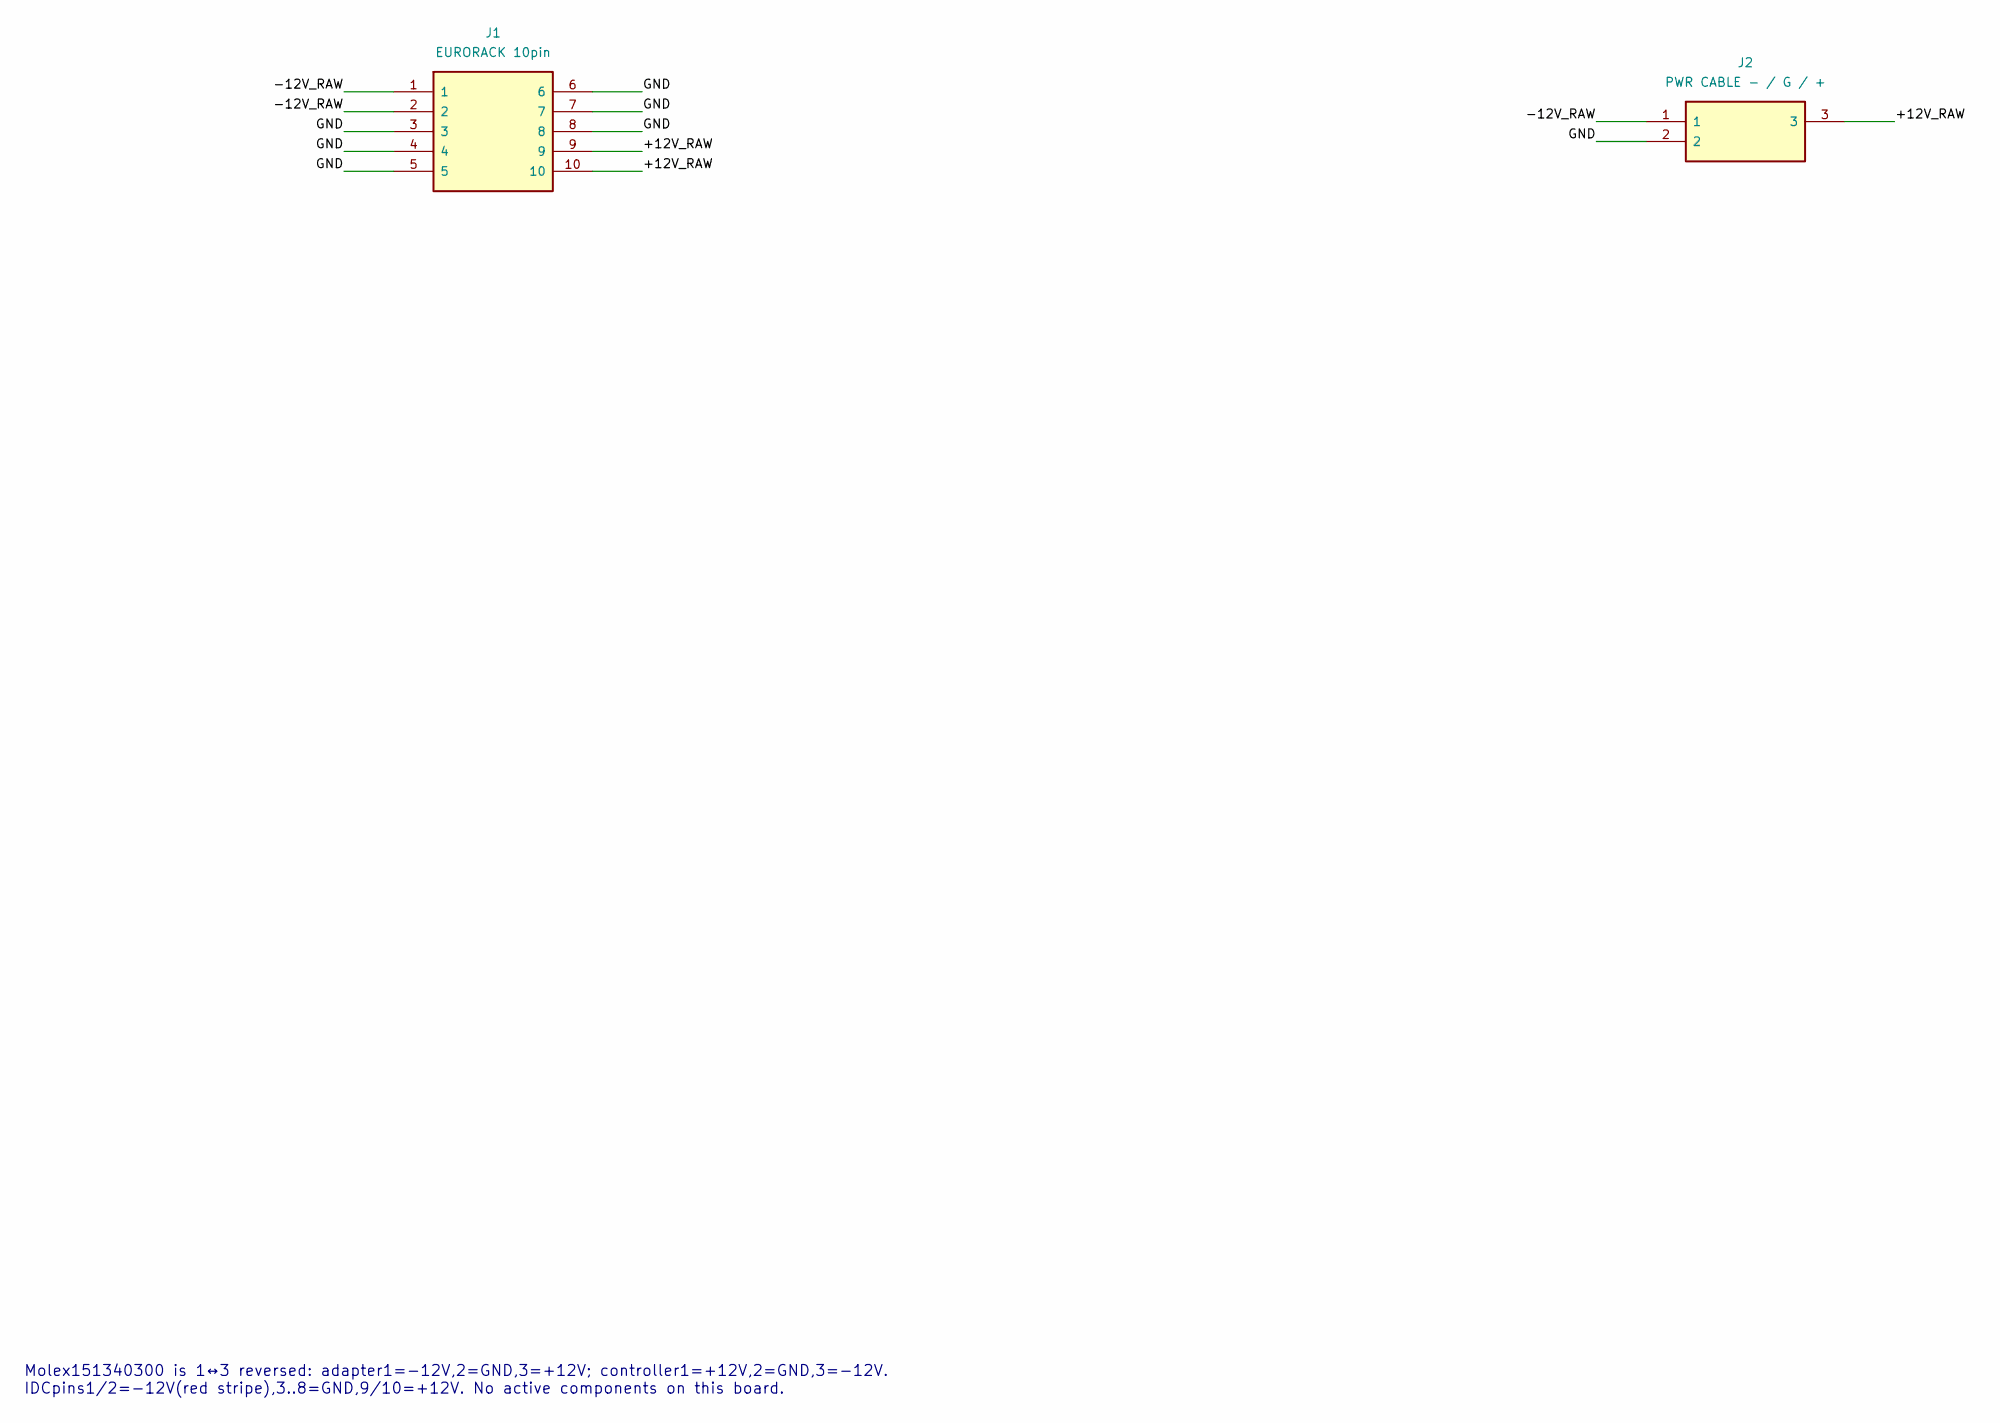
[picture p65: schematic power_adapter.kicad_sch, Light Block A5 passive power adapter]

Parts:
J1: EURORACK 10pin; IDC10; MPN 2.54-2*5P; LCSC C5665
J2: PWR CABLE - / G / +; PICO3; MPN 530470310; LCSC C122442

Connections:
+12V_RAW: J1.9, J1.10, J2.3
-12V_RAW: J1.1, J1.2, J2.1
GND: J1.3, J1.4, J1.5, J1.6, J1.7, J1.8, J2.2

Notes on the sheet:
Molex151340300 is 1↔3 reversed: adapter1=-12V,2=GND,3=+12V; controller1=+12V,2=GND,3=-12V. IDCpins1/2=-12V(red stripe),3..8=GND,9/10=+12V. No active components on this board.

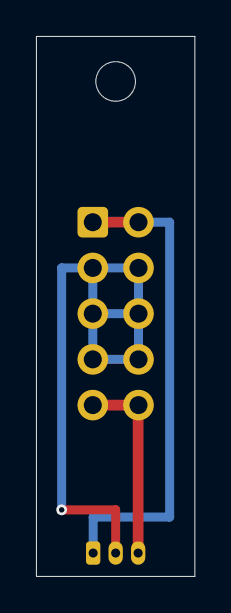
[picture p66: board power_adapter.kicad_pcb from above]

Board: 2 copper layers, 8.8 x 30.0 mm, 3 parts (0 on the bottom side), 3 nets.

Other parts of the board:
H1: M2 NPTH
