Takazudo/zudo-led-block/(commit log)

2026-11-06 Import Light Block A5 engineering checkpoint at engineering/a5 (T1)
    Byte-for-byte import of the 786-file A5 seed (83,093,114 bytes) from the
    verified light_block_A5_design_package.zip (SHA-256 94448c56...cf24).
    Five derived/historical paths are intentionally omitted and git-ignored;
    the original A5 manifest and reports are left unchanged as historical
    evidence. Adds provenance/ records and scripts/verify_seed.py.
    Refs #2
    Claude-Session: https://claude.ai/code/session_01JXThoNDTrHtJhb5s3kC6Dh
    [bottom_leaf_cap.step, bottom_leaf_cap.stl, controller.kicad_pcb, controller.kicad_sch, controller_lower_clamp.step, controller_lower_clamp.stl, controller_upper_clamp.step, controller_upper_clamp.stl]
2026-11-06 Add Japanese A5 documentation site and default-off Cloudflare config (T2, T4)
    Scaffolded with create-zudo-circuit-doc@0.2.0 (runtime
    @takazudo/zudo-circuit-doc@0.3.0, zudo-doc 9.1.3, ZFB 5.2.2, pnpm 11.5.2,
    Node 24) and integrated beside the immutable engineering/a5 import.
    - ja default locale, canonical https://zudo-led-block.zudolab.dev/, base /
    - authored pages: overview/status, electronics, mechanical, firmware,
    front artwork, verification/reproduction, decisions, next work, hosting
    - scripts/a5_site.py generates the 30-type / 81-piece BOM, status,
    historical-record and download pages plus publication/assets.json from
    the A5 ledger and native netlists; component-evidence catalog s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
2026-11-06 Add credential-free CI with default-off production deploy gate (T3, T4)
    Runs on every pull_request, push to main and workflow_dispatch with
    read-only permissions and SHA-pinned actions: A5 seed/data/record checks,
    firmware host tests incl. sanitizers, ARM build with the recorded
    arm-none-eabi-gcc 15:13.2.rel1-2 and make_release.py in a temporary copy,
    docs doctor/check/generate/build/check:site, drift checks, browser checks,
    and cf build + credential-free dry run. Production deploy runs only on
    Takazudo/zudo-led-block main push/dispatch when CLOUDFLARE_DEPLOY_ENABLED
    is exactly 'true' and all validation passed.
    Refs #4 #5
    Claude-Sessi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
2026-11-06 ci: make firmware release comparison real; harden deploy gate and browser checks
    - Run all steps with `shell: bash` (-eo pipefail) so piped commands fail.
    - Fix the firmware compare script's verification keys (memory.*); it
    previously raised KeyError behind `| tee`, so the HEX/BIN comparison
    never ran. Verified locally: HEX/BIN identical to recorded dist/.
    - Pin and assert binutils-arm-none-eabi alongside gcc-arm-none-eabi.
    - Deploy gate always reports, including SKIPPED when validation failed.
    - Hosting doc: note that org variables of the same name also apply.
    - Browser checks: 404 body, search results container, visible theme menu.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
2026-11-08 catalog: reconcile A5 fitted identities and scaffold 30 owner bundles (#9)
    E1: scripts/a5_catalog.py reconcile builds provenance/a5-catalog/reconciliation.json
    from the immutable A5 ledger, procurement rows, snapshots and native netlists:
    30 identities, 71 unique placements (59/10/2), 81 fitted pieces. C5665's two
    observed spellings are mapped by the reviewed identity crosswalk.
    E2 (first step): one owner bundle per fitted identity with distributor identity,
    historical A5 netlist pin maps and explicit OPEN/UNSOURCED/NEEDS BENCH gaps;
    inventory and direct routing for the 30 lines.
    Claude-Session: https://claude.ai/code/session_01JXThoN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
2026-11-08 catalog: TI IC primary evidence, catalog checks, BOM cross-links and browser checks (#9)
    - TLV75533PDBVR, TPS2552DBVR-1, SN74LVC2T45DCUR, OPA197IDBVR, TLV9001IDBVR:
    ti.com datasheets re-acquired (bytes identical to the A5-recorded hashes),
    per-page source locks and primary-source facts; identity/pinout/ratings COVERED.
    - Record IDs get a manufacturer prefix where the stem starts with a digit
    (route slugs must start with a letter).
    - scripts/a5_catalog.py: selection, sync-states and check subcommands;
    mutation tests in scripts/test_a5_catalog.py.
    - BOM rows link their catalog records through scripts/a5_site.py.
    - browser-check.mjs covers the catalog, all record pages and BOM correspon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
2026-11-08 catalog: AP63205WU-7 and WS2812B-2020-V6 primary evidence; STM32G031G8U6TR and SPM4020T-4R7M-LR sources unavailable (#9)
    Diodes DS41326 and the Worldsemi V1.4 datasheet (bytes identical to the
    A5-recorded hash) were re-acquired and inspected. st.com and product.tdk.com
    refused every request (empty reply / HTTP 403), so those sources keep the
    zero-hash sentinel and their facts stay UNSOURCED.
    Claude-Session: https://claude.ai/code/session_01JXThoNUkMhfNhXwoNg9rkX
2026-11-08 catalog: passive primary evidence (UNI-ROYAL, YAGEO, Fenghua, Samsung) (#9)
    Manufacturer-hosted series/per-part documents for the 13 resistors and MLCCs.
    MLCC DC-bias effective capacitance stays NEEDS BENCH (new OPEN domain).
    At integration review the orderable and nominal-resistance facts of the four
    E-24 values (8202, 6802, 3300, 4701) were downgraded to UNSOURCED: the series
    datasheet's Section 2.4.1 E-24 code rule contradicts those MPN codes.
    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
2026-11-08 catalog: restore cc0603 led_leaf netlist source dropped during evidence merge (#9)
    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
2026-11-08 catalog: manufacturer evidence for discretes and connectors; allow later-revision lines (#9)
    BAS70-04-7-F (Diodes DS11007 Rev. 27-2) and MMBT3904 (JSCJ Rev. 2.0) are read
    from manufacturer-hosted PDFs. PJ-3582-B and 1MS3T1B1M2QES-5 are available
    only as distributor-hosted mirrors, so their facts stay UNSOURCED. Nexperia,
    JST and Molex refused the requests and the C5665 drawing URL now returns HTML,
    so those sources are recorded as SOURCE UNAVAILABLE with zero hashes.
    a5_catalog.py check now accepts inventory lines of a later revision
    (line-a<N>-, owner component-a<N>-) beside the 30 A5 identities without
    relaxing the A5 reconciliation, so A7 evidence can join the catalog.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
2026-11-08 feat(native-gate): profile-driven native KiCad gate for A7 with routed fixtures (#18)
    Selectively port PR #14's native verification (runner, inner, evaluator and
    their guard tests, head 7e96380) into scripts/native_gate/ with provenance.
    The A6 paths and the "controller netlist must equal A5" identity condition are
    replaced by JSON gate profiles with generated input locks, behavioral interface
    assertions driven by reviewed role maps, and an authorized-delta check against
    a hash-pinned baseline netlist.
    - Infrastructure profile on genuinely routed fixtures: the A5 leaf routing plus
    one filled GND zone (built by make_fixture.py into an empty directory) and the
    A5 power adapter, with the i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
    [fixture.kicad_pcb, fixture.kicad_sch]
2026-11-08 A7 R1: PJ-324M / PCM13SMTR evidence and 2HP/3HP dimension study (#16)
    - engineering/a7/evidence: hashed source registry and v1-format staging bundles
    for SOFNG PJ-324M (C22355739) and C&K PCM13SMTR (C221842); kept out of the
    shared catalog until the #9 migration lands (registration.json prepared).
    - scripts/a7_stage_validate.py: runs the real catalog validator on a temporary
    copy with the A7 records applied; repository untouched.
    - engineering/a7/study + scripts/a7_dimension_study.py: parameterized transverse
    and axial stack with per-input confidence/source; 3HP feasible on paper,
    2HP unresolved (inferred axis height, assumed trim and hole tolerances),
    plain-mount thread engageme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
2026-11-08 fix(native-gate): address independent review findings on PR #22 (#18)
    - A named revision candidate must be the protected board, the delta and
    interface controller design, and the target of all mutation/synthetic
    controls, with the A5 expected-failure control present.
    - An empty regeneration check_command fails explicitly instead of crashing.
    - Harness composition no longer passes when missing nets compare None == None.
    - A git error in the A5 status check counts as not intact.
    - Role maps must be reviewed (status + review record) to pass.
    - The delta check compares every symbol field; added components must declare
    every pin's connection, checked against the candidate netlist.
    - Expecte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
2026-11-08 A7 R1: mirror reclassification, catalog registration, switch alternate search, CI step
    - Class the LCSC-hosted SOFNG and C&K documents as MANUFACTURER_MIRROR. Their facts
    are now UNVERIFIED / UNSOURCED with values retained, and coverage is OPEN with the
    blocking facts named. The maker-hosted attempts (sofng.com, C&K/Littelfuse) are
    recorded as SOURCE UNAVAILABLE.
    - Register the bundles as line-a7-pj-324m / line-a7-pcm13smtr under .claude/skills.
    a5_catalog check accepts them outside the A5 reconciliation. Generated record
    pages and the selection are refreshed. The temporary-copy validator and
    registration.json are removed.
    - Label the jack inputs taken from the mirror drawing as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
2026-11-08 A7 R1 study: fix best/worst corners and labelling found in review
    - The best corner now takes the favourable end of every range: hole position and
    float, panel width, trim protrusion (new ASSUMED 0.5 min). With trimmed terminals
    no 2HP row is infeasible within the stated ranges; untrimmed 2HP rows (except the
    0.9 mm offset) still fail even at the best corner.
    - Axial worst corner uses the thinner nut (engagement = min(usable, nut)). Worst,
    nominal and best engagement are now ordered.
    - The 6.1 mm far edge is DERIVED-MIRROR (calculated, not printed) with a 0.4 mm
    combined tolerance. Every tolerance states its own confidence; the rear-pocket
    tolerance is ASSUMED.
    - The Y layout and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
2026-11-08 A7 R4: controller schematic with PJ-324M jacks and PCM13SMTR side switch (schematic phase)
    - scripts/a7_electronics.py derives the A7 controller schematic from the immutable A5
    design data (read-only import) and changes only J1/J2 (SOFNG PJ-324M) and SW1
    (C&K PCM13SMTR). The schematic writer is a port of A5's; reproduce-a5 regenerates the
    A5 controller schematic byte-identically. A7-only footprints carry per-dimension
    MIRROR/ASSUMED/INFERRED tags in footprint_sources.json.
    - Authorized-delta record: component_replaced J1, J2, SW1 with reasons, issue refs and
    evidence status; PJ-324M pin functions stay INFERRED. review stays null, so the delta
    check fails on the missing review onl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
    [controller.kicad_sch]
2026-11-08 A7 R2: mechanical layout from the R1 study (candidates, stack, keep-outs) (#17)
    scripts/a7_mechanical_layout.py imports R1's transverse/axial calculation
    unchanged, sweeps 2HP offsets at 0.05 mm, selects candidates by a stated
    rule, solves break-even values for the inputs that decide 2HP, and derives
    the Z stack (rear optical volume Z 17.4-29.8 from the A5 optical stack,
    frontward controller volume to Z 16.4), Y layout (IN/THRU at 86.5/101.0,
    PCM13SMTR at the bottom edge), per-width X placement, controller keep-outs
    and finished-length cable routes. Pure Python with --check.
    2HP primary (offset 0.6, 0.8 mm FR-4, trimmed) is UNRESOLVED at the worst
    corner; 3HP centred 1.6 mm is FEASIBLE ON P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
2026-11-08 A7 R2: front artwork and CadQuery assembly with collision/optical checks (#17)
    Front: IN/THRU only; switch aperture, MODE, ON/PGM/CV legends and the A5
    Y65 hole removed; rear frost keeps the A4 finish and font; 0.5 mm rear jack
    pockets as a separate layer. Assembly per width (STEP, GLB, dimensioned
    front/transverse/side views) with pairwise rigid intersections, cable
    clearances, envelope checks, optical-obstruction of the A5 leaf corridors
    and setting-switch tool access in verification.json. Both widths: no
    unexpected rigid intersection, no retained envelope finding, no A7
    controller/support obstruction. Provisional digital study, not fit approval.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
    [front_A7_2hp_2mm.step, front_A7_2hp_CUT.dxf, front_A7_3hp_2mm.step, front_A7_3hp_CUT.dxf, rear_A7_2hp_REAR_FULL_FROST_CLEAR_LETTERS.dxf, rear_A7_3hp_REAR_FULL_FROST_CLEAR_LETTERS.dxf, zudo_led_block_A7_2hp_assembled.step, zudo_led_block_A7_3hp_assembled.step]
2026-11-08 A7 schematic check: run the container as the invoking user
    With --cap-drop ALL, root in the container lacks DAC_OVERRIDE and cannot write
    into a runner-owned output directory, so CI produced no reports. Use the host
    uid:gid like scripts/native_gate/runner.py, and include docker stderr when the
    native steps leave no exit codes.
    Claude-Session: https://claude.ai/code/session_01JXThoLNCto86WXaWd2VyFF
2026-11-08 A7 R2: 3HP working candidate as default, placement envelopes, CI job (#17)
    Claude-Session: https://claude.ai/code/session_01JXThoMEW4vA17r6dZvfAxQ
    [front_A7_2hp_2mm.step, front_A7_2hp_CUT.dxf, front_A7_3hp_2mm.step, front_A7_3hp_CUT.dxf, rear_A7_2hp_REAR_FULL_FROST_CLEAR_LETTERS.dxf, rear_A7_3hp_REAR_FULL_FROST_CLEAR_LETTERS.dxf, zudo_led_block_A7_2hp_assembled.step, zudo_led_block_A7_3hp_assembled.step]
2026-11-08 A7 R4: footprint and assertion fixes from the electrical review on #24
    - PCM13SMTR land pattern now follows C&K PC MOUNTING (I-48):
    - signal pads 0.7 x 1.5 at x -3.0/-1.5/+1.5/+3.0 (1.5/3.0/1.5 chain), 1.0 to 2.5 mm off the peg line;
    - retention pads 1.0 x 0.8 at x +/-5.15, y +/-0.965 (9.3 inner span, 1.13 gap);
    - courtyard covers the retention pads.
    - PJ-324M:
    - barrel projection 3.5 mm (3.2 was the terminal projection);
    - 5.4 mm edge on the pin-4/5 side, per the drawing;
    - oriented oval slots (1.6 x 0.8 drill), with 1 and 4 across the axis and 2, 3 and 5 along it;
    - holes stay ASSUMED (Q3).
    - Interface assertions:
    - unused() fails on a pin that is absent from the netlist;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
2026-11-08 A7 R2: R1 merge follow-up, corrected jack orientation, switch footprint gap, solder-face zone (#17)
    - Read jack/switch facts from the R1 owner bundles; Y clearances use the body
    tolerance envelope (near 5.4+/-0.2, far 6.1+/-0.4).
    - Pin 2 and the 6.1 mm edge face the switch (#24 review reading); jacks IN/THRU
    at Y84.3/99.3, pitch 15.0; switch body to J2 envelope 1.5 worst case.
    - Corrected PCM13SMTR footprint keep-out; full spine-slot engagement keep-out;
    jack lead keep-outs from pin positions plus fillet allowance; PicoBlade tails.
    - 0.6 mm solder-face low-profile zone for R4, modelled as a CAD envelope.
    Claude-Session: https://c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
    [front_A7_2hp_2mm.step, front_A7_2hp_CUT.dxf, front_A7_3hp_2mm.step, front_A7_3hp_CUT.dxf, rear_A7_2hp_REAR_FULL_FROST_CLEAR_LETTERS.dxf, rear_A7_3hp_REAR_FULL_FROST_CLEAR_LETTERS.dxf, zudo_led_block_A7_2hp_assembled.step, zudo_led_block_A7_3hp_assembled.step]
2026-11-08 A7 R4: record the independent electrical review of the schematic phase
    - authorized_delta.json and interface_roles/a7_controller.json carry the review (head 1a2f31a, PR #24 review 5818088400). Scope: connectivity and footprints for the schematic phase. Not a board approval. The open physical gates are listed in the record: PJ-324M pin functions by continuity test, across sign, holes Q3, axis height Q1, PCM13SMTR centring, stock Q10.
    - delta.py: a component_replaced entry whose ref shows neither a field nor a connectivity change is now stale, so it cannot silently exempt that part's pins. The A7 record no longer authorizes the A5 netlist.
    - Fresh pinned-image evidence: SCHEMATIC_REVIEWED. ERC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
2026-11-08 A7 R5: status, decision and blocker registers, continuation docs (#20)
    - docs: new project/a7 page (revision map, task status, BOM delta candidates,
    blocker register, outstanding physical qualification); next-actions rewritten
    for A7; decisions gain the A7 register and A6/A7 rows; project index,
    architecture and research index point to A7.
    - engineering/a7/docs/continuation: continue-here.md and evidence-index.md
    keeping A5 historical, A6 held, A7 digital and physical evidence apart.
    - browser check covers the A7 status, next-actions and decisions pages.
    Claude-Session: https://claude.ai/code/session_01JXThoMBrps6GPdufWjxc4j
2026-11-08 A7 R5: re-sync docs with the merged R4 schematic phase (#24)
    Schematic reviewed and on main; board still not placed or routed, gate
    NO_CANDIDATE. Updates status, next actions, decisions, continuation,
    evidence index and the a7 README ownership row.
    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
2026-11-08 A7 R2: address independent review findings (#17)
    - Optical check classifies parts by origin (A5 / A7); the A7 fork is its own
    part and A7 harness obstructions are reported with emitter distance.
    - Expected contacts carry volume limits; cable end entries are bounded; A5
    carry-over exemptions apply only to A5-A5 pairs.
    - Rear pockets sized across X for the INFERRED axis band and height tolerance.
    - CAD and front records hash their builder inputs; tests detect stale exports.
    - Power route reach vs the A5 cable and 2HP bend radius reported (R2-C5);
    LED harness squeeze past D2 recorded (R2-C6); SH4/PicoBlade header keep-outs;
    keep-out free area by exact union; nut preference compared with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
    [front_A7_2hp_2mm.step, front_A7_2hp_CUT.dxf, front_A7_3hp_2mm.step, front_A7_3hp_CUT.dxf, rear_A7_2hp_REAR_FULL_FROST_CLEAR_LETTERS.dxf, rear_A7_3hp_REAR_FULL_FROST_CLEAR_LETTERS.dxf, zudo_led_block_A7_2hp_assembled.step, zudo_led_block_A7_3hp_assembled.step]
2026-11-08 A7 R2: usable SH4 harness route and A7 power-cable length requirement (#17)
    R2-C6: the unchanged A5 power adapter moves 2.0 mm toward the PMMA, opening a
    2.4 mm gap to the leaf front edge. The controller-to-leaf SH4 harness steps
    down at the leaf plug mouth (R 2.5) into that gap instead of descending beside
    LED D2; a printed cap boss fills the gap at the Y20.5 screw. A ray-sampled
    shading estimate per LED is added to verification.json.
    R2-C5: the A7 power cable requirement is derived from the S-fold stowage range
    of both widths (56 +/- 3 mm free span, tolerance ASSUMED); the A5 50 +/- 6
    cable does not fit. No cable has been routed or measured.
    Takes R4's J3 move (Z centre 12.8) into the la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
    [front_A7_2hp_2mm.step, front_A7_2hp_CUT.dxf, front_A7_3hp_2mm.step, front_A7_3hp_CUT.dxf, rear_A7_2hp_REAR_FULL_FROST_CLEAR_LETTERS.dxf, rear_A7_3hp_REAR_FULL_FROST_CLEAR_LETTERS.dxf, zudo_led_block_A7_2hp_assembled.step, zudo_led_block_A7_3hp_assembled.step]
2026-11-08 A7 R2: review fixes for the moved adapter and harness route (#17)
    - Top-cap screw derived from the moved post nut: M2x18 keeps the A5 2.2 mm thread past the nut.
    - Controller PicoBlade z_centre 9.25 -> 8.6 so the SH4 fold clears the housing (~0.45 mm).
    - Moved adapter group, post nut and screw count as A7 in the checks; A5 reference-envelope
    overlaps bounded explicitly; boss to adapter PCB is a declared zero-volume contact.
    - Cap boss radius 2.75 (1.65 mm wall); layout asserts boss height equals -z_shift.
    - R2-C5 text and the A5 cable fit are generated with the same rule as the requirement.
    - README: shading figure labelled an estimate; unreproducible comparison removed.
    - Tests: step radi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
    [front_A7_2hp_2mm.step, front_A7_2hp_CUT.dxf, front_A7_3hp_2mm.step, front_A7_3hp_CUT.dxf, rear_A7_2hp_REAR_FULL_FROST_CLEAR_LETTERS.dxf, rear_A7_3hp_REAR_FULL_FROST_CLEAR_LETTERS.dxf, zudo_led_block_A7_2hp_assembled.step, zudo_led_block_A7_3hp_assembled.step]
2026-11-08 A7 R5: re-sync docs with the R2 mechanical model (#25) and harness reroute (#27)
    Status page gains the digital mechanical results (3HP working candidate,
    2HP open, jack pockets, adapter shift, 56 +/- 3 mm cable requirement with
    the tolerance ASSUMED); BOM delta, blockers, next actions, decisions,
    continuation and evidence index follow. Board still not on main.
    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
2026-11-08 A7 R5: apply review findings (cable 57.0 +/- 3.0 from generated layout, caveats, R4 state)
    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
2026-11-08 A7 R2: power-cable requirement text matches the generated 57 +/- 3 mm (#17, #8)
    The J5 move in #27 lengthened the shortest S-fold to 51.1 mm, so the
    generated requirement became 57 +/- 3 mm (54-60, tolerance ASSUMED). The
    README and the decision register still said 56 +/- 3. A test now checks
    both against layout.json.
    Related to #17 and #8.
    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
2026-11-08 A7 R5: cite layout.json power_cable_requirement; leave the cable decision row to PR #29
    R2 confirmed 57 +/- 3 (54-60, +/-3 ASSUMED) and fixes its README and the
    decision-register row in #29, so this PR keeps main's row to avoid a conflict.
    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
2026-11-08 A7 R4: controller placement against R2 envelopes, staging build and grid router (no board yet)
    - scripts/a7_board.py: placement packer/checker reading R2 keep-outs from
    placement-envelopes.json; build/apply staging board in the pinned KiCad image
    (4-layer, In1 GND plane), written only to an empty dir outside the repo.
    - scripts/a7_route.py: deterministic grid router with rip-up and reroute; output
    is a proposal the native DRC accepts or rejects. Routing is not complete.
    - J3 0.6 mm and J5 0.09 mm toward the front (edge clearance / MCU courtyard),
    agreed with R2; PJ-324M pin 1 pad 2.3 x 1.3 for 0.25 mm edge clearance.
    - route_break control skips zone nets (a pour bridges a removed GND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
2026-11-08 A7 R2: adopt R4's pre-routing placement (J5 at Z 8.69) and check it against the envelopes (#17, #19)
    - Vendor R4's agreed pre-routing placement (PR #30, head 0ce69b0) unchanged.
    - design-inputs: J5 z_centre 8.69 (body board_x 5.74-11.24).
    - New generated r4-placement-check.json: fixed parts J1/J2/J3/J5/SW1 match the
    envelopes, no part origin inside another part's keep-out, solder face holds
    only resistors and test pads. Courtyards, heights and copper not checked.
    - Rebuilt layout and CAD; power-cable requirement stays 57 +/- 3 mm (stowage 51.0-78.1).
    Pre-routing only; re-run on the routed export. Related to #17 and #19.
    Claude-Ses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
    [front_A7_2hp_2mm.step, front_A7_2hp_CUT.dxf, front_A7_3hp_2mm.step, front_A7_3hp_CUT.dxf, rear_A7_2hp_REAR_FULL_FROST_CLEAR_LETTERS.dxf, rear_A7_3hp_REAR_FULL_FROST_CLEAR_LETTERS.dxf, zudo_led_block_A7_2hp_assembled.step, zudo_led_block_A7_3hp_assembled.step]
2026-11-08 feat(a7): routed authoritative controller board with the full A7 gate
    Lands the authoritative A7 controller board together with the revision
    gate that names it as candidate (related to #19).
    - scripts/a7_route.py: negotiated-congestion (PathFinder) grid router on
    F/In2/B; seed 0 reproduces the committed routing byte-identically.
    - scripts/a7_board.py apply: settles zone fills with a reload and refill
    so the committed fill equals a fresh refill.
    - Design-rule delta: via 0.6/0.3 -> 0.5/0.2 mm, recorded in
    native_gate.json design_rule_delta with JLCPCB capability evidence
    (URL, retrieval hash, rows). All other A5 rules unchanged.
    - Gate: route_break control removes the longest signal s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
    [controller.kicad_pcb]
2026-11-08 A7 R2: re-run the placement check on R4's routed-board export (#17, #19)
    - Replace the pre-routing placement with R4's routed export (PR #30 head 493155e,
    authority.py export-placement, board SHA-256 b8cab9a6...), copied unchanged.
    - Check now also compares the board outline, both jacks' five pin pads, J5 pin 2,
    and every pad centre against foreign keep-outs. All pass; layout and CAD unchanged.
    - The export is a 1.6 mm board (3HP working candidate).
    Related to #17 and #19.
    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
2026-11-08 fix(a7): tighten buck and CV analog layout after independent review
    Addresses the layout review on PR #30 (related to #19).
    - Buck: C1 across U2 VIN/GND (1.7 mm), C4 across BST/SW under the IC,
    L1 SW pad directly below (BUCK_SW 1.1 mm, no vias), C2 at L1 +5V;
    U2.4, C1.2 and C2.2 each get two GND vias into In1.
    - CV analog: ADC-buffer island with D3 at U7.3 (CV_FILTER 2.4 mm),
    C17 at U7.5, C13/R7 at CV_AFFINE; the long run is U6's output.
    - MCU 100 n under VDD; LDO output cap at U3.5; Q1 moved to the corner.
    - Router: no signal vias under U1, CV_ADC kept out of U1's footprint,
    and a net that fails to route is retried instead of dropped.
    - Gate: route_break must report the removed net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
    [controller.kicad_pcb]
2026-11-08 A7 R2: re-run the placement check on R4's post-review board (#17, #19)
    R4 re-placed and re-routed after layout review (PR #30 head e2a2219,
    board SHA-256 ec810aec...). The copied export is replaced; every check
    still passes: outline, J1/J2 axes and pin pads, J3, J5, SW1 at delta 0.0,
    no origin or pad centre in a foreign keep-out, solder face R/TP only.
    layout.json and the CAD are unchanged.
    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
2026-11-08 docs(a7): record the reviewed, merged controller board in the engineering notes
    Related to #19. The electronics README, source authority and evidence
    index now state that the routed board passed independent layout and
    electrical review (PR #30, head e2a2219, merged as eb8adeb) and list
    the reviewer's non-blocking polish items beside the physical gates.
    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
2026-11-08 A7 R2: clear PET FPC leaf variant compared with the FR-4 leaf (#17)
    - design-inputs leaf_variants: JLC 1-layer transparent FPC 0.14 mm
    (MANUFACTURER_PRIMARY) on optically clear adhesive and a clear 0.8 mm PC
    carrier (thickness and moduli INFERRED); SH mating force UNSOURCED.
    - layout leaf_comparison: stack 1.28 vs 1.30 mm, fits the A5 cap slots,
    faces move 0.01 mm; 8-37x less stiff; worst-case buckling under the SH
    push ~8 N (FR-4 ~300 N); film alone ~0.07 N. Recommendation: FR-4 stays
    the default and fallback.
    - build --leaf pet: exports/3hp_pet assembly and verification; no
    intersections, corridors clear, harness 2.8 mm from D2, STEP round trip clean.
    - Tests for the comparison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
    [zudo_led_block_A7_2hp_assembled.step, zudo_led_block_A7_3hp_assembled.step, zudo_led_block_A7_3hp_pet_assembled.step]
2026-11-08 A7 R2: regenerate front artwork records for the new layout hash (#17)
    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
    [front_A7_2hp_2mm.step, front_A7_2hp_CUT.dxf, front_A7_3hp_2mm.step, front_A7_3hp_CUT.dxf, rear_A7_2hp_REAR_FULL_FROST_CLEAR_LETTERS.dxf, rear_A7_3hp_REAR_FULL_FROST_CLEAR_LETTERS.dxf]
2026-11-08 docs(a7): re-sync status and continuation for the routed, reviewed board
    - a7.mdx: routed controller board section (gate PASS, via 0.5/0.2 and
    through-hole 0.2 rule delta with JLC evidence, review outcome, four
    non-blocking polish items, R2 fit check, 1.6 mm = 3HP); in-progress
    note for board revision 2 and the PET FPC leaf evaluation (no results)
    - next-actions.mdx: ordered physical and owner gates (jack pin test,
    hole sizes, switch stock, jack axis height, 2HP decision)
    - decisions, project index, architecture: R4 board rows
    - continue-here.md, evidence-index.md: synced to main a9709b3
    - browser-check: new expectations
    Claude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
2026-11-08 A7 R4: enforce JLC PTH-to-track 0.35 mm and exact courtyard comparison in the gate
    The gate profile gains two stricter-only checks ahead of board revision 2.
    - design_rule_delta.custom_rules: a7_pth_to_track asks KiCad DRC for 0.35 mm
    (JLCPCB recommended, minimum 0.28) between a plated through-hole and another
    net's track, above the A5 hole clearance of 0.2 mm. scripts/a7_electronics.py
    writes controller/controller.kicad_dru from the same rule, and the runner
    fails if the file differs from the profile. The new rule_squeeze control
    adds one track 0.32 mm from J5.1's hole, clear of the pad copper and of the
    A5 rule, and requires KiCad to report it under this rule name. The gate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
2026-11-08 A7 R4: controller board revision 2 with the PR #30 re-review polish items
    The board is re-placed and re-routed (seed 0) under the stricter gate. The new
    board sha256 is 4453f818ede1e6d6c56e45ef43aa6faecb90990f3755f82c6d752258cd4d628e.
    - C11 at U6.5: U6 moves left between its rail caps. C12 is 1.63 mm from the
    -12 V pin and C11 is 1.53 mm from the +12 V pin, down from 5.8 mm.
    - GND vias at U7.2 and C17.2: the router stitches them within 0.9 mm
    (GND_VIA_NEAR). They land at 0.52 and 0.66 mm, down from 1.5-2 mm.
    a7_board.py keeps the solder face under those sites free of resistors.
    - +5 V at U4.1: C15 (10 uF) moves from the jack strip to just above U4.1 IN,
    1.8 mm away. The nearest cap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
    [controller.kicad_pcb]
2026-11-08 A7 R2: re-run the placement check on R4's board revision 2 (PR #37, eb5d833)
    Board 4453f818; outline, fixed parts and keep-outs all pass. Related to #17 and #19.
    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
2026-11-08 A7 R4: check in CI that the seed-0 route reproduces and the board carries it
    scripts/a7_route_check.py runs fresh in an empty directory outside the repo:
    - builds the staging board from the committed placement and netlist in the
    pinned KiCad image;
    - reruns a7_route.py --seed 0 and requires a byte-identical
    routing/route_proposal_seed0.json;
    - requires the committed board's tracks and vias to equal the proposal
    exactly, as multisets in KiCad nanometres. The conversion goes through
    pcbnew.FromMM, as apply did.
    numpy is pinned by version and wheel hash (scripts/requirements-router.txt).
    Python 3.12 with that wheel reproduces the recorded route byte for byte, and
    so does the local 3.13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
2026-11-08 docs(a7-mech): record that board revision 2 merged in PR #37 (edf98c2)
    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
2026-11-08 A7 R4: the rule_squeeze control must find its rule name and pad in the native report
    Follow-up to the PR #37 re-review. The evaluator no longer relies only on
    matching the failure text. drc.json must contain a hole_clearance violation
    whose description names every rule in must_report ("rule 'a7_pth_to_track'")
    and whose items include the squeezed pad ("pad 1 ... of J5"). The check is a
    unit-tested helper, rule_squeeze_reported. The locks are refreshed for the
    changed runner.
    Related to #19.
    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
2026-11-08 A7 route check: fail empty or failed routes, keep summary as evidence, drop .gbrjob from the review aid
    Follow-up to the #39 infrastructure review (related to #19):
    - fail when the recorded proposal has router failures or either side has no tracks or vias
    - fail explicitly when the in-image copper export wrote no copper_nm.json
    - add a7-route-check/summary.json to the native-infrastructure-evidence artifact
    - remove the Gerber job file from the review aid so it cannot be imported for ordering in one step
    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
2026-11-08 A7 R4: electrical profile and interface check for the bonded PET LED leaf
    Item 5 (related to #19), scoped to R2's bonded variant from #35: PET film on OCA
    and a 0.8 mm clear PC carrier, FR-4 kept as the default leaf.
    - engineering/a7/verification/pet_leaf/profile.json: stack, 1- and 2-layer film
    variants, JLC flex design rules with a hashed source, TPS2552 worst-case current
    bound, interface requirements, expected verdicts and open questions
    - scripts/a7_pet_leaf_check.py: reviewed-role interface assertions for controller J3,
    both SH4 harnesses and the leaf; R2's PET export; A5 leaf copper probed and
    DRC-checked in the pinned KiCad image on a copy, with a control proving the
    added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
2026-11-08 docs(a7): sync status for board revision 2, router CI check and the PET leaf comparison
    - a7.mdx: board revision history (rev 1 ec810aec / eb8adeb, rev 2
    4453f818 / edf98c2), PTH-to-track 0.35 mm rule, rev 2 reviews and
    main CI runs, router seed-0 reproducibility in CI (#39, review aid is
    not a release output), R2 rev 2 fit check (#38), FR-4 vs PET leaf
    comparison (#35) and Q11a-Q11c; in-progress note for PR #40 and the
    PET leaf electrical profile (preliminary, no results)
    - next-actions, decisions, project index: matching rows
    - continue-here.md, evidence-index.md: synced to main 8bd064b
    Cla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
2026-11-08 A7 R4 docs: board revision 2 was re-reviewed on PR #37 and merged as edf98c2
    Text-only status updates in the electronics README, interface_review.md and
    source_authority.json; no file here is under a gate lock.
    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
2026-11-08 A7 R4: fold in the #42 review notes (citation fix, PTH ring row, coverlay-to-trace fact)
    - cite PR #37 review 5818812844 (head ae5aa3c) as the approval; 6724516695 was a status note
    - Q11e and the profile: JLC's PTH annular ring row (>= 0.18 mm absolute) would fail the
    A5 0.15 mm via ring if it applies to vias
    - profile: coverlay opening to trace 0.15 mm (pad to track >= 0.25 mm) is met at 0.30 mm
    minimum, measured by native DRC; recorded, not a verdict
    Text and profile only; no board change.
    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
2026-11-08 docs(a7): final sync for route-check hardening and the PET leaf electrical check
    - a7.mdx: route-check hardening (#40, 4b00448) and its main run on
    355999a; PET leaf electrical profile and check (#42, 355999a) with its
    PASS / NOT_MET verdicts and voltage-drop upper bound; conclusion now
    names Q11d-Q11f; Q11d-Q11f blocker rows (PET variant only, Q11e / Q11f
    questions not yet drafted); in-progress section removed
    - next-actions: planned digital work complete; remaining items are
    physical, supplier and owner gates; known intermittent check-browser
    failure noted for the owner
    - decisions, project index: matching rows
    - continue-here.md, evidence-index.md: synced to main 355999a as th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
2026-11-09 fix: bind A7 mechanical placement to authoritative board identity
2026-11-09 feat(a7): add revision-bound order preparation and evidence
    [carrier-study.step, population.csv]
2026-11-09 test(a7): recognize recovered primary switch evidence
2026-11-09 docs(a7): hand off pinned local KiCad verification
2026-11-11 fix(a7): fold in PR #44 review findings and current integration state
    - readiness: one retained receipt can no longer stand in for several
    approval roles or for raw evidence of two procedures
    - fixture: bind carrier-study.step bytes in the manifest so a stale or
    edited STEP fails --check
    - fixture/native evidence wording: replace E1-only/uncommitted/Forbidden
    current-state text with run 42596523199 and the 2026-11-11 artifact
    observation (historical receipts kept)
    - continuation docs: record the 2026-11-11 integration, merge/deploy
    reconciliation and current artifact hashes; regenerate
    fixture -> procurement -> readiness
    - PCM13SMTR bundle: fix run-together tokens; regenerate cat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
2026-11-11 fix(a7): key receipt-role separation on resolved file and bytes
    Re-review found that '..' spellings or byte-identical copies evaded the
    role check. Key on the resolved path and the content hash, treat a
    non-list raw_evidence as BLOCKED instead of INVALID, and let --cad
    recreate a missing STEP. Regenerate fixture -> procurement -> readiness.
    Claude-Session: https://claude.ai/code/session_01JXThoNkAZNgAb5uT7tJf62
2026-11-11 ci(a7): retain validated A7 native candidate evidence; gate deploy on a7-mechanical
    - native-infrastructure-evidence keeps a narrow A7 candidate allowlist:
    a7-gate/plan.json and evidence/a7_controller/board_{facts,geometry}.json
    beside the existing summary
    - scripts/a7_native_artifact.py classifies a staged set or downloaded ZIP
    (VALID_PASS / VALID_FAILURE_EVIDENCE / INCOMPLETE / REJECTED) against
    summary hashes, authoritative PCB, pinned image, revision, run and
    attempt; CI writes its record into native-receipt/
    - runner records github_run_attempt and plan_sha256; native locks
    regenerated with the existing producer
    - deploy-gate and production-deploy now need a7-mechanical
    - 13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
2026-11-11 feat(a7): export and consume fixture-specific native geometry
    - inner.py writes fixture_geometry.json (schema a7-fixture-geometry/1) from
    the same staged board bytes: pad shape/size/rotation/layers/attribute/drill,
    fp-relative offsets, courtyard and footprint boxes where available,
    explicit units/origin/axes/rotation/back-side conventions; unreadable
    fields are null and listed, body height is never asserted
    - the A7 profile retains it; CI uploads it; the artifact validator requires it
    - scripts/a7_fixture_geometry.py accepts it only from a VALID_PASS artifact,
    proves pad = origin + R(rotation) * fp_relative, face/copper agreement and
    agreement with the canonical placement, and wr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
2026-11-11 fix(a7): record pad copper boxes and board-enabled layers in fixture geometry
    CUSTOM pads report only their anchor size, so each pad now carries its
    copper bounding box; PTH pads list only copper layers enabled on the board.
    The consumer requires a box that contains the pad and rejects nonexistent
    copper layers. Native locks regenerated.
    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
2026-11-11 feat(a7): record validated native fixture geometry and bind probe pads to it
    - engineering/a7/fixture/native-geometry.json from the VALID_PASS artifact of
    run 43077448786 (head 01bc381, ZIP db6d6fe1...74c4): 64 footprints, 0 unknown
    extents, checked against the canonical placement
    - a7_fixture.py confirms TP1-TP5 (B side, round 1 mm, B.Cu/B.Mask, position,
    net) against the record; fresh_native_verified and digital_fixture_complete
    stay false (no heights/solder envelopes, extents not yet used for clearance)
    - CI checks the record for staleness/tampering; fixture and readiness
    regenerated; docs updated
    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
2026-11-11 fix(a7): tighten native fixture geometry checks after review
    - pad count per footprint must match the PCB text; non-custom pad boxes must
    agree with pad size at orthogonal rotations; attribute must be known;
    courtyard/outline boxes must be well-formed; malformed types are rejected
    instead of crashing; record image/KiCad version must match the profile
    - tolerance 1 um (board text is 4-decimal); docstring and README state what
    --check can and cannot prove (re-signed edits need --from-zip and review)
    - fixture manifest records the tested revision for push runs too
    Claude-Session: https://claude.ai/code/session_01JXThoNkAZNgAb5uT7t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
2026-11-11 A7 ledger: native mount sides, netlist-derived cable pin maps, classified blockers
    The procurement ledger now takes SMD/THT and side from native pad
    attributes (controller: native-geometry.json bound to the authoritative
    PCB; leaf/adapter: immutable A5 placement data), derives the power and
    SH4 cable pin maps from the netlists instead of hardcoded text, counts
    unique fitted identities, and classifies each preparation blocker.
    Claude-Session: https://claude.ai/code/session_01JXThoNmVgHVffBQeMiQ9Ld
    [population.csv]
2026-11-11 feat(a7): derive B-side carrier relief and support from native geometry
    - scripts/a7_fixture_relief.py: 0603 pockets from native pad copper boxes
    united with the UNI-ROYAL SMD-SP-001 V.11 maximum body outline (H 0.45±0.10,
    SOURCE_DERIVED), depth 0.80 mm; THT through-reliefs from native pad copper
    boxes; unclassified B-side or through-hole parts are rejected
    - probe-bore to relief webs computed: six pairs (TP1-5 vs R7/R9) below the
    0.5 mm study minimum are reported as blockers
    - support land fraction computed geometrically; no load-path claim
    - J5 PicoBlade tail and all fillet heights stay unknown; fresh_native_verified
    and digital_fixture_complete stay false
    - STEP regenerated wit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
    [carrier-study.step]
2026-11-11 fix(a7): report thin relief walls and unchecked overhang after review
    - relief-to-relief and relief-to-carrier-edge walls under the 0.5 mm study
    minimum are listed and become a manifest blocker
    - F-side pads with B.Cu copper that are not PTH/NPTH are rejected
    - F-side courtyards over the carrier overhang are listed as not checked
    - README: restore the limits heading, R12 edge sliver, accurate wording of
    the volume check; tests for clearance, R12, NPTH/B.Cu, DNP, rotation, walls
    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
2026-11-11 catalog: recover PMEG4010CEJ, JST SH and SOFNG PJ-324M primary sources; WS2812B V1.0 timing history (#9)
    Acquired 2026-11-11 as ordinary page loads in the owner's built-in browser
    (SHA-256 computed in-page over the response bytes; bytes not committed):
    - Nexperia PMEG4010CEJ v.3 (2022-10-01) 378861b9...: manufacturer,
    pinout, VR/IF/IFSM/Tj, VF and IR max now primary PASS. v.3 removed packing
    information, so the ,115 orderable stays UNSOURCED (identity OPEN).
    - JST eSH.pdf ea3071ca... (same bytes as A5): manufacturer, SM04B-SRSS-TB
    side-entry row with the (LF)(SN) label note, 1.0 A / 50 V / -25..+85 C.
    Per-circuit numbering is not printed, so pinout stays OPEN.
    - SOFNG-hosted PJ-324M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
2026-11-11 A7 readiness: executable procedures with source-traced acceptance, classified gates, owner checklist
    Each of the 19 procedures gets inputs, tools, preconditions, steps, a
    per-evidence-kind record template and acceptance values. Every value is
    checked against its source (component fact, JSON pointer or quoted text)
    and its confidence must match the source (MIRROR facts cannot be
    promoted; values a record marks ASSUMED or INFERRED keep that label).
    Unsourced pass values stay UNRESOLVED with who decides them.
    readiness.json now groups blockers into gates classed CLOUD_DIGITAL /
    OWNER_DECISION / ACCESS_EVIDENCE_HOLD / PHYSICAL_ONLY. The generator
    also writes per-procedure run templates and the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
2026-11-11 test(a7): pin the recovered SOFNG-hosted PJ-324M source and VERIFIED identity
    The R1 evidence tests pinned the 11-08 state (SOFNG site SOURCE UNAVAILABLE,
    PJ-324M identity UNRESOLVED). Pin the recovered state instead: AVAILABLE
    manufacturer-primary with its observed sha256, mirror-backed facts still
    barred from PASS by the unchanged mirror test.
    Claude-Session: https://claude.ai/code/session_01JXThoPq4kyv7KMauK1WsiZ
2026-11-11 Regenerate fixture, procurement and readiness after merging main (#47)
    The fixture manifest binds procurement/population.csv, which gained the
    mount column on this branch; regenerated in order fixture, procurement,
    readiness. No content change beyond input hashes.
    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
2026-11-11 fix(catalog): publish the SOFNG PNG as a source record; tighten extracts; date stale A7 notes
    Independent review findings on the W2 evidence:
    - WORKFLOW publication policy reserves datasheet/specification/drawing for a
    reviewed PDF; a reviewed non-PDF manufacturer source is now selected as
    `source-record` (is_reviewed_pdf stays PDF-only).
    - PMEG manufacturer/junction-temperature and PJ-324M manufacturer facts now
    cite text that is quoted in their source extracts; the PJ-324M pinout
    reason states the symbol reading as a visual interpretation.
    - A7 open questions, evidence index, project/decisions pages and the PET
    leaf profile's open list no longer state that SOFNG/JST sources are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
2026-11-11 Readiness review fixes: restrict sources, enforce stated confidence, add bounds
    From independent review of the W3 change:
    - Acceptance sources are component facts (fact_id only) and design
    records; the plan and generated outputs cannot be cited.
    - Any confidence a JSON record states beside a value is enforced via an
    explicit vocabulary, and a quoted line's ASSUMED/INFERRED marker too.
    - Quoted values must be whole tokens; every sourced value has a bound.
    - Power cable band 54-60 mm is ASSUMED; jack thread-engagement step now
    matches the rear-pocket design value; ts-sleeve is a testable
    requirement; axis-to-far-edge is UNVERIFIED (calculated).
    - cv-thru-calibration is an owner decisio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
2026-11-11 Derive A7 pass criteria and add traced proposals for owner review
    - readiness: CALCULATED values carry a derivation that is recomputed at
    generation from traced inputs (component facts, A7 netlist component
    values, firmware constants); confidence follows the weakest input.
    - PROPOSED values carry a rationale and their traced basis; a criterion
    with PROPOSED or UNRESOLVED items stays blocked even when reviewed.
    - power-current, startup-reset and u7-stress criteria are derived; their
    remaining step is an acceptance review (reclassified to owner decision).
    - 21 proposals for the nine owner-decision procedures; evidence-hold
    criteria state the document or measurement that supplies them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
2026-11-11 Complete the A7 carrier digital design: sourced 0.27 mm wall, through-cuts, datums, keying, clamp points
    The minimum FR-4 wall is now derived from the INGUN receptacle and probe data (1.27 mm grid minus the 1.00 mm
    maximum mounting hole). Every relief is a through-cut, thin walls are merged with bridges or opened to the carrier
    edge, and the carrier gains three datum pins, turned-pose keying, F-side clamp points over land, a registration
    allocation closed by acceptance measurements and a stroke/travel-stop definition. The flags remain false: the J5
    tail is unsourced and the hold-down mechanism, base and assembly check are not designed.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
    [carrier-study.step]
2026-11-11 Record JLCCNC FR4 guidance as a not-selected candidate reference and compare the carrier with it
    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
    [carrier-study.step]
2026-11-11 Harden derivation checks and correct criteria after independent review
    - Bind each derivation input to a labelled phrase of its source (context)
    or to the netlist value/tolerance word; c_literal only for C sources.
    - Every input must be used and must move the result; no operation on
    literals alone; bounded powers; arithmetic errors become ValueError.
    - Keys are validated per confidence; a reviewed criterion binds to a
    digest of its acceptance list, so later edits re-block the gate.
    - Reviewed criteria name who accepted them (owner or the project
    coordinator under the owner's delegated working style).
    - U7 R7-current bound now uses the full CV_AFFINE network (0.313 mA) and
    stays a p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
2026-11-11 Record coordinator acceptance of six A7 criteria and close review holes
    - Six procedures (power-current, startup-reset, cv-thru-calibration,
    rail-collapse, load-short, cv-noise) are accepted by the project
    coordinator under the owner's delegated working style, recorded in
    qualification/reviews/ and kept distinct from owner acceptance.
    - The review record must name each procedure's acceptance digest; any
    later edit re-blocks the gate. Quotes may not cut a word short;
    expressions are length-capped.
    - jack-continuity, thermal-optical and the U7 current bound stay
    PROPOSED (not confirmed by independent review / unsourced lowest
    temperature / inferred CV_BUF bound); T1L conflict sho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
2026-11-11 Split jack-continuity into mapping thresholds and a contact-resistance proposal
    Contact quality uses the 50 mOhm (grade B) initial contact resistance on
    the SOFNG-hosted PJ-324M drawing, quoted from the unaudited source
    extract and therefore UNVERIFIED; the 200 kOhm / 20 MOhm values are kept
    only as terminal-mapping thresholds.
    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
2026-11-11 Fix review findings: bridge thin fingers inside merged openings, surround the probe load with the clamp points
    The wall check now covers every pair of cuts closer than 0.27 mm whose material is not already removed, so the
    0.175 mm fingers between R24/R25 and R6/R7 are bridged; diagonal pairs are joined along a full edge. An independent
    raster test confirms no material thinner than the minimum. Clamp points must enclose the probe resultant with a
    0.5 mm margin and are checked exactly against cuts and bores. Keying ignores features over bores and pin holes.
    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
    [carrier-study.step]
2026-11-11 Accept the split jack-continuity criteria and add the milliohm method
    The procedure now measures each closed contact by 4-wire (or 2-wire
    with shorted-lead subtraction) at 50 mA or less; the coordinator
    accepted the split after independent review confirmed it.
    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
2026-11-11 Add temperature, contact-resistance and CV_BUF-bound evidence (W7)
    - Operating and storage temperature facts for TPS2552, SN74LVC2T45, OPA197,
    TLV9001, TLV755P, AP63205, three Samsung X5R MLCCs, WS2812B-2020, SPM4020T,
    STM32G031, SM04B, BAS70 and PJ-324M, from hash-checked primary pages.
    - PJ-324M initial contact resistance (30 / 50 mOhm max, A / B grade) and
    storage temperature from the SOFNG-hosted drawing.
    - OPA197 output swing from rail; CV_BUF bound and D3/U7 split survey; the
    +/-20 V figure stays a design assumption.
    - TLV755P: TI now serves new bytes (same SBVS320D); recorded as a second
    observation. INGUN GKS-050 probe sheet re-exported; old hash kept as history.
    - Regenera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
2026-11-11 feat(a7-fixture): split probe plate and windowed support carrier, add assembly interference check
    Probe plate holds the INGUN receptacles in solid FR-4; the support carrier carries
    the board on lands with merged rounded windows (1.0 mm walls, R = H/10 + 0.5 from the
    captured JLCCNC guidance, not a selection). Screw-down spring pressure plate with
    nylon contacts over the probe field; base plate, stack hardware and wiring space.
    New a7_fixture_assembly builds the full assembly in CadQuery 2.7.0 and records
    pairwise interferences, critical clearances and designed contacts; the manifest
    binds that record and the STEP bytes for criterion 4.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
    [carrier-study.step]
2026-11-11 chore(a7-fixture): regenerate fixture, procurement and readiness outputs for W8
    Assembly STEP, interference record and plan drawing replace the carrier-only study;
    materials list the plates and hardware as requirements; sources record the probe
    re-download and the GKS-050 catalogue mirror; README, blocker register and evidence
    index describe the new architecture. Criteria 2-4 met digitally; criterion 1 waits on
    the J5 tail source, criterion 5 is physical; both flags stay false.
    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
    [fixture-assembly.step]
2026-11-11 fix(a7-fixture): address review: corner flakes, raster blind spot, model-input binding
    - Fill sharp window corners that a neighbour's rounded corner does not cover (three
    ~0.1 mm flakes at R5, R16); bridge dedupe stops degenerate diagonal loops.
    - Raster test now examines material points at an opening edge, so sub-grid flakes are
    seen; a test proves it finds the flakes when corner filling is disabled.
    - Interference record binds the design, the assembly code, the native record and the
    CadQuery version; criterion 4 goes stale when any changes.
    - Contacts on a window edge count toward the bending load (12.7 N, 0.062 mm).
    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
    [fixture-assembly.step]
2026-11-12 Record the Molex 530470310 tail length from the sales drawing
    The owner-downloaded 530470000-SD rev B bytes equal the recorded hash;
    SECTION X-X gives the terminal tail 2.3 +/-0.5 mm below the housing
    seating plane.
    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
2026-11-12 feat(a7-readiness): owner decisions and evidence downloads on the order checklist (W10)
    - readiness: artifact:fixture stays gated on digital_fixture_complete but
    is PHYSICAL_ONLY once criteria 1-4 are met and only criterion 5 is left
    - procurement: assembly:fixture-materials is derived from the fixture
    manifest; CLOUD_DIGITAL until digital_criteria_1_to_4_met and
    hardware_proposal_complete are true, then OWNER_DECISION
    - plan.json: owner_decisions (question, options, consequence of each,
    sourced recommendation, ordered by what blocks the PCB order first)
    and evidence_requests (route, document, value needed, URL, fallback)
    for every current OWNER_DECISION and ACCESS_EVIDENCE_HOLD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
2026-11-12 Add Samsung DC-bias curves, TLV755P reverse-current statement and WS2812B storage temperature (W11b)
    - Typical DC-bias capacitance change for CL10A475, CL21A106 and CL31A226 from
    the Samsung product-page chart data (labelled typical, design reference only);
    the bench-level effective-capacitance facts stay NEEDS BENCH.
    - TLV755P section 7.1.4: no allowed reverse current is specified; every reverse
    condition exceeds the absolute maximum VOUT > VIN + 0.3 V.
    - WS2812B-2020 V1.4 storage temperature: whole reel -40..+70 C, bulk -40..+105 C.
    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
2026-11-12 fix(a7-readiness): address W10 review of the owner decisions
    - thermal-optical: options say whether the current 85 degC proposal is
    kept or changed to 75 degC, so the owner's pick matches the record
    - firmware-waveforms: recommend measuring the purchased lot; the record
    leaves open whether the V1.4 T1L row is a datasheet error, and a FW fix
    would need a new A7 firmware tree (A5 firmware is immutable)
    - switch-supply cites the ledger condition, not the unsent question text
    - order-quantity and finished-cables consequences no longer overstate
    what is known (JLC MOQ 3, supplier tolerance unconfirmed)
    - validator rejects non-string gates/recommendations and URLs with
    characters that wo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
2026-11-12 Fix W11b review findings: TLV755P note and 6.0 V bound, Samsung page volatility, A5/A7 wording, WS2812B Tstg locator
    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
2026-11-12 feat(a7-fixture): consume the J5 tail fact, size a stock spring, record a sourced hardware proposal
    - J5 uses fact-530470310-tail-length (2.3 +/-0.5 mm below the seating plane). Through-hole
    leads are checked at their full sourced length (J5 2.8 mm, J1/J2 3.4 mm), a bound for any
    board thickness, so the unsourced board tolerance does not enter; both end inside the 5 mm
    carrier windows. Worst case on the nominal board stays recorded (J5 1.2 mm).
    - Guide standoffs 12 -> 20 mm: no stock spring fits the 12 mm envelope. The spring
    requirement gains a 10 N per-spring maximum; Lee Spring LCM065E07M is checked against it at
    worst case (6.49-9.85 N over 12.6-13.2 mm).
    - Board bending uses t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
2026-11-12 chore(a7-fixture): regenerate fixture, procurement and readiness outputs for the J5 follow-up
    Assembly STEP and interference record (135 solids, 0 interferences), manifest with the hardware
    proposal, sources for every proposed part, materials descriptions for the 20 mm guide, M3x8
    base screws and 2x16 dowels; README, blocker register and evidence index describe the change.
    Criterion 1 is met, so fresh_native_verified and digital_criteria_1_to_4_met are true;
    digital_fixture_complete stays false on the physical criterion 5.
    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
    [fixture-assembly.step]
2026-11-12 A7 fixture: check the hold-down at its worst cases
    The independent review found that the clamp statics and board bending
    were only shown at equal spring forces and the nominal board thickness.
    - Statics now cover every spring-force pair in [6.35, 10] N per spring.
    The strong-G1/weak-G2 corner moves the resultant 0.10 mm outside the
    contact triangle (C2 lifts, board net load point leaves the land).
    - Bending is checked at the minimum 1.44 mm board (1.6 +/-10 %, a
    PROJECT-CHOICE order requirement): 0.133 mm against the 0.1 mm limit.
    The sourced FR-4 moduli are labelled comparisons, not a bound.
    - The installed-length envelope stacks board, contact setting, plate
    thickness and stando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
    [fixture-assembly.step]
2026-11-12 Reclassify ldo-reverse as an owner decision and effective-capacitance as cloud review now that the evidence is recorded
    ldo-reverse: cites fact-tlv75533pdbvr-reverse-current (no allowed reverse
    current specified) and adds an owner decision on whether bench tests may
    back-feed +3V3. effective-capacitance: cites the three typical DC-bias
    curves; the required minimum is left to a cloud circuit review. The two
    evidence requests are removed. Gates stay 50 (ACCESS_EVIDENCE_HOLD 14,
    OWNER_DECISION 13, CLOUD_DIGITAL 3, PHYSICAL_ONLY 20); order stays BLOCKED.
    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
2026-11-12 Address plan review: honest ldo-reverse options, decision-gated steps, TPS2552 in the capacitance review
    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
2026-11-12 feat(a7-fixture): displacement-controlled hold-down on hard stops
    Replace the spring-balanced pressure plate with a rigid 6 mm FR-4 plate
    screwed down onto two 6 mm M3 hex standoffs (hard stops), with two KIPP
    K0318.04 POM-pin spring plungers on the free F face. Each plunger force
    is set by stop height, board thickness and plunger setting, so no case
    depends on matched springs.
    Every worst case passes: plunger force extremes (+/-20 % band on the
    catalogue line), boards 1.44 and 1.76 mm, stop and setting tolerances
    and plate deflection. Total 15.87-34.88 N (required 12.7 N), board net
    load point 1.93 mm inside the land hull in all 8 cases, deflection
    0.057 mm at 1.44 mm (limit 0.1). Bending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
    [fixture-assembly.step]
2026-11-12 fix(a7-fixture): address hold-down review findings
    - Measure M4 tapped-hole webs at the 4.0 mm thread, not the drill; the
    plungers move to (14.1, 21.7) and (14.2, 16.5), 5.2 mm apart, and the
    pressure plate grows to y 13.5.
    - Grow the J5 notch so its milled R1.1 corners keep 0.5 mm off the
    courtyard (assembly clearance now 0.50 mm).
    - Take the board sag under the plungers off the minimum compression.
    - Bending spans stop at the board edge; a chord ending at a free edge
    is a cantilever (16^(1/3) x length). board_span is tested directly.
    - Stop joint: 0.3 N m tightening, required screw tension from the
    plunger moment about the stop-face edge (88 N) against the preload
    (about 1000 N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
    [fixture-assembly.step]
2026-11-12 feat(a7): base the order on the owner's 2-unit first build and JLC-first sourcing (W12)
    Record the owner's answer to the order-quantity decision (2 units) and the
    owner's sourcing preference in engineering/a7/procurement/owner-decisions.json,
    with the owner's own words. The 2-board PCBA minimum stays OWNER_REPORTED.
    The procurement ledger gains an order plan for 2 modules: boards needed,
    per-line pieces, PCM13SMTR 2 required / pre-order minimum 3 / buy 3, attrition
    NOT_SOURCED, and a JLC-first route per line. The 2026-11-12 JLC listing for
    C221842 is recorded in supply-observations.json. The order-quantity blocker is
    removed, the switch-supply decision offers JLC pre-order / Global Sourcing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
2026-11-12 fix(a7): keep owner words, our reading and inferred listing fields apart (W12 review)
    - Order-quantity keeps the pre-answer recommendation (1) as history; option 2 is
    labelled as the owner-reported, unconfirmed PCBA minimum.
    - Owner decisions carry the chat message ids and times; the 3-route sourcing
    order is our reading, PENDING_OWNER_CONFIRMATION.
    - Switch recommendation: obtain via JLC (pre-order, else Global Sourcing),
    noting presale 0 may mean no pre-order now; listing field meanings INFERRED;
    price tiers have no currency.
    - Answers must quote one of the entry's owner words and may only name a
    retired gate; SOURCED needs url, time and hash; the checklist renderer uses
    the va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
2026-11-12 Record the unverified Worldsemi statement on #13 and offer it in the T1L decision (W13)
    The forwarded ws2812b-2020-v6-1.0.pdf and a fresh download are byte-identical
    to the recorded V1.4, so no printed value changes. The issue #13 comment
    (T0H and bit period as the compatibility criteria, T1L not a pass/fail limit)
    is recorded verbatim with its body hash as an unverified maker statement and
    offered as a fourth option, needing written confirmation through an official
    channel. Also corrects the stale storage-temperature note on the WS2812B
    operating-temperature fact.
    Claude-Session: https://claude.ai/code/session_01JXThoPq4kyv7KMauK1WsiZ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
2026-11-12 Review effective capacitance against AP63205, TLV755P and TPS2552 requirements (W14)
    Records the capacitor requirements of the three devices as facts, derives
    per-rail effective-capacitance estimates from the typical Samsung DC-bias
    points with tolerance and X5R temperature derating (CALCULATED, not
    guaranteed), and makes criterion:effective-capacitance an owner decision:
    the AP63205 input (C1, ~1.8 uF typical at 12 V) is far below its 10 uF table
    value while the other rails have margin. No PCB change.
    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
2026-11-12 Address W14 review: table value may be nominal, 100 nF parts excluded as conservative, VLED has no minimum, measure C1 at the real rail
    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
2026-11-12 Add a same-footprint C1 substitution option to the effective-capacitance decision (W15)
    Records an option study for C1 (AP63205 input): Samsung DC-bias data and JLC
    stock for 0805 candidates, AP63205 input RMS-current guidance, other
    +12V_PROT capacitance, height, and what a substitution would reopen (C1's
    LCSC property lives in the frozen PCB file). Adds CL21A106KBYQNNE as an owner
    option; the recommendation stays bench measurement. No BOM change.
    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
2026-11-12 feat(a7): JLCPCB order-package dry run for the 2-unit first build (W16)
    scripts/a7_jlc_package.py reads the frozen controller, LED leaf and power
    adapter boards (never writes them) and the procurement ledger, and generates
    JLC-format BOM and CPL dry-run files, a package report and the owner page
    project/jlc-order-package. `export` runs the pinned KiCad image outside the
    repository for Gerber, drill and position files, zips them per board and
    checks the CPL against KiCad's own position export (all three match).
    JLC pages read on 2026-11-12 (capability tables, BOM/CPL format, 30 part
    pages) are recorded with retrieval time and hash in jlc-package/sources.json.
    The 2-board PCBA minimum is now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
    [controller_BOM_DRYRUN.csv, led_leaf_BOM_DRYRUN.csv, power_adapter_BOM_DRYRUN.csv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]
2026-11-12 fix(ci): wait for Chrome's page target in the browser smoke
    @takazudo/zudo-circuit-doc 0.3.0 reads /json/list once, as soon as the
    DevTools endpoint answers, and fails with "Chrome page target was not
    available" when Chrome has not yet registered its about:blank page.
    Locally the first successful /json/list is empty in 4 of 15 launches
    and the unpatched launchChrome fails 5 of 40 times; the page target
    appears on the next poll.
    A pnpm patch polls /json/list until a page target with a debugger URL
    appears, bounded at 10 s, and the expiry error names the last response.
    The smoke checks themselves are unchanged. Patched: 60 of 60 launches.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
2026-11-12 fix(a7): address W16 review of the JLC order-package dry run
    - Record each part's PCBA type and assembly type from the 2026-11-12 JLC part
    pages in sources.json and tier boards from them, not from the A5 audit.
    - Evaluate the Economic package, pin-spacing and quantity limits too, and list
    the criteria evaluated (panel size is not: no panel exists).
    - New blocker: the PCBA "pcs" unit once panelised is not sourced. Reword the
    minimum-size blockers to "panel or rails; not sourced which".
    - Drop unsourced claims (Standard finish, Extended fee); cite FR-4 from
    layout.json; leaf 0.6 mm thickness becomes a note, not a blocker.
    - Quote guard runs only for a SOURCED minimum and refuses an emp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
2026-11-12 feat(a7): settle each board's JLC assembly route (single boards vs Panel by JLCPCB)
    - Record JLC's panel-ordering and panelization help pages (2026-11-12) and
    the capability table's delivery-format row in sources.json.
    - Per board, evaluate every Economic single-board constraint, then route to
    Panel by JLCPCB with the X x Y that reaches the panel minimum before rails.
    Controller: Standard + JLC panel with rails. Leaf: Standard + JLC panel if JLC
    accepts its notched outline. Adapter: Economic + JLC panel if mouse bites are
    offered. A repo-built panel only where JLC declines.
    - Size and fiducial blockers become per-board panel items; JLC adds fiducials
    to the rails. The PCBA-quanti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
2026-11-12 feat(a7): compare JLC panels with a minimum-count repo panel per board
    - For a 2-panel PCBA minimum (if the quantity counts panels, not sourced),
    Panel by JLCPCB assembles 20 controllers, 16 leaves and 4 adapters and needs
    20 PCM13SMTR (JLC stock 0); a repo panel of 1 controller, 2 leaves or
    1 adapter assembles exactly 2 modules. Part totals for both routes are in
    package.json and on the owner page.
    - Evaluate the repo panel against JLC's customer-panel rules (5 mm rails,
    1 mm fiducials, 2 mm tooling holes, >= 2 mm spacing, >= 5 mm mouse-bite tabs,
    panel minimum and 250 mm limit), clear courtyards that pass the outline
    (controller J1/J2 4.45 mm), and note JLC's carrier for 0.6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
2026-11-12 Prepare repo-built JLC assembly panels for the three boards (W18)
    Generated from the frozen board files without modifying them. Each panel build checks board identity, outline, drills, panel DRC and CPL against KiCad. Prepared route only, not released; the panel-route decision stays with the owner.
    Refs #65
    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
    [controller-panel_BOM_DRYRUN.csv, led_leaf-panel_BOM_DRYRUN.csv, power_adapter-panel_BOM_DRYRUN.csv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]
2026-11-12 Strengthen the repo-panel checks after independent review (W18)
    Read the saved panel back for the outline and feature checks, include drill slots, compare per-layer pads, zone fills, drawing and footprint graphics, require suffixed nets on further copies, compare panel DRC counts both ways with the waived count pinned in the receipt, refuse boards with net-name based classes or rules, and add negative controls. The page and README no longer overstate the checks and label proposed values.
    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
2026-11-12 Record the owner's prototype-route approval (1 OK, 2026-11-12)
    Records owner_prototype_route in qualification/records.json with an approval receipt quoting the owner's words and the question, bound to the current identities. Only the prototype route is recorded; the panel route and switch supply are not. The prototype-and-release blocker text no longer claims no route exists. Not a manufacturing release; the order gate stays BLOCKED.
    Refs #10
    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
2026-11-12 Address review of the prototype-route record
    Panel-route blocker now says the repo panels are prepared; cross-references and the decision register note the owner's approval; the receipt states that no tester or pre-test conditions are set by it. Record re-bound to the regenerated identities.
    Refs #70
    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
2026-11-12 Record the Molex PicoBlade ratings from the owner's download batch
    The owner sent ten files. Seven are byte-identical to sources already
    recorded and change no value. The Molex 510211110-PS rev A product
    specification covers 53047**10 and gives 125 V, 1.0 A per circuit
    (AWG 26-30), -40 to +85 C ambient and 30 mating cycles; those become
    the 530470310 ratings, temperature and durability facts, and the
    durability is a reference row in service-envelope. The STM32 files are
    a text extraction, not the PDF, so no STM32 fact is added. Evidence
    requests now say what each gate still needs.
    Claude-Session: https://claude.ai/code/session_01JXThoP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
2026-11-12 Correct the W19 batch count and rating wording after review
    Five batch files, not seven, are byte-identical to recorded sources (the
    Molex sales drawing came in an earlier upload; the PJ-324M image matches
    visually, not by hash). The PicoBlade rating keeps the printed "rated
    current (max.)" by wire gauge, is classed as recommended operation, and
    notes that per-circuit is an interpretation. The exact-part evidence
    request now lists the supplier-answer and measurement routes its text
    names. The STM32 ADC note quotes the FT_a condition.
    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
2026-11-12 Source the PMEG ,115 packing and the STM32 limits; partial-rails to owner decision
    Nexperia SOD323F_115 Rev. 3.0 gives ,115 as the SOD323F 7-inch reel
    (180 x 8 mm, SPQ 3000). The STM32 datasheet reached the project only as a
    text conversion of DS12992 Rev 4; it is recorded as such, with the hash
    identifying the text, and supplies the VDD and FT input maxima, the
    injected-current limits and operating VDD. partial-rails traces those
    values instead of its UNRESOLVED limits row and becomes an owner decision
    on adopting the part absolute maxima as its pass/fail line. The
    assembly-manifest gap text is left as is because regenerating it would
    change the hash the prototype-route approval is bound to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
2026-11-12 Tighten the W19 second-batch evidence after review
    PMEG: the packing sheet's first page has no printed page number, and SPQ
    3000 is the package figure that the sheet says depends on product type,
    so it moves from the fact value into its conditions; SKILL.md no longer
    calls ,115 unsourced. STM32: add Table 21 notes 1-2, Table 19 note 1 and
    the FT_e diode exception (Table 52) to the fact conditions. partial-rails:
    the owner question names the 4 V limit on the ADC CV input (PA0, FT_a),
    and the missing-criterion text says where sequencing went. The disclosure
    lists the generated files that still carry the stale PMEG sentence.
    Claude-Sessio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
2026-11-12 Record the owner's answers: own panels, JLC questions, jack waiver, accept all
    - panel-route: repo panels, one Gerber per board type, PCBA quantity 2 (owner's
    thread message and card tap).
    - O12 (JLC questions) closed by owner statement; not a JLC reply, and the
    package says so.
    - PJ-324M pre-order tip test waived by the owner with the risk stated; the
    check stays as a first-article check on the assembled boards.
    - "5 accept all": finished cables retired; harness-depth, u7-stress,
    service-envelope and ldo-reverse criteria accepted by the owner with a review
    record; thermal 75 degC, LED timing, input capacitance, case, fixture
    fabricator and release recorded as accepted plans with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
2026-11-12 Address review: reopened switch, digest-bound criterion answers, stale jack and O12 text
    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
2026-11-12 Record the owner's partial-rails answer: maker's maximum is the line
    The owner chose "Yes, maker's maximum is the line" on its own decision card
    (asked separately because it arose after "accept all"). partial-rails is
    REVIEWED by the OWNER with its own review record; every value was already a
    SOURCED absolute maximum. A criterion may now be answered by its own owner
    entry as well as by accept-all, and a quote is unwrapped only when it is
    wrapped in one pair of double quotes. Prototype route re-bound.
    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
2026-11-12 feat(a7): fit the in-stock hanxia HX MSK13C02 as SW1 on the existing land
    - new owner bundle component-a7-hx-msk13c02 (Hanxia drawing served by JLC, mirror authority)
    - scripts/a7_switch_fit.py compares the routed land with the Hanxia land and leads
    - schematic and board part fields, verification delta, schematic evidence, gate lock, placement export
    - mechanical model centres the 2.7 mm body on the routed pegs; 0.05 mm actuator overhang recorded and accepted
    - CAD and front-panel exports rebuilt from the changed layout
    Refs #77
    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
    [controller.kicad_pcb, controller.kicad_sch, front_A7_2hp_2mm.step, front_A7_2hp_CUT.dxf, front_A7_3hp_2mm.step, front_A7_3hp_CUT.dxf, rear_A7_2hp_REAR_FULL_FROST_CLEAR_LETTERS.dxf, rear_A7_3hp_REAR_FULL_FROST_CLEAR_LETTERS.dxf]
2026-11-12 feat(a7): record the owner's switch decision, +70 C switch limit and price audit
    - owner-decisions: switch-supply answered by the owner's own direction (a
    working, low-price, in-stock switch); HX MSK13C02 chosen under it
    - procurement: C5149819 supply observation (JLC stock 4561), switch-supply
    retired, ledger texts updated; JLC package records the C5149819 part page
    - qualification: switch-fit procedure on HX values; thermal-optical judges SW1
    at +70 C (lowest part limit) and keeps the owner's 75 C for other parts;
    switch-life reference row re-sourced (value unchanged) with the review
    digest updated and the change written into the owner review record
    - owner prototype-route approv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
    [controller-panel_BOM_DRYRUN.csv, controller_BOM_DRYRUN.csv, fixture-assembly.step, population.csv]
2026-11-12 fix(a7): address review of the SW1 change
    - land terminal numbering marked as inferred from the supplier CAD (the
    Hanxia drawing does not number the land); switch-land-fit records it and
    switch-fit checks the orientation first on the assembled boards
    - a7_switch_fit refuses a footprint whose pads it did not read
    - owner-decisions: the owner's message kept whole; consequences are
    recorded as the coordinator's, not as owner-accepted
    - review record and design-inputs no longer say the owner chose the part or
    the overhang; switch-life row notes the drop from SOURCED to MIRROR
    - prototype-route question says the earlier "1 OK" and why it is asked again
    - switch-fit evidence request names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
2026-11-13 A7: record the owner's prototype-route re-approval for the HX switch version
    The owner chose "Yes, approve this version" on the decision card
    (2026-11-13T02:38:51Z). The SW1 change had altered the identities the
    2026-11-12 "1 OK" was bound to; the route is re-bound to the current
    identities with a new approval record. Not an order or a release.
    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
2026-11-13 A7: add JLC order files for the 2-unit test prototype (2026-11-13)
    Repo-panel Gerber+drill zip, BOM and CPL per board type (controller,
    led_leaf, power_adapter), built from main db0ca95 with the pinned KiCad
    10.0.8 image. Panel build and single-board export both PASS. README lists
    uploads and order settings. No order placed; not a manufacturing release.
    Claude-Session: https://claude.ai/code/session_01JXThoMezUL2Dm8YNBQMRk9
    [controller-panel_BOM_DRYRUN.csv, led_leaf-panel_BOM_DRYRUN.csv, power_adapter-panel_BOM_DRYRUN.csv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]
2026-11-13 A7: project dated sourcing observations for all 30 fitted identities (#80)
    order_plan() marked 29 of 30 fitted identities NOT_OBSERVED although dated
    2026-11-12 JLC page receipts and the price audit cover all of them. Build a
    separate sourcing projection from the authored evidence (page receipts,
    parts-API audit, supply receipts) with exact identity matching, per-source
    times and hashes, inferred meanings/currency/buy quantities kept as INFERRED,
    explicit gaps, and the retired PCM13SMTR excluded from the active population.
    The manifest's order lines, population rows and supply blocker now point to it.
    The assembly manifest digest changes (c12c964a -> ea30c8a7), so readiness now
    shows the ow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
2026-11-13 A7: reconcile pre-order preparation and continuation docs (#20)
    Current-state statements now match the integrated HX design and the prepared
    dated exports: stage-by-stage lifecycle (digital done, route approval and its
    binding, dated panel exports, order-form review, no order, first article and
    release), HX board 89310d53 with older boards labelled history, fixture
    criteria 1-4 met with only the fabricator open, the PJ-324M pre-order waiver,
    the upload lifecycle (reference sets vs the dated copy), PR #67's bounded
    Chrome startup patch, and closed #17/#19. The JLC package page and panel export
    note come from their producers. Dated records are annotated, not rewritten.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
2026-11-13 A7: readiness tests and route recommendation follow the #80 manifest binding hold
    The owner's prototype-route approval is bound to assembly-manifest c12c964a;
    #80 changed it to ea30c8a7 (sourcing fields only). The two readiness tests that
    asserted the gate was cleared now assert the hold, that only the
    assembly_manifest identity is stale, and that re-binding to the current
    identities would clear it (as PR #78 did for the switch change). The route
    recommendation text names the real reason. The approval record is unchanged.
    Claude-Session: https://claude.ai/code/session_01JXThoPzscmbdHWZHDVfdYQ
2026-11-13 A7: address independent review of the sourcing projection and docs
    - recompute each audit row's pieces_to_buy and line_cost from its stated
    cost_rule (new negative test); drop the unused order_plan parameter
    - describe the page receipts and API audit as separate reads, not 'later'
    - name every manifest field the #80 fix changed; record the new digest
    557d5e48 (the c12c964a approval binding hold is unchanged)
    - cite CI run 43294571723 as a board-gate step PASS in a run that failed later
    - separate hosting #11 from the agent-page decision #12
    - group the new projection tests after the ledger tests
    Claude-Session: https://claude.ai/co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
2026-11-13 A7: record the owner's prototype-route re-approval after the #80 manifest change
    The owner replied "approve" (2026-11-13T19:44:23Z) to the question asking to
    re-approve the prototype route for the assembly manifest #80 changed
    (c12c964a -> 557d5e48, sourcing fields only). A new approval record binds the
    current identities; the 2026-11-12 and PR #79 records stay as history.
    Readiness no longer shows owner_prototype_route (OWNER_DECISION 8 -> 7); the
    order gate stays BLOCKED. Not an order or a manufacturing release.
    Refs #15
    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
2026-11-14 Index datasheets kept in the private circuit-dev-resources repo (#83)
    Datasheet-like resources now live in Takazudo/circuit-dev-resources.
    provenance/private-resources.json records each stored file's path,
    SHA-256 and citing records; a unit test (run in CI) checks the hashes are
    still cited, no indexed bytes are committed here, and the A5 capture copy
    matches the immutable engineering/a5 tree. CLAUDE.md, AGENTS.md and the
    WORKFLOW retention table state the rule.
    Claude-Session: https://claude.ai/code/session_01JXThoPNg1tFzHTrVDEZhF4
